LudemannEngineering/Formula-1000-Race-Car/Drawings/Jigs/ChassisJig.JPG

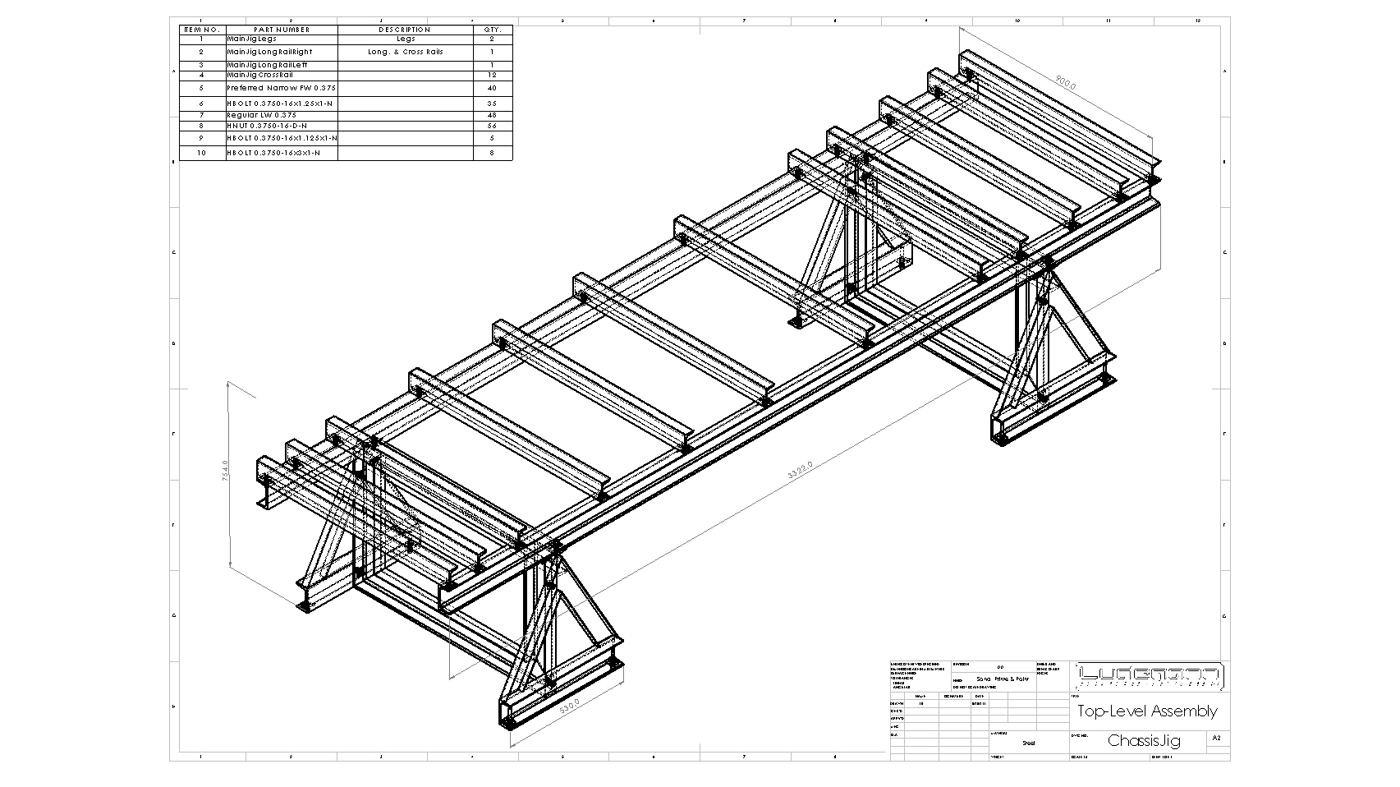
Drawings/Jigs/ChassisJig.JPG
