LudemannEngineering/Formula-1000-Race-Car/Drawings/Jigs/ChassisJigA.jpg

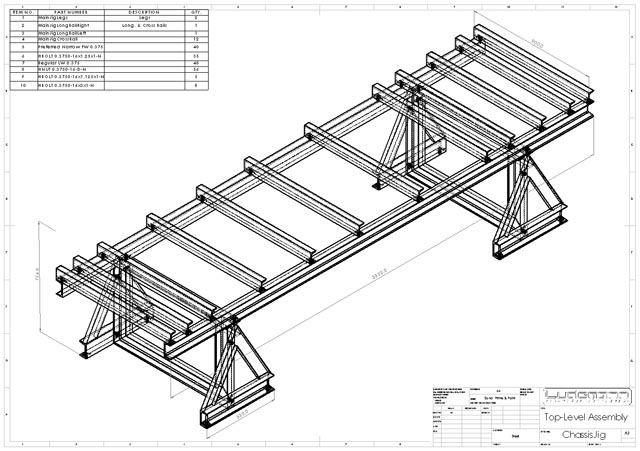
Drawings/Jigs/ChassisJigA.jpg
