LudemannEngineering/Formula-1000-Race-Car/Drawings/overall-dimensions-1.jpg

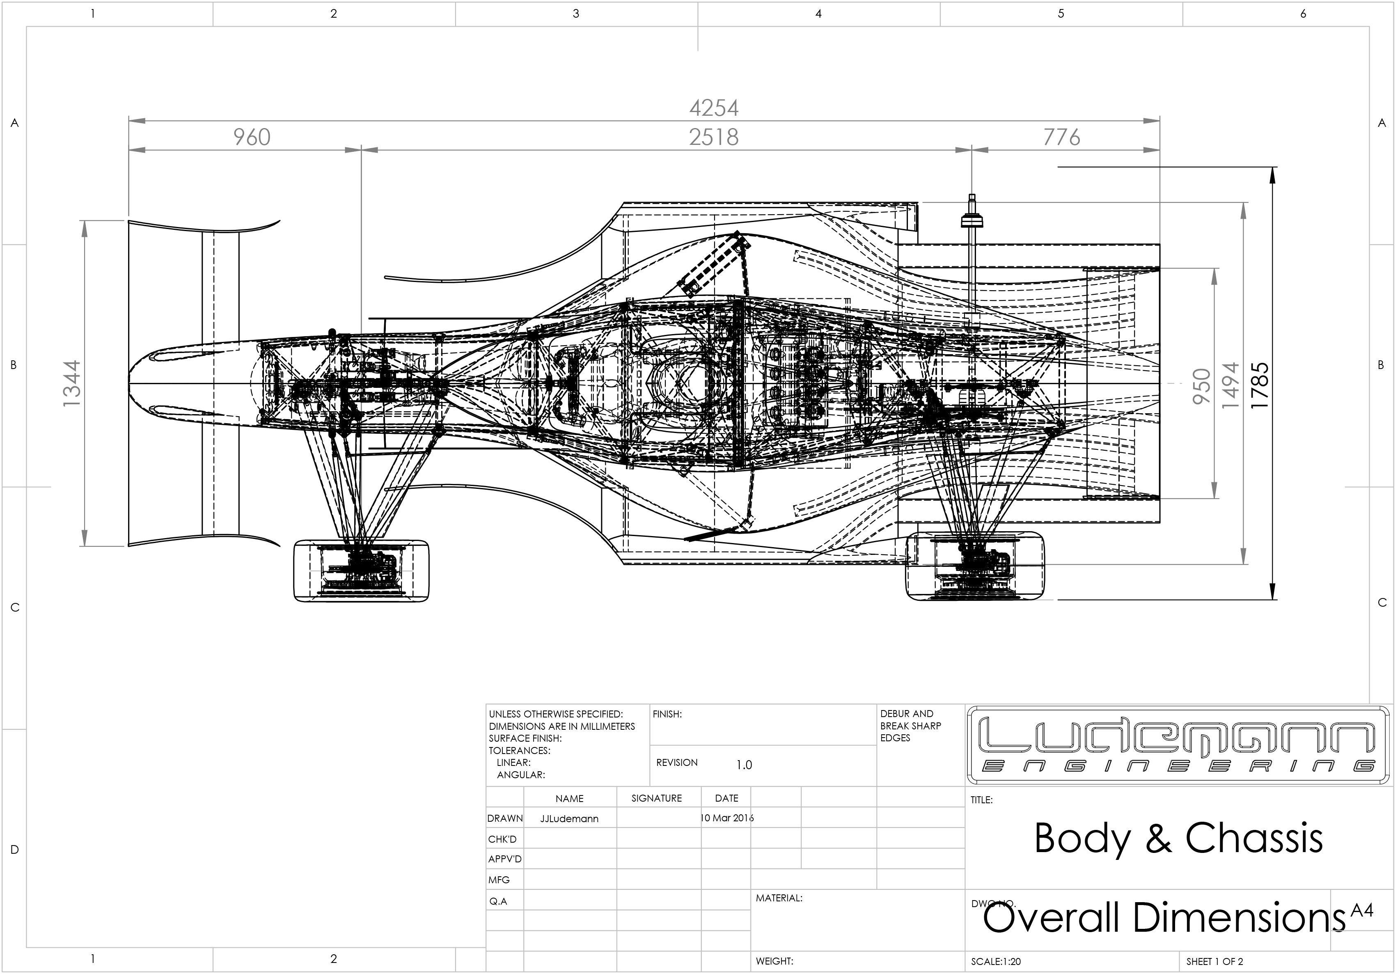
Drawings/overall-dimensions-1.jpg
