LudemannEngineering/Formula-1000-Race-Car/Drawings/Jigs/ChassisJig.xlsx

 |  | Qty | Length | Total
100 x 50 x 6
 | Legs
 |  | 4 | 0.53 | 2.12
 |  | 4 | 0.9 | 3.6
 |  | 4 | 0.56 | 2.24
 | Long Rails
 |  | 2 | 3.322 | 6.644
Total |  |  |  | 14.604
75 x 25 x 6
 | Legs
 |  | 8 | 0.53 | 4.24
 | Cross Rails
 |  | 12 | 0.9 | 10.8
 |  |  |  | 15.04
