LudemannEngineering/Formula-1000-Race-Car/Solidworks/Trailer/TubesRequired.xlsx

 |  | Qty. | Length | Subtotal |  | Units
50 x 100 x 3
Main Longitudinal |  | 4 | 454 | 1816
Main Cross |  | 4 | 195 | 780
Yoke |  | 2 | 211 | 422
Axle Supports |  | 4 | 18 | 72
Misc |  | 1 | 36 | 36
TOTAL |  |  |  |  | 3126 | 6
36 x 36 x 1.6
Front Storage | Vert | 4 | 130 | 520
 | Horiz Z | 4 | 194 | 776
 | Horiz X | 4 | 57 | 228
Under Storage | Vert | 12 | 18 | 216
 | Horiz Z | 2 | 115 | 230
 | Horiz X | 4 | 450 | 1800
Tread Support |  | 8 | 30 | 240
TOTAL |  |  |  |  | 4010 | 7
50 x 2.5 Round |  | 1 | 120 |  | 120 | 1
75 x 50 x 3
Ramps | X | 4 | 430 | 1720
 | Z | 4 | 18 | 72
 |  |  |  |  | 1792 | 4
Diamondplate | Qty. | Length | Width | Area, cm2 | Area, 4x8
Trailer Treads | 2 | 454 | 40 | 36320 | 1.221703832
Ramp Treads | 2 | 430 | 28 | 24080 | 0.8099842589
 |  |  |  |  |  | 2.031688091
19 x 1.2 Round |  |  |  |  |  | 2
