LudemannEngineering/Formula-1000-Race-Car/Solidworks/Driver/right_hand.SLDASM

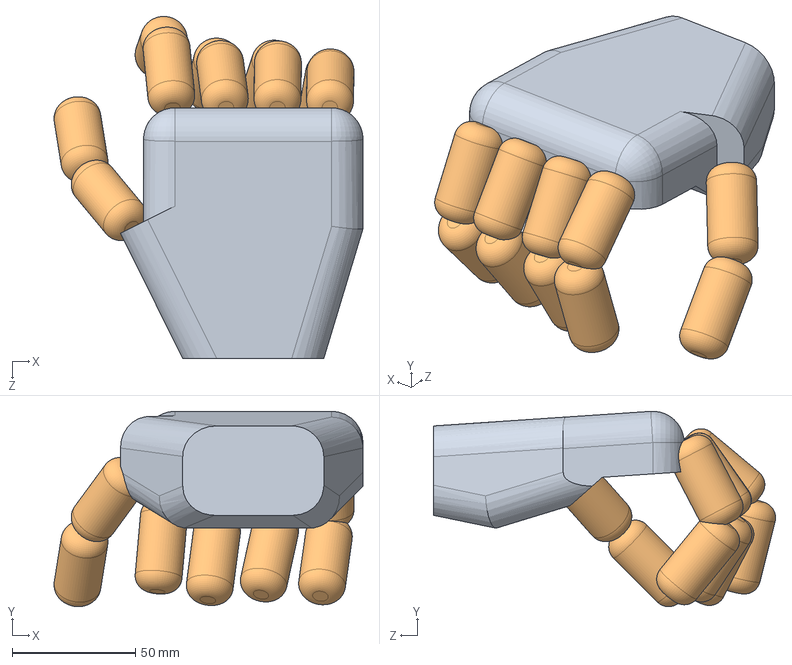
[picture p4: CAD file, 2019-01-26]
Solidworks/Driver/right_hand.SLDASM
125.2 x 79.1 x 138.6 mm
right_palm
finger x 10
