LudemannEngineering/Formula-1000-Race-Car/Solidworks/Jigs/MainFrameJig/MainJigLongRailRight.SLDPRT

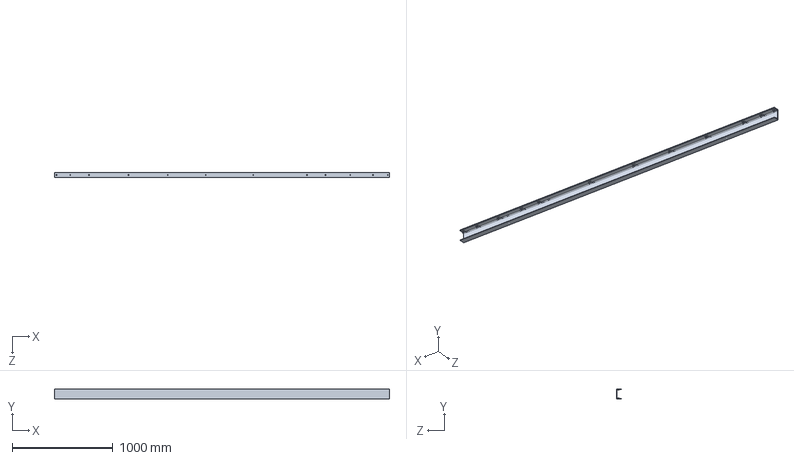
[picture p5: CAD file, 2019-01-21]
Solidworks/Jigs/MainFrameJig/MainJigLongRailRight.SLDPRT
3322.0 x 100.0 x 50.0 mm
