LudemannEngineering/Formula-1000-Race-Car/STEP/Chassis/Radiator/Radiator1SplitAssembly.STEP

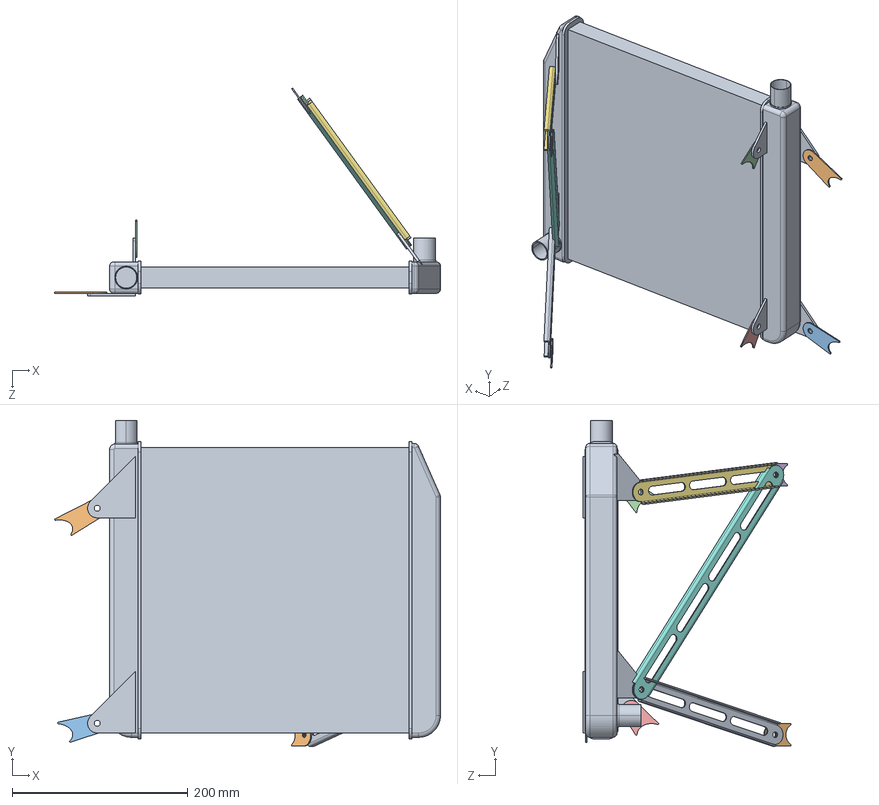
[picture p6: CAD file, 2019-01-26]
STEP/Chassis/Radiator/Radiator1SplitAssembly.STEP
439.7 x 371.5 x 236.9 mm
01-520-0001.A
