LudemannEngineering/Formula-1000-Race-Car/Solidworks/Chassis/SkinMainRollBulkhead.SLDPRT

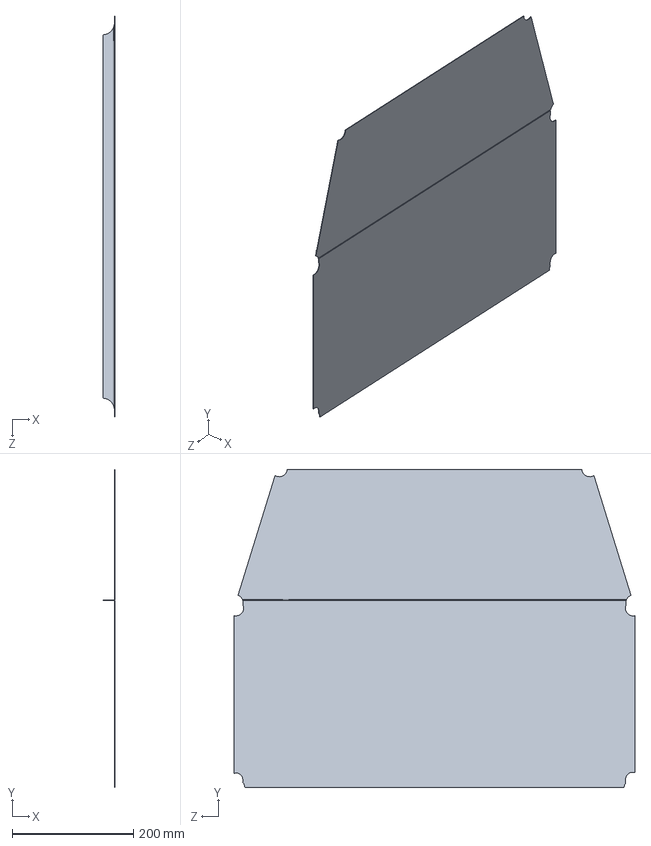
[picture p7: CAD file, 2019-01-26]
Solidworks/Chassis/SkinMainRollBulkhead.SLDPRT
19.5 x 525.0 x 661.7 mm
