LudemannEngineering/Formula-1000-Race-Car/Solidworks/Cockpit/BracketSeatBeltASM.SLDPRT

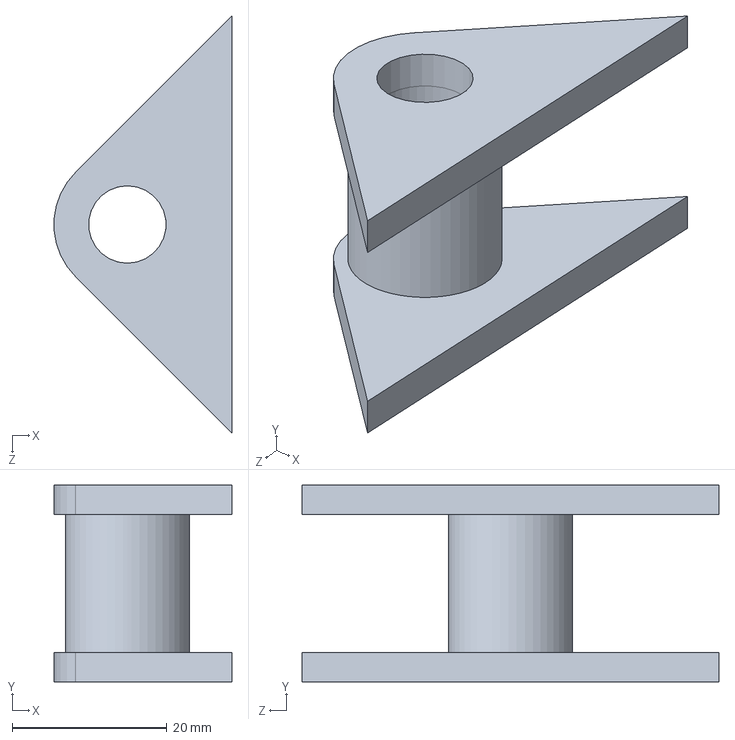
[picture p8: CAD file, 2019-01-26]
Solidworks/Cockpit/BracketSeatBeltASM.SLDPRT
23.0 x 25.4 x 53.9 mm
