LudemannEngineering/Formula-1000-Race-Car/STEP/Steering/SteeringRackAssy.STEP

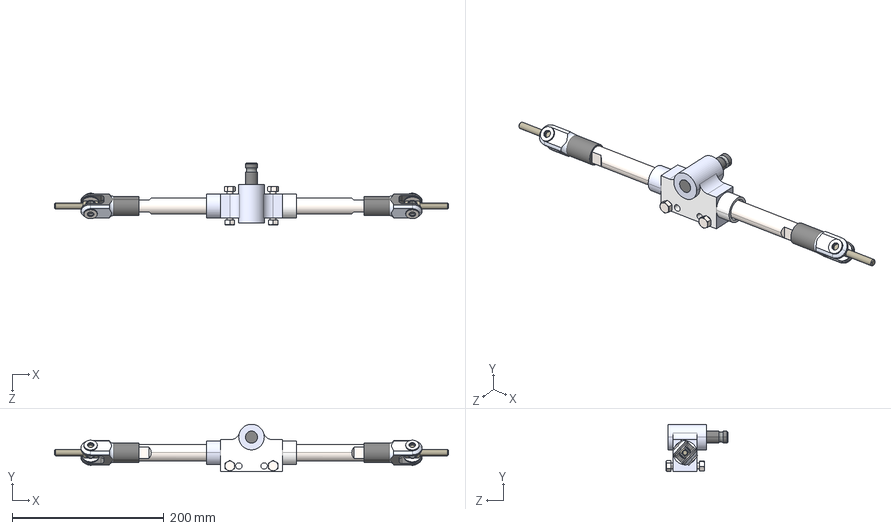
[picture p9: CAD file, 2019-01-26]
STEP/Steering/SteeringRackAssy.STEP
519.3 x 62.5 x 81.1 mm
SteeringRackCasting
SteeringRackGear
SteeringPinionGear
SteeringRackExt x 2
RodEndBall312 x 2
RodEndRace312Male x 2
Hex Bolt_AI_HBOLT 0.3125-24x1.75x0.875-N x 2
Socket Head Cap Screw_AI_HX-SHCS 0.375-24x1x1-N x 2
Flat Washer Type B Regular_AI_Regular FW 0.3125 x 4
Hex Nut_AI_HNUT 0.3125-24-D-N x 2
Flat Washer Type A Narrow_AI_Preferred Narrow FW 0.3125 x 4
