LudemannEngineering/Formula-1000-Race-Car/STEP/Suspension/RearSuspension/SuspClevUpperRearAssy.STEP

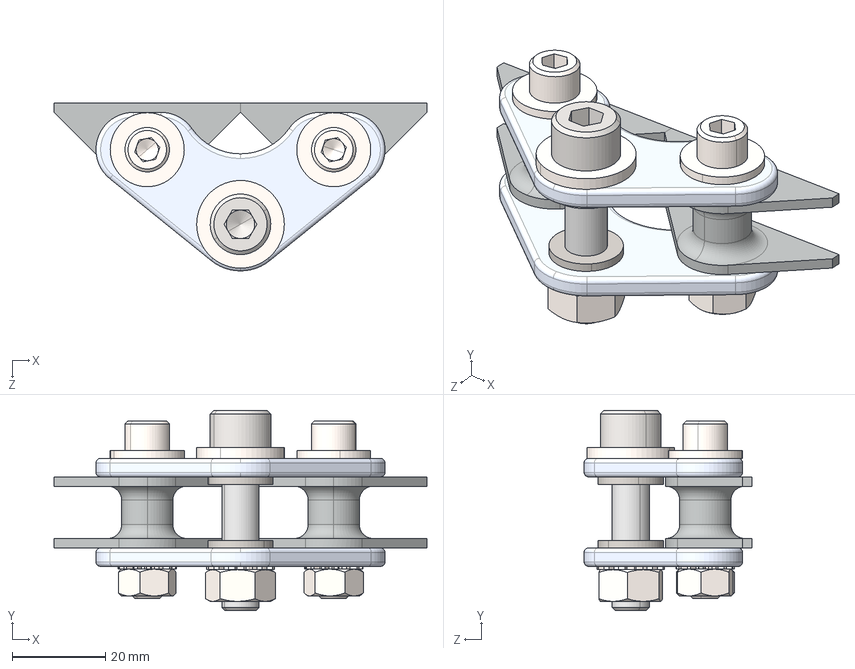
[picture p10: CAD file, 2019-01-26]
STEP/Suspension/RearSuspension/SuspClevUpperRearAssy.STEP
80.0 x 43.0 x 36.0 mm
BracketSuspClevRU x 2
SuspClevUpper x 2
Washer8mmx2mm x 2
Socket Head Cap Screw_AM_B18.3.1M - 8 x 1.25 x 35 Hex SHCS -- 35CHX
flat washer narrow_am_B18.22M - Plain washer, 8 mm, narrow
external tooth lock washer_am_B18.21.2M-External Tooth Lock Washers_AM8
hex nut style 1_am_B18.2.4.1M - Hex nut, Style 1, M8 x 1.25 --D-N
Flat Washer Type A Narrow_AI_Preferred Narrow FW 0.25 x 2
Socket Head Cap Screw_AI_HX-SHCS 0.25-28x1.25x1.25-N x 2
External Tooth Lock Washer_AI_ASME B18.21.1 - 0.256 x 2
Hex Nut_AI_HNUT 0.2500-28-D-N x 2
