LudemannEngineering/Formula-1000-Race-Car/Solidworks/Jigs/MainFrameJig/MainJigCrossRailH.SLDPRT

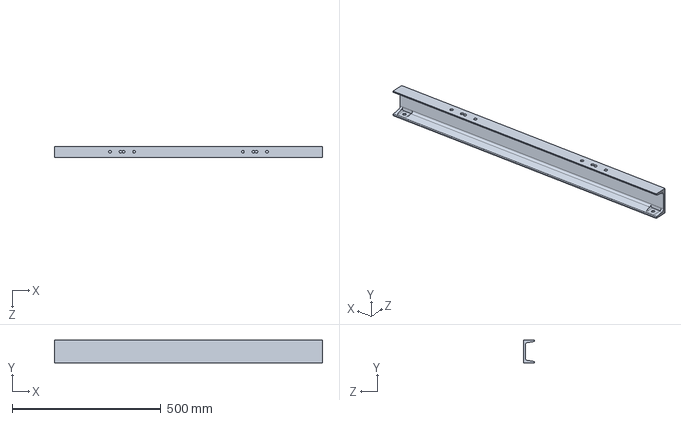
[picture p11: CAD file, 2019-01-21]
Solidworks/Jigs/MainFrameJig/MainJigCrossRailH.SLDPRT
900.0 x 76.2 x 38.0 mm
