LudemannEngineering/Formula-1000-Race-Car/Solidworks/Suspension/FrontSuspension/SuspRockerFront2.SLDASM

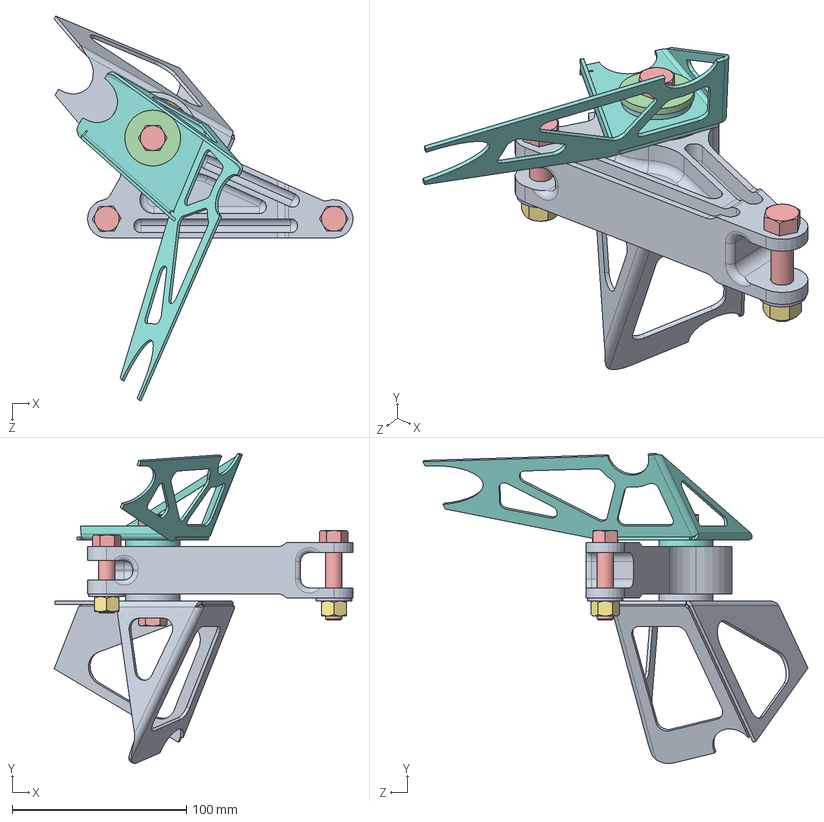
[picture p12: CAD file, 2019-01-21]
Solidworks/Suspension/FrontSuspension/SuspRockerFront2.SLDASM
171.5 x 178.0 x 220.9 mm
SuspensionRockerFront
BearingBall6005 x 2
RockerArmShaft
RockerArmShaftWasher x 2
Hex Bolt_AI x 4
Flat Washer Type A Narrow_AI x 2
Hex Nut_AI x 2
SuspensionRockerMountLeftFrontUpper
SuspensionRockerMountLeftFrontLower
