LudemannEngineering/Formula-1000-Race-Car/Solidworks/Tools/Sawhorse.SLDASM

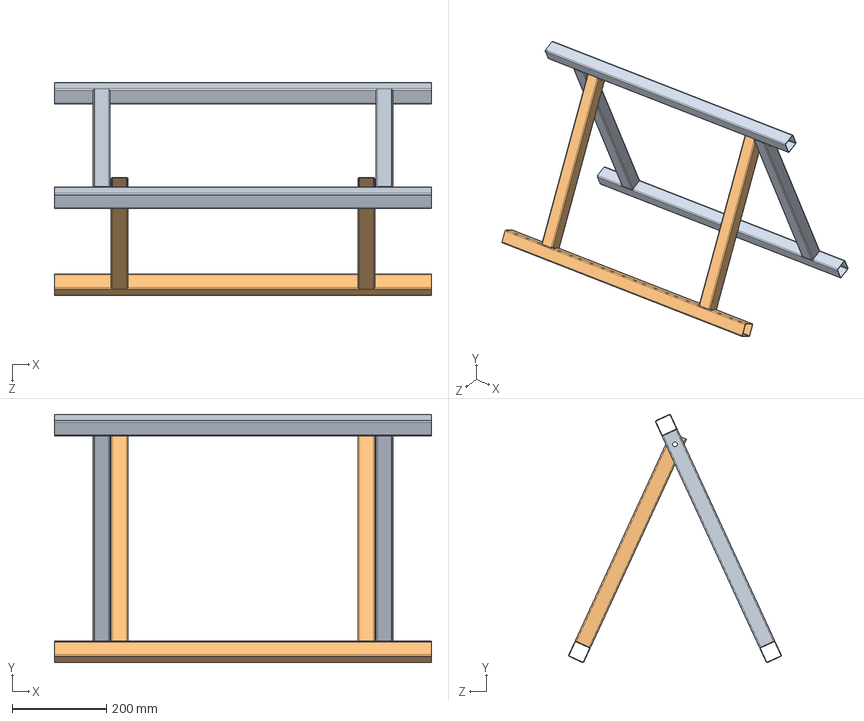
[picture p13: CAD file, 2019-01-21]
Solidworks/Tools/Sawhorse.SLDASM
800.0 x 526.6 x 451.3 mm
SawhorseOuter
SawhorseInner
