LudemannEngineering/Formula-1000-Race-Car/Solidworks/Trailer/Trailer.SLDASM

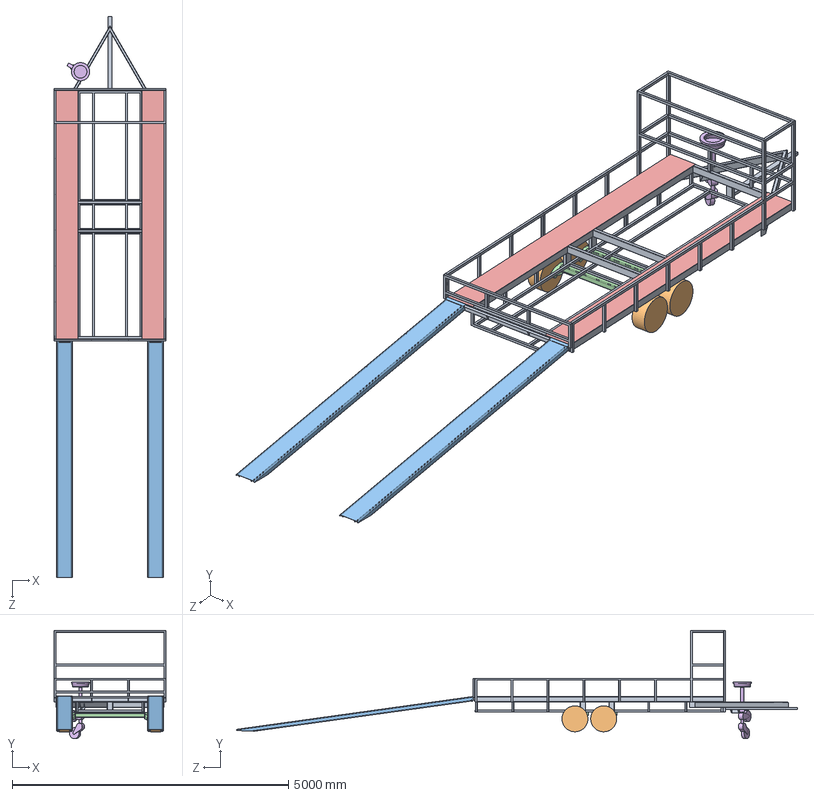
[picture p14: CAD file, 2019-01-21]
Solidworks/Trailer/Trailer.SLDASM
2023.8 x 1962.1 x 10158.2 mm
Frame
Tire x 4
Ramp x 2
Axle x 2
Treadplate x 2
FrontWheel
