LudemannEngineering/Formula-1000-Race-Car/STEP/Suspension/SuspClevUpperAssy.STEP

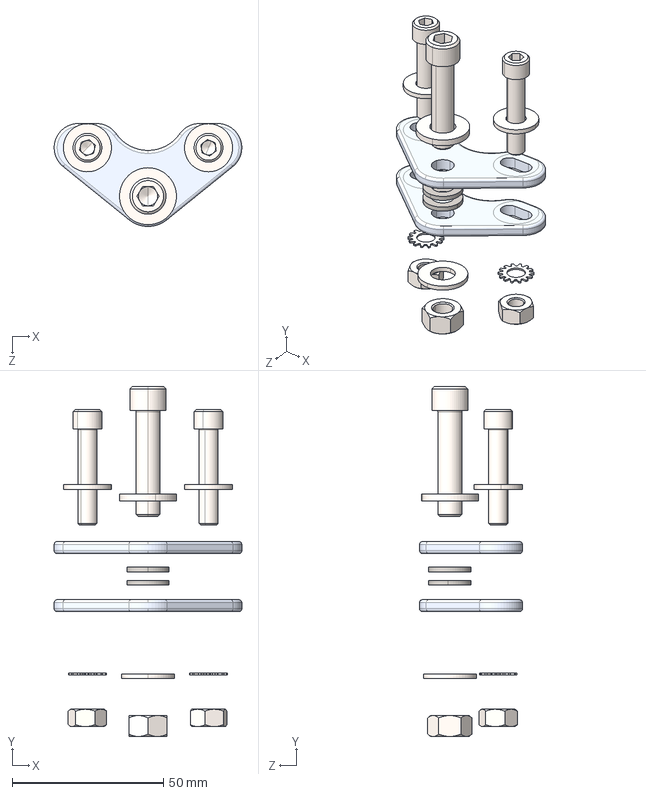
[picture p15: CAD file, 2019-01-26]
STEP/Suspension/SuspClevUpperAssy.STEP
62.0 x 115.6 x 34.0 mm
SuspClevUpper x 2
Washer8mmx2mm x 2
flat washer narrow_am_B18.22M - Plain washer, 8 mm, narrow
Socket Head Cap Screw_AI_HX-SHCS 0.25-28x1.25x1.25-N x 2
Flat Washer Type A Narrow_AI_Preferred Narrow FW 0.25 x 2
Hex Nut_AI_HNUT 0.2500-28-D-N x 2
External Tooth Lock Washer_AI_ASME B18.21.1 - 0.256 x 2
Socket Head Cap Screw_AI_HX-SHCS 0.3125-24x1.375x1.375-N
Flat Washer Type A Narrow_AI_Preferred Narrow FW 0.3125
Hex Nut_AI_HNUT 0.3125-24-D-N
