LudemannEngineering/Formula-1000-Race-Car/STEP/Suspension/SuspClevLowerAssy.STEP

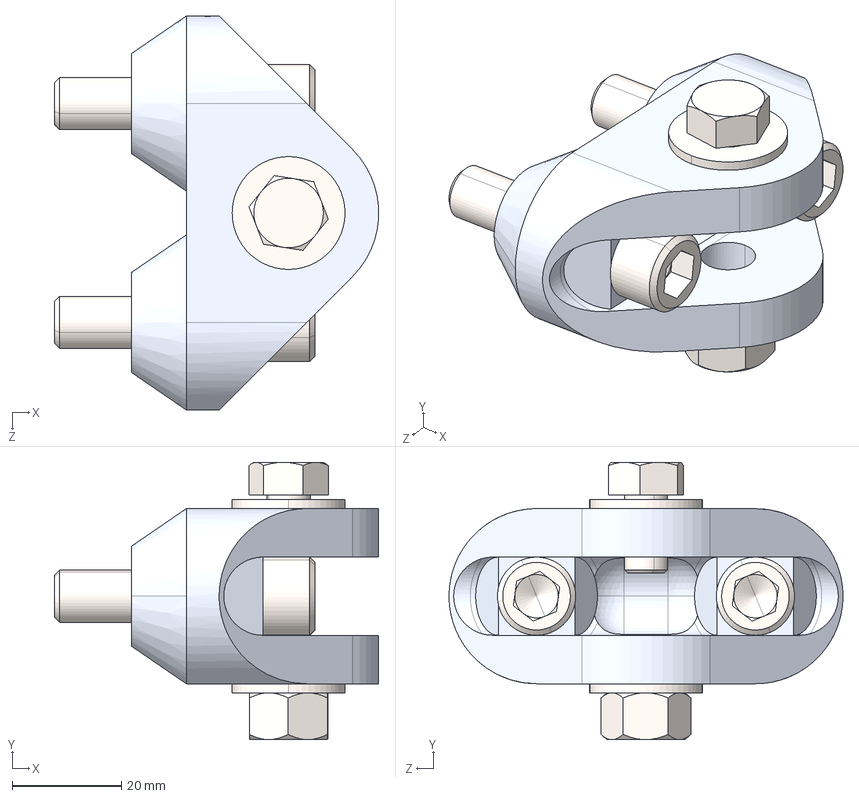
[picture p16: CAD file, 2019-01-26]
STEP/Suspension/SuspClevLowerAssy.STEP
59.2 x 50.7 x 72.0 mm
SuspClevLower
SuspClevLowerWasher x 2
SuspClevLowerSpacer x 2
hex bolt_ai_PreviewCfg
Hex Nut_AI_HNUT 0.3750-16-D-N
socket head cap screw_ai_HX-SHCS 0.375-16x1.5x1.5-N x 2
flat washer type a narrow_ai_Preferred Narrow FW 0.375 x 2
