LudemannEngineering/Formula-1000-Race-Car/Solidworks/Steering/U-JointDoubleMid.SLDASM

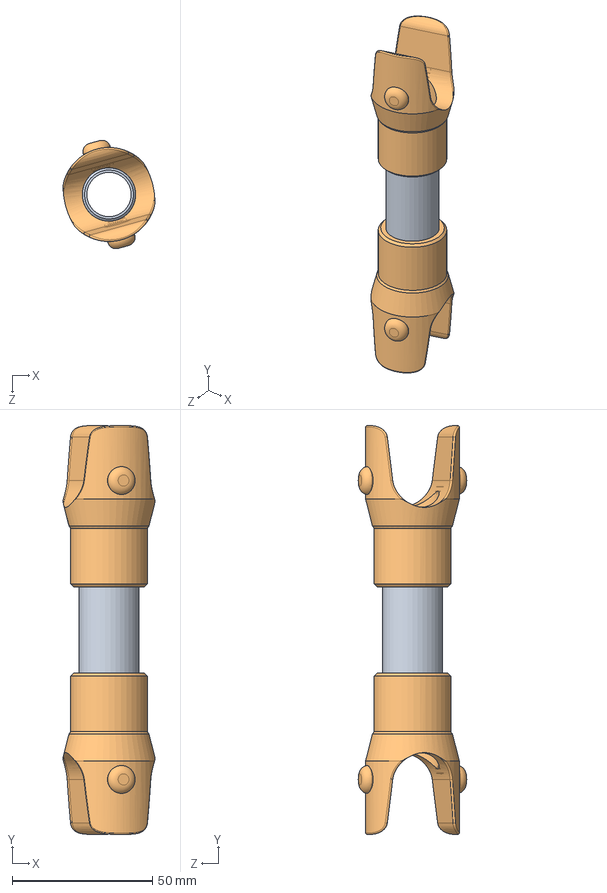
[picture p17: CAD file, 2019-01-26]
Solidworks/Steering/U-JointDoubleMid.SLDASM
32.7 x 146.0 x 38.7 mm
TubeSteering.75
U-JointWoodward x 2
