LudemannEngineering/Formula-1000-Race-Car/Solidworks/Cockpit/Shifter/ShifterAssembly.SLDASM

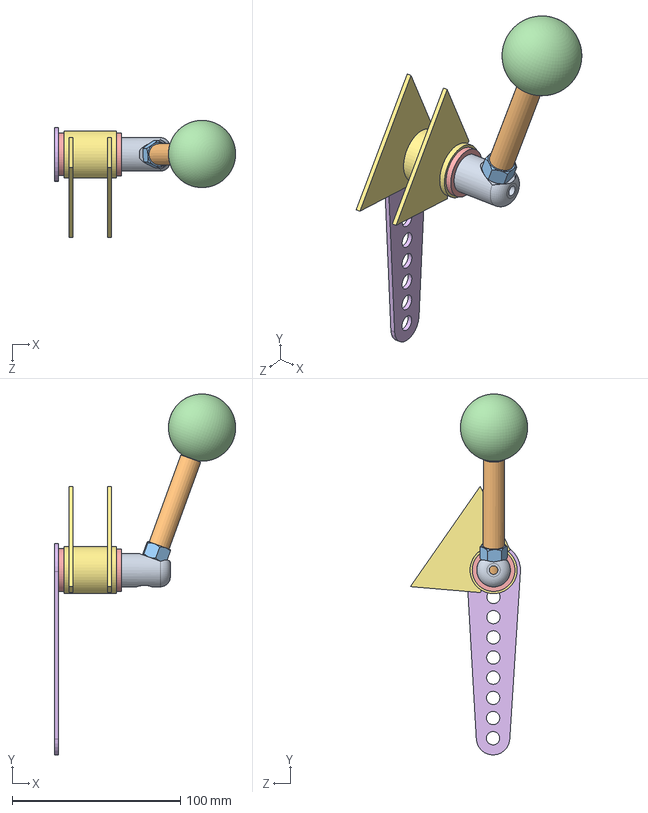
[picture p18: CAD file, 2019-01-21]
Solidworks/Cockpit/Shifter/ShifterAssembly.SLDASM
107.8 x 214.7 x 69.8 mm
ShifterShaft
ShifterLever
Hex Nut_AI
ShifterBall
ShifterBush x 2
ShifterOuterLever
ShifterBracket
