LudemannEngineering/Formula-1000-Race-Car/Solidworks/Jigs/MainFrameJig/MainJigLegs.SLDPRT

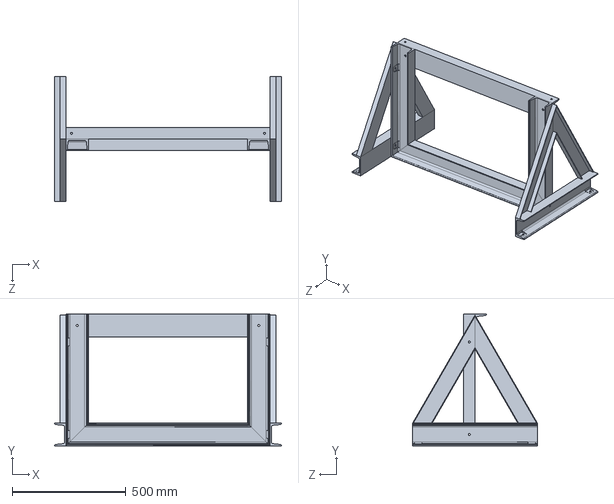
[picture p19: CAD file, 2019-01-21]
Solidworks/Jigs/MainFrameJig/MainJigLegs.SLDPRT
1000.0 x 580.0 x 550.0 mm
