LudemannEngineering/Formula-1000-Race-Car/Solidworks/Drivetrain/AxleRear.SLDASM

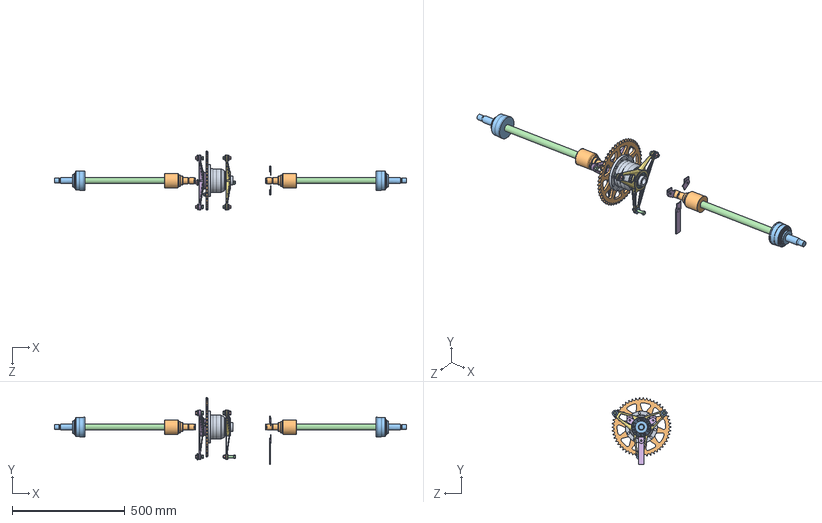
[picture p20: CAD file, 2019-01-26]
Solidworks/Drivetrain/AxleRear.SLDASM
1562.3 x 297.5 x 263.7 mm
DifferentialHonda
CVjointCivicInner x 2
CVjointCivicOuter x 2
AxleLeftRear x 2
Basic Internal Retaining Ring_am x 2
DifferentialSupportLeft5
DifferentialSupportRight3
Radial Ball Bearing_68_SKF x 2
Hex Flange Machine Screw_AM
Sprocket50Real
Flat Washer Type B Regular_AI x 24
Hex Bolt_AI x 6
Hex Nut_AI x 6
AxleExtensionMountR
