LudemannEngineering/Formula-1000-Race-Car/Solidworks/Jigs/MainFrameJig/MainJigCrossRailC.SLDPRT

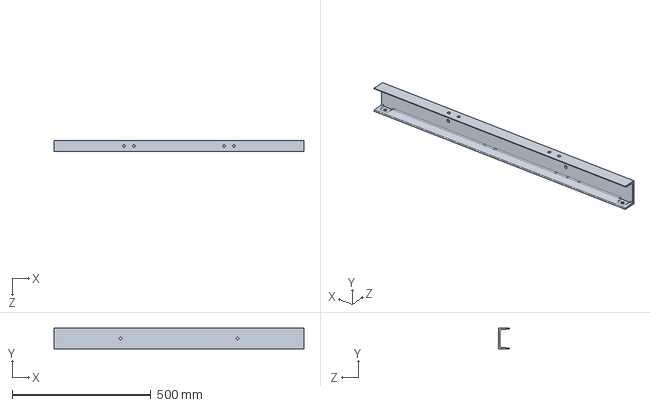
[picture p21: CAD file, 2019-01-21]
Solidworks/Jigs/MainFrameJig/MainJigCrossRailC.SLDPRT
900.0 x 75.0 x 40.0 mm
