LudemannEngineering/Formula-1000-Race-Car/Solidworks/Jigs/MainFrameJig/MainJig.SLDASM

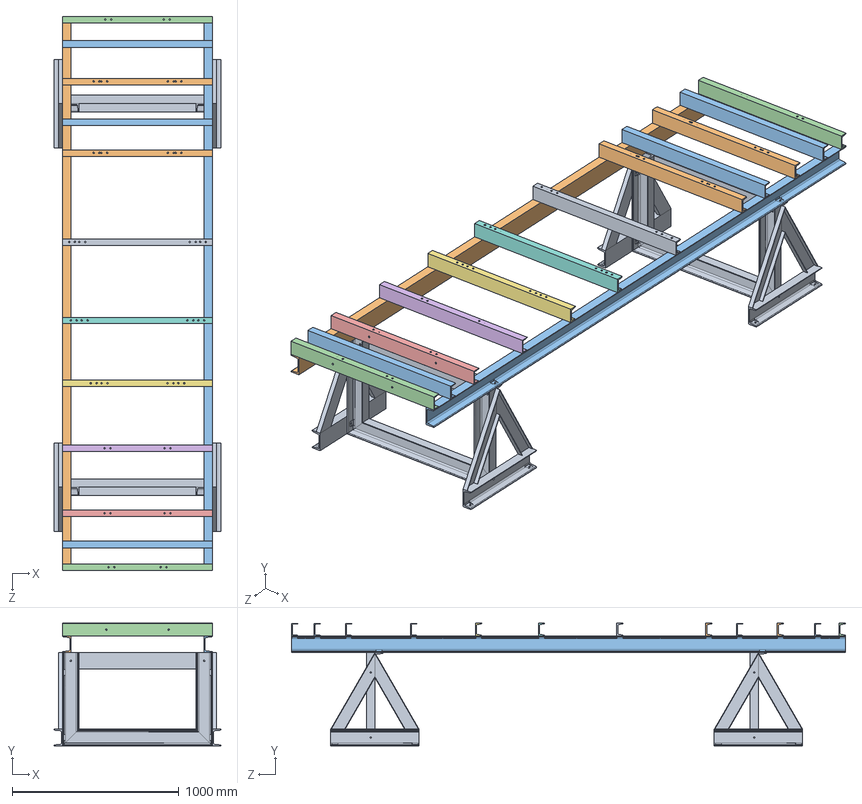
[picture p22: CAD file, 2019-01-21]
Solidworks/Jigs/MainFrameJig/MainJig.SLDASM
1000.0 x 736.2 x 3322.0 mm
MainJigLegs x 2
MainJigLongRailRight
MainJigLongRailLeft
MainJigCrossRailA
MainJigCrossRailC
MainJigCrossRailD
MainJigCrossRailE
MainJigCrossRailF
MainJigCrossRailG
MainJigCrossRailH x 2
MainJigCrossRail x 3
MainJigCrossRailL
