LudemannEngineering/Formula-1000-Race-Car/Solidworks/Cockpit/PedalCluster/BrakeBalanceBar.SLDASM

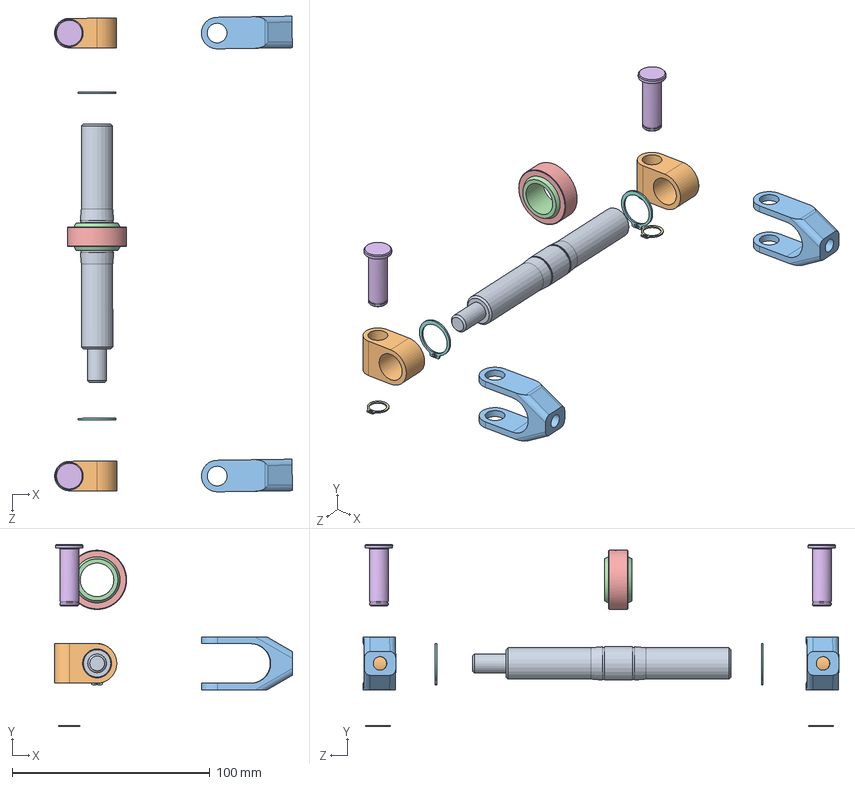
[picture p23: CAD file, 2019-01-26]
Solidworks/Cockpit/PedalCluster/BrakeBalanceBar.SLDASM
120.5 x 92.4 x 240.9 mm
BiasAdjusterShaft
BiasAdjusterClevisBlock x 2
BiasAdjusterClevis x 2
SphericalBearingBallGE17C
SphericalBeaingRaceGE17C
BiasAdjusterPin x 2
Basic External Retaining Ring_AI x 2
Basic External Retaining Ring_am x 2
