LudemannEngineering/Formula-1000-Race-Car/Solidworks/Driver/left_hand.SLDASM

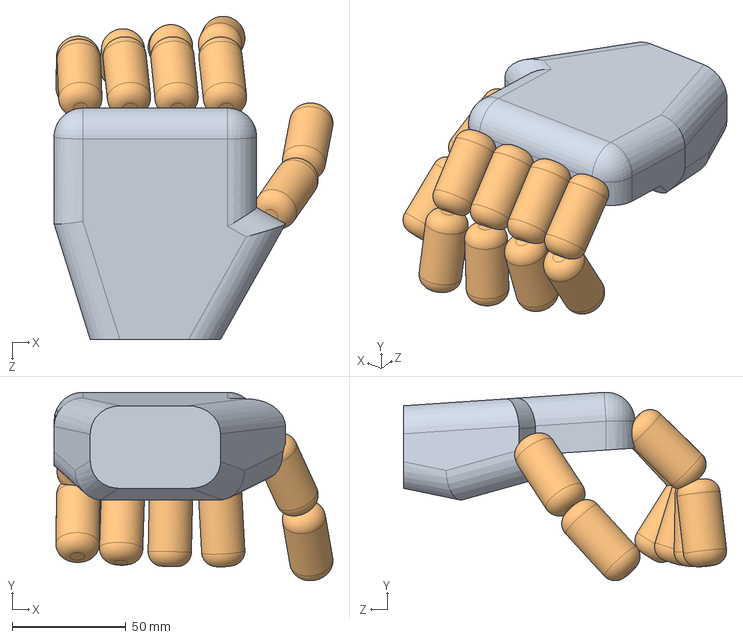
[picture p24: CAD file, 2019-01-26]
Solidworks/Driver/left_hand.SLDASM
122.4 x 82.7 x 141.8 mm
left_palm
finger x 10
