LudemannEngineering/Formula-1000-Race-Car/Solidworks/Cockpit/PedalCluster/SphericalBearingGE17C.SLDASM

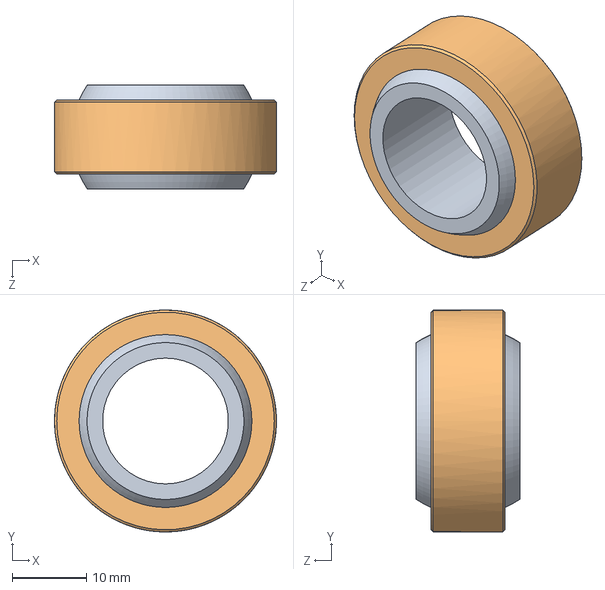
[picture p25: CAD file, 2019-01-26]
Solidworks/Cockpit/PedalCluster/SphericalBearingGE17C.SLDASM
30.0 x 30.0 x 14.0 mm
SphericalBearingBallGE17C
SphericalBeaingRaceGE17C
