LudemannEngineering/Formula-1000-Race-Car/Solidworks/Drivetrain/HalfshaftCivicLeft.sldasm

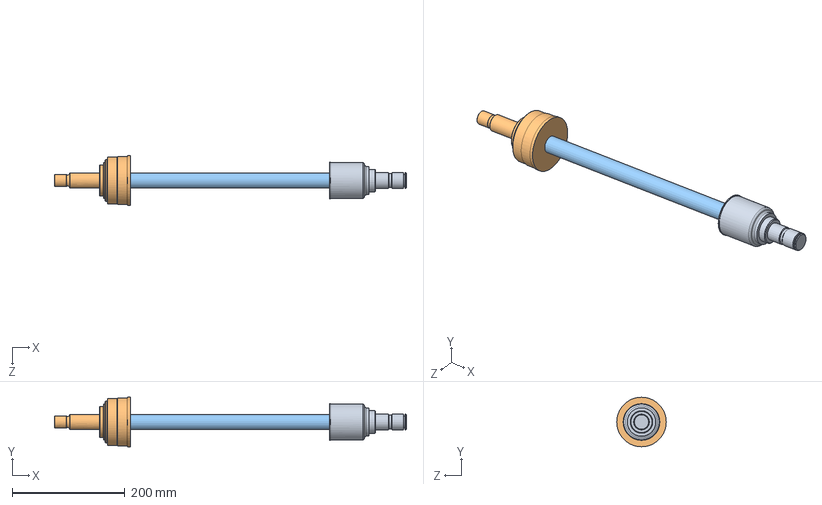
[picture p26: CAD file, 2019-01-26]
Solidworks/Drivetrain/HalfshaftCivicLeft.sldasm
624.8 x 88.0 x 88.0 mm
CVjointCivicInner
CVjointCivicOuter
AxleLeftRear
