LudemannEngineering/Formula-1000-Race-Car/Solidworks/Steering/WheelHubDisconnect.SLDASM

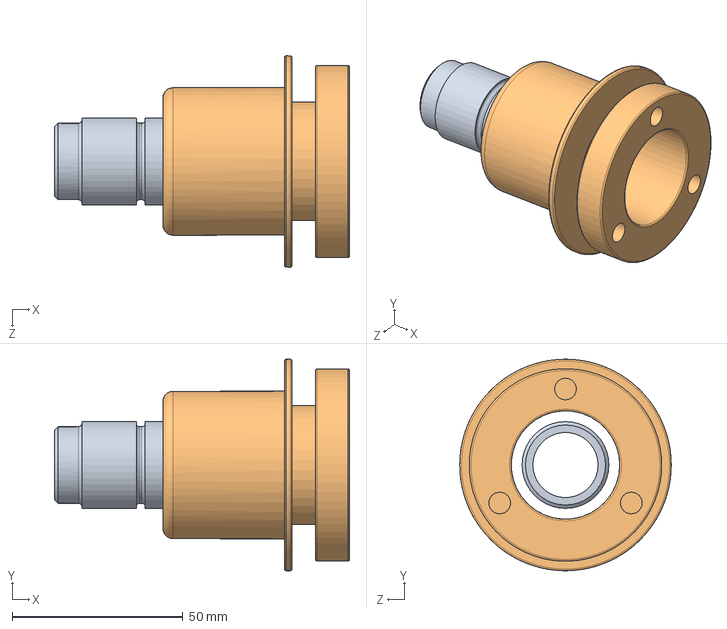
[picture p27: CAD file, 2019-01-26]
Solidworks/Steering/WheelHubDisconnect.SLDASM
86.3 x 61.9 x 61.9 mm
SteeringWheelDisconnectSpline
SteeringWheelDisconnect
