LudemannEngineering/Formula-1000-Race-Car/Solidworks/Chassis/SkinFloorMain.SLDPRT

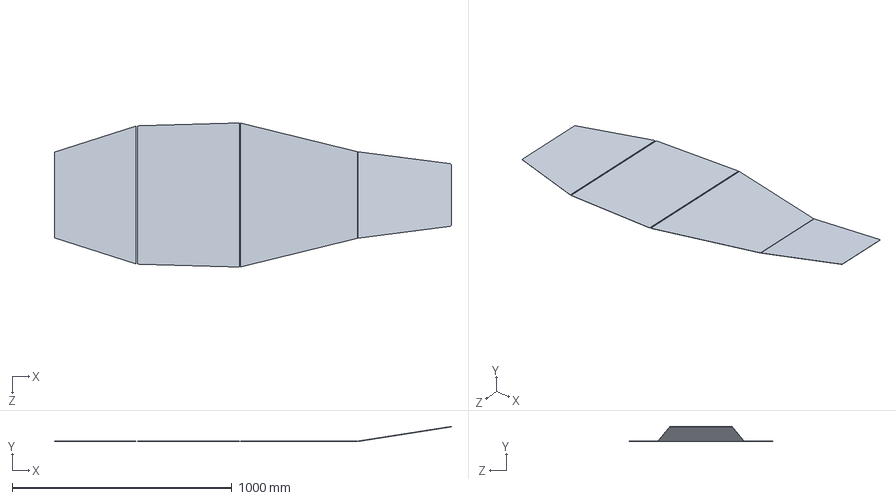
[picture p28: CAD file, 2019-01-26]
Solidworks/Chassis/SkinFloorMain.SLDPRT
1805.7 x 67.9 x 655.5 mm
