LudemannEngineering/Formula-1000-Race-Car/Solidworks/Steering/SteeringRack.SLDASM

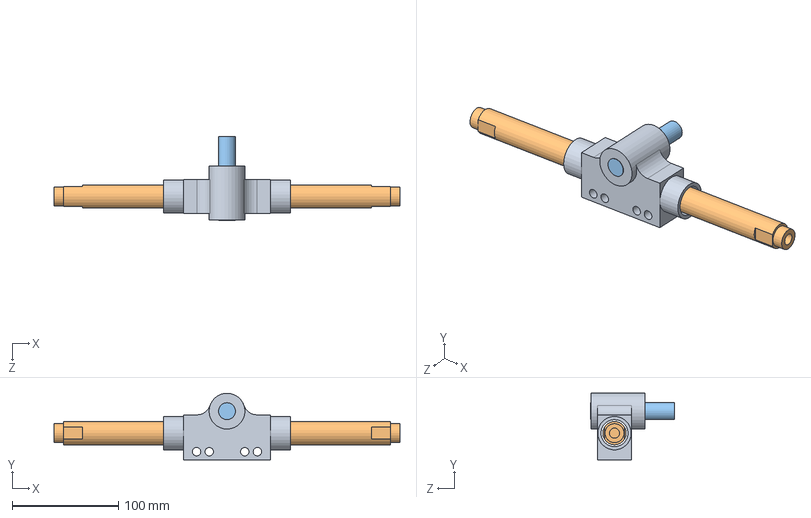
[picture p29: CAD file, 2019-01-26]
Solidworks/Steering/SteeringRack.SLDASM
325.0 x 62.5 x 78.8 mm
SteeringRackCasting
SteeringRackGear
SteeringPinionGear
