LudemannEngineering/Formula-1000-Race-Car/Solidworks/Suspension/RodEnd312Male.SLDASM

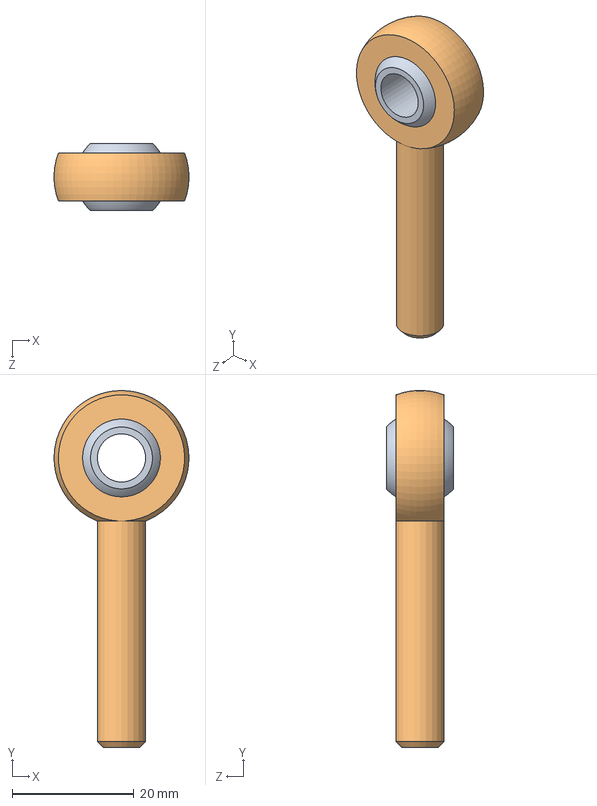
[picture p30: CAD file, 2019-01-26]
Solidworks/Suspension/RodEnd312Male.SLDASM
22.2 x 58.7 x 11.1 mm
RodEndBall312
RodEndRace312Male
