LudemannEngineering/Formula-1000-Race-Car/Solidworks/Suspension/SphericalBearing437in.SLDASM

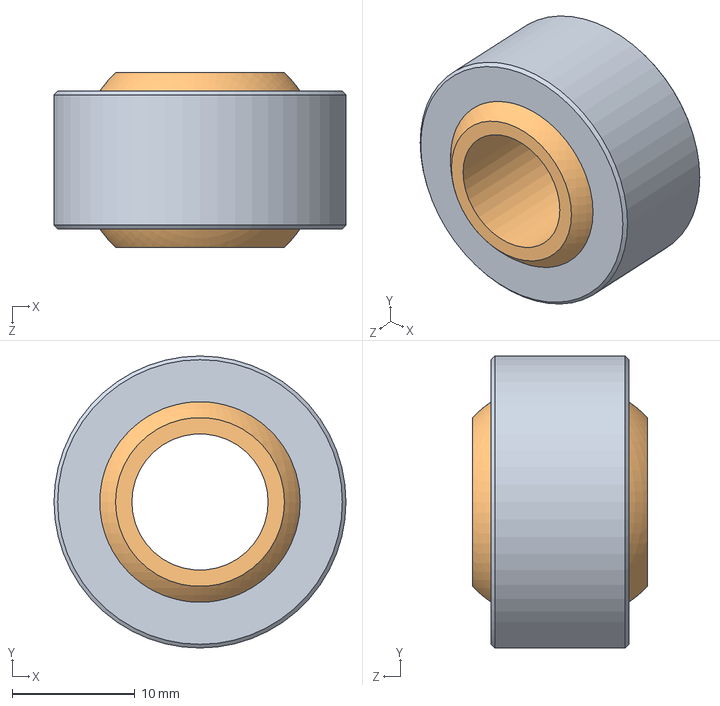
[picture p31: CAD file, 2019-01-26]
Solidworks/Suspension/SphericalBearing437in.SLDASM
23.8 x 23.8 x 14.3 mm
SphericalBearing437Race
SphericalBearing437Ball
