LudemannEngineering/Formula-1000-Race-Car/Solidworks/Chassis/SkinMountMainRollBulkhead.SLDPRT

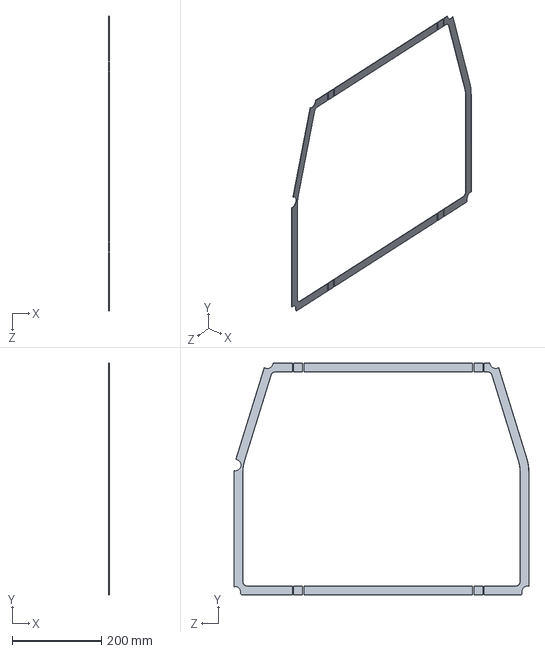
[picture p32: CAD file, 2019-01-21]
Solidworks/Chassis/SkinMountMainRollBulkhead.SLDPRT
1.00 x 520.2 x 661.7 mm
