LudemannEngineering/Formula-1000-Race-Car/Solidworks/Suspension/SphericalBearing625.SLDASM

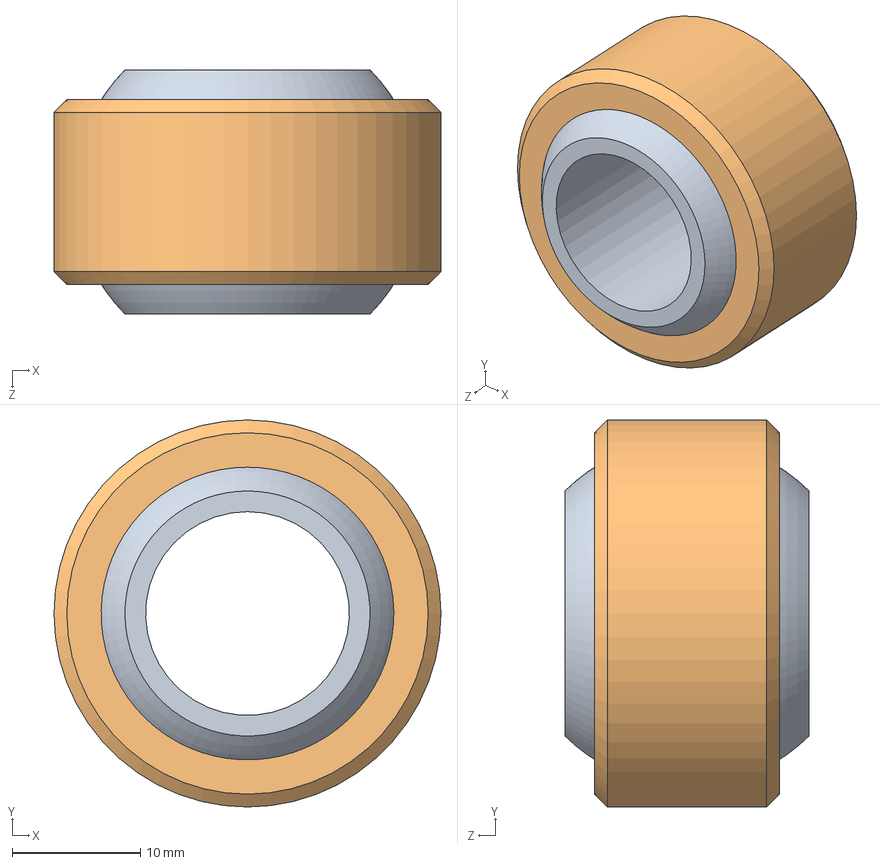
[picture p33: CAD file, 2019-01-26]
Solidworks/Suspension/SphericalBearing625.SLDASM
30.2 x 30.2 x 19.1 mm
SphericalBearingBall625
SphericalBeaingRace625
