LudemannEngineering/Formula-1000-Race-Car/Solidworks/Suspension/RodEnd8mmFem.SLDASM

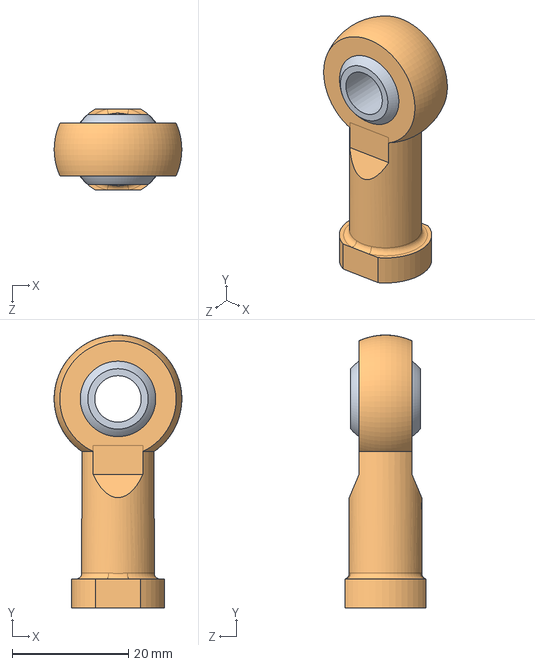
[picture p34: CAD file, 2019-01-26]
Solidworks/Suspension/RodEnd8mmFem.SLDASM
22.0 x 47.0 x 14.0 mm
RodEndBall8mm
RodEndRace8mmFem
