LudemannEngineering/Formula-1000-Race-Car/Solidworks/Suspension/RodEnd375-24L.SLDASM

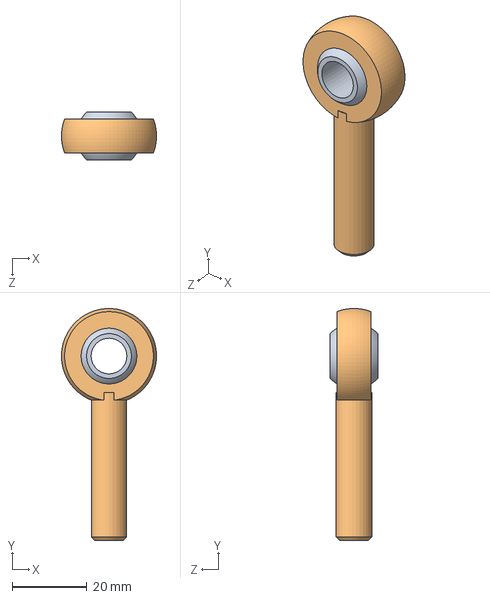
[picture p35: CAD file, 2019-01-26]
Solidworks/Suspension/RodEnd375-24L.SLDASM
25.4 x 61.9 x 12.7 mm
RodEndBall375
RodEndRace375
