LudemannEngineering/Formula-1000-Race-Car/Solidworks/Suspension/RodEnd312Fem.SLDASM

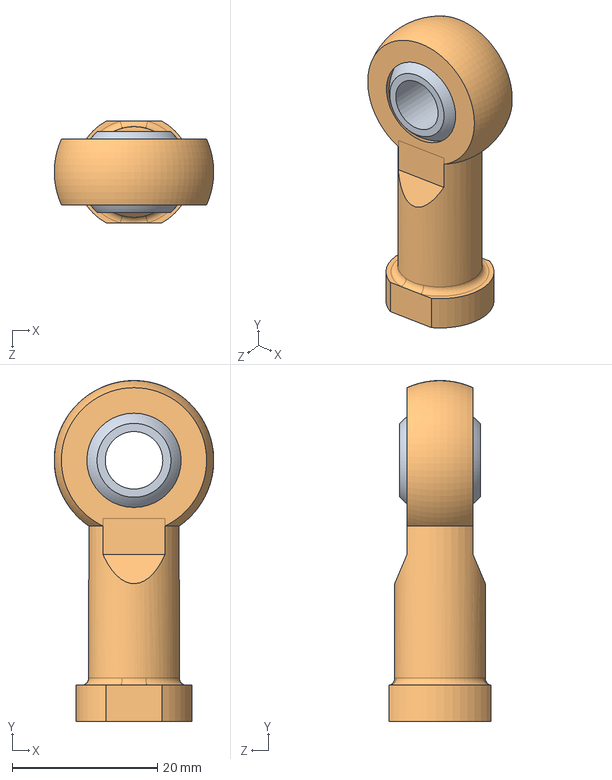
[picture p36: CAD file, 2019-01-26]
Solidworks/Suspension/RodEnd312Fem.SLDASM
22.0 x 47.0 x 14.0 mm
RodEndBall312
RodEndRace312Fem
