LudemannEngineering/Formula-1000-Race-Car/Drawings/Tubes/H-ILeftDiagUpper.SLDPRT

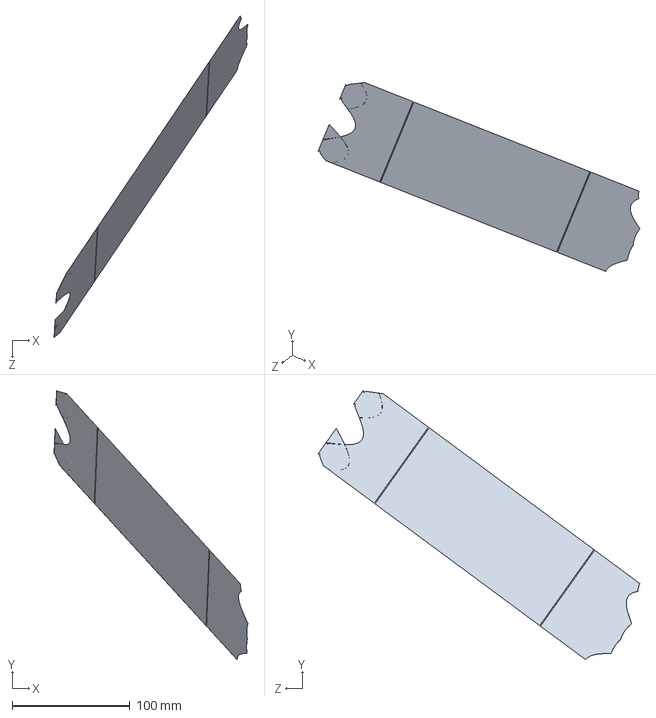
[picture p37: CAD file, 2019-01-21]
Drawings/Tubes/H-ILeftDiagUpper.SLDPRT
164.8 x 229.0 x 273.6 mm
