LudemannEngineering/Formula-1000-Race-Car/Solidworks/Brakes/CaliperWilwood120-6818.SLDPRT

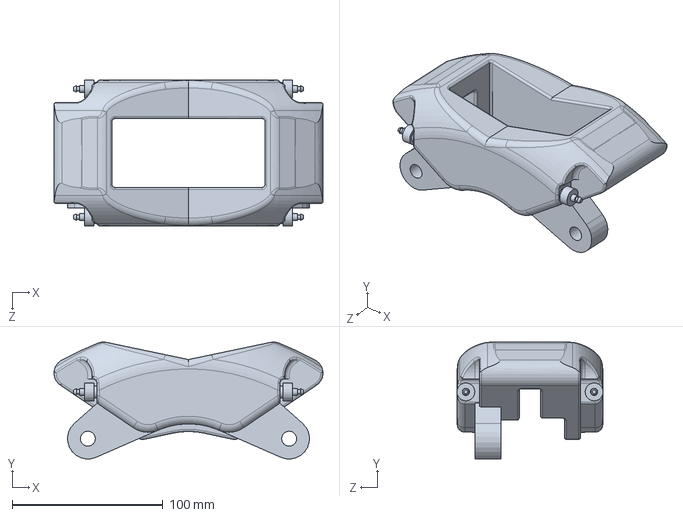
[picture p38: CAD file, 2019-01-26]
Solidworks/Brakes/CaliperWilwood120-6818.SLDPRT
178.3 x 77.4 x 96.9 mm
