LudemannEngineering/Formula-1000-Race-Car/Solidworks/Chassis/RadiatorSetrab/BracketOilCoolerLF.SLDPRT

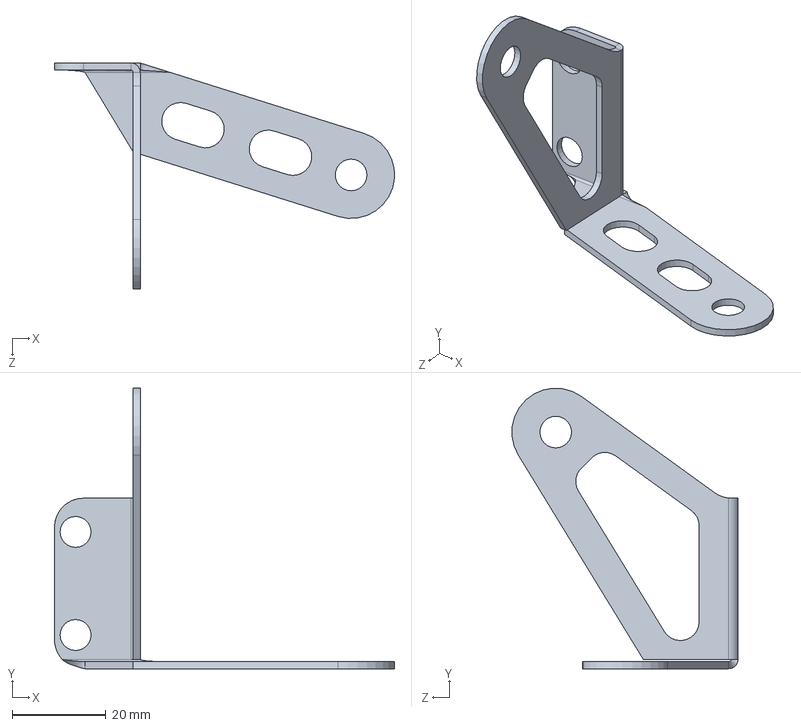
[picture p39: CAD file, 2019-01-26]
Solidworks/Chassis/RadiatorSetrab/BracketOilCoolerLF.SLDPRT
72.6 x 59.9 x 48.2 mm
