LudemannEngineering/Formula-1000-Race-Car/Solidworks/Chassis/SkinUnderNose.SLDPRT

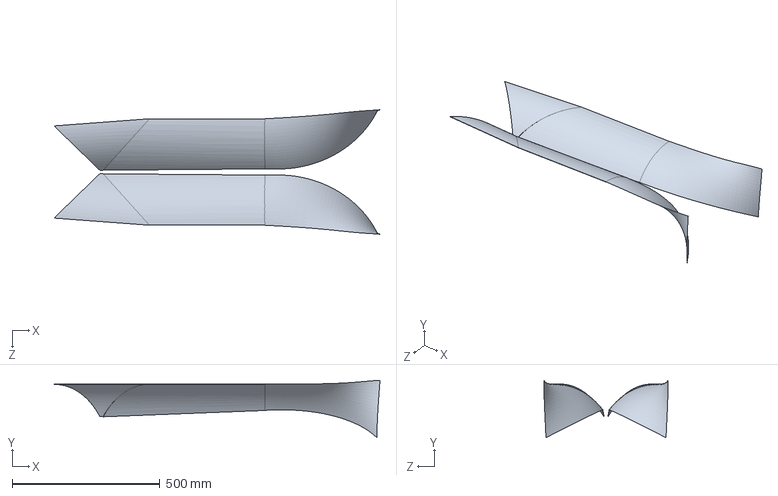
[picture p40: CAD file, 2019-01-26]
Solidworks/Chassis/SkinUnderNose.SLDPRT
1102.4 x 194.4 x 419.9 mm
