LudemannEngineering/Formula-1000-Race-Car/Solidworks/Cockpit/BracketSeatBeltShoulder2.SLDPRT

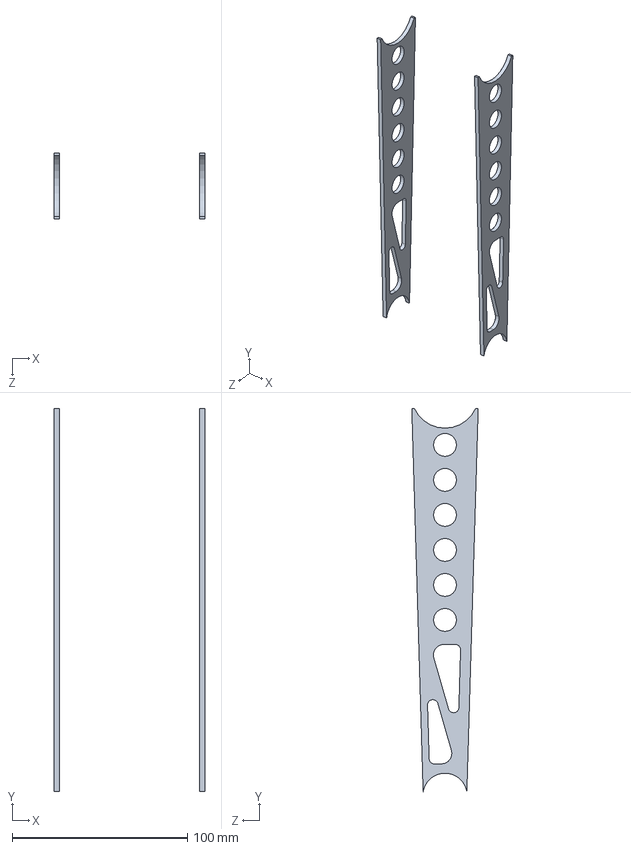
[picture p41: CAD file, 2019-01-26]
Solidworks/Cockpit/BracketSeatBeltShoulder2.SLDPRT
86.0 x 218.8 x 37.9 mm
