LudemannEngineering/Formula-1000-Race-Car/Solidworks/Cockpit/PedalCluster/BiasAdjusterPin.SLDPRT

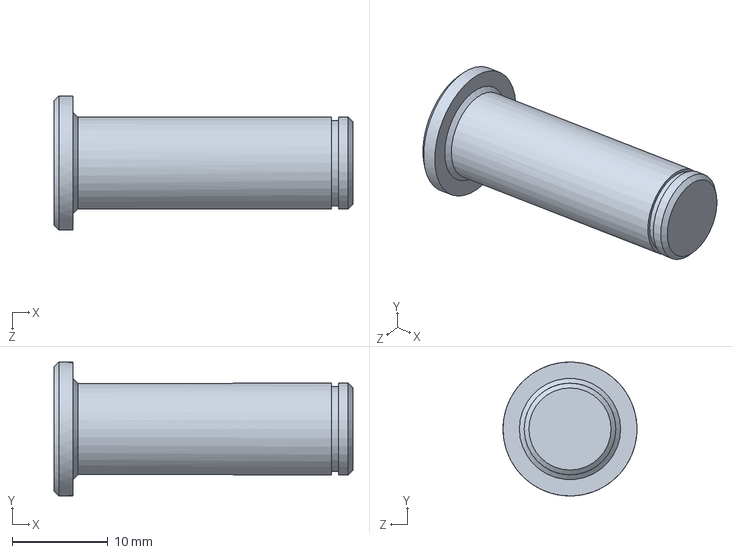
[picture p42: CAD file, 2019-01-26]
Solidworks/Cockpit/PedalCluster/BiasAdjusterPin.SLDPRT
31.2 x 14.0 x 14.0 mm
