LudemannEngineering/Formula-1000-Race-Car/Solidworks/Cockpit/Shifter/ShifterBracket.SLDPRT

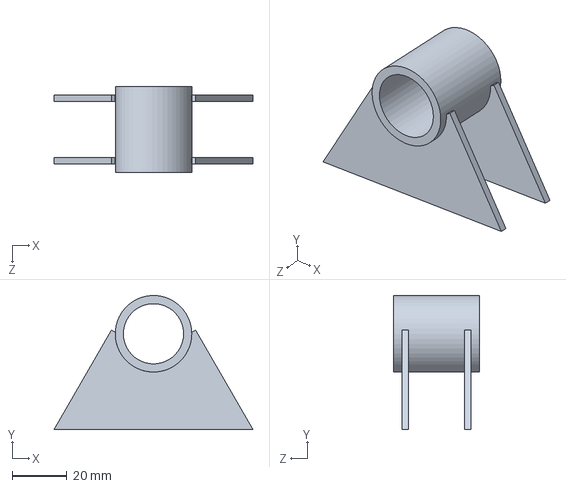
[picture p43: CAD file, 2019-01-21]
Solidworks/Cockpit/Shifter/ShifterBracket.SLDPRT
72.7 x 49.0 x 31.4 mm
