LudemannEngineering/Formula-1000-Race-Car/Solidworks/Drivetrain/AxleExtensionMountR.SLDPRT

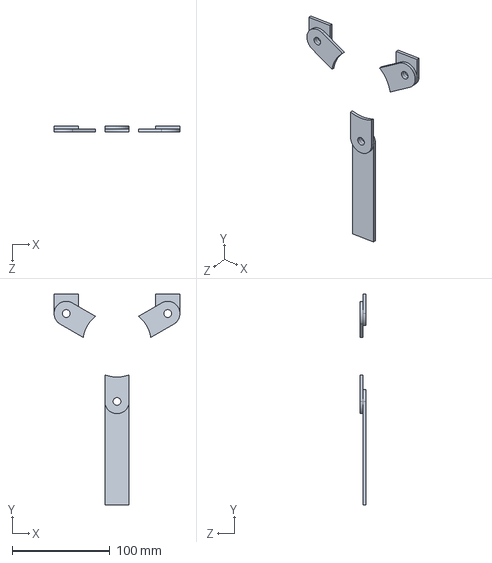
[picture p44: CAD file, 2019-01-26]
Solidworks/Drivetrain/AxleExtensionMountR.SLDPRT
128.9 x 216.0 x 6.00 mm
