LudemannEngineering/Formula-1000-Race-Car/Solidworks/Engine/3.SLDPRT

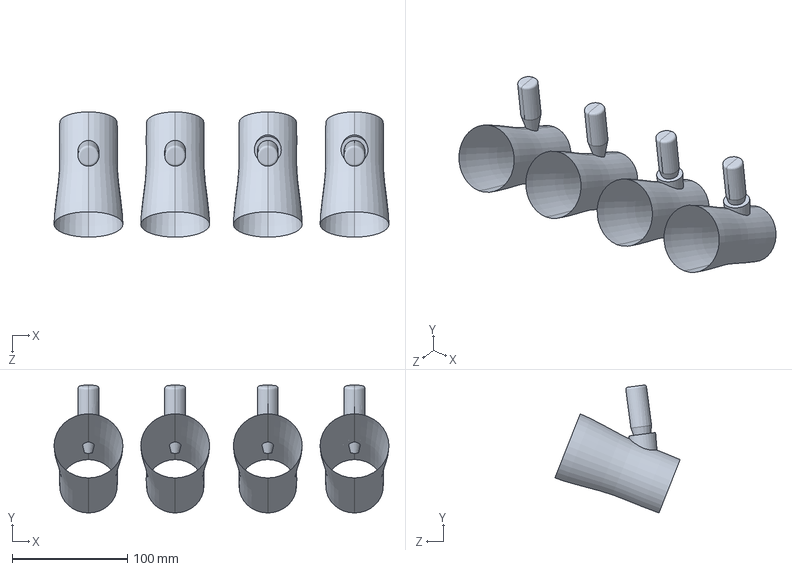
[picture p45: CAD file, 2019-01-26]
Solidworks/Engine/3.SLDPRT
290.4 x 110.9 x 108.6 mm
