LudemannEngineering/Formula-1000-Race-Car/Solidworks/Jigs/JigHeaders.SLDPRT

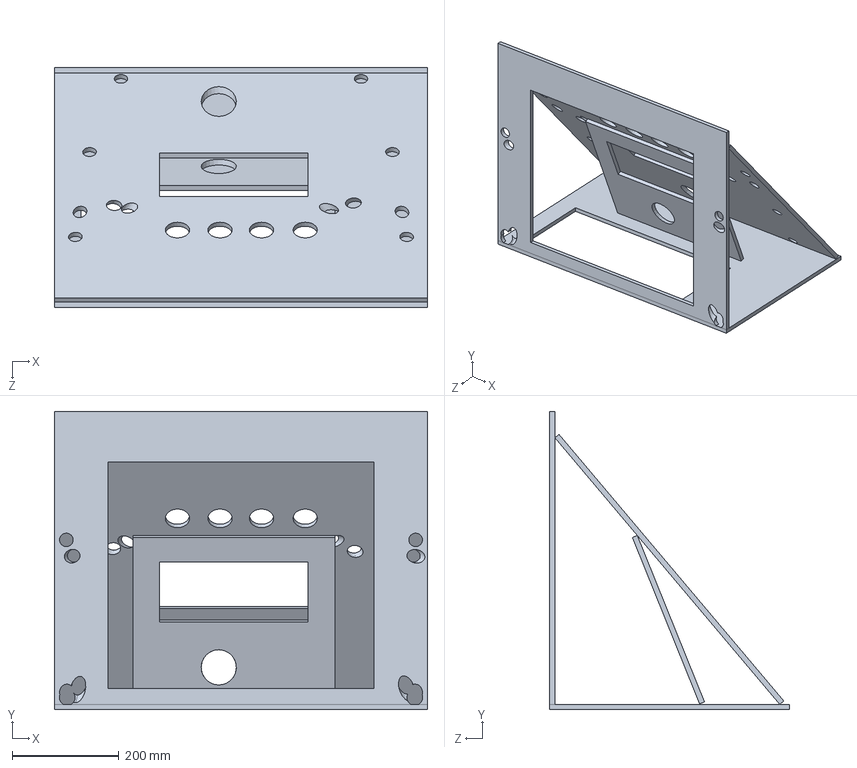
[picture p46: CAD file, 2019-01-21]
Solidworks/Jigs/JigHeaders.SLDPRT
700.0 x 560.0 x 450.0 mm
