LudemannEngineering/Formula-1000-Race-Car/Solidworks/Jigs/MainFrameJig/FrameTopRailJigs/JigTopRailG2Right.SLDPRT

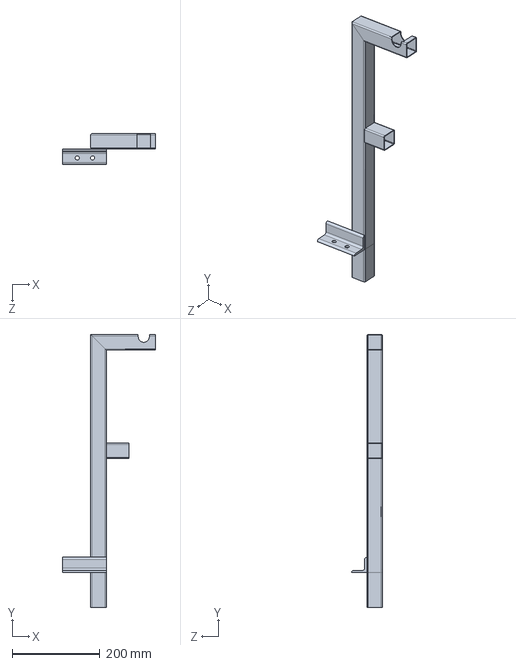
[picture p47: CAD file, 2019-01-21]
Solidworks/Jigs/MainFrameJig/FrameTopRailJigs/JigTopRailG2Right.SLDPRT
212.1 x 623.9 x 70.8 mm
