LudemannEngineering/Formula-1000-Race-Car/Solidworks/Jigs/Suspension/AarmMountInner.SLDPRT

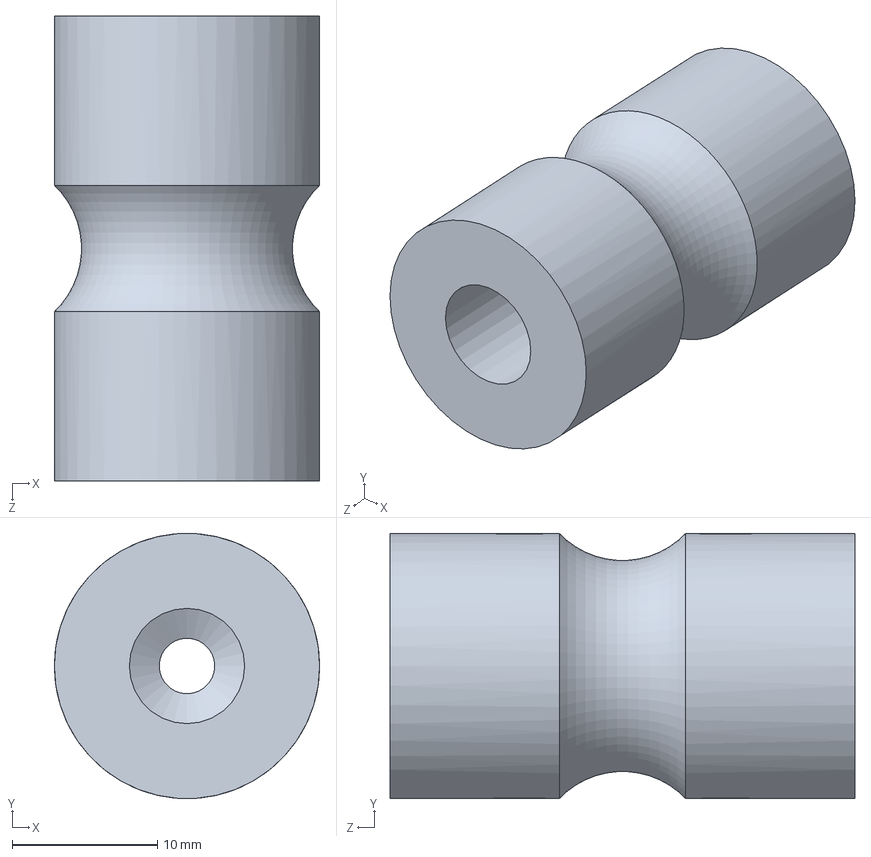
[picture p48: CAD file, 2019-01-21]
Solidworks/Jigs/Suspension/AarmMountInner.SLDPRT
18.3 x 18.3 x 32.0 mm
