LudemannEngineering/Formula-1000-Race-Car/Solidworks/Steering/SteeringColumnBush.SLDPRT

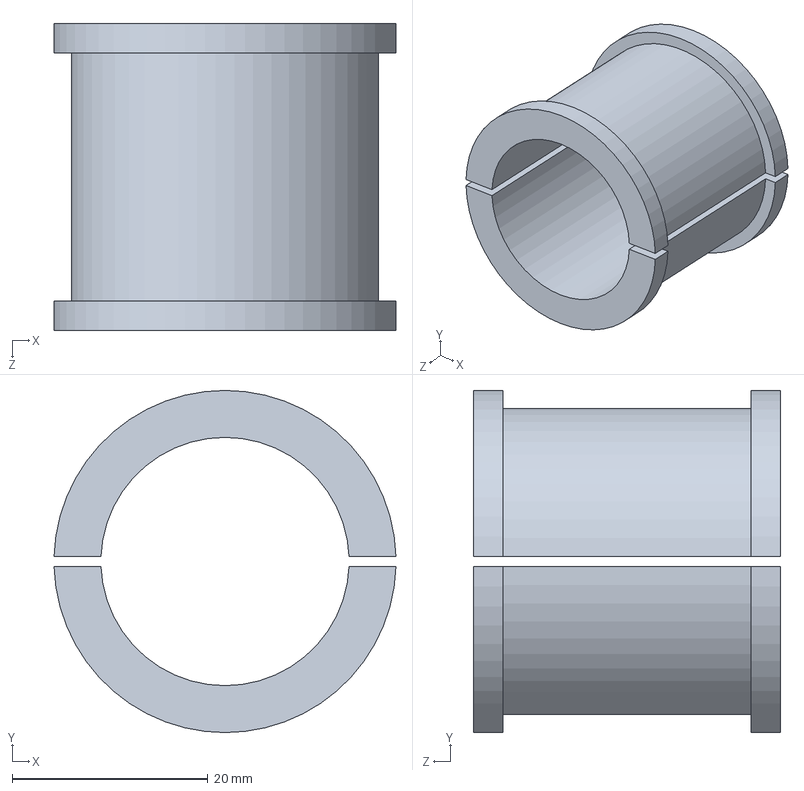
[picture p49: CAD file, 2019-01-26]
Solidworks/Steering/SteeringColumnBush.SLDPRT
35.0 x 35.0 x 31.4 mm
