LudemannEngineering/Formula-1000-Race-Car/Solidworks/Suspension/AntiRollBarFront/ARB_FrontChassisTabsRight.SLDPRT

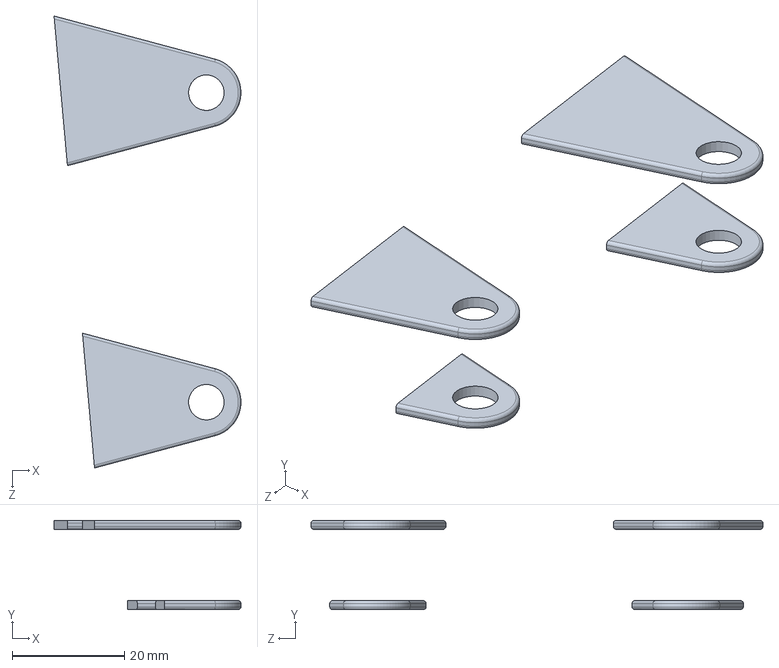
[picture p50: CAD file, 2019-01-21]
Solidworks/Suspension/AntiRollBarFront/ARB_FrontChassisTabsRight.SLDPRT
33.3 x 15.9 x 80.6 mm
