LudemannEngineering/Formula-1000-Race-Car/Solidworks/Suspension/FrontSuspension/chassis/SuspensionRockerMountLeftFrontLower.sldprt

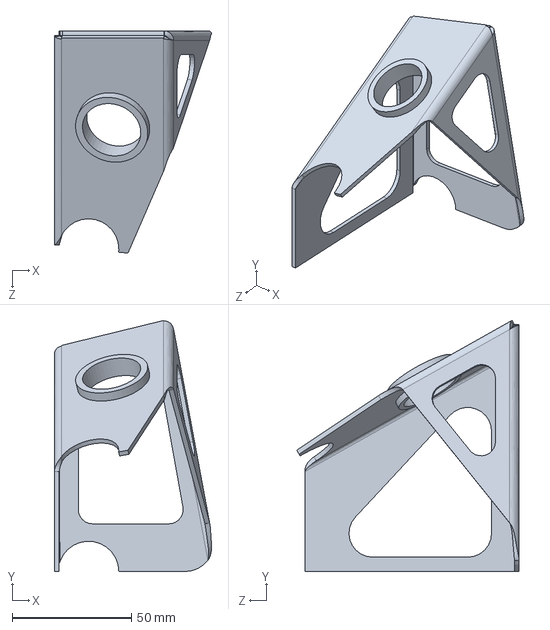
[picture p51: CAD file, 2019-01-21]
Solidworks/Suspension/FrontSuspension/chassis/SuspensionRockerMountLeftFrontLower.sldprt
65.9 x 105.3 x 93.3 mm
