LudemannEngineering/Formula-1000-Race-Car/Solidworks/Suspension/FrontSuspension/PushRodTubeF.sldprt

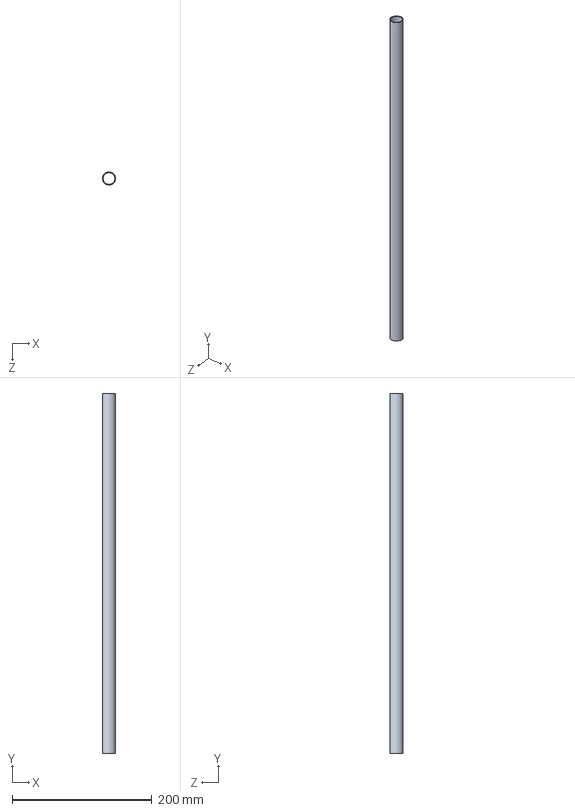
[picture p52: CAD file, 2019-01-26]
Solidworks/Suspension/FrontSuspension/PushRodTubeF.sldprt
19.1 x 516.0 x 19.1 mm
