LudemannEngineering/Formula-1000-Race-Car/Solidworks/Suspension/FrontSuspension/Suspension/BearingBall6005.SLDPRT

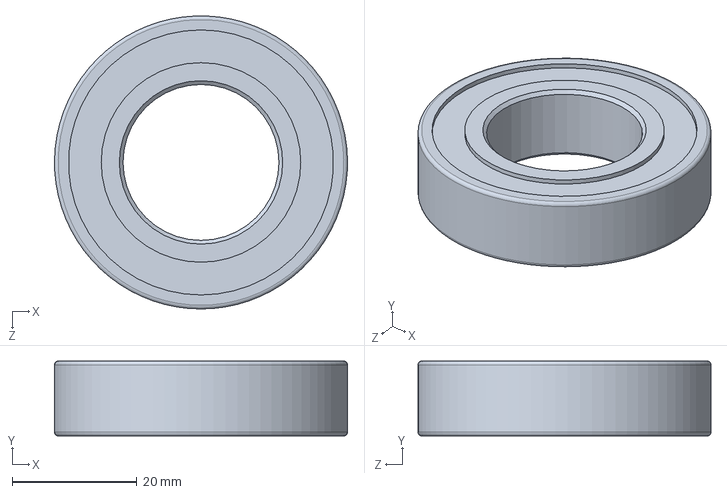
[picture p53: CAD file, 2019-01-21]
Solidworks/Suspension/FrontSuspension/Suspension/BearingBall6005.SLDPRT
47.0 x 12.0 x 47.0 mm
