LudemannEngineering/Formula-1000-Race-Car/Solidworks/Suspension/RearSuspension/PushRodTubeRear.sldprt

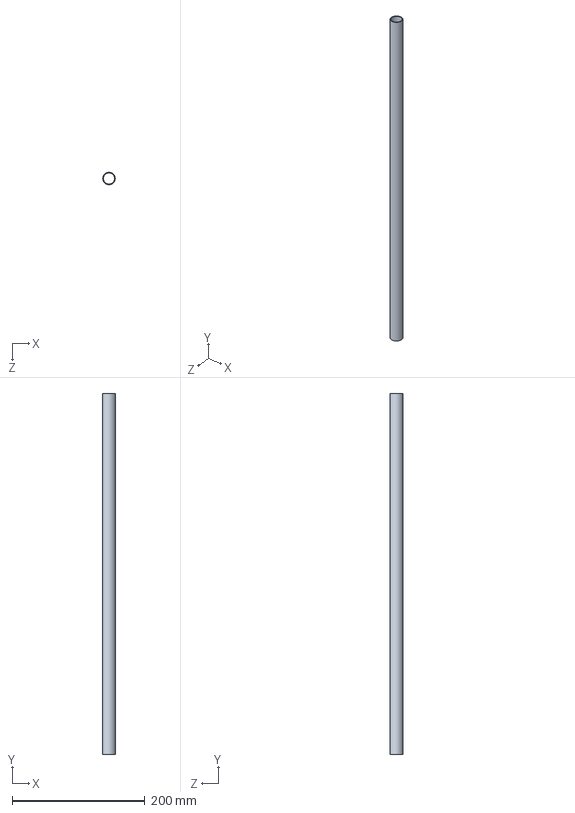
[picture p54: CAD file, 2019-01-26]
Solidworks/Suspension/RearSuspension/PushRodTubeRear.sldprt
19.1 x 543.0 x 19.1 mm
