LudemannEngineering/Formula-1000-Race-Car/Solidworks/Suspension/SuspClevLower.SLDPRT

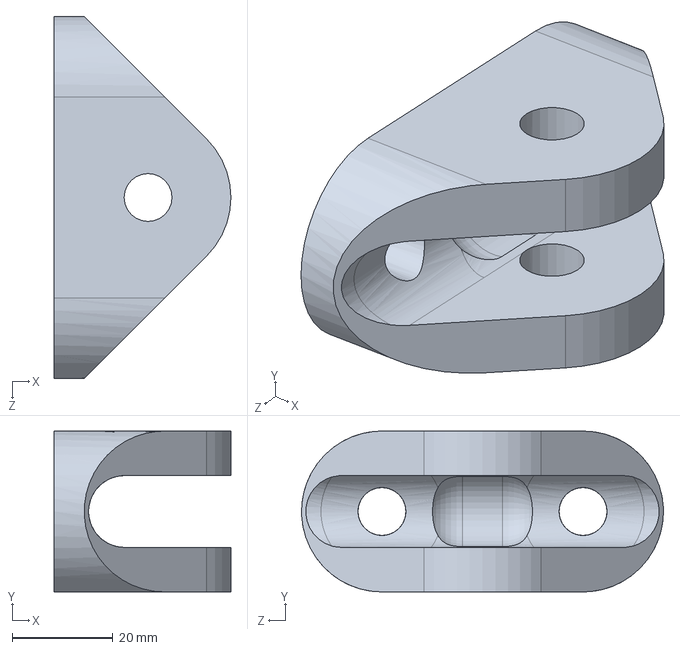
[picture p55: CAD file, 2019-01-26]
Solidworks/Suspension/SuspClevLower.SLDPRT
35.2 x 32.0 x 72.0 mm
