LudemannEngineering/Formula-1000-Race-Car/Solidworks/Tools/SawhorseOuter.SLDPRT

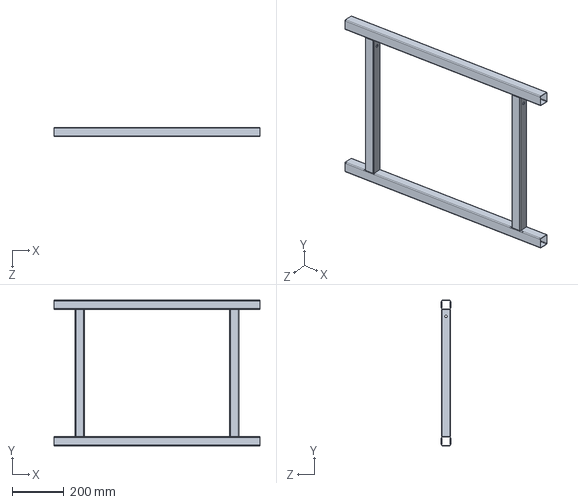
[picture p56: CAD file, 2019-01-21]
Solidworks/Tools/SawhorseOuter.SLDPRT
800.0 x 565.6 x 35.6 mm
