LudemannEngineering/Formula-1000-Race-Car/Solidworks/Trailer/SimpleTest.SLDPRT

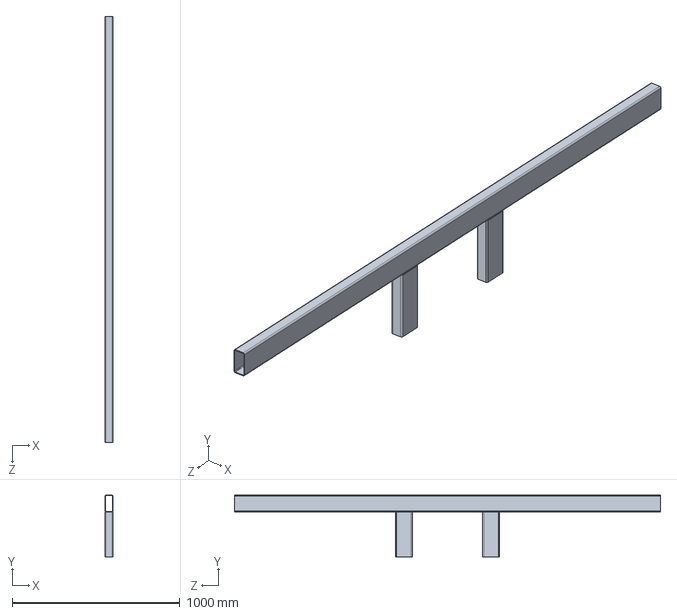
[picture p57: CAD file, 2019-01-21]
Solidworks/Trailer/SimpleTest.SLDPRT
50.0 x 367.8 x 2540.0 mm
