LudemannEngineering/Formula-1000-Race-Car/STEP/Body/WingRearX.STEP

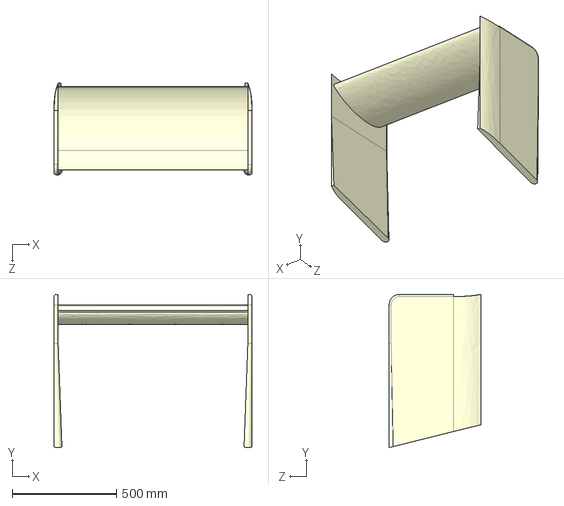
[picture p58: CAD file, 2019-01-26]
STEP/Body/WingRearX.STEP
950.0 x 735.0 x 440.0 mm
