LudemannEngineering/Formula-1000-Race-Car/STEP/Chassis/FuelTank5.STEP

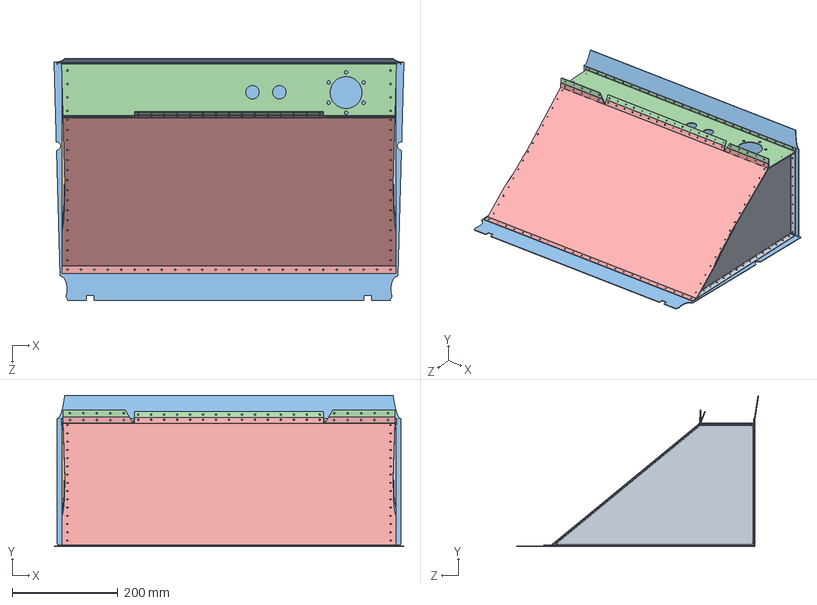
[picture p59: CAD file, 2019-01-26]
STEP/Chassis/FuelTank5.STEP
660.7 x 285.4 x 457.4 mm
