LudemannEngineering/Formula-1000-Race-Car/STEP/Chassis/RadiatorSetrab/OilCoolerSetrab.STEP

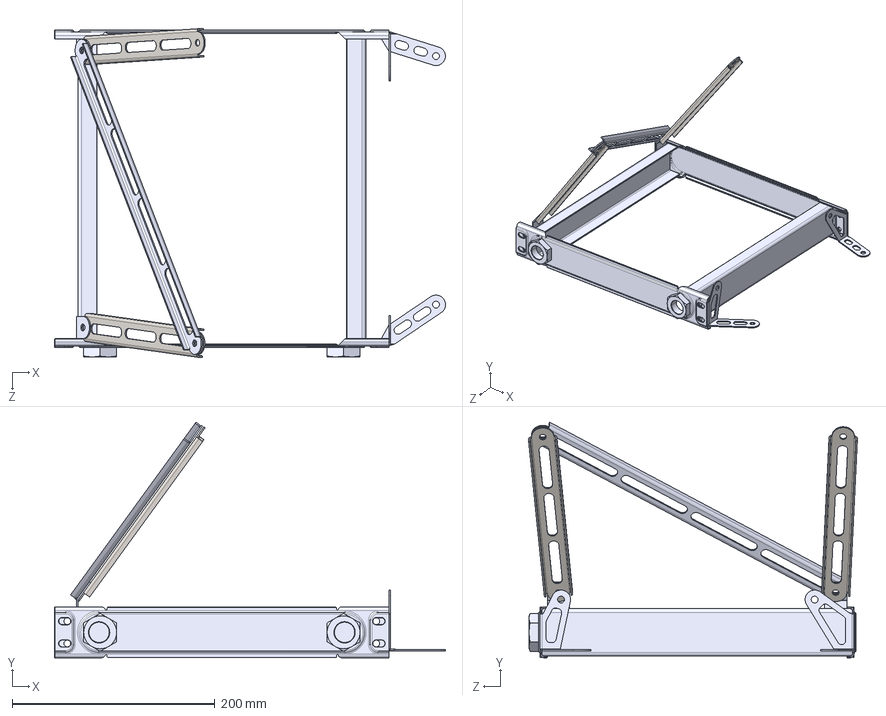
[picture p60: CAD file, 2019-01-26]
STEP/Chassis/RadiatorSetrab/OilCoolerSetrab.STEP
385.5 x 232.3 x 324.2 mm
RadiatorSides2
flasque radiateur
Symmetry of flasque radiateur
BracketOilCoolerUF_Sheet Metal Part
BracketOilCoolerLF_Sheet Metal Part
BracketOilCoolerRear
BracketOilCoolerRear_MirrorDefault
01-520-0001.7_MirrorDefault x 2
01-520-0001.B
