LudemannEngineering/Formula-1000-Race-Car/STEP/Cockpit/PedalCluster/PedalClutch.STEP

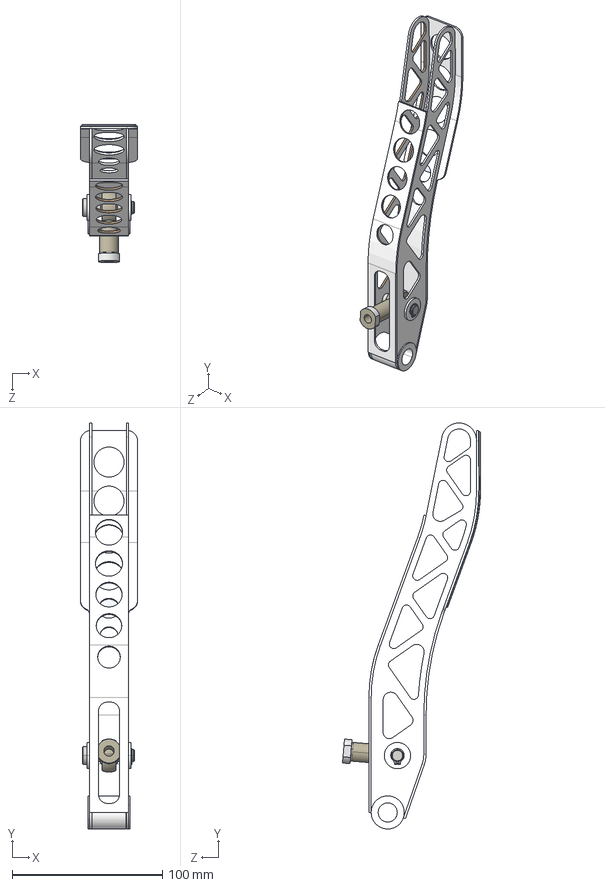
[picture p61: CAD file, 2019-01-26]
STEP/Cockpit/PedalCluster/PedalClutch.STEP
38.0 x 269.8 x 91.7 mm
PedalClutch_Finished Design
PedalBushing x 2
PedalPadBrake
RodEndBall312
RodEndRace312Fem
PedalClutchPin
Basic External Retaining Ring_AI_B27.1 - NA1-31
