LudemannEngineering/Formula-1000-Race-Car/STEP/Cockpit/SeatBack2.STEP

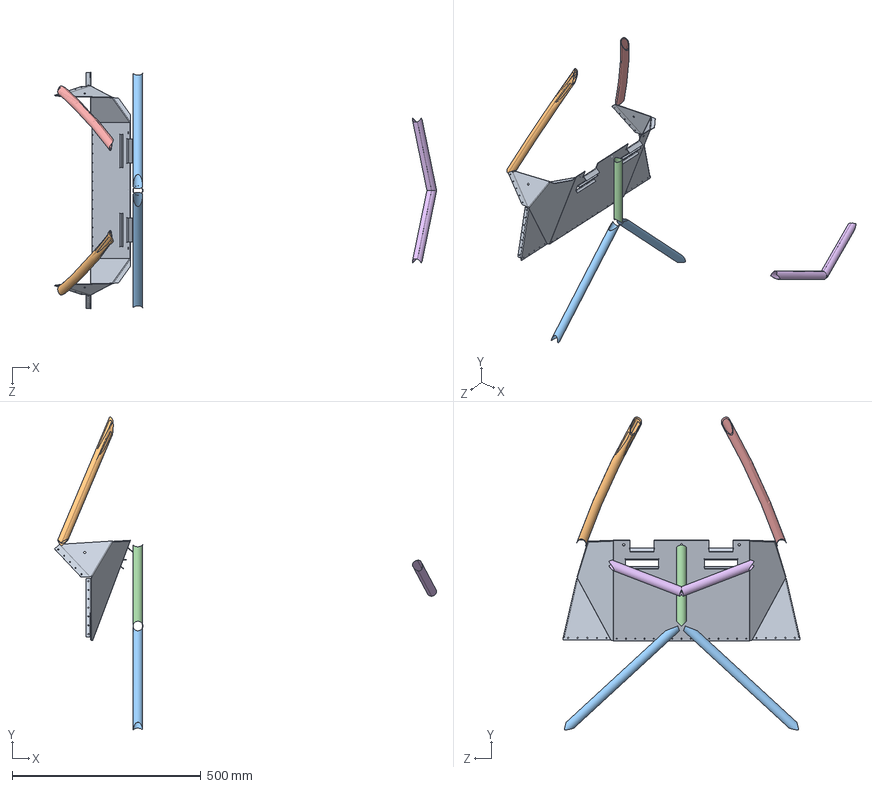
[picture p62: CAD file, 2019-01-26]
STEP/Cockpit/SeatBack2.STEP
1011.6 x 828.6 x 626.3 mm
