LudemannEngineering/Formula-1000-Race-Car/STEP/Driver/Driver.STEP

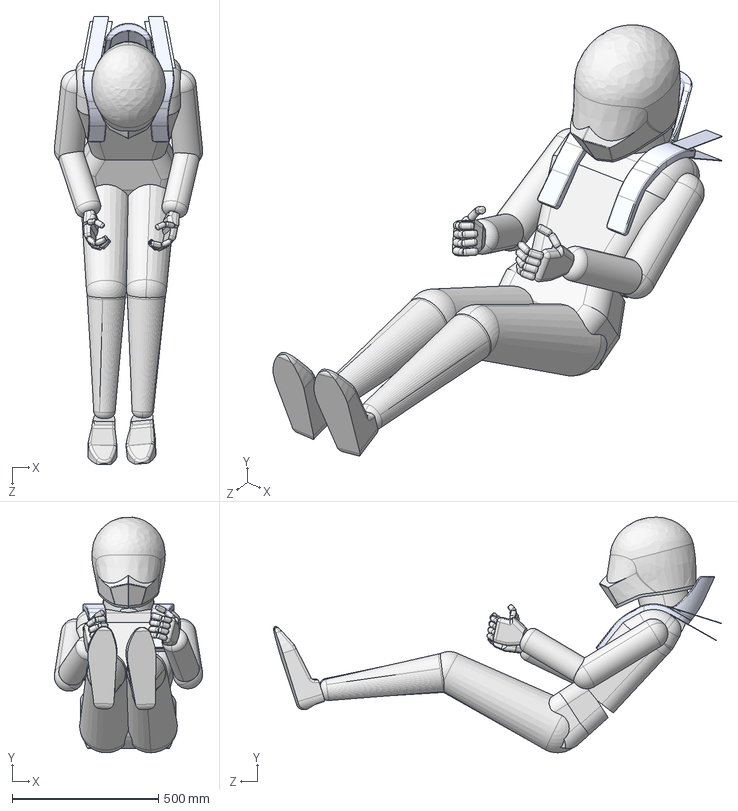
[picture p63: CAD file, 2019-01-26]
STEP/Driver/Driver.STEP
507.8 x 806.2 x 1533.0 mm
Torso
Upper Leg x 2
Lower Leg x 2
Foot x 2
Upper Arm x 2
Lower Arm x 2
ass 2
neck
head_helmet
right_palm
finger x 20
left_palm
HANS_Device
SeatBelts
