LudemannEngineering/Formula-1000-Race-Car/STEP/Drivetrain/FuelPumpSum-G3136-1.STEP

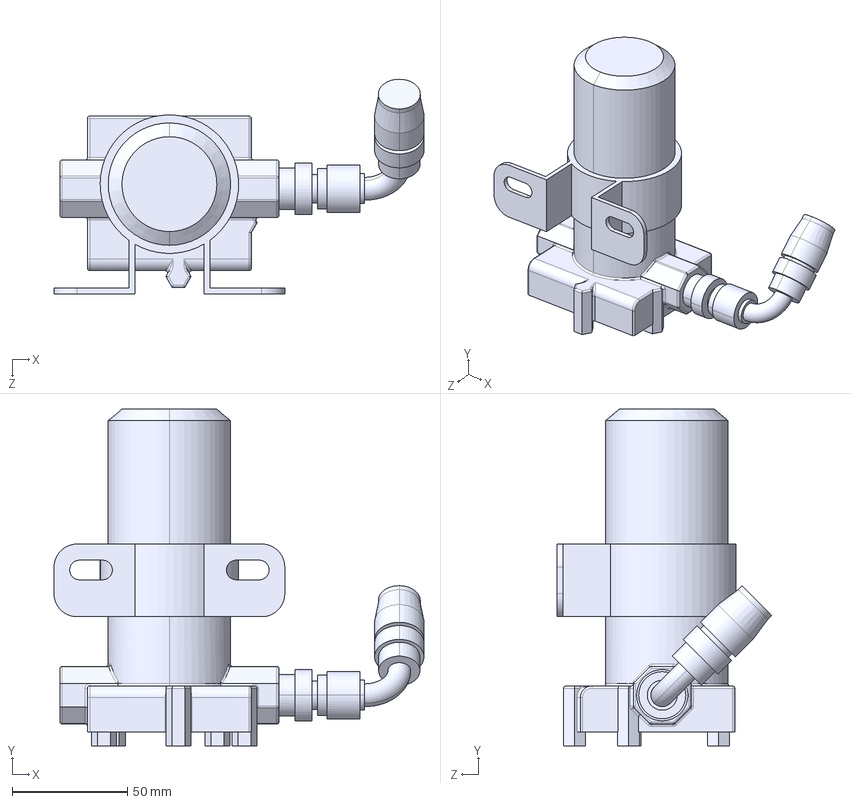
[picture p64: CAD file, 2019-01-26]
STEP/Drivetrain/FuelPumpSum-G3136-1.STEP
160.3 x 146.0 x 92.9 mm
