LudemannEngineering/Formula-1000-Race-Car/STEP/Fuel/FuelSurgeTank.STEP

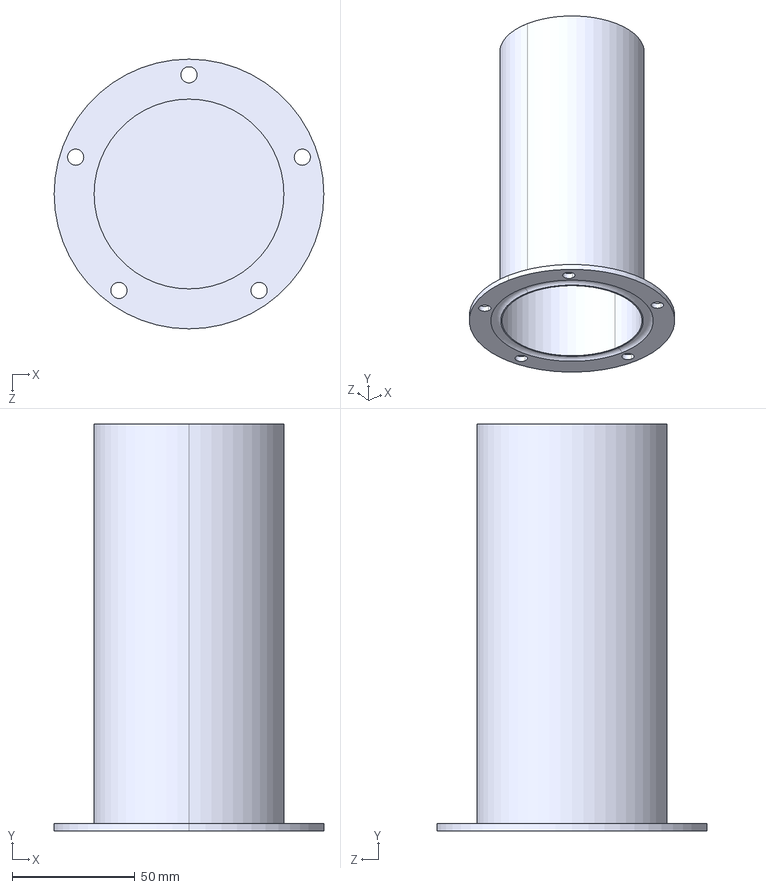
[picture p65: CAD file, 2019-01-26]
STEP/Fuel/FuelSurgeTank.STEP
110.0 x 166.0 x 110.0 mm
