LudemannEngineering/Formula-1000-Race-Car/STEP/Steering/SteeringColumn2SplineShaftFront.STEP

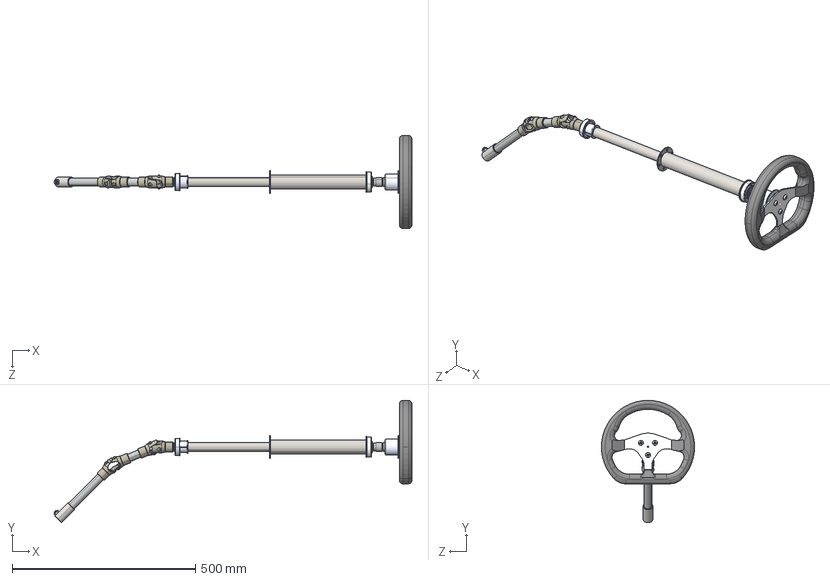
[picture p66: CAD file, 2019-01-26]
STEP/Steering/SteeringColumn2SplineShaftFront.STEP
975.9 x 333.4 x 254.0 mm
BearingBall6005
SteeringWheelDisconnectSpline
SteeringWheelDisconnect
U-JointWoodward x 4
SteeringWheel
Basic Internal Retaining Ring_am_B27.7M - 3BM1-47
Basic Internal Retaining Ring_am_B27.7M - 3BM1-55
TubeSteering.75_DoubleUJoint
Coupler.75SmoothTo.625-36Spline
TubeSteering.75_RackToUJoint
SteeringColumn
AdapterUJointToColumn
AdapterHubToColumn
Radial Ball Bearing_68_SKF_SKF - 6006 - 14,SI,NC,14_68
Basic External Retaining Ring_wti_Truarc 5100-112 - S1.125
Socket Button Head Cap Screw_AI_SBHCSCREW 0.3125-18x0.5-HX-N x 3
SteeringColumnBush
