LudemannEngineering/Formula-1000-Race-Car/STEP/Suspension/ControlArmLFLower.STEP

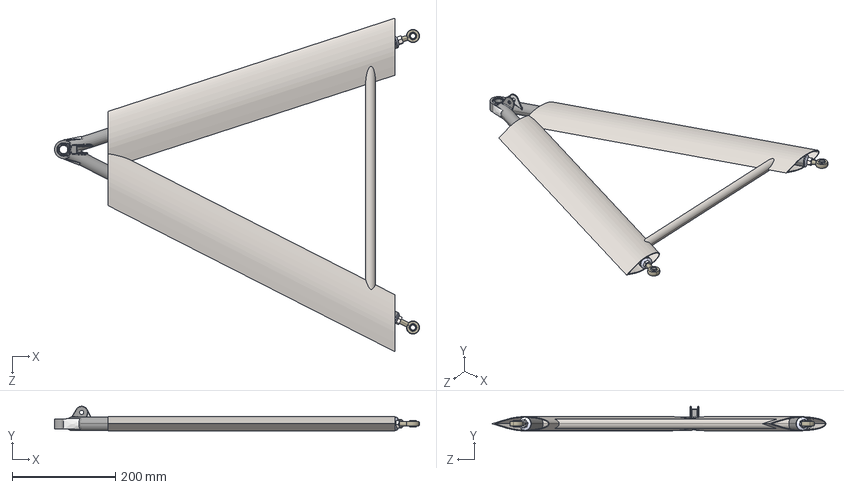
[picture p67: CAD file, 2019-01-26]
STEP/Suspension/ControlArmLFLower.STEP
705.7 x 47.5 x 645.2 mm
ControlArmLFL_Default<As Machined>
ControlArmEnd375-24L x 2
Hex Nut_AI_HNUT 0.3750-24-D-N x 2
SphericalBearingBall625
SphericalBeaingRace625
RodEndBall375 x 2
RodEndRace375 x 2
Basic Internal Retaining Ring_am_B27.7M - 3BM1-30
