LudemannEngineering/Formula-1000-Race-Car/STEP/Suspension/FrontSuspension/SuspensionRockerFront.STEP

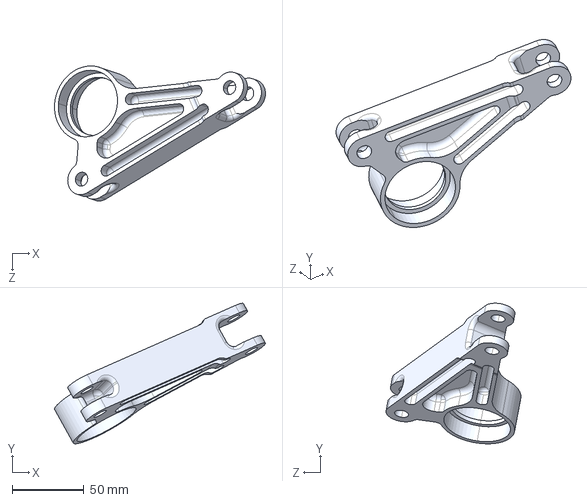
[picture p68: CAD file, 2019-01-26]
STEP/Suspension/FrontSuspension/SuspensionRockerFront.STEP
146.9 x 97.9 x 94.0 mm
