LudemannEngineering/Formula-1000-Race-Car/STEP/Suspension/RearSuspension/ControlArmRLower.STEP

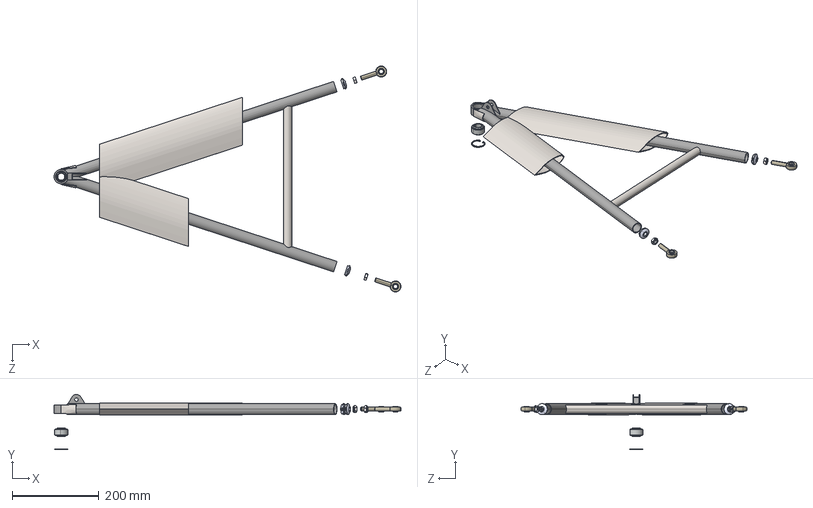
[picture p69: CAD file, 2019-01-26]
STEP/Suspension/RearSuspension/ControlArmRLower.STEP
800.0 x 127.0 x 520.9 mm
ControlArmRL_Default<As Machined>
ControlArmEnd375-24L x 2
SphericalBearingBall625
SphericalBeaingRace625
Hex Jam Nut_AI_HJNUT 0.3750-24-D-N x 2
RodEndBall375 x 2
RodEndRace375 x 2
Basic Internal Retaining Ring_am_B27.7M - 3BM1-30
