LudemannEngineering/Formula-1000-Race-Car/Drawings/Tubes/J-LLeftDiagBottom.SLDPRT

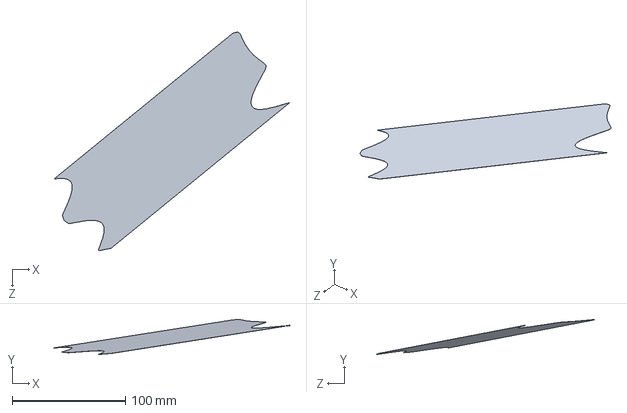
[picture p70: CAD file, 2019-01-21]
Drawings/Tubes/J-LLeftDiagBottom.SLDPRT
208.3 x 30.9 x 192.9 mm
