LudemannEngineering/Formula-1000-Race-Car/Solidworks/Brakes/BrakePedalShaft.SLDPRT

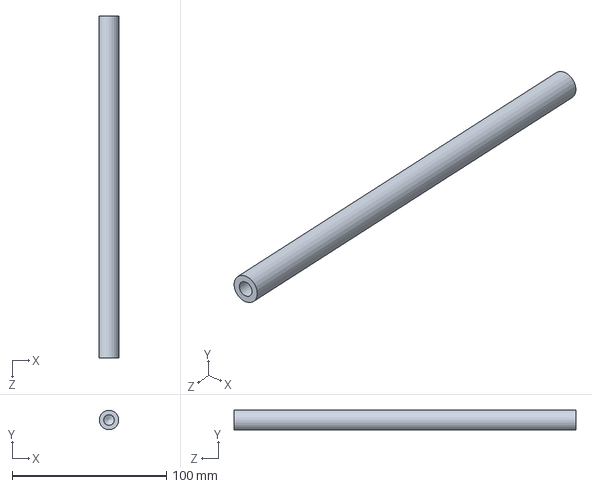
[picture p71: CAD file, 2019-01-26]
Solidworks/Brakes/BrakePedalShaft.SLDPRT
12.7 x 12.7 x 222.0 mm
