LudemannEngineering/Formula-1000-Race-Car/Solidworks/Chassis/RadiatorSetrab/BracketOilCoolerRear.SLDPRT

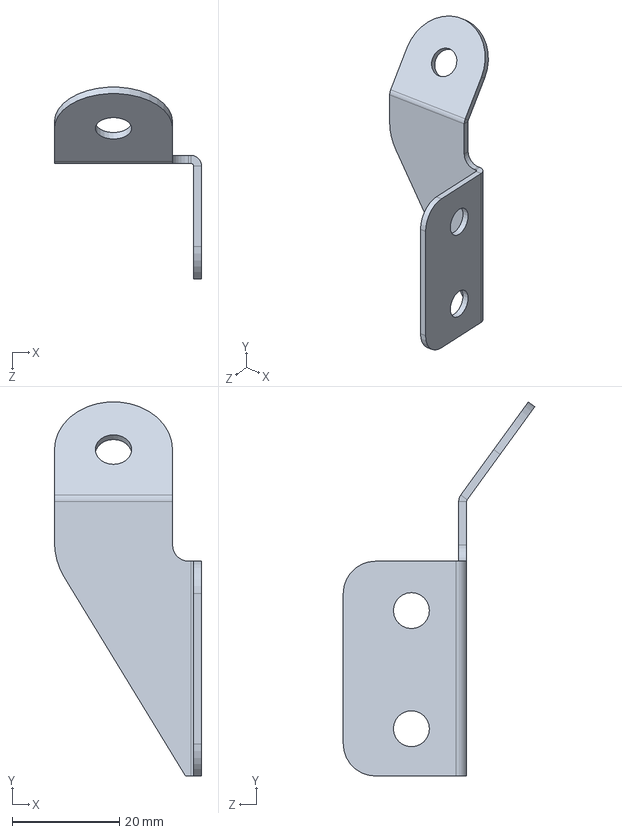
[picture p72: CAD file, 2019-01-26]
Solidworks/Chassis/RadiatorSetrab/BracketOilCoolerRear.SLDPRT
27.4 x 69.6 x 35.7 mm
