LudemannEngineering/Formula-1000-Race-Car/Solidworks/Cockpit/PedalCluster/SphericalBeaingRaceGE17C.SLDPRT

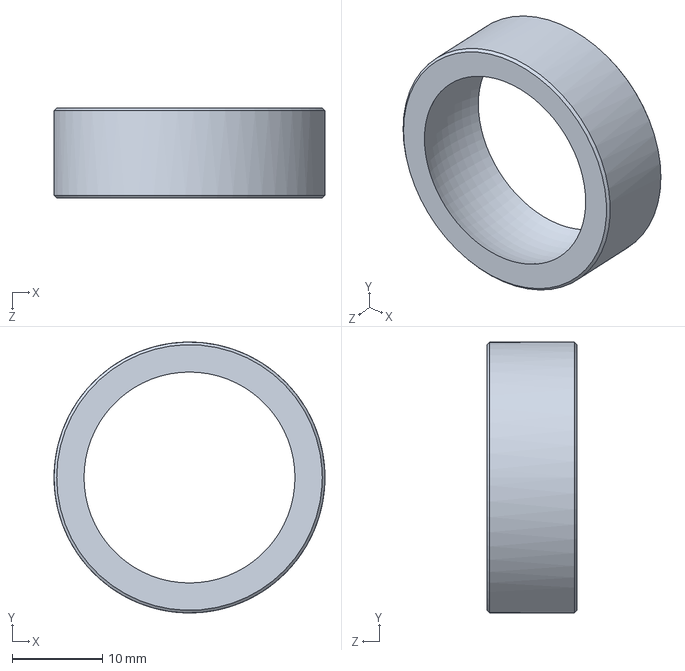
[picture p73: CAD file, 2019-01-26]
Solidworks/Cockpit/PedalCluster/SphericalBeaingRaceGE17C.SLDPRT
30.0 x 30.0 x 10.0 mm
