LudemannEngineering/Formula-1000-Race-Car/Solidworks/Cockpit/Shifter/ShifterBall.SLDPRT

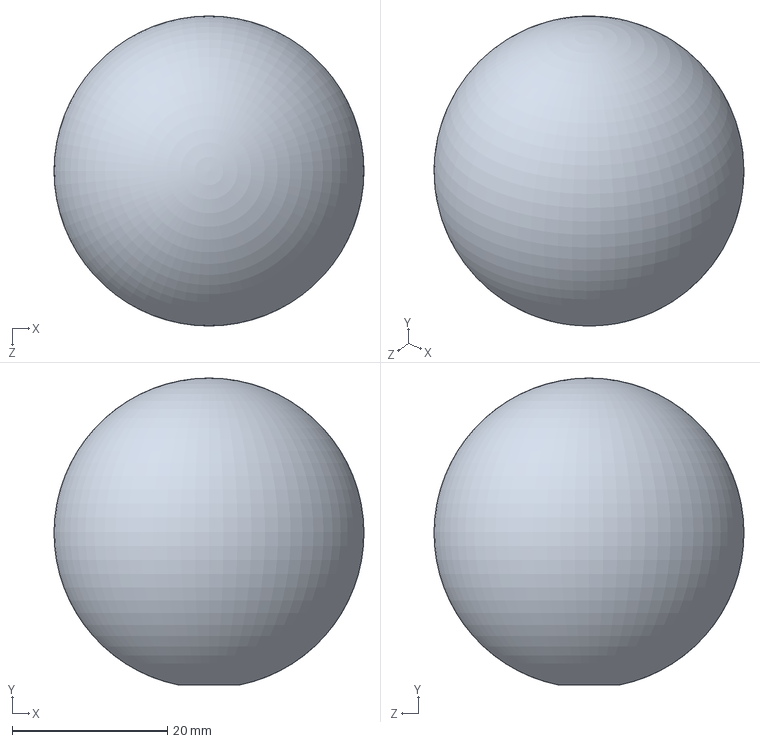
[picture p74: CAD file, 2019-01-21]
Solidworks/Cockpit/Shifter/ShifterBall.SLDPRT
40.0 x 39.6 x 40.0 mm
