LudemannEngineering/Formula-1000-Race-Car/Solidworks/Driver/left_palm.SLDPRT

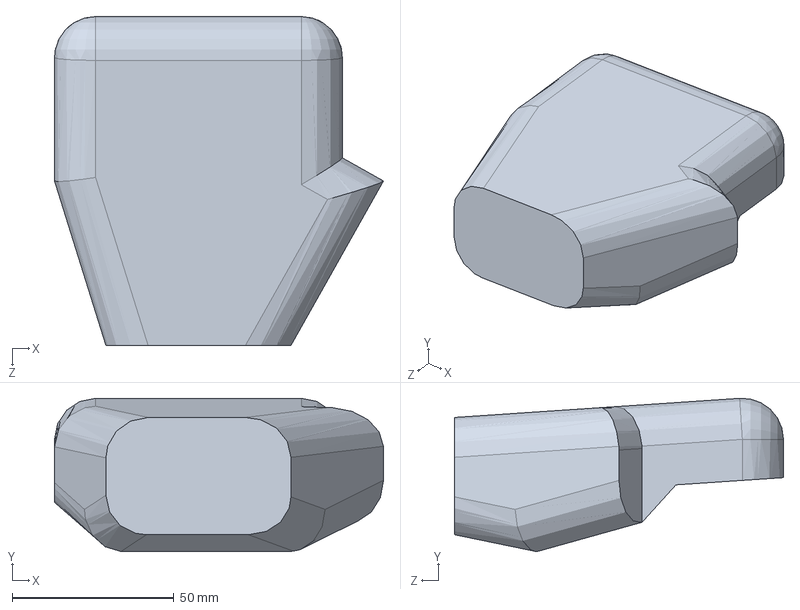
[picture p75: CAD file, 2019-01-26]
Solidworks/Driver/left_palm.SLDPRT
101.6 x 47.4 x 101.6 mm
