LudemannEngineering/Formula-1000-Race-Car/Solidworks/Drivetrain/Sprocket50Real.SLDPRT

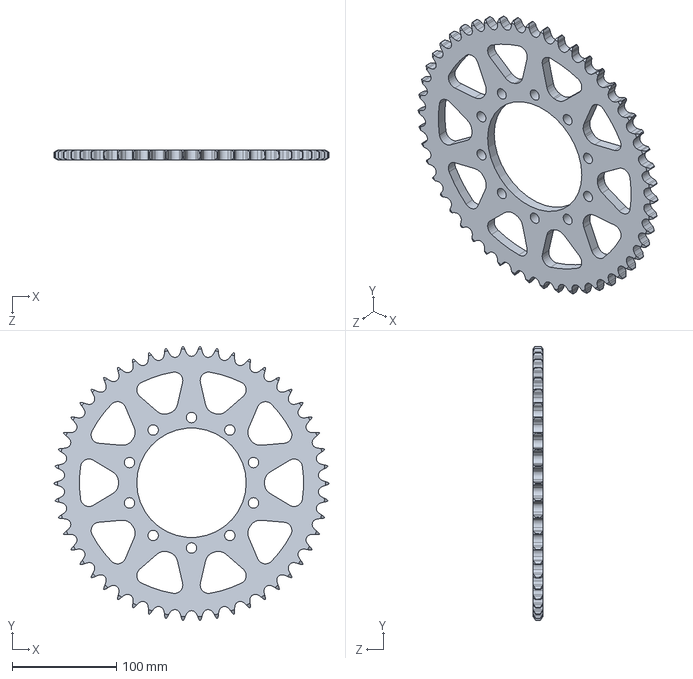
[picture p76: CAD file, 2019-01-26]
Solidworks/Drivetrain/Sprocket50Real.SLDPRT
263.7 x 263.2 x 9.37 mm
