LudemannEngineering/Formula-1000-Race-Car/Solidworks/Engine/1.SLDPRT

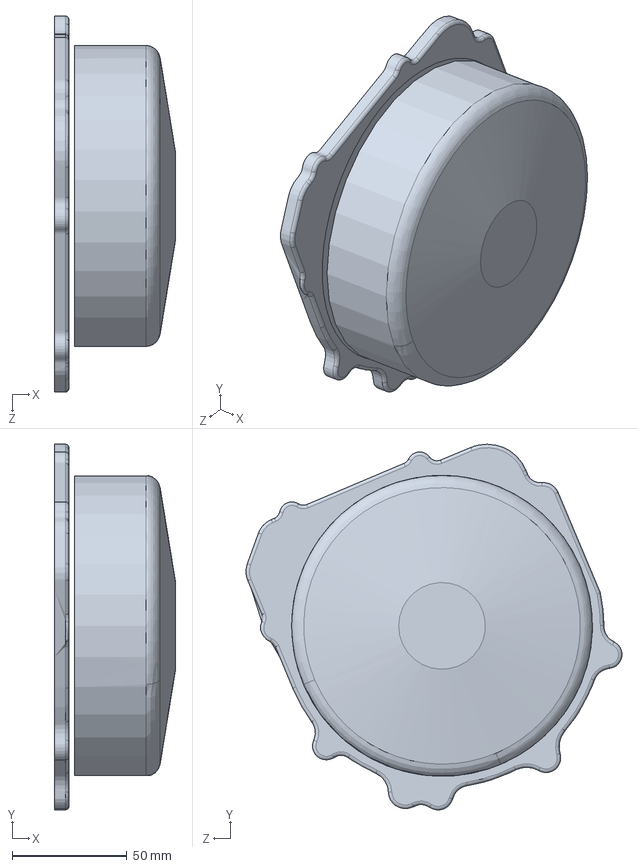
[picture p77: CAD file, 2019-01-26]
Solidworks/Engine/1.SLDPRT
52.9 x 159.6 x 164.1 mm
