LudemannEngineering/Formula-1000-Race-Car/Solidworks/Jigs/MainFrameJig/FrameTopRailJigs/JigTopRailALeft.SLDPRT

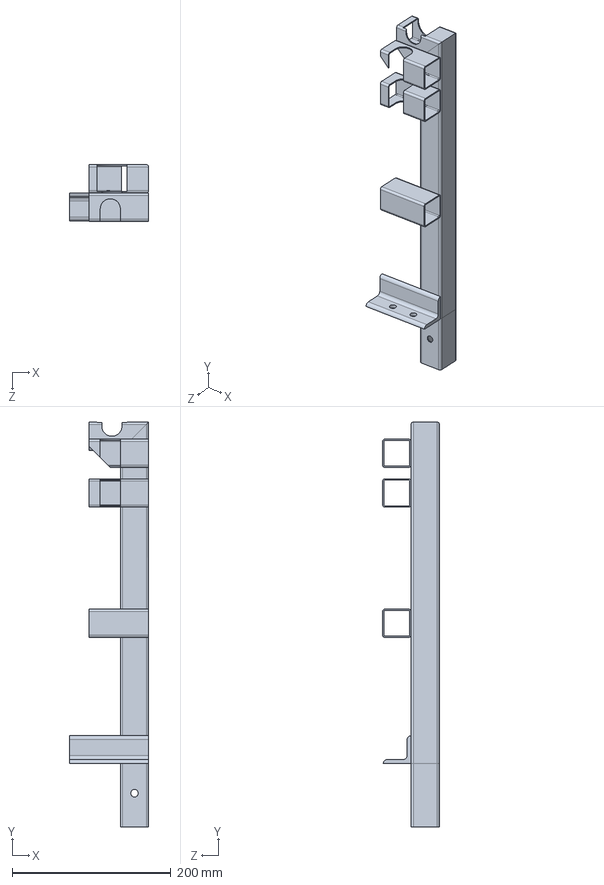
[picture p78: CAD file, 2019-01-21]
Solidworks/Jigs/MainFrameJig/FrameTopRailJigs/JigTopRailALeft.SLDPRT
100.0 x 509.9 x 71.6 mm
