LudemannEngineering/Formula-1000-Race-Car/Solidworks/Jigs/MainFrameJig/JigRearKeel.SLDPRT

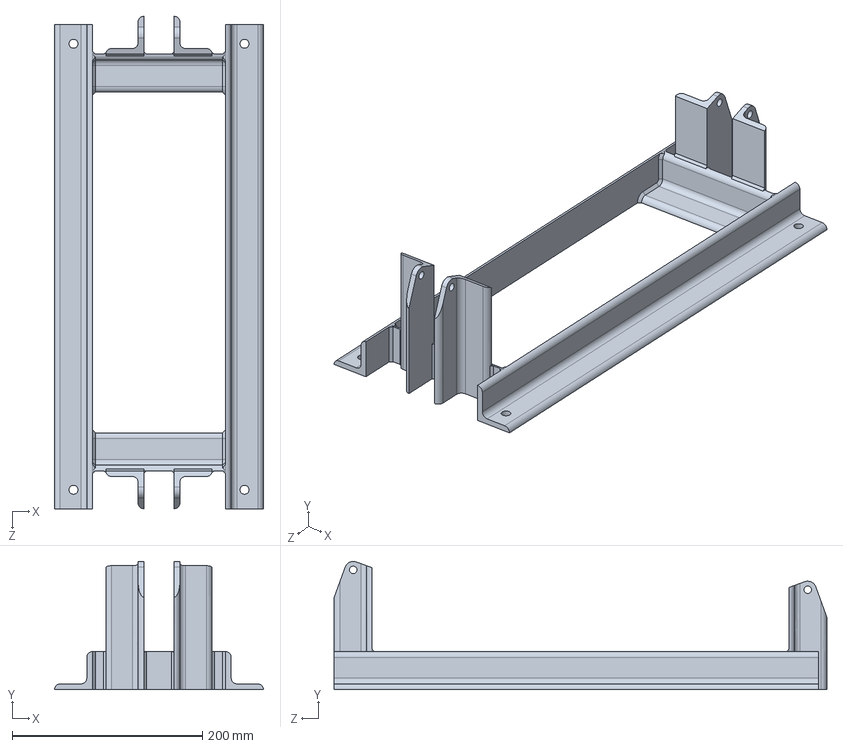
[picture p79: CAD file, 2019-01-21]
Solidworks/Jigs/MainFrameJig/JigRearKeel.SLDPRT
220.0 x 134.9 x 518.5 mm
