LudemannEngineering/Formula-1000-Race-Car/Solidworks/Steering/SteeringWheel.SLDPRT

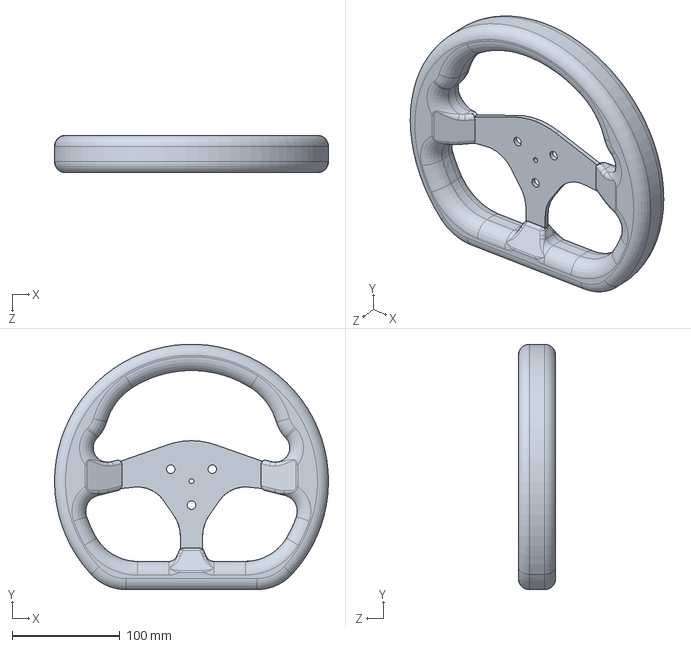
[picture p80: CAD file, 2019-01-26]
Solidworks/Steering/SteeringWheel.SLDPRT
254.0 x 227.5 x 34.6 mm
