LudemannEngineering/Formula-1000-Race-Car/Solidworks/Suspension/ControlArmLU.SLDPRT

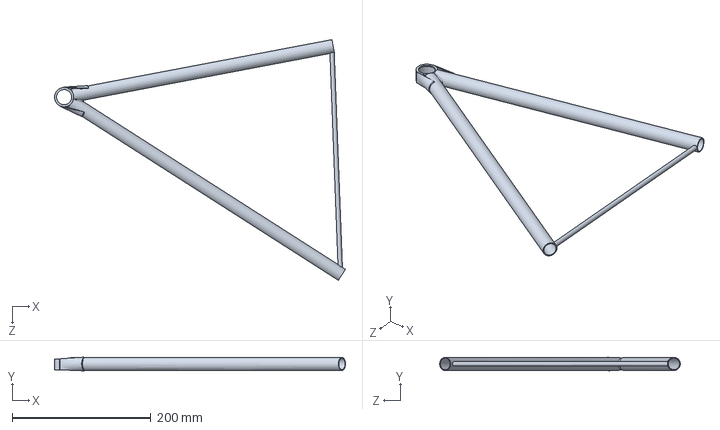
[picture p81: CAD file, 2019-01-26]
Solidworks/Suspension/ControlArmLU.SLDPRT
419.5 x 19.9 x 347.0 mm
