LudemannEngineering/Formula-1000-Race-Car/Solidworks/Suspension/FrontSuspension/chassis/SuspensionRockerMountLeftFrontUpper.sldprt

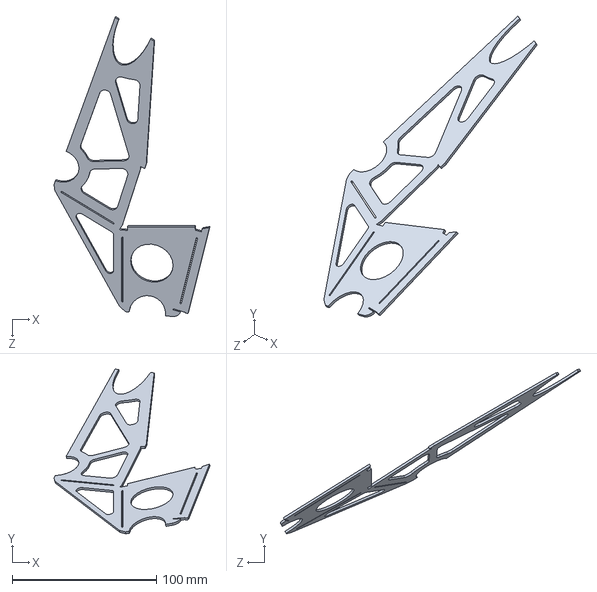
[picture p82: CAD file, 2019-01-21]
Solidworks/Suspension/FrontSuspension/chassis/SuspensionRockerMountLeftFrontUpper.sldprt
108.1 x 114.1 x 207.9 mm
