LudemannEngineering/Formula-1000-Race-Car/Solidworks/Suspension/FrontSuspension/CVjointCivicOuterMod.SLDPRT

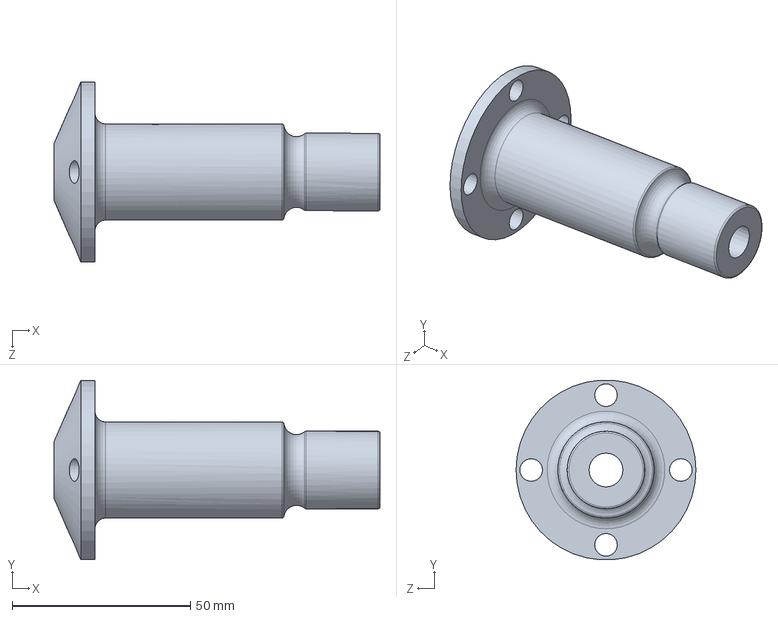
[picture p83: CAD file, 2019-01-26]
Solidworks/Suspension/FrontSuspension/CVjointCivicOuterMod.SLDPRT
91.5 x 50.4 x 50.5 mm
