LudemannEngineering/Formula-1000-Race-Car/Solidworks/Suspension/RearSuspension/01-210-0007.SLDPRT

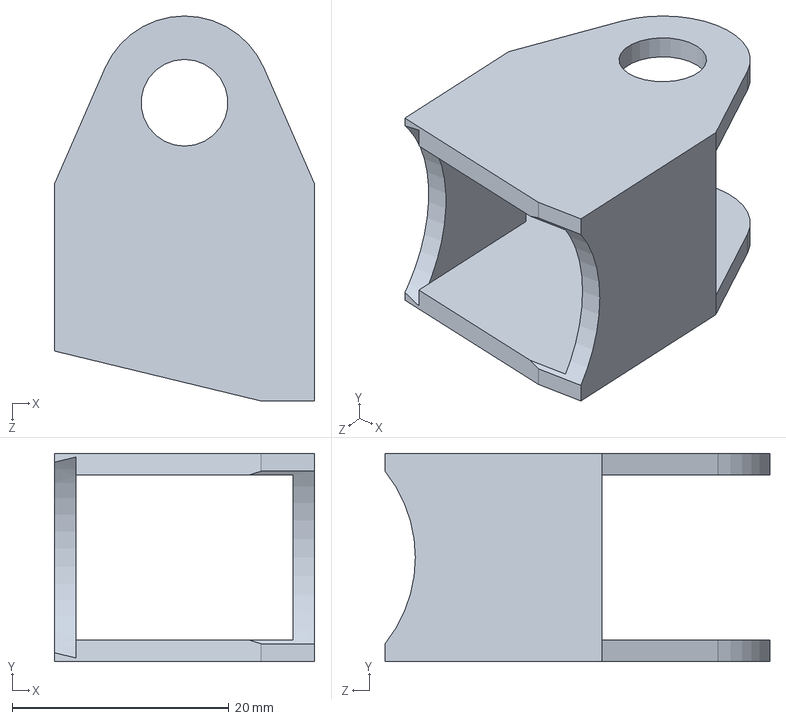
[picture p84: CAD file, 2019-01-21]
Solidworks/Suspension/RearSuspension/01-210-0007.SLDPRT
24.0 x 19.2 x 35.5 mm
