LudemannEngineering/Formula-1000-Race-Car/Solidworks/Tools/CarDolly.SLDPRT

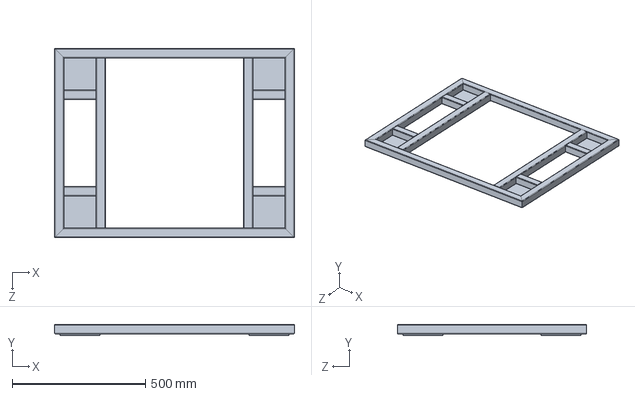
[picture p85: CAD file, 2019-01-21]
Solidworks/Tools/CarDolly.SLDPRT
900.0 x 41.8 x 710.0 mm
