LudemannEngineering/Formula-1000-Race-Car/Solidworks/Trailer/Treadplate.SLDPRT

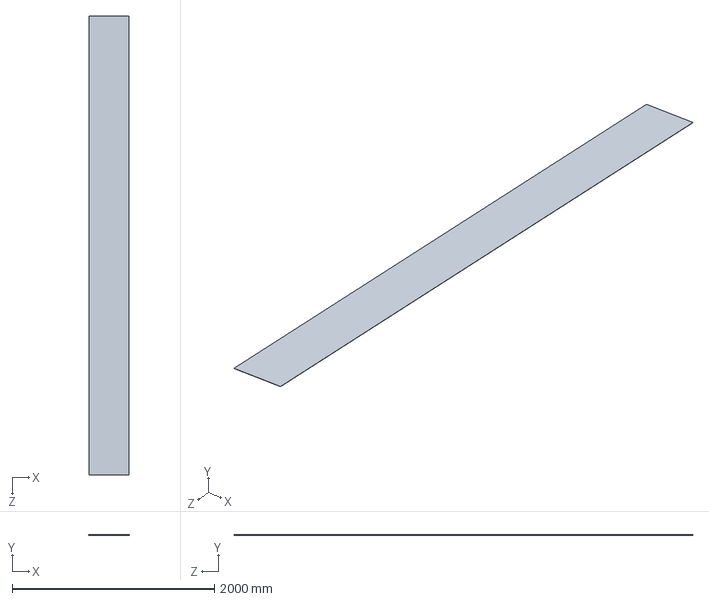
[picture p86: CAD file, 2019-01-21]
Solidworks/Trailer/Treadplate.SLDPRT
400.0 x 2.00 x 4540.0 mm
