LudemannEngineering/Formula-1000-Race-Car/STEP/Body/WingFrontZ.STEP

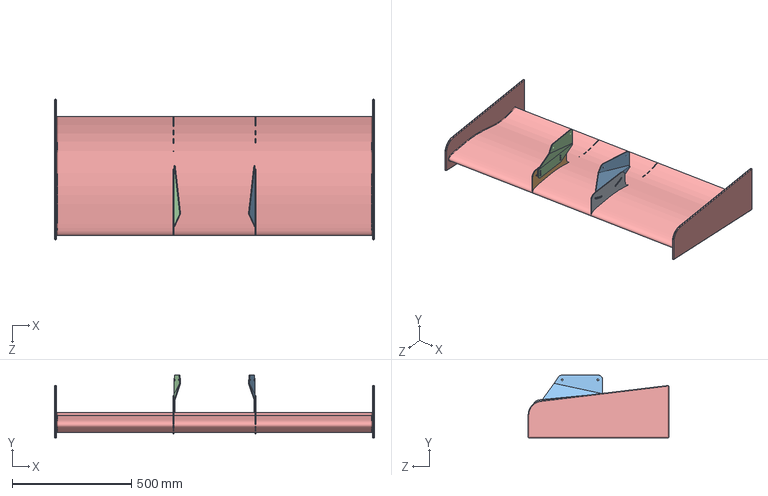
[picture p87: CAD file, 2019-01-26]
STEP/Body/WingFrontZ.STEP
1340.0 x 263.3 x 589.0 mm
