LudemannEngineering/Formula-1000-Race-Car/STEP/Cockpit/ExternalSides.STEP

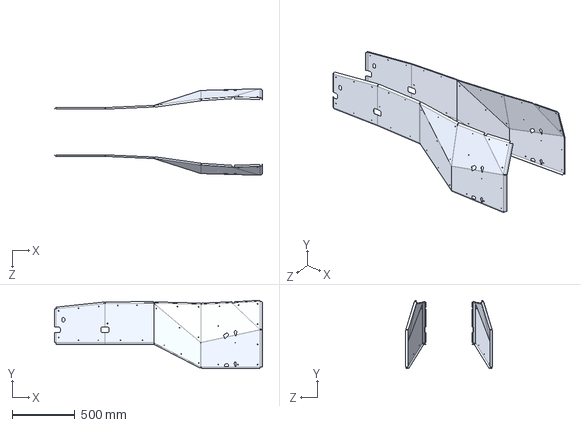
[picture p88: CAD file, 2019-01-26]
STEP/Cockpit/ExternalSides.STEP
1659.4 x 545.6 x 690.2 mm
