LudemannEngineering/Formula-1000-Race-Car/STEP/Cockpit/PedalCluster/PedalBrake.STEP

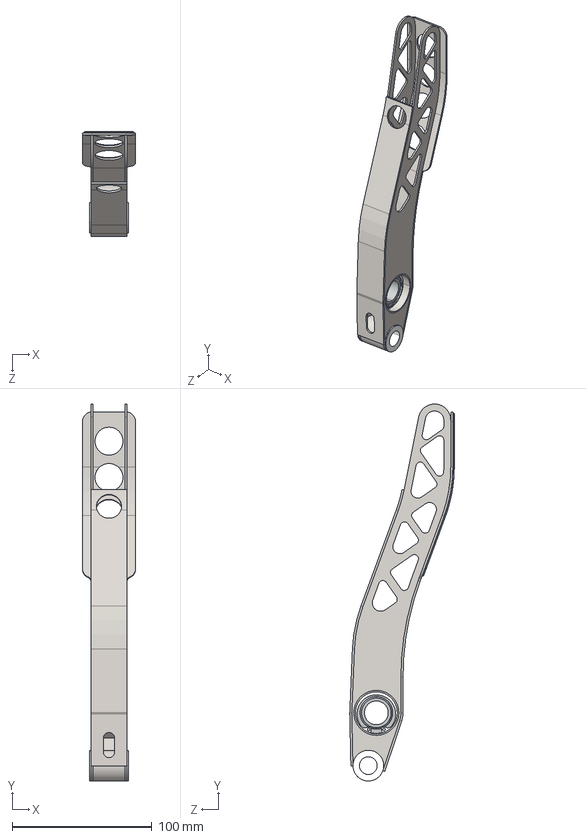
[picture p89: CAD file, 2019-01-26]
STEP/Cockpit/PedalCluster/PedalBrake.STEP
38.0 x 269.8 x 74.8 mm
PedalBrake2_Finished Design
PedalBushing x 2
PedalPadBrake
SphericalBearingBallGE17C
SphericalBeaingRaceGE17C
basic internal retaining ring_AI_B27.1 - NA2-118 x 2
