LudemannEngineering/Formula-1000-Race-Car/STEP/Drivetrain/IdlerSprocket.STEP

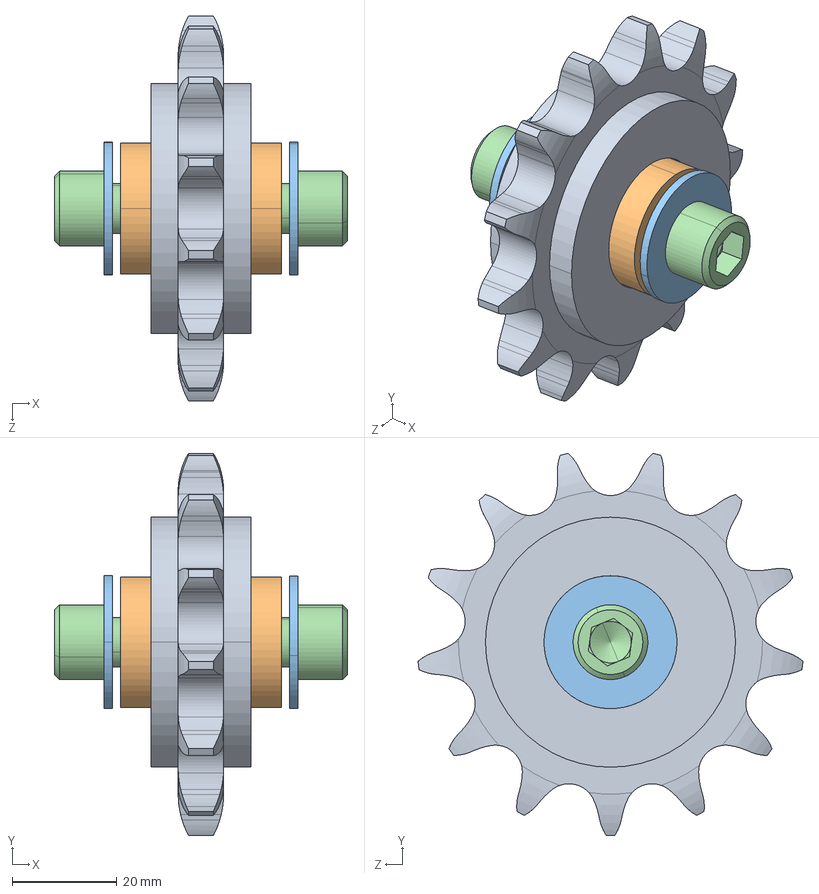
[picture p90: CAD file, 2019-01-26]
STEP/Drivetrain/IdlerSprocket.STEP
56.1 x 73.0 x 73.6 mm
Precision Roller Chain Sprocket_AI_50-0.625P1ST13T13SB3.0H.75L1.0000N
ChainTensionerShaft
Flat Washer Type B Regular_AI_Regular FW 0.375 x 2
Socket Head Cap Screw_AI_HX-SHCS 0.375-24x0.5x0.5-N x 2
Radial Ball Bearing_68_SKF_SKF - 61805 - 22,SI,NC,22_68
Basic Internal Retaining Ring_wti_Truarc N5000-145 - S1.456
