LudemannEngineering/Formula-1000-Race-Car/STEP/Suspension/FrontSuspension/PushRodF.STEP

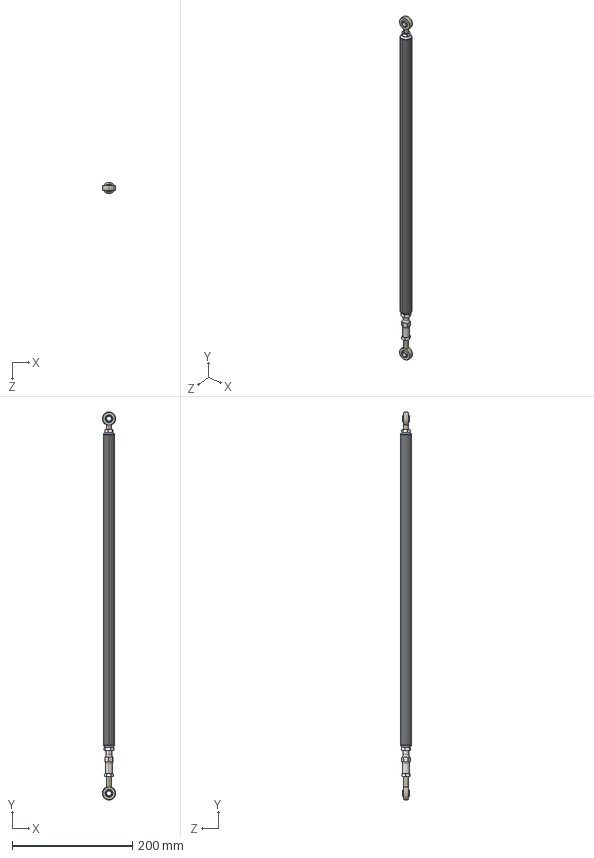
[picture p91: CAD file, 2019-01-26]
STEP/Suspension/FrontSuspension/PushRodF.STEP
22.2 x 645.9 x 19.1 mm
RodEndBall312 x 2
RodEndRace312Male x 2
RodEndAdjuster312
ControlArmEnd75-375
ControlArmEnd75-312
PushRodTubeF_No Fairing
Hex Jam Nut_AI_HJNUT 0.3125-24-D-N x 2
Hex Jam Nut_AI_HJNUT 0.375-24-D-N
