LudemannEngineering/Formula-1000-Race-Car/STEP/Suspension/SpringDamper.STEP

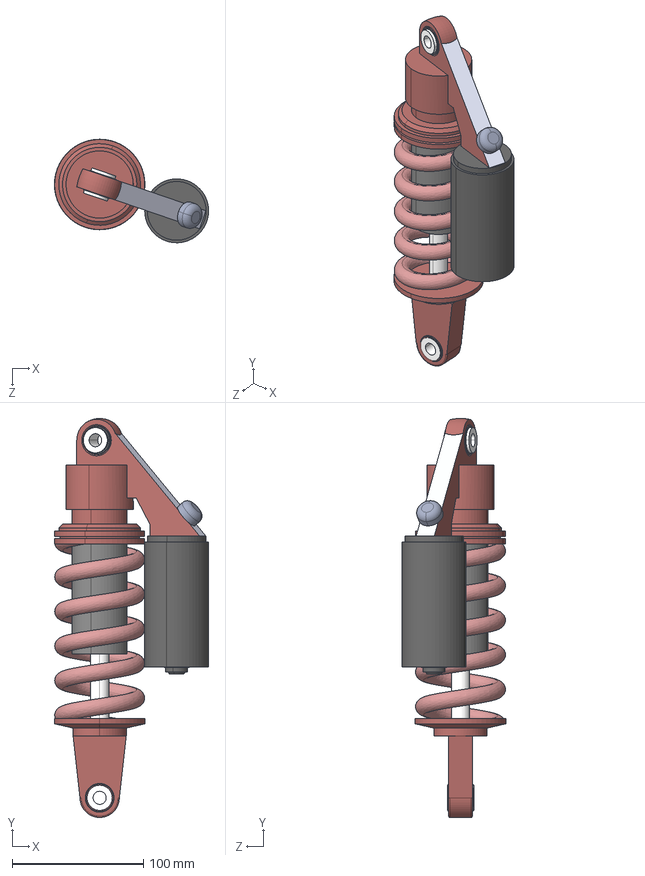
[picture p92: CAD file, 2019-01-26]
STEP/Suspension/SpringDamper.STEP
117.5 x 303.9 x 78.9 mm
ShockInner
Spring68x12_CompressedRear300lbs1000ppi
ShockOuter
