LudemannEngineering/Formula-1000-Race-Car/Drawings/Tubes/I-LLeftHorizMid.SLDPRT

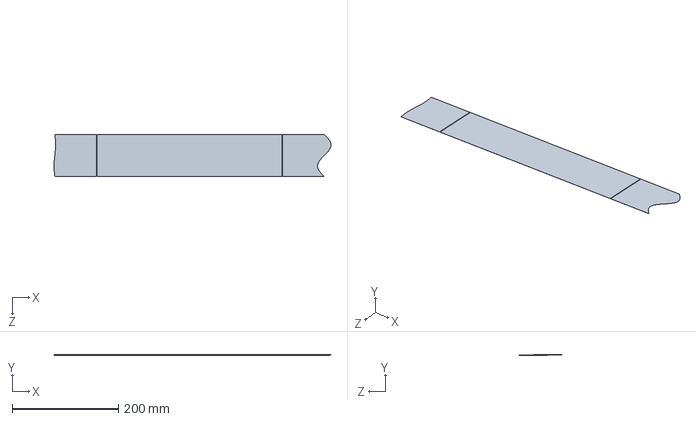
[picture p93: CAD file, 2019-01-21]
Drawings/Tubes/I-LLeftHorizMid.SLDPRT
521.5 x 0.415 x 79.4 mm
