LudemannEngineering/Formula-1000-Race-Car/Solidworks/Brakes/BrakeDiscWilwood160-3450.SLDPRT

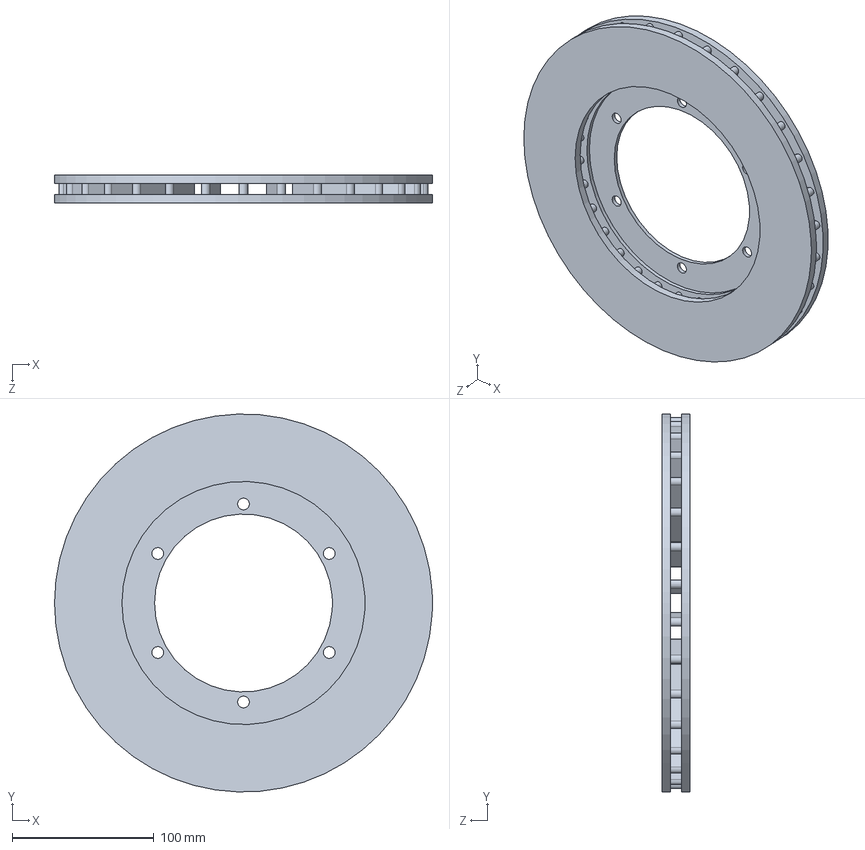
[picture p94: CAD file, 2019-01-26]
Solidworks/Brakes/BrakeDiscWilwood160-3450.SLDPRT
266.7 x 266.6 x 20.0 mm
