LudemannEngineering/Formula-1000-Race-Car/Solidworks/Chassis/BracketTieRodRear.SLDPRT

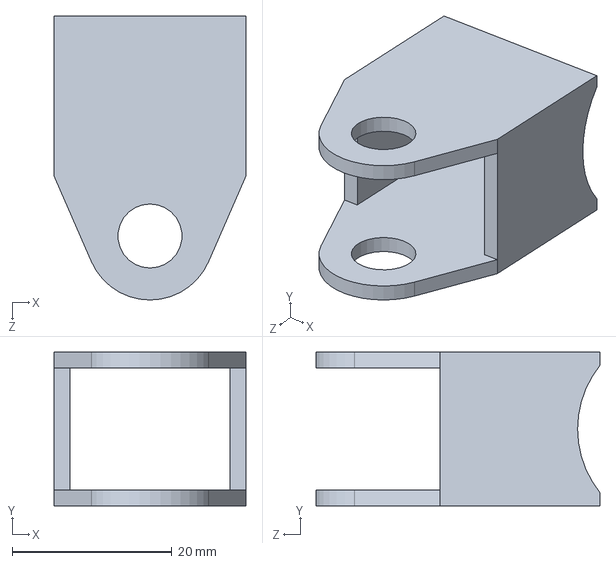
[picture p95: CAD file, 2019-01-26]
Solidworks/Chassis/BracketTieRodRear.SLDPRT
24.0 x 19.2 x 35.5 mm
