LudemannEngineering/Formula-1000-Race-Car/Solidworks/Chassis/RadiatorSetrab/BracketOilCoolerUF.SLDPRT

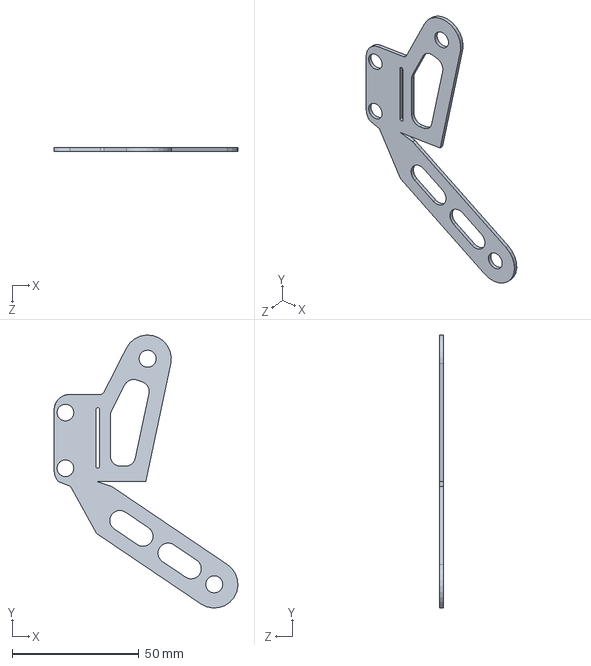
[picture p96: CAD file, 2019-01-26]
Solidworks/Chassis/RadiatorSetrab/BracketOilCoolerUF.SLDPRT
72.7 x 107.9 x 1.50 mm
