LudemannEngineering/Formula-1000-Race-Car/Solidworks/Cockpit/MountPedalMasterCyl.SLDPRT

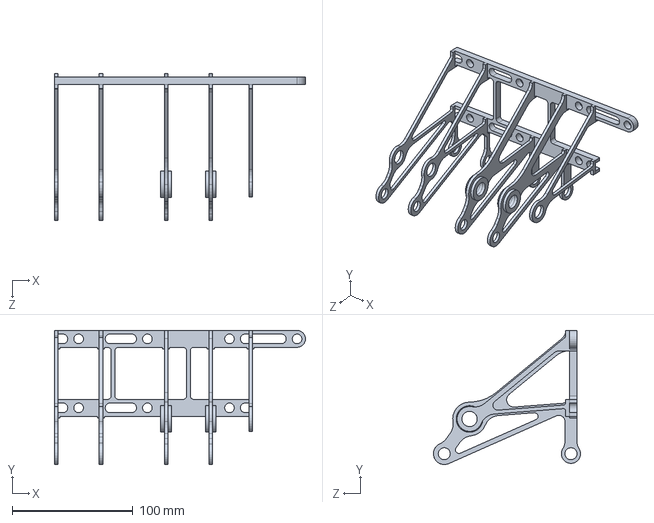
[picture p97: CAD file, 2019-01-26]
Solidworks/Cockpit/MountPedalMasterCyl.SLDPRT
208.0 x 111.1 x 122.0 mm
