LudemannEngineering/Formula-1000-Race-Car/Solidworks/Cockpit/PedalCluster/PedalClutchPin.SLDPRT

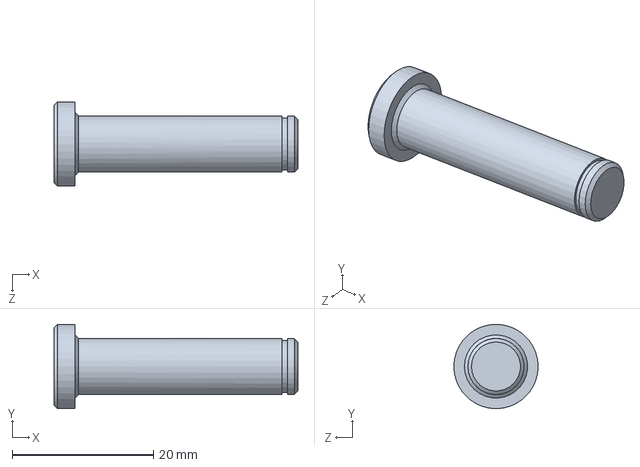
[picture p98: CAD file, 2019-01-26]
Solidworks/Cockpit/PedalCluster/PedalClutchPin.SLDPRT
34.5 x 11.9 x 11.9 mm
