LudemannEngineering/Formula-1000-Race-Car/Solidworks/Cockpit/Shifter/ShifterBush.SLDPRT

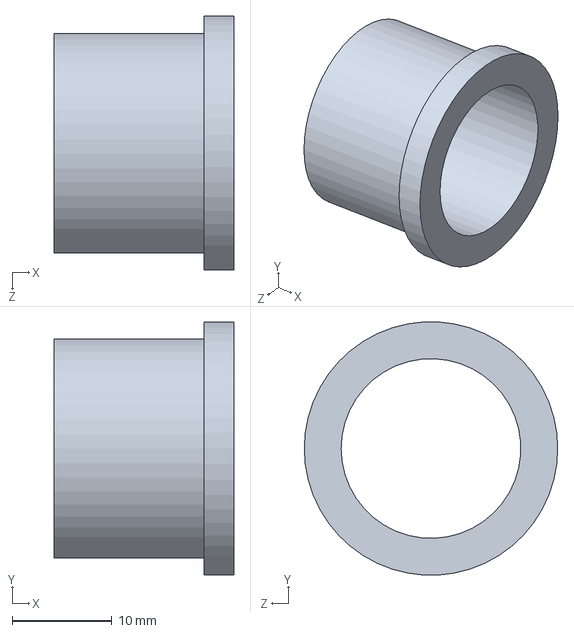
[picture p99: CAD file, 2019-01-21]
Solidworks/Cockpit/Shifter/ShifterBush.SLDPRT
18.0 x 25.3 x 25.4 mm
