LudemannEngineering/Formula-1000-Race-Car/Solidworks/Driver/ass 2.SLDPRT

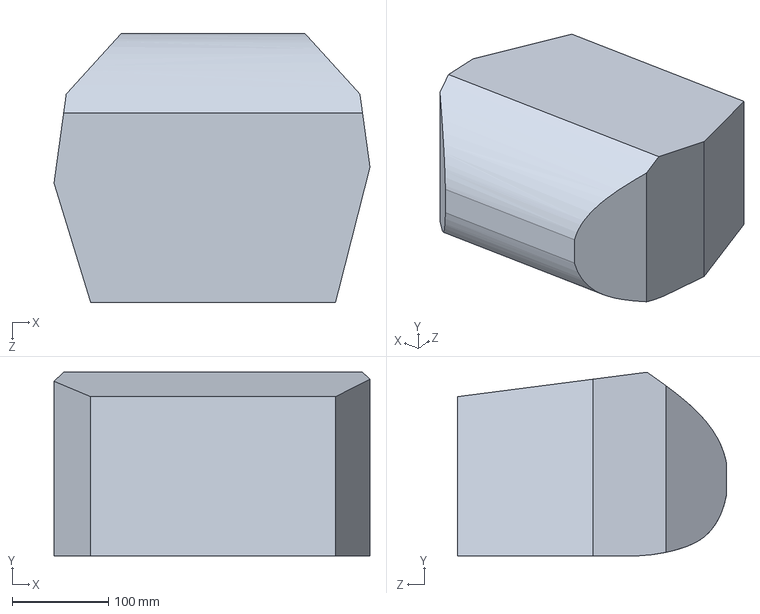
[picture p100: CAD file, 2019-01-26]
Solidworks/Driver/ass 2.SLDPRT
327.9 x 190.5 x 279.4 mm
