LudemannEngineering/Formula-1000-Race-Car/Solidworks/Drivetrain/DifferentialHonda.SLDPRT

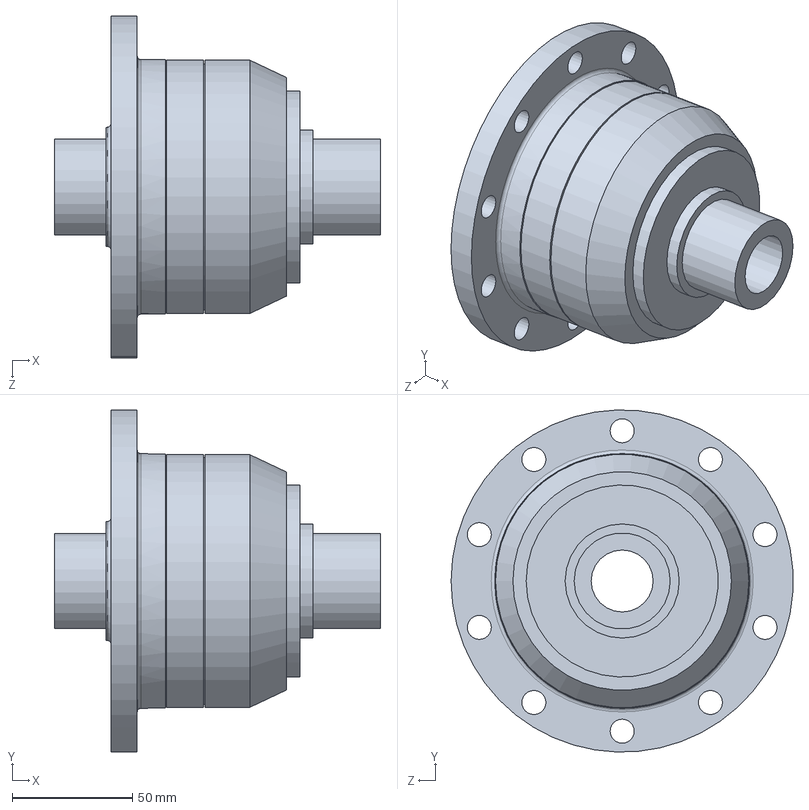
[picture p101: CAD file, 2019-01-26]
Solidworks/Drivetrain/DifferentialHonda.SLDPRT
135.8 x 142.3 x 142.3 mm
