LudemannEngineering/Formula-1000-Race-Car/Solidworks/Engine/2.SLDPRT

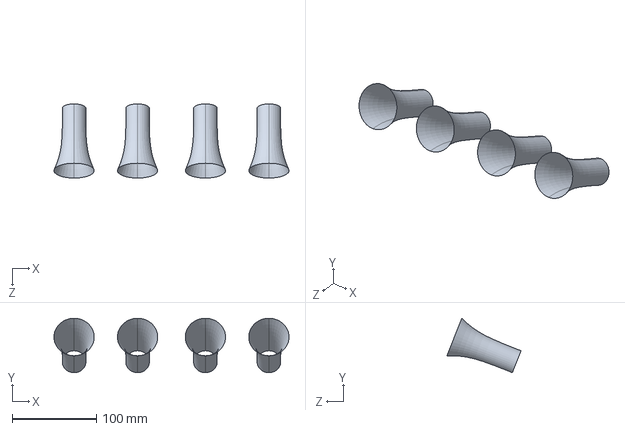
[picture p102: CAD file, 2019-01-26]
Solidworks/Engine/2.SLDPRT
278.2 x 64.5 x 87.8 mm
