LudemannEngineering/Formula-1000-Race-Car/Solidworks/Jigs/MainFrameJig/FrameTopRailJigs/JigTopRailFRight.SLDPRT

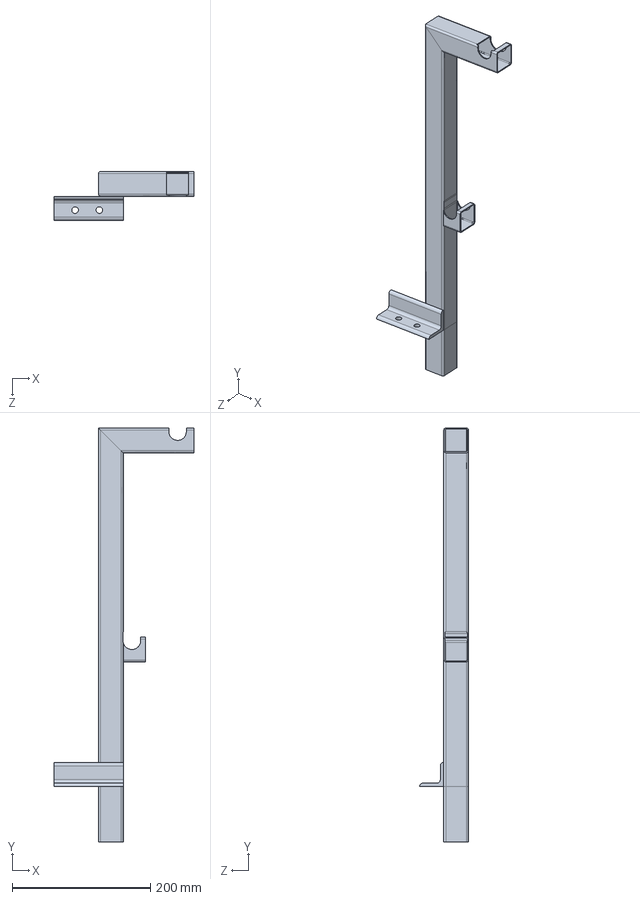
[picture p103: CAD file, 2019-01-21]
Solidworks/Jigs/MainFrameJig/FrameTopRailJigs/JigTopRailFRight.SLDPRT
202.1 x 597.9 x 70.8 mm
