LudemannEngineering/Formula-1000-Race-Car/Solidworks/Steering/U-JointWoodward.SLDPRT

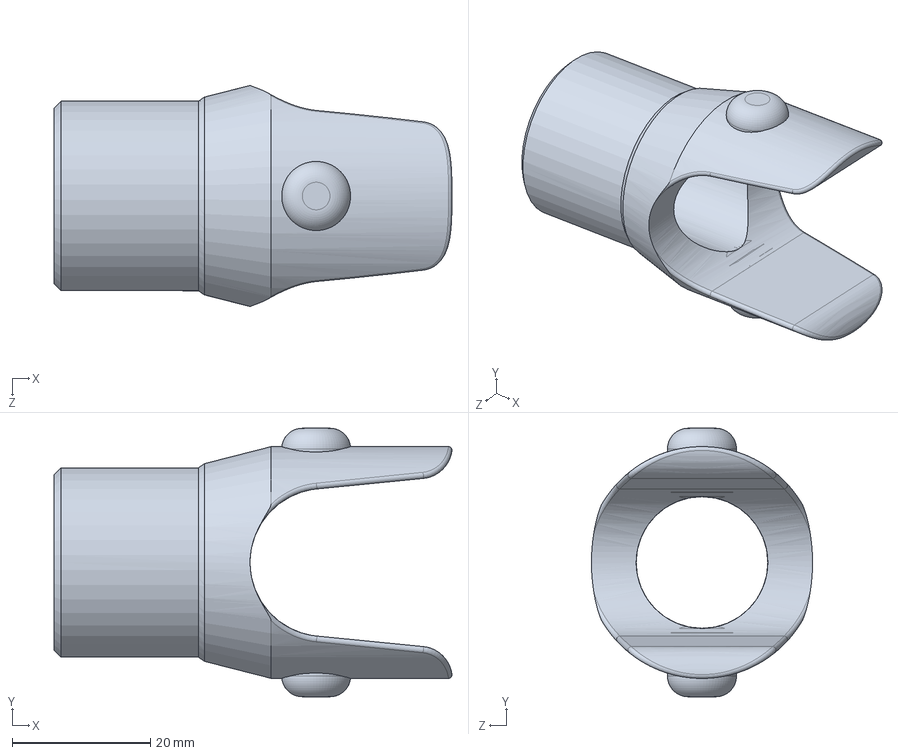
[picture p104: CAD file, 2019-01-26]
Solidworks/Steering/U-JointWoodward.SLDPRT
57.6 x 38.9 x 32.0 mm
