LudemannEngineering/Formula-1000-Race-Car/Solidworks/Suspension/FrontSuspension/Suspension/RockerArmShaft.SLDPRT

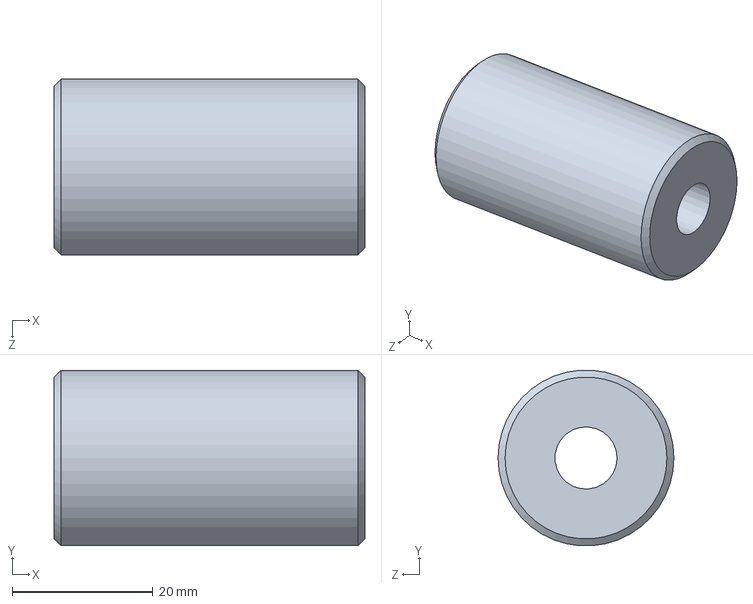
[picture p105: CAD file, 2019-01-21]
Solidworks/Suspension/FrontSuspension/Suspension/RockerArmShaft.SLDPRT
44.2 x 24.9 x 25.0 mm
