LudemannEngineering/Formula-1000-Race-Car/Solidworks/Suspension/RearSuspension/ControlArmLRLweldment.SLDPRT

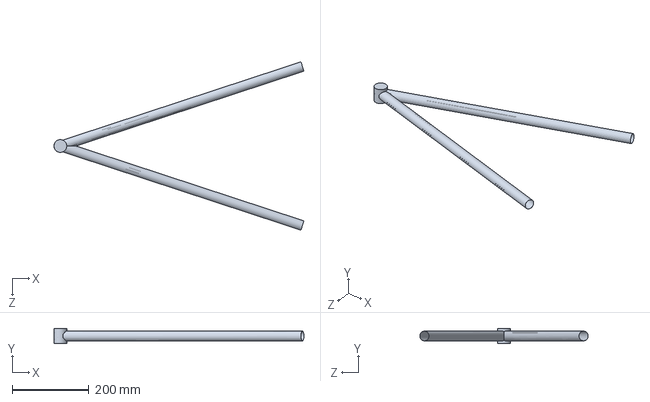
[picture p106: CAD file, 2019-01-21]
Solidworks/Suspension/RearSuspension/ControlArmLRLweldment.SLDPRT
652.6 x 40.0 x 439.3 mm
