LudemannEngineering/Formula-1000-Race-Car/Solidworks/Suspension/RodEndRace312Fem.SLDPRT

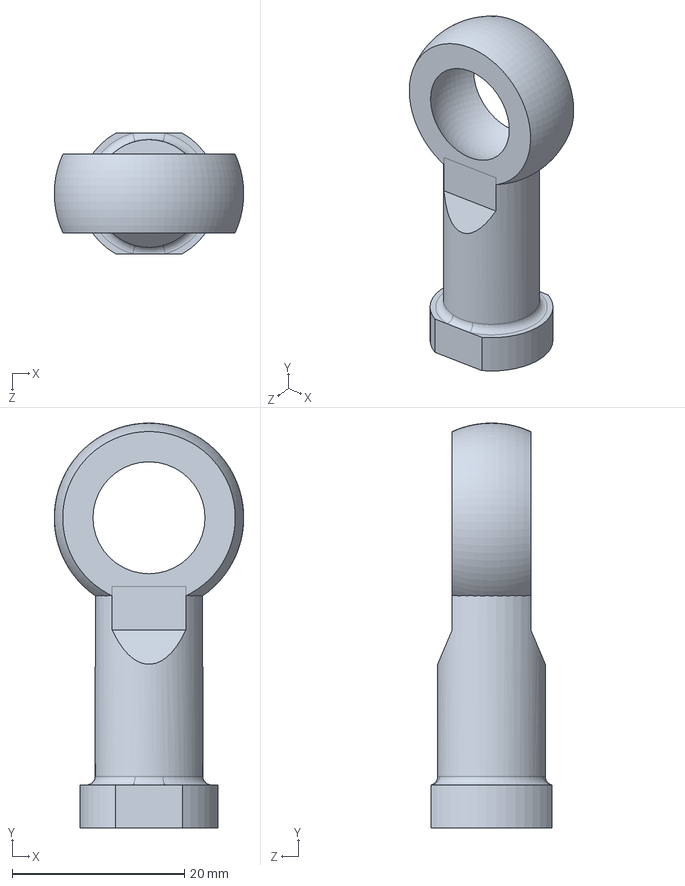
[picture p107: CAD file, 2019-01-26]
Solidworks/Suspension/RodEndRace312Fem.SLDPRT
22.0 x 47.0 x 14.0 mm
