LudemannEngineering/Formula-1000-Race-Car/Solidworks/Trailer/Tire.SLDPRT

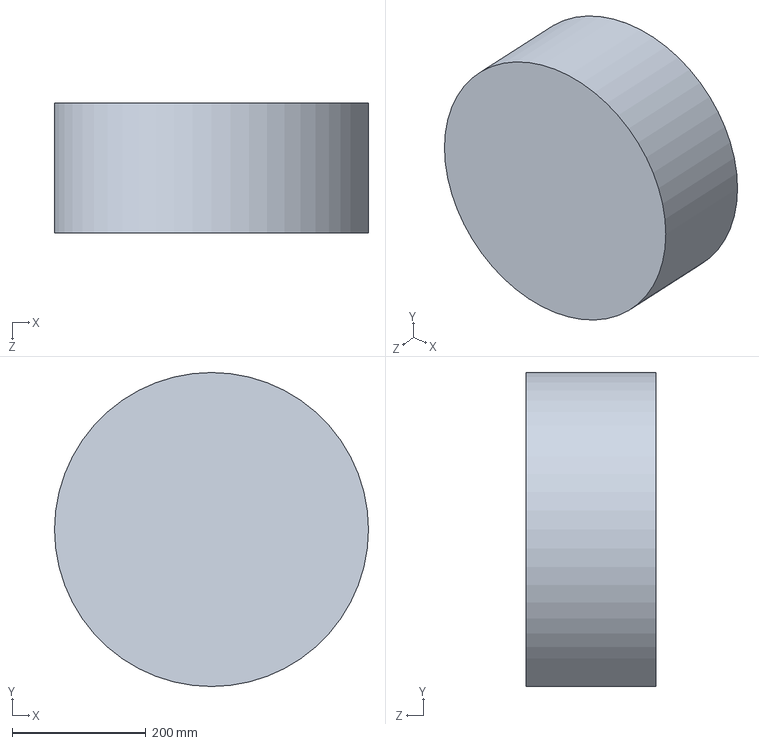
[picture p108: CAD file, 2019-01-21]
Solidworks/Trailer/Tire.SLDPRT
469.9 x 469.9 x 195.0 mm
