LudemannEngineering/Formula-1000-Race-Car/STEP/Cockpit/PedalCluster/PedalGas.STEP

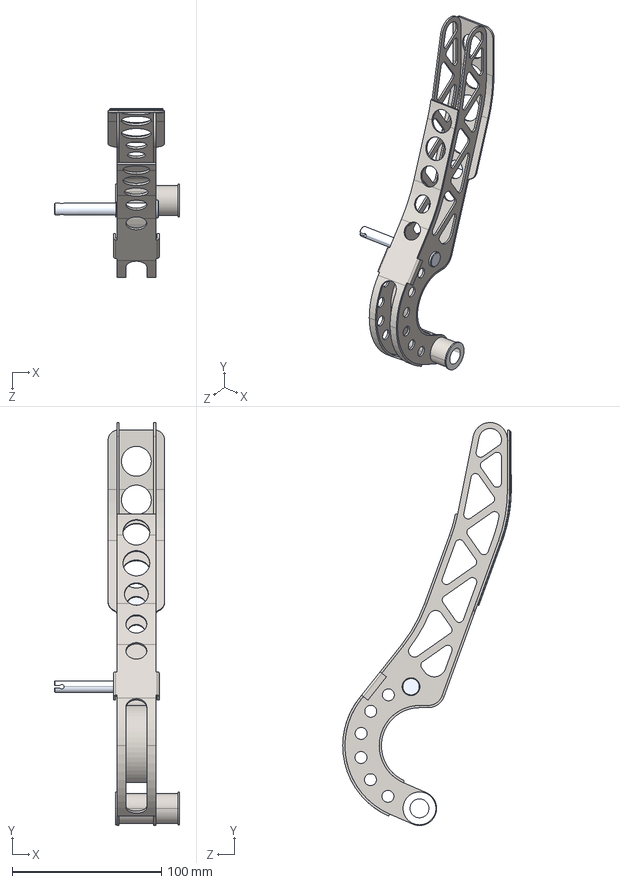
[picture p109: CAD file, 2019-01-26]
STEP/Cockpit/PedalCluster/PedalGas.STEP
84.0 x 270.3 x 113.1 mm
PedalBushing x 2
PedalGas4
PedalGasThrottlePull
PedalPadBrake
Basic External Retaining Ring_AI_B27.1 - NA1-31
