LudemannEngineering/Formula-1000-Race-Car/STEP/Drivetrain/ChainGuard1.STEP

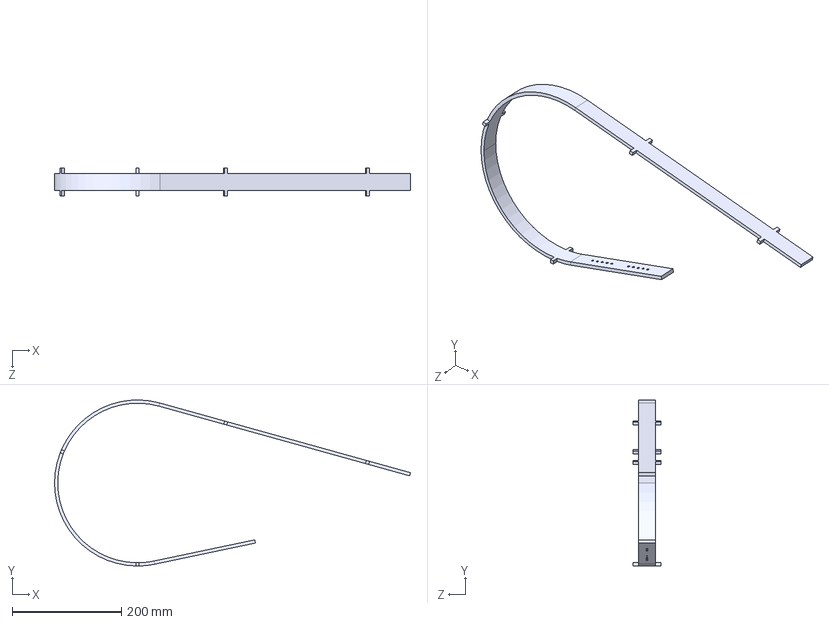
[picture p110: CAD file, 2019-01-26]
STEP/Drivetrain/ChainGuard1.STEP
653.1 x 304.5 x 50.8 mm
