LudemannEngineering/Formula-1000-Race-Car/STEP/Suspension/ControlArmLUpper.STEP

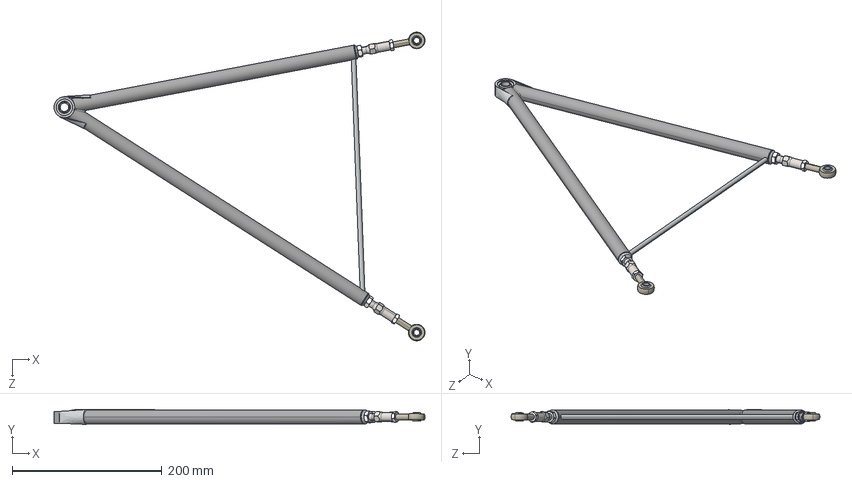
[picture p111: CAD file, 2019-01-26]
STEP/Suspension/ControlArmLUpper.STEP
495.4 x 19.9 x 412.2 mm
ControlArmLU_Finished Part, Left<As Machined>
ControlArmEnd75-375 x 2
RodEndAdjuster312 x 2
SphericalBearing437Race
SphericalBearing437Ball
RodEndBall312 x 2
RodEndRace312Male x 2
Hex Jam Nut_AI_HJNUT 0.375-24-D-N x 2
Hex Jam Nut_AI_HJNUT 0.3125-24-D-N x 2
Basic Internal Retaining Ring_am_B27.7M - 3BM1-24
