LudemannEngineering/Formula-1000-Race-Car/STEP/Suspension/RearSuspension/SuspensionRockerRear.STEP

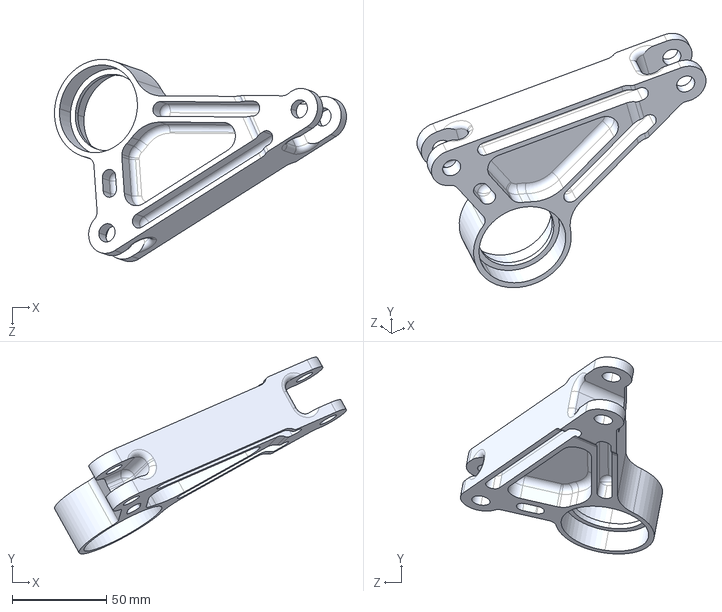
[picture p112: CAD file, 2019-01-26]
STEP/Suspension/RearSuspension/SuspensionRockerRear.STEP
154.5 x 104.2 x 107.0 mm
