LudemannEngineering/Formula-1000-Race-Car/Drawings/Tubes/H-ILeftDiagLower.SLDPRT

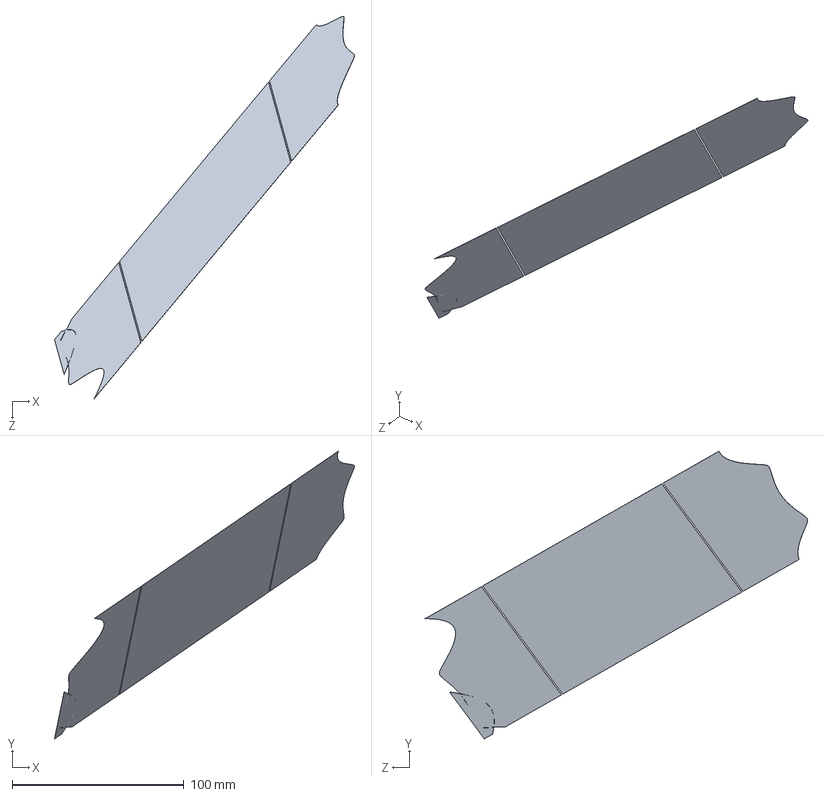
[picture p113: CAD file, 2019-01-21]
Drawings/Tubes/H-ILeftDiagLower.SLDPRT
174.6 x 167.4 x 222.5 mm
