LudemannEngineering/Formula-1000-Race-Car/Solidworks/Brakes/BrakeDiscWilwood160-10021.SLDPRT

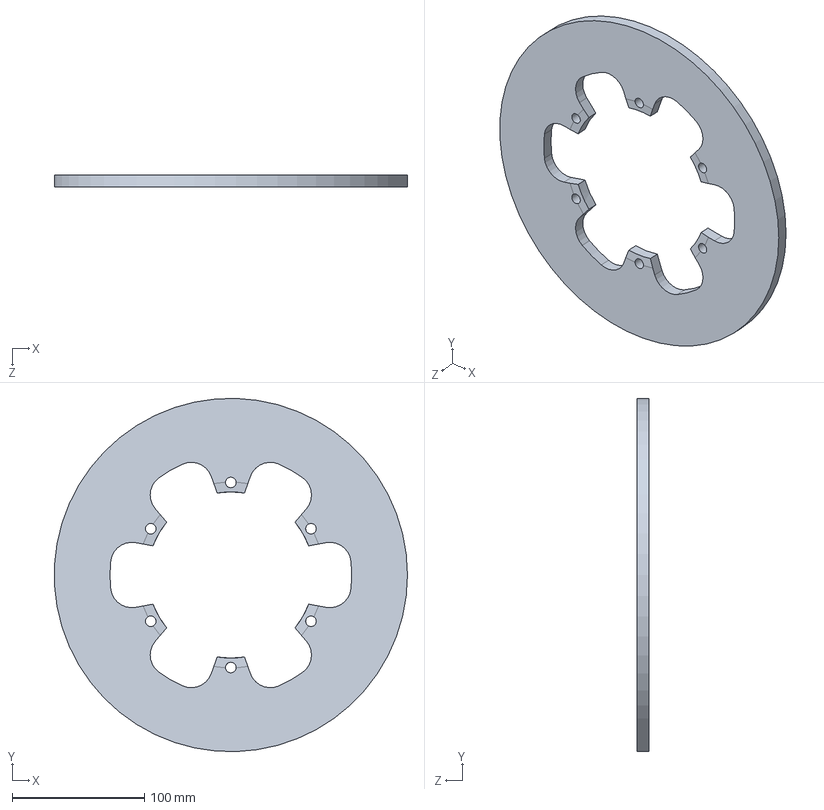
[picture p114: CAD file, 2019-01-26]
Solidworks/Brakes/BrakeDiscWilwood160-10021.SLDPRT
266.5 x 266.6 x 8.89 mm
