LudemannEngineering/Formula-1000-Race-Car/Solidworks/Chassis/RadiatorSetrab/RadiatorSides2.SLDPRT

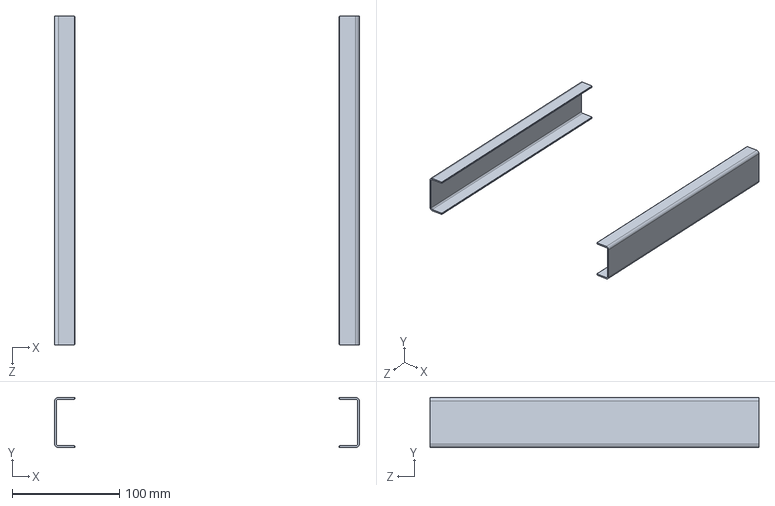
[picture p115: CAD file, 2019-01-26]
Solidworks/Chassis/RadiatorSetrab/RadiatorSides2.SLDPRT
284.0 x 46.8 x 306.0 mm
