LudemannEngineering/Formula-1000-Race-Car/Solidworks/Chassis/SuspensionRockerMountRightFrontLower.sldprt

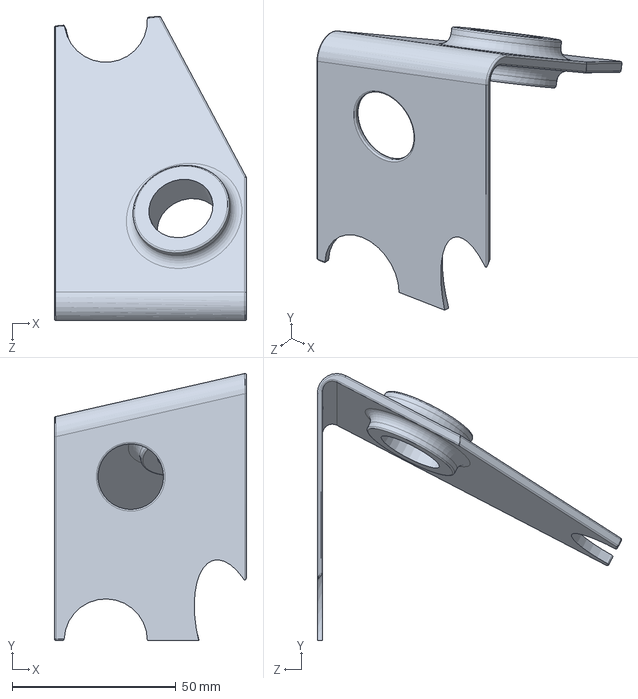
[picture p116: CAD file, 2019-01-26]
Solidworks/Chassis/SuspensionRockerMountRightFrontLower.sldprt
58.7 x 81.5 x 92.9 mm
