LudemannEngineering/Formula-1000-Race-Car/Solidworks/Cockpit/BracketSeatBeltLap.SLDPRT

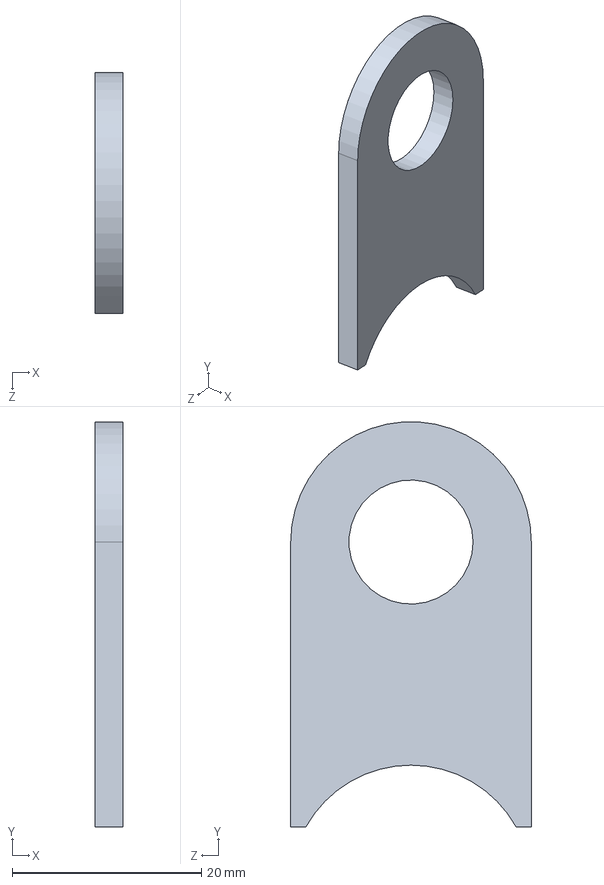
[picture p117: CAD file, 2019-01-26]
Solidworks/Cockpit/BracketSeatBeltLap.SLDPRT
3.00 x 42.7 x 25.4 mm
