LudemannEngineering/Formula-1000-Race-Car/Solidworks/Cockpit/PedalCluster/PedalPadBrake.sldprt

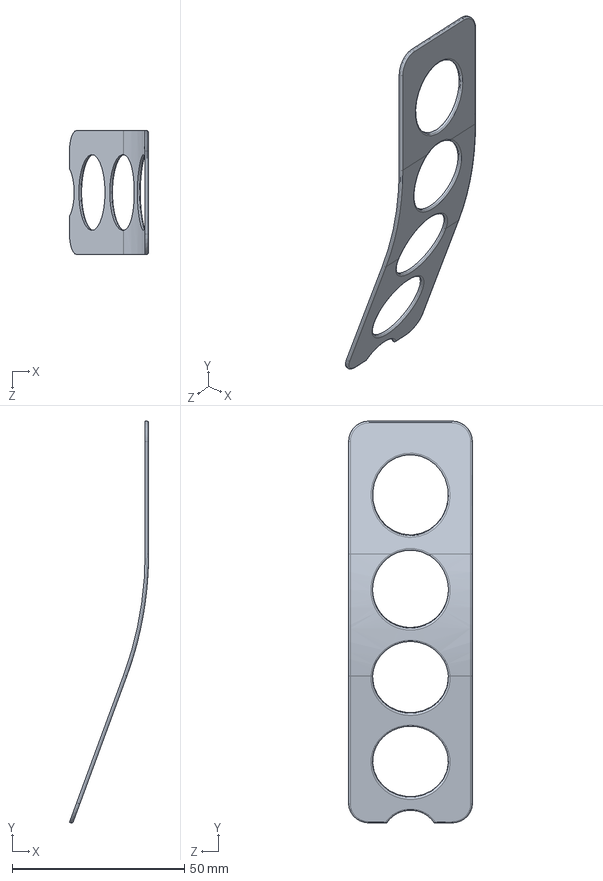
[picture p118: CAD file, 2019-01-26]
Solidworks/Cockpit/PedalCluster/PedalPadBrake.sldprt
23.0 x 116.8 x 36.0 mm
