LudemannEngineering/Formula-1000-Race-Car/Solidworks/Cockpit/Shifter/ShifterOuterLever.SLDPRT

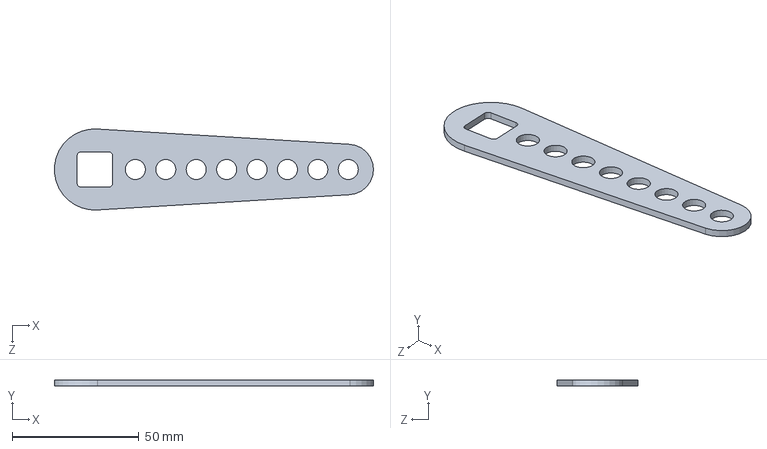
[picture p119: CAD file, 2019-01-21]
Solidworks/Cockpit/Shifter/ShifterOuterLever.SLDPRT
125.9 x 2.40 x 31.9 mm
