LudemannEngineering/Formula-1000-Race-Car/Solidworks/Driver/right_palm.SLDPRT

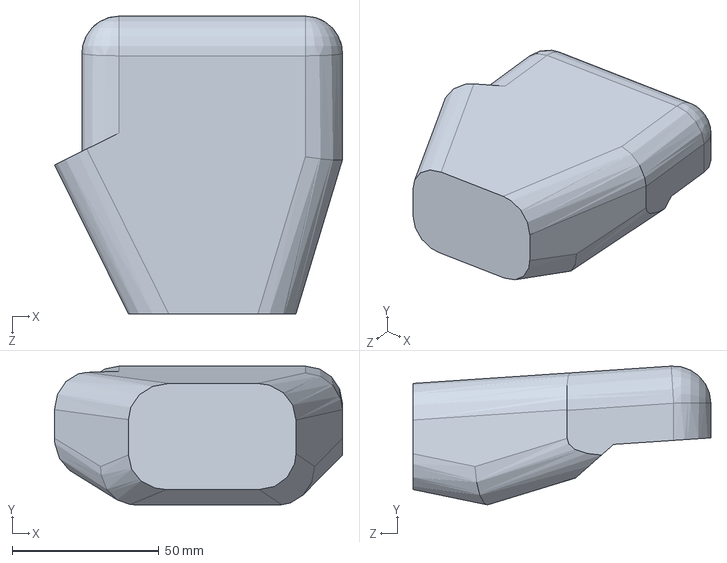
[picture p120: CAD file, 2019-01-26]
Solidworks/Driver/right_palm.SLDPRT
98.2 x 47.4 x 101.6 mm
