LudemannEngineering/Formula-1000-Race-Car/Solidworks/Drivetrain/BracketEngineMountRearLower.SLDPRT

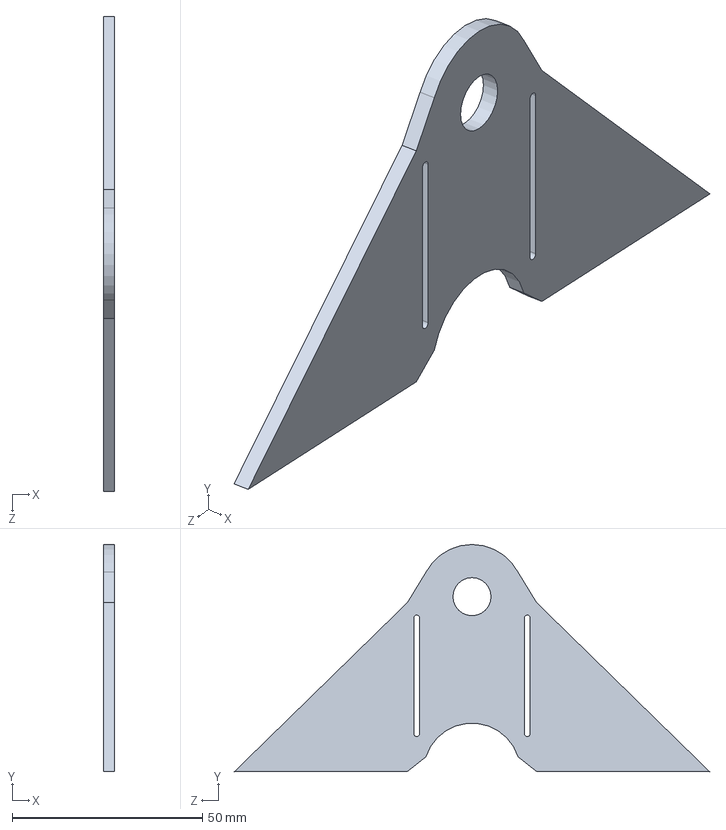
[picture p121: CAD file, 2019-01-26]
Solidworks/Drivetrain/BracketEngineMountRearLower.SLDPRT
3.00 x 59.6 x 124.7 mm
