LudemannEngineering/Formula-1000-Race-Car/Solidworks/Engine/Imported1.sldprt

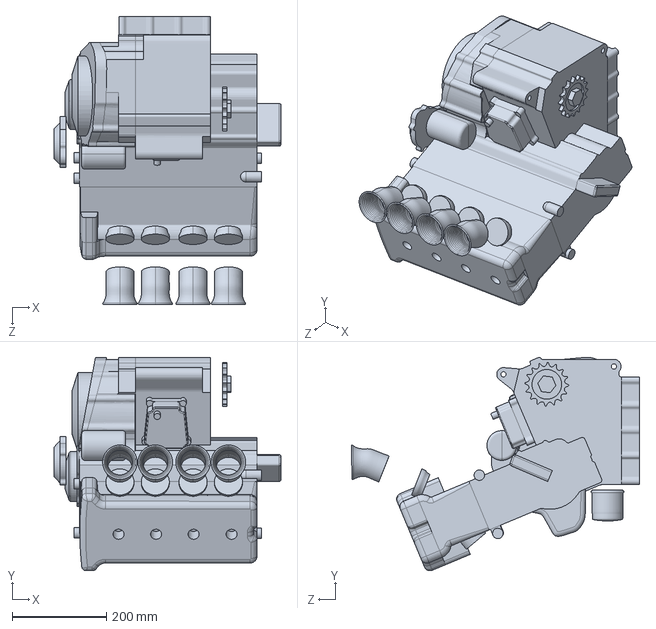
[picture p122: CAD file, 2019-01-26]
Solidworks/Engine/Imported1.sldprt
482.6 x 453.8 x 612.9 mm
