LudemannEngineering/Formula-1000-Race-Car/Solidworks/Steering/TubeSteering.75.SLDPRT

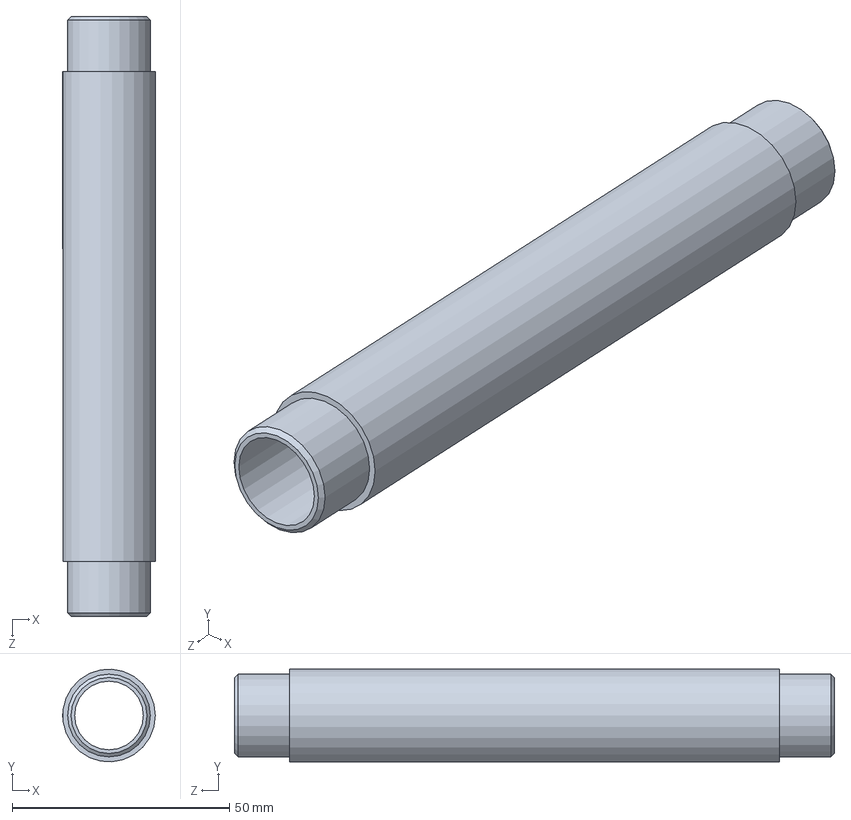
[picture p123: CAD file, 2019-01-26]
Solidworks/Steering/TubeSteering.75.SLDPRT
21.3 x 21.3 x 138.0 mm
