LudemannEngineering/Formula-1000-Race-Car/Solidworks/Suspension/RearSuspension/ShockXMember4.SLDPRT

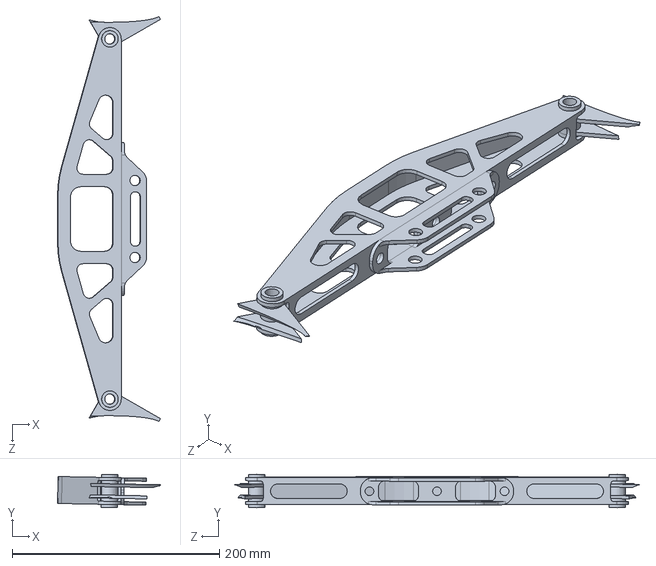
[picture p124: CAD file, 2019-01-21]
Solidworks/Suspension/RearSuspension/ShockXMember4.SLDPRT
99.3 x 32.3 x 390.5 mm
