LudemannEngineering/Formula-1000-Race-Car/Solidworks/Suspension/RodEndRace312Male.SLDPRT

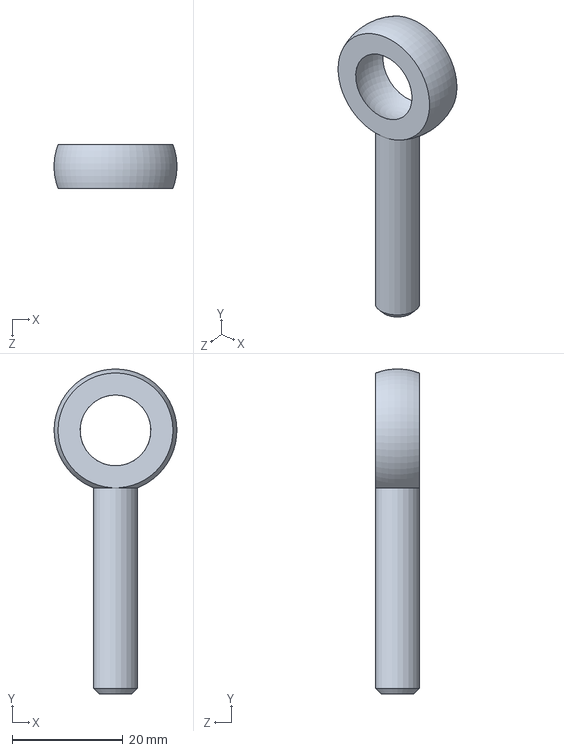
[picture p125: CAD file, 2019-01-26]
Solidworks/Suspension/RodEndRace312Male.SLDPRT
22.2 x 58.7 x 7.94 mm
