LudemannEngineering/Formula-1000-Race-Car/Solidworks/Tools/GantryMachineShop.SLDPRT

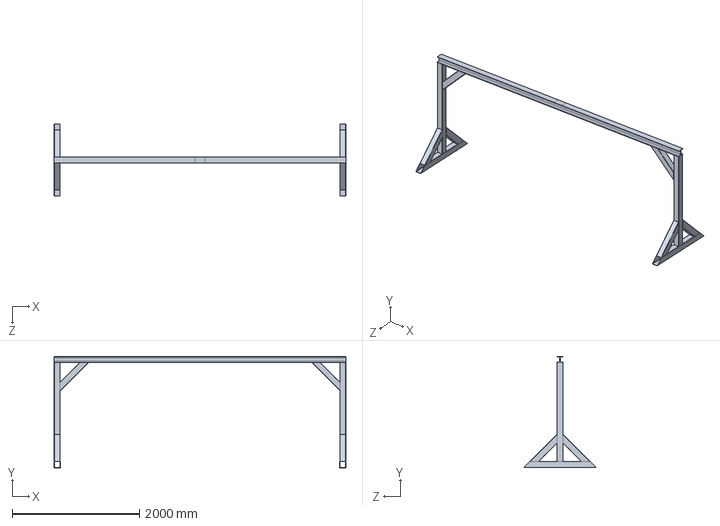
[picture p126: CAD file, 2019-01-21]
Solidworks/Tools/GantryMachineShop.SLDPRT
4597.4 x 1752.6 x 1141.4 mm
