LudemannEngineering/Formula-1000-Race-Car/STEP/Suspension/RearSuspension/PushRodRear.STEP

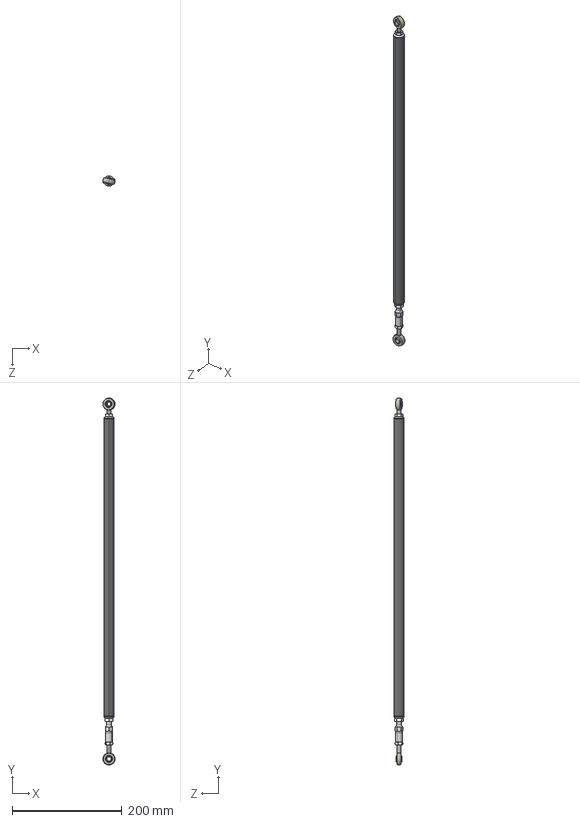
[picture p127: CAD file, 2019-01-26]
STEP/Suspension/RearSuspension/PushRodRear.STEP
22.2 x 670.2 x 19.1 mm
ControlArmEnd75-375
PushRodTubeRear_No Fairing
ControlArmEnd75-312
RodEndAdjuster312
RodEndBall312 x 2
RodEndRace312Male x 2
Hex Jam Nut_AI_HJNUT 0.3125-24-D-N x 2
Hex Jam Nut_AI_HJNUT 0.3750-24-D-N
