LudemannEngineering/Formula-1000-Race-Car/Solidworks/Brakes/CaliperWilwood120-6816.SLDPRT

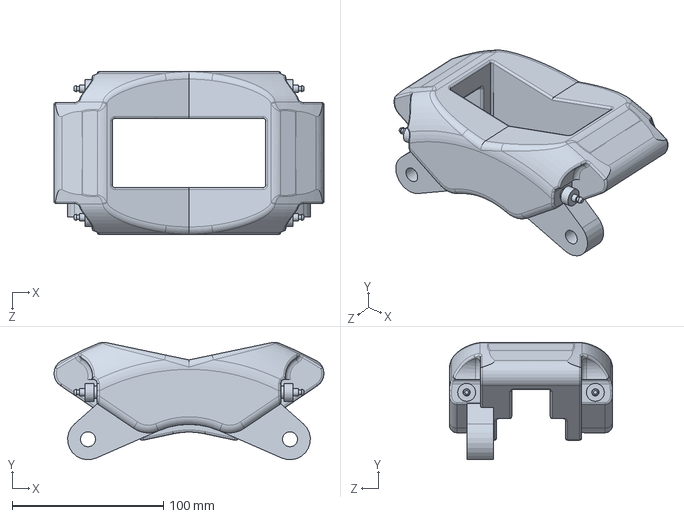
[picture p128: CAD file, 2019-01-26]
Solidworks/Brakes/CaliperWilwood120-6816.SLDPRT
178.3 x 77.5 x 107.8 mm
