LudemannEngineering/Formula-1000-Race-Car/Solidworks/Chassis/BracketIdlerSprocket2.SLDPRT

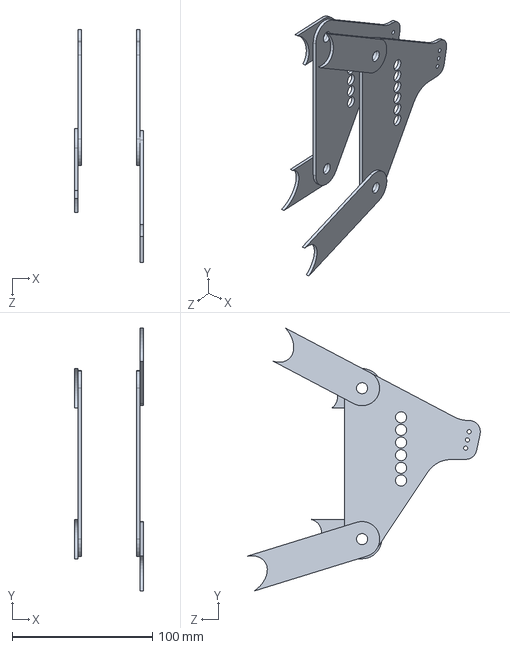
[picture p129: CAD file, 2019-01-26]
Solidworks/Chassis/BracketIdlerSprocket2.SLDPRT
48.8 x 187.3 x 165.8 mm
