LudemannEngineering/Formula-1000-Race-Car/Solidworks/Chassis/Radiator/01-520-0001.7.sldprt

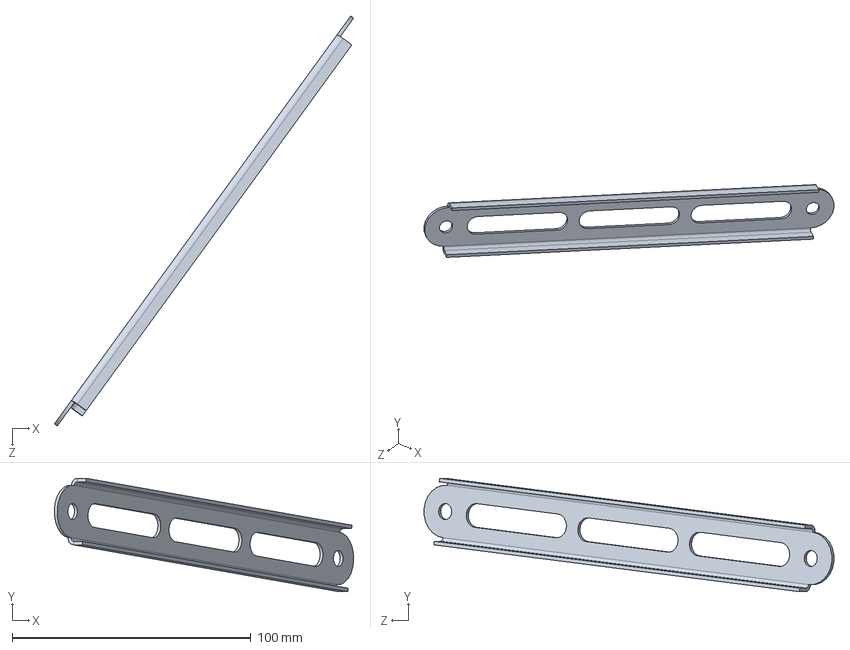
[picture p130: CAD file, 2019-01-26]
Solidworks/Chassis/Radiator/01-520-0001.7.sldprt
125.3 x 47.5 x 171.6 mm
