LudemannEngineering/Formula-1000-Race-Car/(list of files, cad)

Other CAD files:
Solidworks/Jigs/MainFrameJig/MainJigCrossRailE.SLDPRT
Solidworks/Jigs/MainFrameJig/MainJigCrossRailG.SLDPRT
Solidworks/Jigs/MainFrameJig/MainJigCrossRailF.SLDPRT
Solidworks/Jigs/MainFrameJig/MainJigCrossRailA.SLDPRT
Solidworks/Jigs/MainFrameJig/MainJigCrossRailD.SLDPRT
Solidworks/Jigs/MainFrameJig/MainJigLongRailLeft.SLDPRT
Solidworks/Drivetrain/MainJigCrossRailG.SLDPRT
Solidworks/Jigs/MainFrameJig/MainJigCrossRail.SLDPRT
Solidworks/Drivetrain/MainJigCrossRailC.SLDPRT
Solidworks/Jigs/MainFrameJig/MainJigCrossRailL.SLDPRT
Solidworks/Drivetrain/MainJigCrossRailE.SLDPRT
Solidworks/Drivetrain/MainJigCrossRailF.SLDPRT
Solidworks/Drivetrain/MainJigCrossRailL.SLDPRT
Solidworks/Drivetrain/MainJigCrossRailD.SLDPRT
Solidworks/Drivetrain/MainJigCrossRailH.SLDPRT
Solidworks/Suspension/BearingSpherical625.SLDASM
Drawings/Tools/Rulers.SLDPRT
Solidworks/Chassis/Radiator/01-520-0001.6.sldprt
Solidworks/Chassis/Radiator/01-520-0001.1.sldprt
Solidworks/Chassis/Radiator/01-520-0001.9.sldprt
Solidworks/Chassis/Radiator/01-520-0001.2.sldprt
Solidworks/Jigs/MainFrameJig/FrameTopRailJigs/JigTopRailFLeft.SLDPRT
Drawings/Tubes/H-IRightDiagUpper.SLDPRT
Drawings/Jigs/ChassisJig.SLDDRW
Drawings/Jigs/JigsTopRail.SLDDRW
Drawings/Jigs/MainJig.SLDDRW
Drawings/Tubes/A-CLDiag.SLDPRT
Drawings/Tubes/A-CRDiag.SLDPRT
Drawings/Tubes/ACH1.SLDPRT
Drawings/Tubes/ACH2.SLDPRT
Drawings/Tubes/ALV.SLDPRT
Drawings/Tubes/ARV.SLDPRT
Drawings/Tubes/C-DCtrLeftDiag.SLDPRT
Drawings/Tubes/C-DCtrRightDiag.SLDPRT
Drawings/Tubes/C-DLDiag.SLDPRT
Drawings/Tubes/C-DRDiag.SLDPRT
Drawings/Tubes/CCH1.SLDPRT
Drawings/Tubes/CCH2.SLDPRT
Drawings/Tubes/CLV.SLDPRT
Drawings/Tubes/CRV.SLDPRT
Drawings/Tubes/D-ECtrLeftDiag.SLDPRT
Drawings/Tubes/D-ECtrRightDiag.SLDPRT
Drawings/Tubes/D-ELeftDiag.SLDPRT
Drawings/Tubes/DCtrVert.SLDPRT
Drawings/Tubes/DLV.SLDPRT
Drawings/Tubes/E-FLeftDiagLower.SLDPRT
Drawings/Tubes/E-FLeftDiagUpper.SLDPRT
Drawings/Tubes/E-FLeftHorizBottom.SLDPRT
Drawings/Tubes/E-FLeftHorizMid.SLDPRT
Drawings/Tubes/E-FRightDiagLower.SLDPRT
Drawings/Tubes/E-FRightDiagUpper.SLDPRT
Drawings/Tubes/E-FRightHorizBottom.SLDPRT
Drawings/Tubes/E-FRightHorizMid.SLDPRT
Drawings/Tubes/ECtrHoriz.SLDPRT
Drawings/Tubes/ELeftVert.SLDPRT
Drawings/Tubes/F-GCenterDiagBottomLF-RR.SLDPRT
Drawings/Tubes/F-GCenterDiagBottomRF-LR_Front.SLDPRT
Drawings/Tubes/F-GCenterDiagBottomRF-LR_Rear.SLDPRT
Drawings/Tubes/F-GLeftDiagLower.SLDPRT
Drawings/Tubes/F-GLeftDiagUpperFront.SLDPRT
Drawings/Tubes/F-GLeftDiagUpperRear.SLDPRT
Drawings/Tubes/F-GLeftHorizBottom.SLDPRT
Drawings/Tubes/F-GLeftHorizMid.SLDPRT
Drawings/Tubes/F-GLeftRollHoopBrace.SLDPRT
Drawings/Tubes/F-GLeftRollHoopBraceProfLwr.DXF
Drawings/Tubes/F-GLeftRollHoopBraceProfUp.DXF
Drawings/Tubes/F-GRightDiagLower.SLDPRT
Drawings/Tubes/F-GRightDiagUpperFront.SLDPRT
Drawings/Tubes/F-GRightDiagUpperRear.SLDPRT
Drawings/Tubes/F-GRightHorizBottom.SLDPRT
Drawings/Tubes/F-GRightHorizMid.SLDPRT
Drawings/Tubes/FCenterHorizBottom.SLDPRT
Drawings/Tubes/FLeftVerticalLower.SLDPRT
Drawings/Tubes/FLeftVerticalUpper.SLDPRT
Drawings/Tubes/FRightVerticalLower.SLDPRT
Drawings/Tubes/FRightVerticalUpper.SLDPRT
Drawings/Tubes/G-HLeftDiagLower.SLDPRT
Drawings/Tubes/G-HLeftDiagUpper.SLDPRT
Drawings/Tubes/G-HLeftDiagUpperF.SLDPRT
Drawings/Tubes/G-HLeftDiagUpperR.SLDPRT
Drawings/Tubes/G-HLeftHorizBottom.SLDPRT
Drawings/Tubes/G-HLeftHorizMid.SLDPRT
Drawings/Tubes/G-HRightDiagLower.SLDPRT
Drawings/Tubes/G-HRightHorizBottom.SLDPRT
Drawings/Tubes/G-HRightHorizMid.SLDPRT
Drawings/Tubes/G-LLeftTopRailFront.SLDPRT
Drawings/Tubes/G-LLeftTopRailRear.SLDPRT
Drawings/Tubes/GCenterHorizBottom.SLDPRT
Drawings/Tubes/GCenterHorizMid.SLDPRT
Drawings/Tubes/GCenterHorizTop.SLDPRT
Drawings/Tubes/GCenterVert.SLDPRT
Drawings/Tubes/GDiagLower.SLDPRT
Drawings/Tubes/H-ILeftHorizMid.SLDPRT
Drawings/Tubes/H-IRightDiagLower.SLDPRT
Drawings/Tubes/H-IRightHorizMid.SLDPRT
Drawings/Tubes/H-JLeftBottom.SLDPRT
Drawings/Tubes/H-JLeftDiagInner.SLDPRT
Drawings/Tubes/H-JLeftDiagLower.SLDPRT
Drawings/Tubes/H-JLeftDiagUpper.SLDPRT
Drawings/Tubes/H-JRightBottom.SLDPRT
Drawings/Tubes/H-JRightDiagLower.SLDPRT
Drawings/Tubes/H-JRightDiagUpper.SLDPRT
Drawings/Tubes/HCenterHorizBottom.SLDPRT
Drawings/Tubes/HLeftVertLower.SLDPRT
Drawings/Tubes/HLeftVertUpper.SLDPRT
Drawings/Tubes/HRightVertLower.SLDPRT
Drawings/Tubes/I-KCenterHorizBottom.SLDPRT
Drawings/Tubes/I-LRightHorizMid.SLDPRT
Drawings/Tubes/J-LLeftDiag.SLDPRT
Drawings/Tubes/J-LLeftHorizDiagMid.SLDPRT
Drawings/Tubes/J-LRightDiag.SLDPRT
Drawings/Tubes/J-LRightDiagBottom.SLDPRT
Drawings/Tubes/J-LRightHorizDiagMid.SLDPRT
Drawings/Tubes/JCenterDiagLowerLeft.SLDPRT
Drawings/Tubes/JCenterDiagUL-LR.SLDPRT
Drawings/Tubes/JCenterDiagUpperRight.SLDPRT
Drawings/Tubes/JCenterHorizBottom.SLDPRT
Drawings/Tubes/JCenterHorizCurved.SLDPRT
Drawings/Tubes/JCenterHorizCurvedEndLeft.SLDPRT
Drawings/Tubes/JCenterHorizMid.SLDPRT
Drawings/Tubes/JLeftVertLower.SLDPRT
Drawings/Tubes/JLeftVertUpper.SLDPRT
Drawings/Tubes/JRightVertLower.SLDPRT
Drawings/Tubes/L1H.SLDPRT
Drawings/Tubes/LCenterHorizMid.SLDPRT
Drawings/Tubes/LLeftDiag.SLDPRT
Drawings/Tubes/LRightDiag.SLDPRT
Drawings/Tubes/SeatBottomDiagLF.SLDPRT
Drawings/Tubes/SeatBottomDiagRR.SLDPRT
STEP/Suspension/Tierod.STEP
Solidworks/Body/WingFrontZ.SLDPRT
Solidworks/Body/WingRearX.SLDPRT
Solidworks/Brakes/01-301-0001.SLDDRW
Solidworks/Brakes/01-301-0002.SLDDRW
Solidworks/Brakes/01-302-0001.SLDDRW
Solidworks/Brakes/01-302-0002.SLDDRW
Solidworks/Brakes/01-311-0001.SLDDRW
Solidworks/Brakes/01-312-0001.SLDDRW
Solidworks/Brakes/01-320-0001.SLDDRW
Solidworks/Brakes/MasterCylinderTilton75Remote.SLDPRT
Solidworks/Brakes/StudDiscMntRear.SLDPRT
Solidworks/Chassis/01-100-0001.SLDDRW
Solidworks/Chassis/01-100-0006.SLDDRW
Solidworks/Chassis/01-101-0002.SLDDRW
Solidworks/Chassis/01-101-0003.SLDDRW
Solidworks/Chassis/01-101-0004.SLDDRW
Solidworks/Chassis/01-101-0005.SLDDRW
Solidworks/Chassis/01-101-0006.SLDDRW
Solidworks/Chassis/01-101-0007.SLDDRW
Solidworks/Chassis/01-101-0008.SLDDRW
Solidworks/Chassis/01-101-0009.SLDDRW
Solidworks/Chassis/01-102-0003.SLDDRW
Solidworks/Chassis/01-102-0005.SLDDRW
Solidworks/Chassis/01-102-0006.SLDDRW
Solidworks/Chassis/01-102-0007.SLDDRW
Solidworks/Chassis/01-102-0009.SLDDRW
Solidworks/Chassis/01-102-0010.SLDDRW
Solidworks/Chassis/01-102-0011.SLDDRW
Solidworks/Chassis/01-102-0012.SLDDRW
Solidworks/Chassis/01-102-0013.SLDDRW
Solidworks/Chassis/01-102-0014.SLDDRW
Solidworks/Chassis/01-110-0001.SLDDRW
Solidworks/Chassis/01-110-0002.SLDDRW
Solidworks/Chassis/01-110-0003.SLDDRW
Solidworks/Chassis/01-120-0001.SLDDRW
Solidworks/Chassis/01-120-0002.SLDDRW
Solidworks/Chassis/01-120-0003.SLDDRW
Solidworks/Chassis/01-120-0005.SLDDRW
Solidworks/Chassis/01-130-0000.SLDDRW
Solidworks/Chassis/01-130-0008.SLDDRW
Solidworks/Chassis/01-130-0009.SLDDRW
Solidworks/Chassis/01-130-0010.SLDDRW
Solidworks/Chassis/01-140-0000.SLDDRW
Solidworks/Chassis/01-140-0001.SLDDRW
Solidworks/Chassis/01-140-0002.SLDDRW
Solidworks/Chassis/01-140-0003.SLDDRW
Solidworks/Chassis/01-140-0004.SLDDRW
Solidworks/Chassis/01-200-0007.SLDDRW
Solidworks/Chassis/01-501-0003.SLDDRW
Solidworks/Chassis/ARB_HandleMountLeft.SLDPRT
Solidworks/Chassis/ARB_HandleMountRight.SLDPRT
Solidworks/Chassis/ARB_LinkageMountFront.SLDPRT
Solidworks/Chassis/AarmMountInner.SLDDRW
Solidworks/Chassis/BracketAArmFU.SLDPRT
Solidworks/Chassis/BracketARB_RearLeft.SLDPRT
Solidworks/Chassis/BracketARB_RearRight.SLDPRT
Solidworks/Chassis/BracketChainGuard2.SLDPRT
Solidworks/Chassis/BracketDifferential36mm.SLDPRT
Solidworks/Chassis/BracketFloor.SLDPRT
Solidworks/Chassis/BracketFuelPump.SLDPRT
Solidworks/Chassis/BracketNoseMount.SLDPRT
Solidworks/Chassis/BracketPedalMountBushing.SLDPRT
Solidworks/Chassis/BracketRideHeight.SLDDRW
Solidworks/Chassis/BracketShockMntF.SLDDRW
Solidworks/Chassis/BracketShockMntF7.SLDPRT
Solidworks/Chassis/BracketSteeringColumnBearing2.SLDPRT
Solidworks/Chassis/BracketSteeringColumnBearing3.SLDPRT
Solidworks/Chassis/BracketSuspClevRU.SLDPRT
Solidworks/Chassis/FootOutline.SLDPRT
Solidworks/Chassis/FrameA0.SLDDRW
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
