LudemannEngineering/Formula-1000-Race-Car/Drawings/Jigs/ChassisJig1.PDF

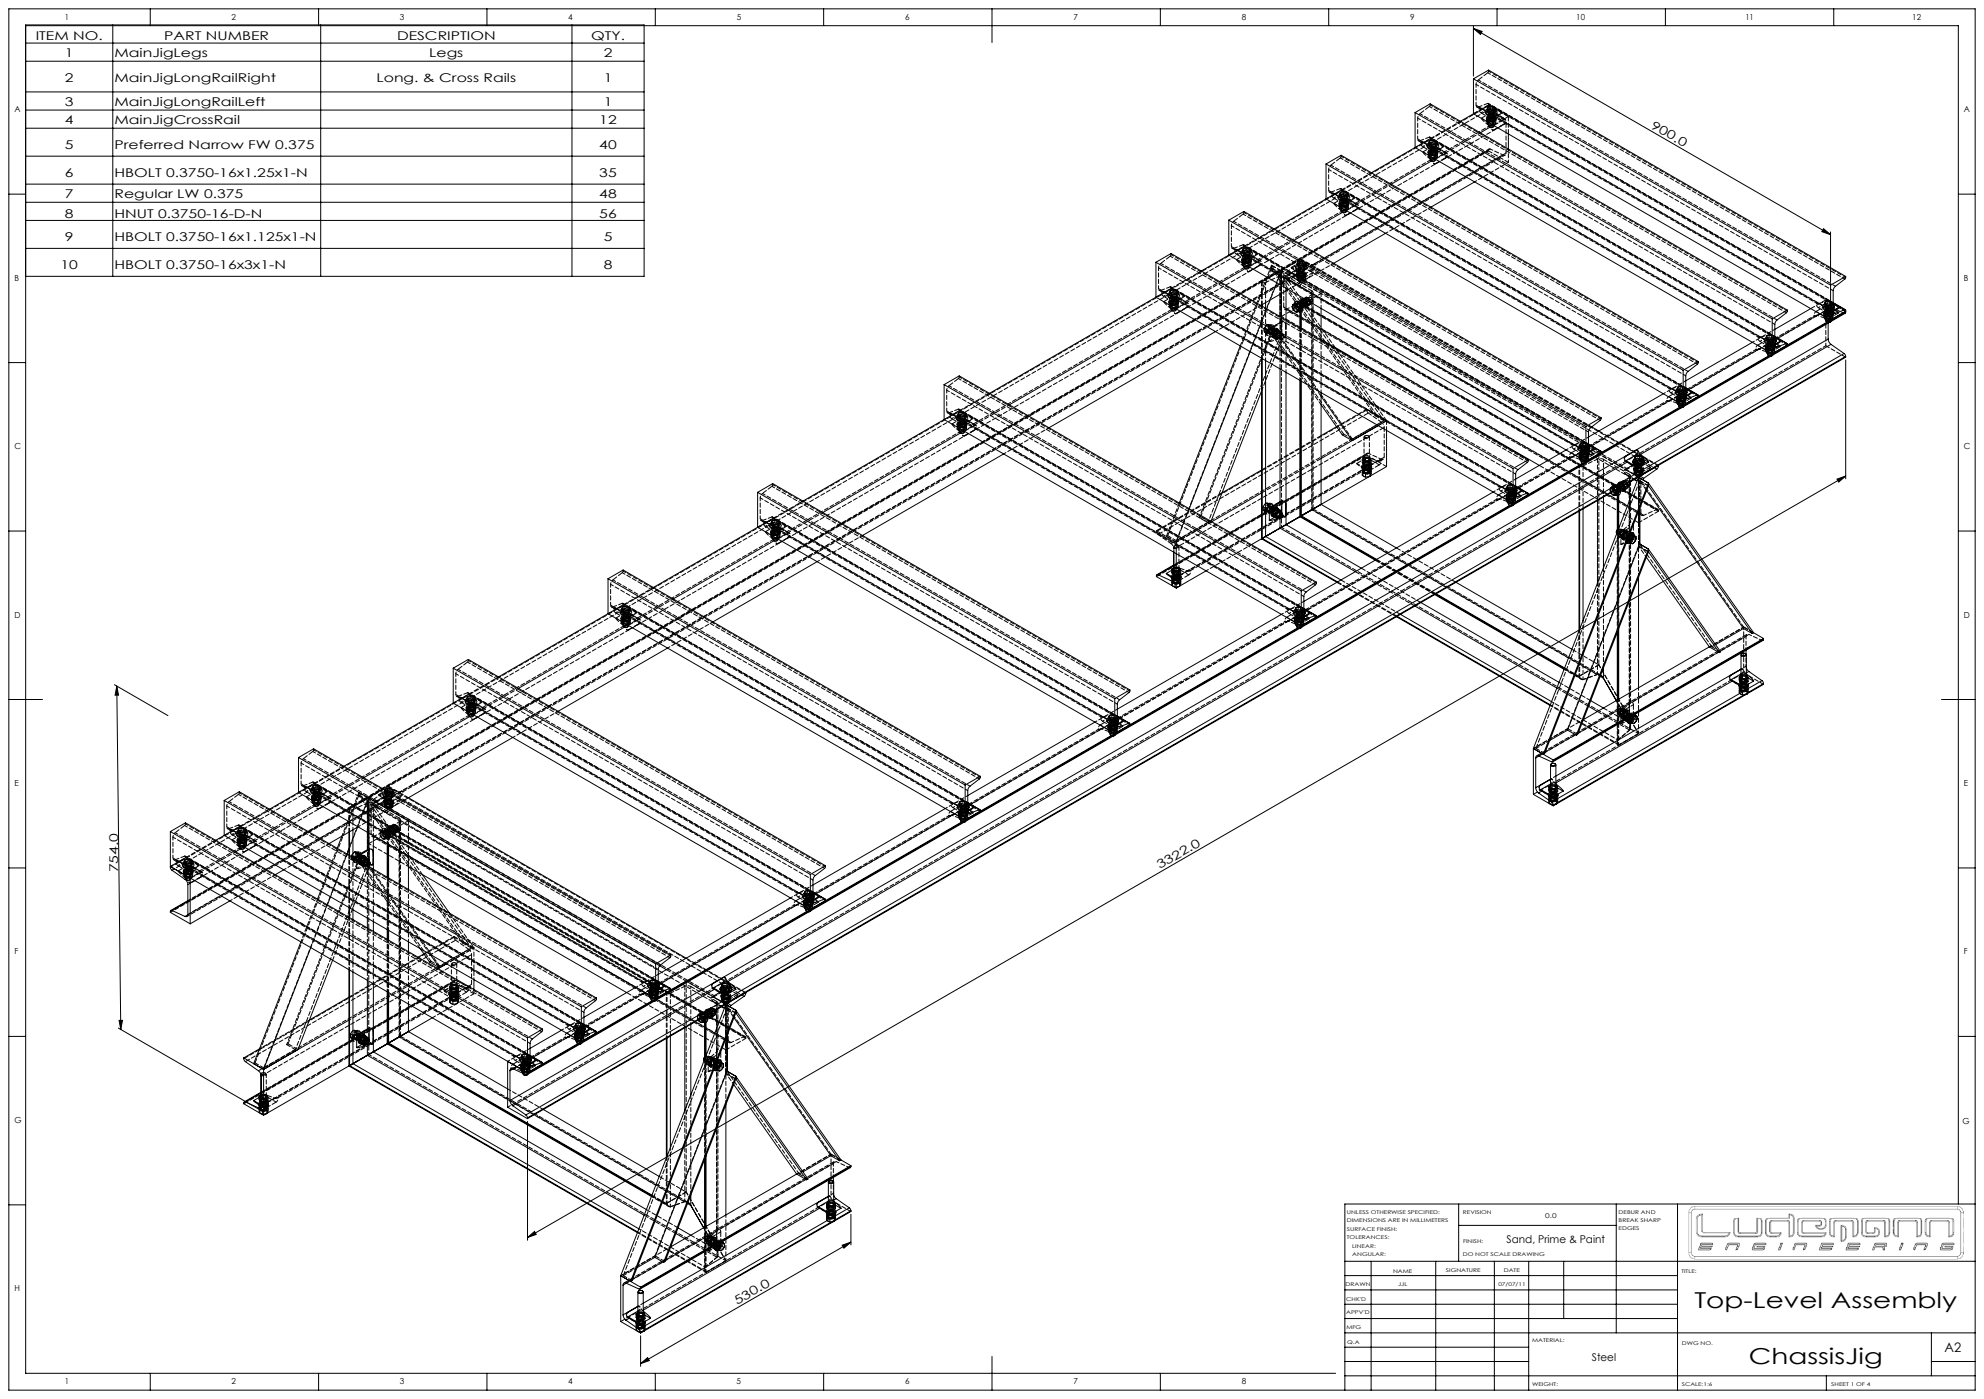
[picture p135: page 1]
SCALE:1:6; SHEET 1 OF 4

1 | 2 | 3 | 4 | 5 | 7 | 8 | 9 | 10 | 11 | 12
ITEM NO. | PART NUMBER | DESCRIPTION | QTY.
1 | MainJigLegs | Legs | 2
2 | MainJigLongRailRight | Long. & Cross Rails | 1
3 | MainJigLongRailLeft | | 1
4 | MainJigCrossRail | | 12
5 | Preferred Narrow FW 0.375 | | 40
6 | HBOLT 0.3750-16x1.25x1-N | | 35
7 | Regular LW 0.375 | | 48
8 | HNUT 0.3750-16-D-N | | 56
9 | HBOLT 0.3750-16x1.125x1-N | | 5
10 | HBOLT 0.3750-16x3x1-N | | 8

UNLESS OTHERWISE SPECIFIED: DIMENSIONS ARE IN MILLIMETERS SURFACE FINISH: TOLERANCES: LINEAR: ANGULAR: | REVISION 0.0 | DEBUR AND BREAK SHARP EDGES

Sand, Prime & Paint

FINISH:
DO NOT SCALE DRAWING

NAME | SIGNATURE | DATE | | | | TITLE: Top-Level Assembly

DRAWN | JJL | | 07/07/11
Q.A | | | | MATERIAL: Steel | DWG NO. ChassisJig | A2

CHK'D

APPV'D

MFG

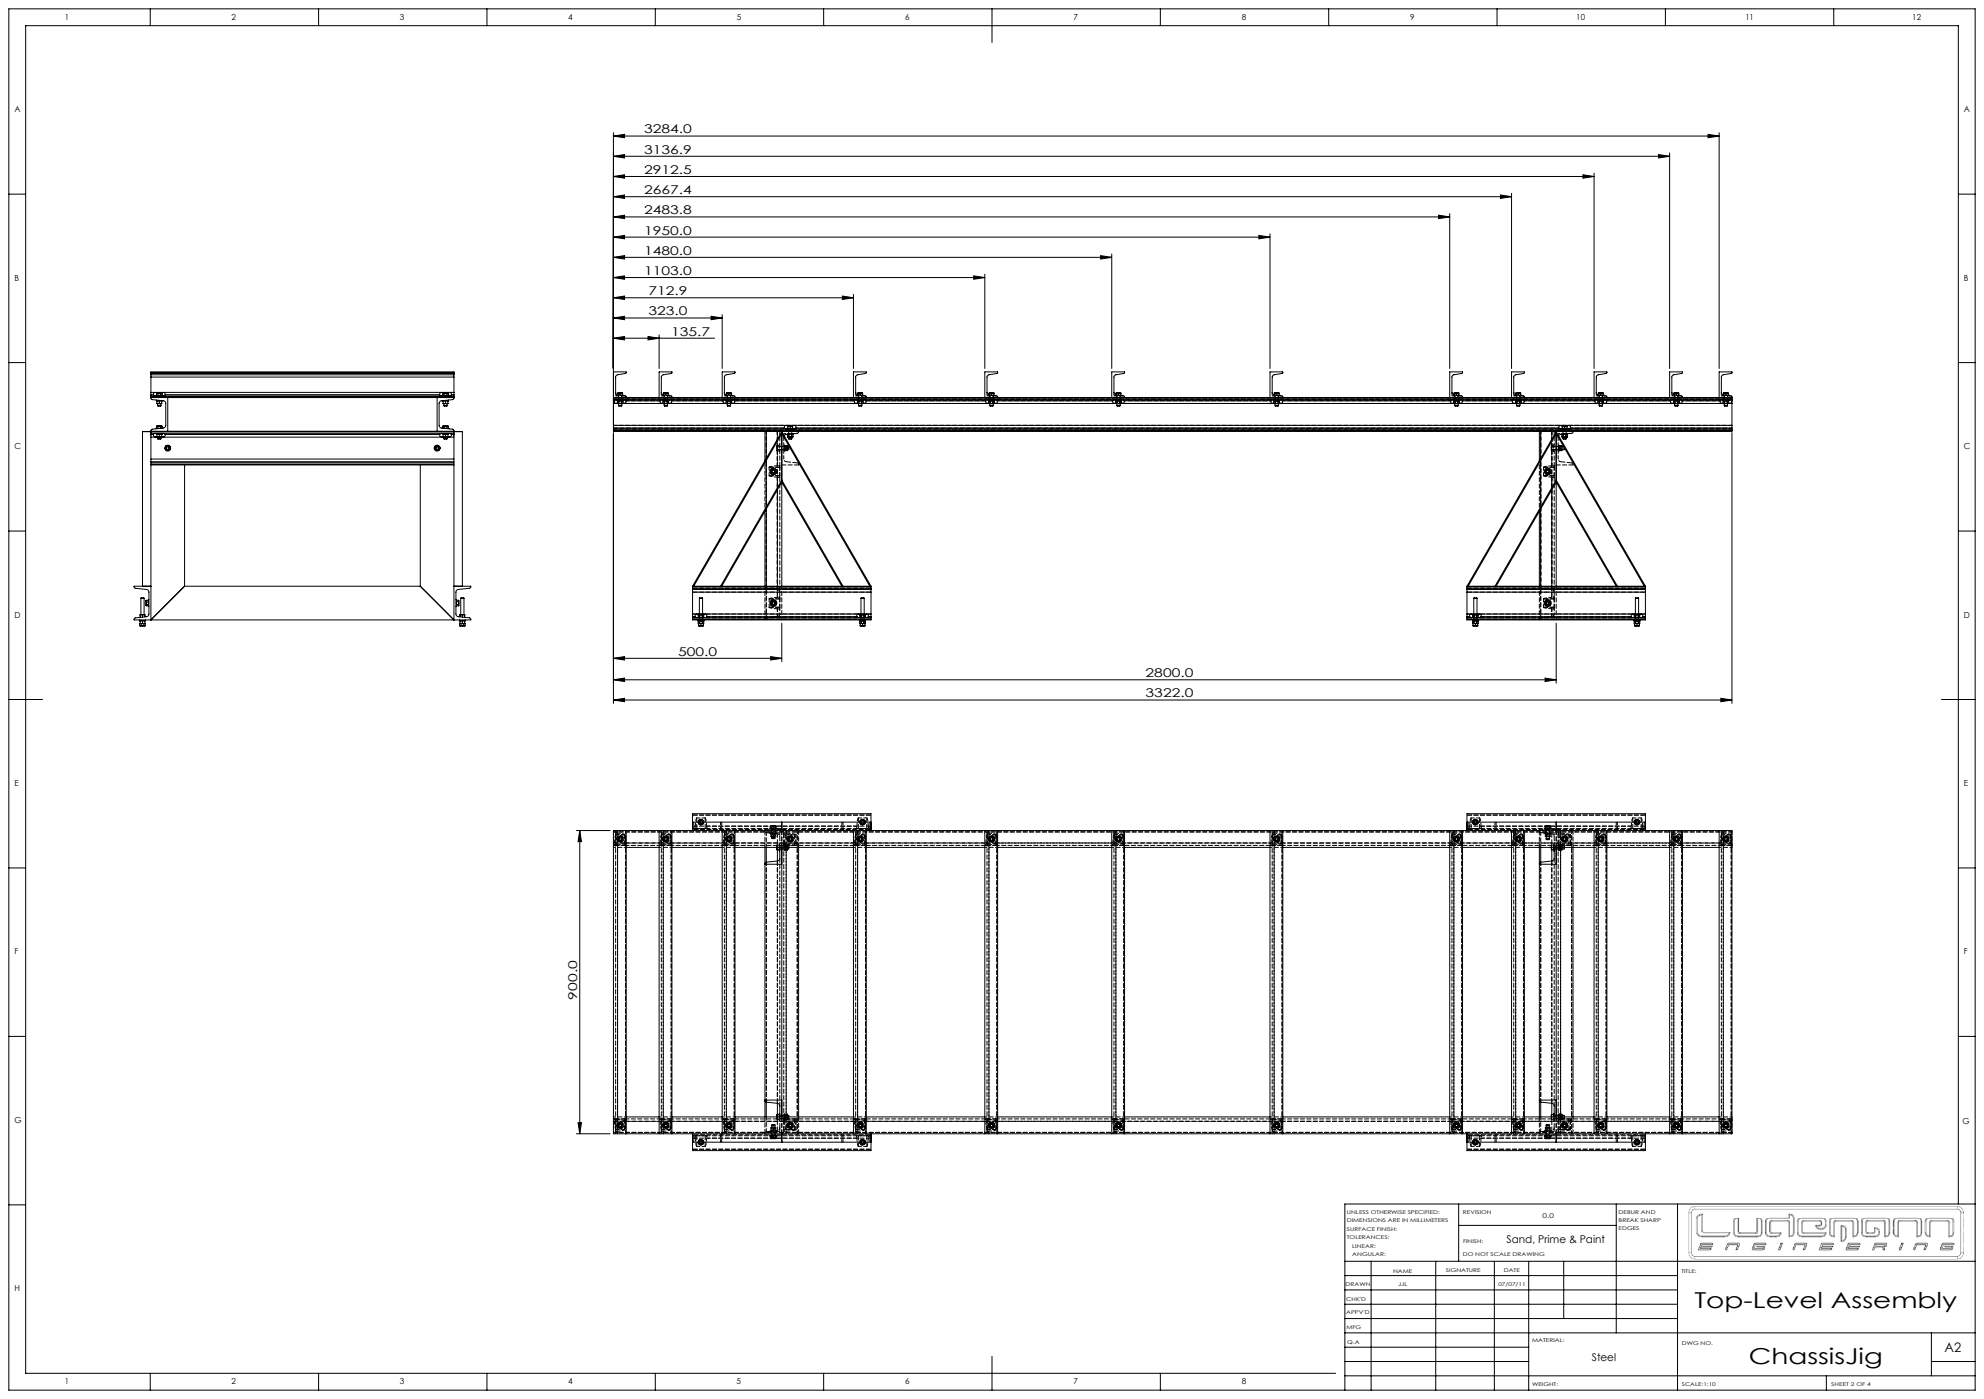
[picture p136: page 2]
SCALE:1:10; SHEET 2 OF 4; DEBUR AND BREAK SHARP

UNLESS OTHERWISE SPECIFIED:
DIMENSIONS ARE IN MILLIMETERS
SURFACE FINISH:
TOLERANCES:
LINEAR:
ANGULAR:

REVISION
Sand, Prime & Paint

FINISH:
DO NOT SCALE DRAWING

TITLE:
Top-Level Assembly

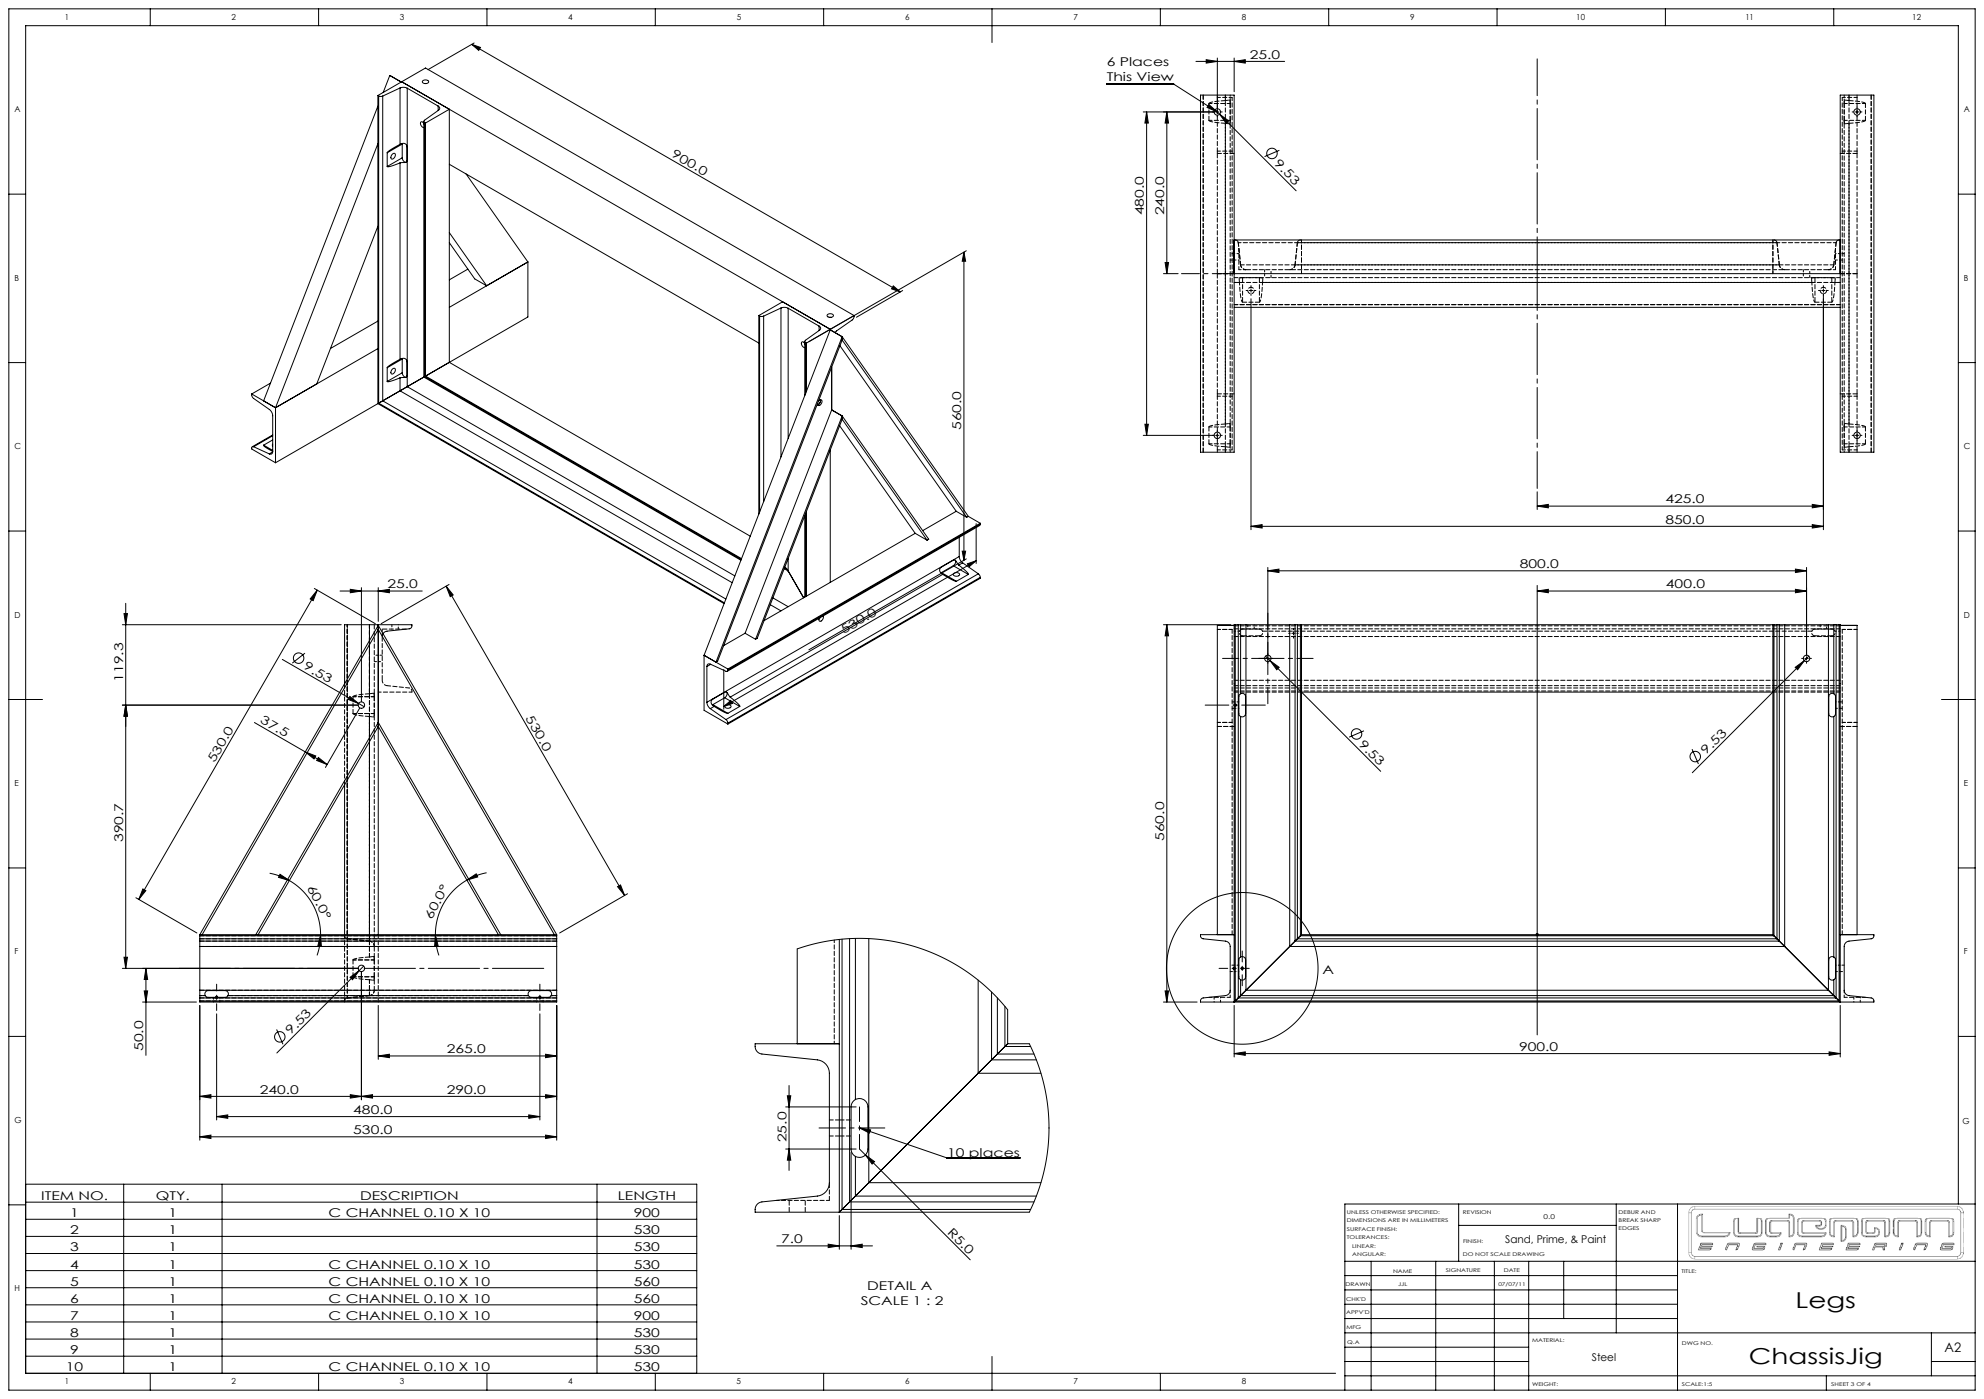
[picture p137: page 3]
6 Places This View; DETAIL A SCALE 1 : 2; 10 places; ITEM NO.; QTY.; DESCRIPTION; LENGTH; C CHANNEL 0.10 X 10; SCALE:1:5; SHEET 3 OF 4; DEBUR AND BREAK SHARP

UNLESS OTHERWISE SPECIFIED:
DIMENSIONS ARE IN MILLIMETERS
SURFACE FINISH:
TOLERANCES:
LINEAR:
ANGULAR:

REVISION
Sand, Prime, & Paint

2 | 1 | | 530
3 | 1 | | 530
4 | 1 | C CHANNEL 0.10 X 10 | 530
5 | 1 | C CHANNEL 0.10 X 10 | 560
6 | 1 | C CHANNEL 0.10 X 10 | 560
7 | 1 | C CHANNEL 0.10 X 10 | 900
8 | 1 | | 530
9 | 1 | | 530

FINISH:
DO NOT SCALE DRAWING

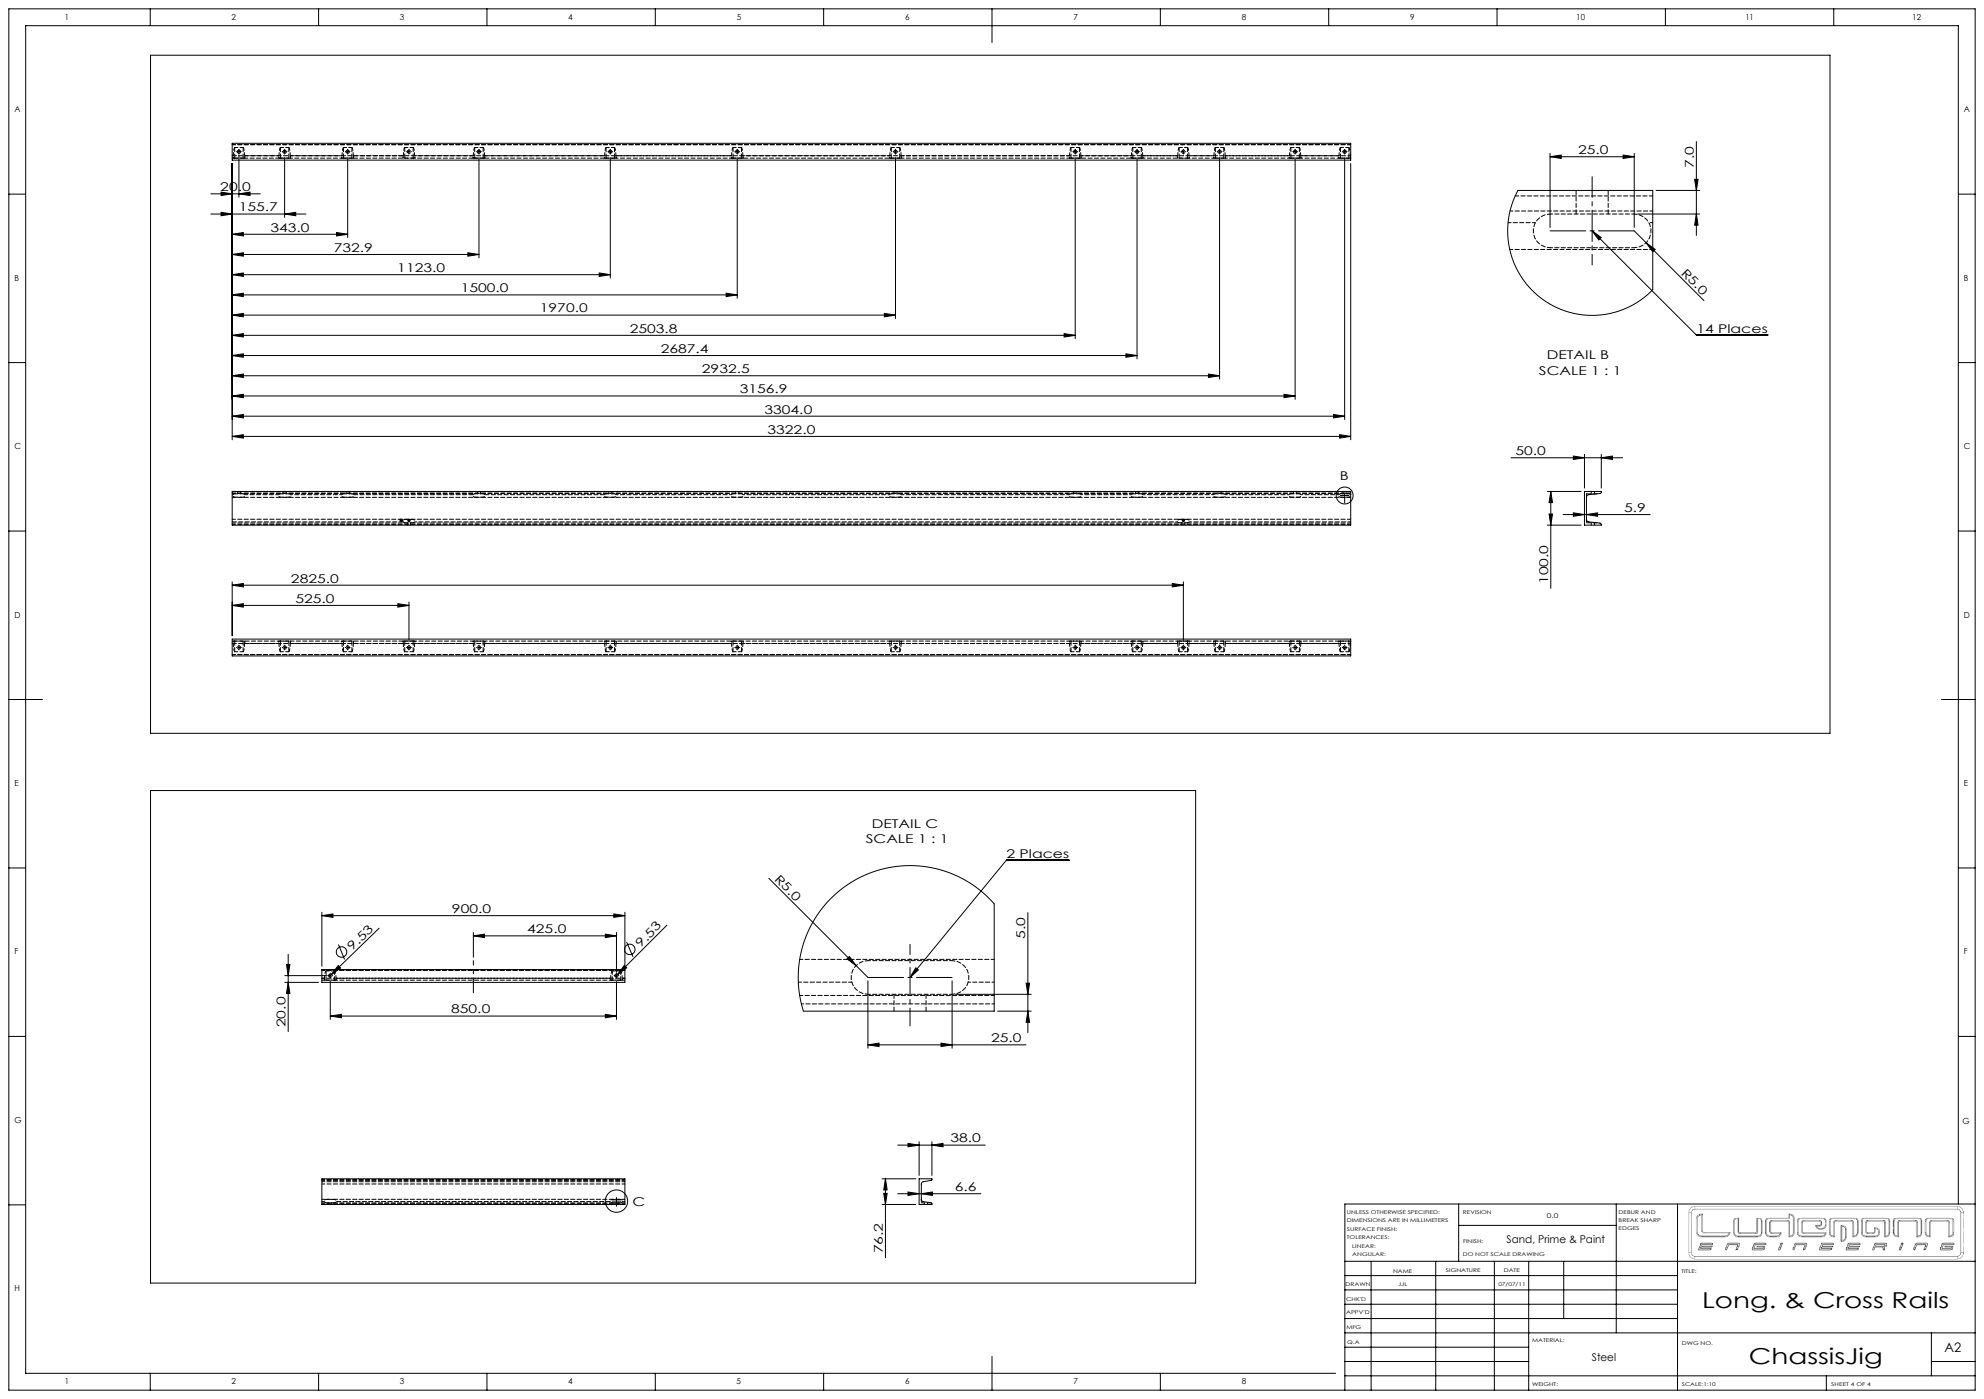
[picture p138: page 4]
DETAIL B SCALE 1 : 1; 14 Places; DETAIL C SCALE 1 : 1; 2 Places; SCALE:1:10; SHEET 4 OF 4; DEBUR AND BREAK SHARP

UNLESS OTHERWISE SPECIFIED:
DIMENSIONS ARE IN MILLIMETERS
SURFACE FINISH:
TOLERANCES:
LINEAR:
ANGULAR:

REVISION
Sand, Prime & Paint

FINISH:
DO NOT SCALE DRAWING

TITLE:
Long. & Cross Rails
