LudemannEngineering/Formula-1000-Race-Car/Solidworks/Chassis/Tubes/PDFs/A-CDiag.PDF

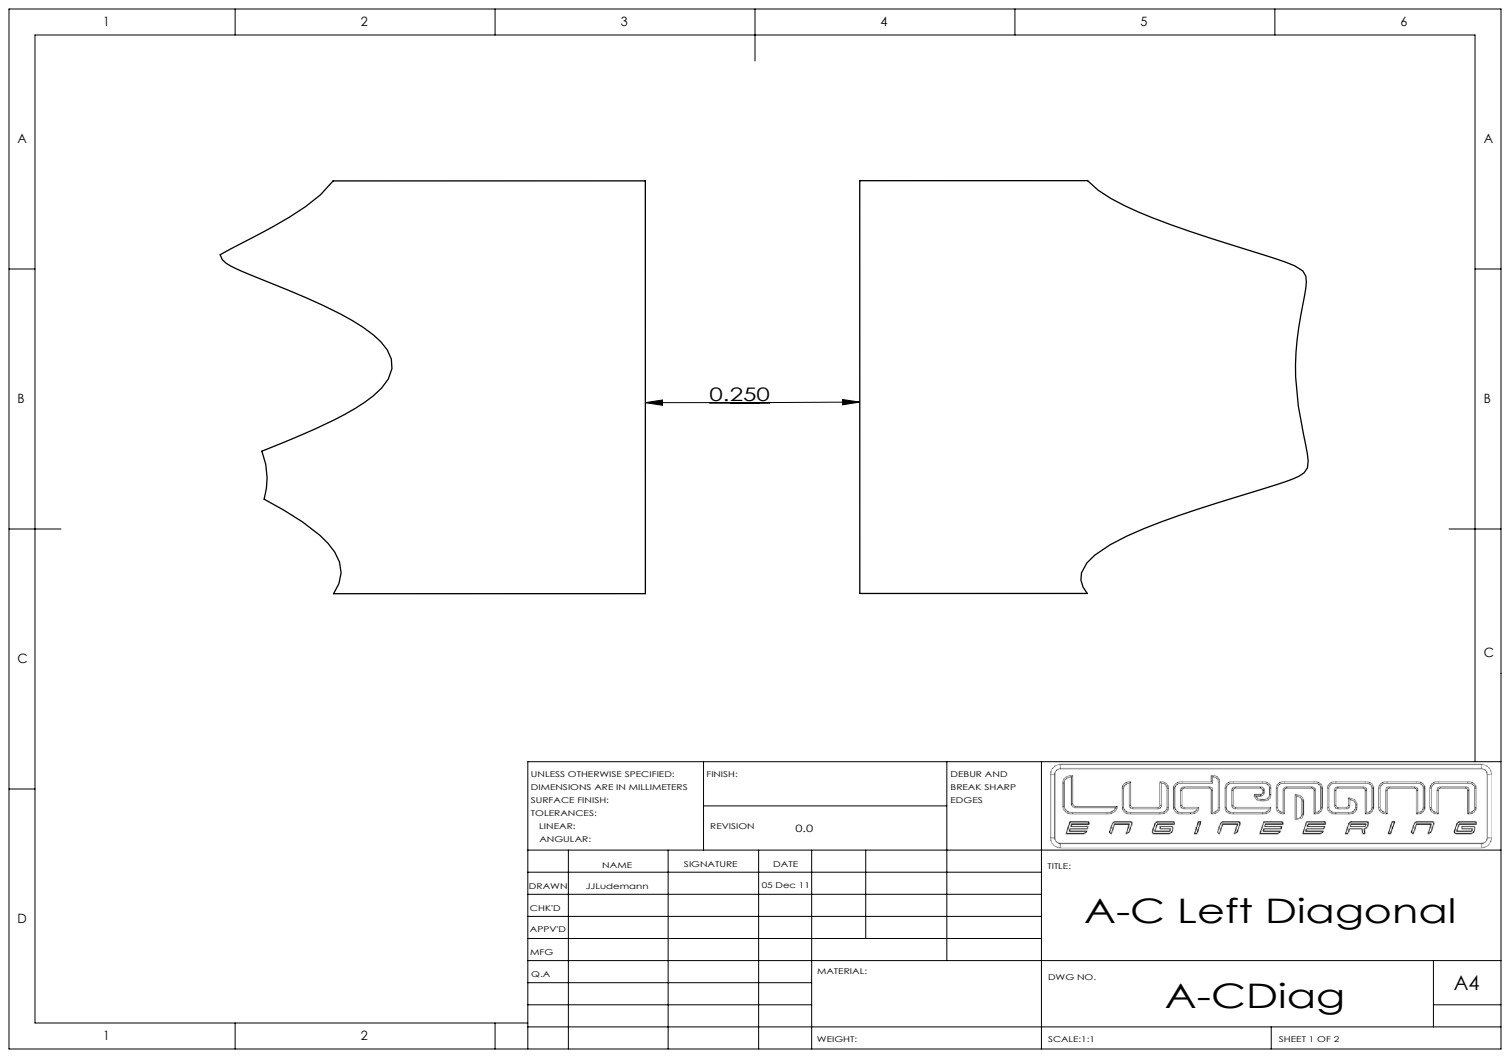
[picture p139: page 1]
FINISH:; DEBUR AND; BREAK SHARP; SCALE:1:1; SHEET 1 OF 2

UNLESS OTHERWISE SPECIFIED:
DIMENSIONS ARE IN MILLIMETERS
SURFACE FINISH:
TOLERANCES:
LINEAR:
ANGULAR:

NAME | SIGNATURE | DATE | | | | TITLE: A-C Left Diagonal

DRAWN | JJLudemann | | 05 Dec 11

CHK'D

APPV'D

MFG
Q.A | | | | MATERIAL: | DWG NO. A-CDiag | A4

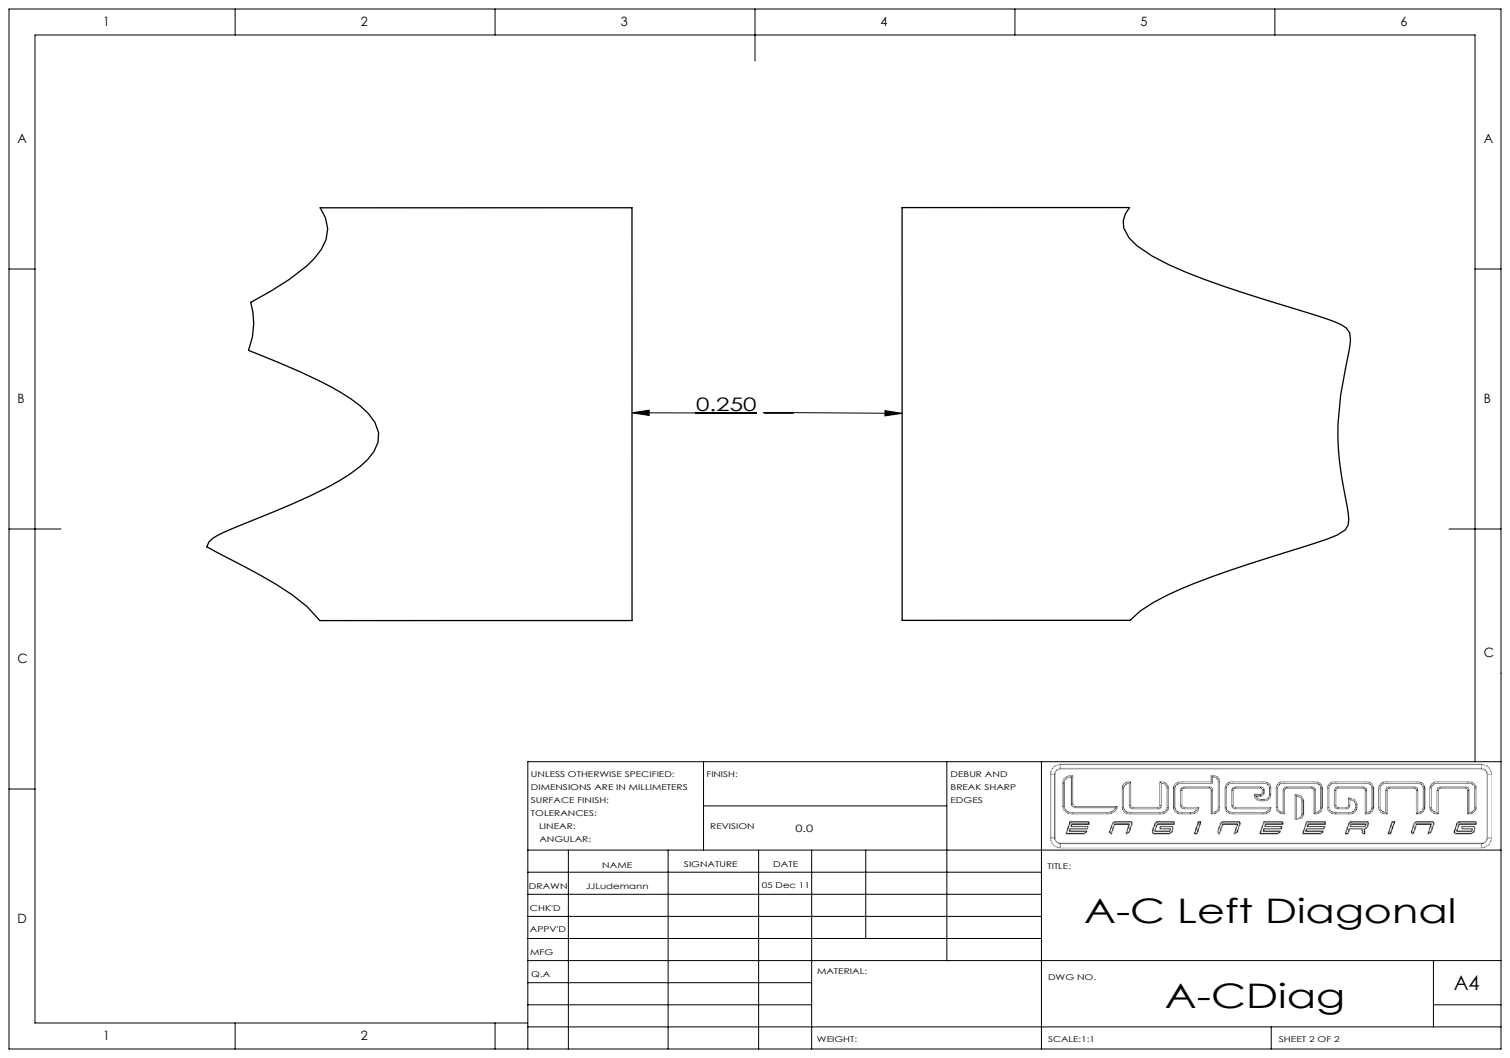
[picture p140: page 2]
FINISH:; DEBUR AND; BREAK SHARP; SCALE:1:1; SHEET 2 OF 2

UNLESS OTHERWISE SPECIFIED:
DIMENSIONS ARE IN MILLIMETERS
SURFACE FINISH:
TOLERANCES:
LINEAR:
ANGULAR:

NAME | SIGNATURE | DATE | | | | TITLE: A-C Left Diagonal

DRAWN | JJLudemann | | 05 Dec 11

CHK'D

APPV'D

MFG
Q.A | | | | MATERIAL: | DWG NO. A-CDiag | A4
