LudemannEngineering/Formula-1000-Race-Car/Solidworks/Chassis/Tubes/PDFs/ACH1.PDF

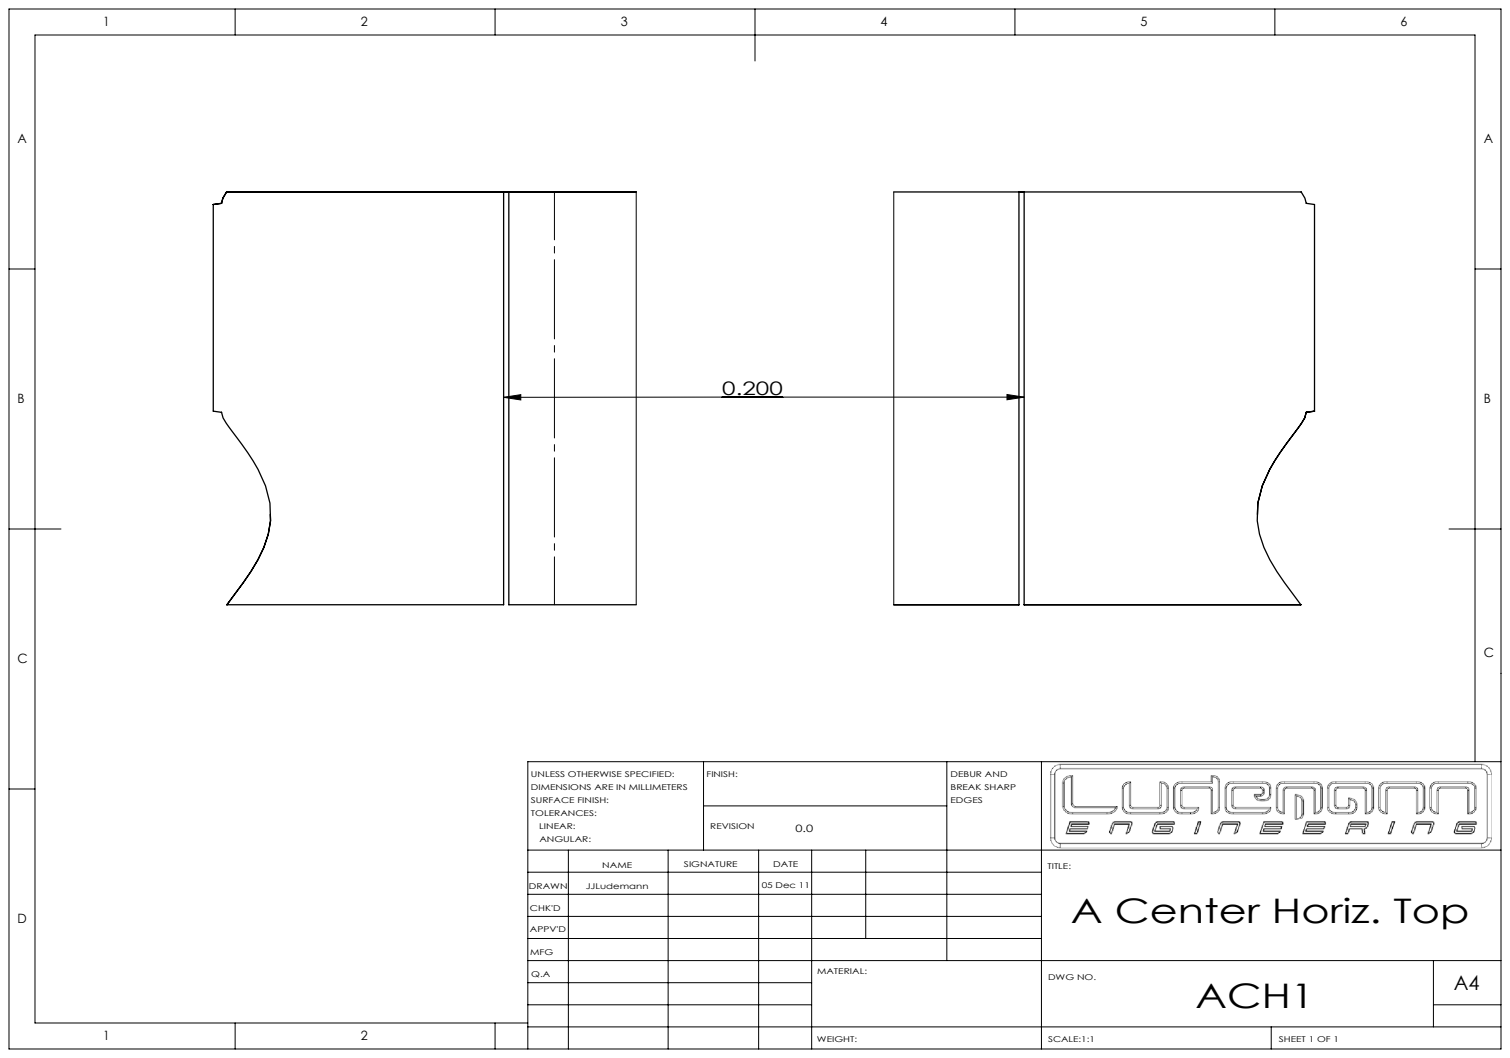
[picture p141: page 1]
FINISH:; DEBUR AND; BREAK SHARP; SCALE:1:1; SHEET 1 OF 1

UNLESS OTHERWISE SPECIFIED:
DIMENSIONS ARE IN MILLIMETERS
SURFACE FINISH:
TOLERANCES:
LINEAR:
ANGULAR:

NAME | SIGNATURE | DATE | | | | TITLE: A Center Horiz. Top

DRAWN | JJLudemann | | 05 Dec 11

CHK'D

APPV'D

MFG
Q.A | | | | MATERIAL: | DWG NO. ACH1 | A4
