LudemannEngineering/Formula-1000-Race-Car/Solidworks/Chassis/Tubes/PDFs/Bulkhead C to D Tubes.PDF

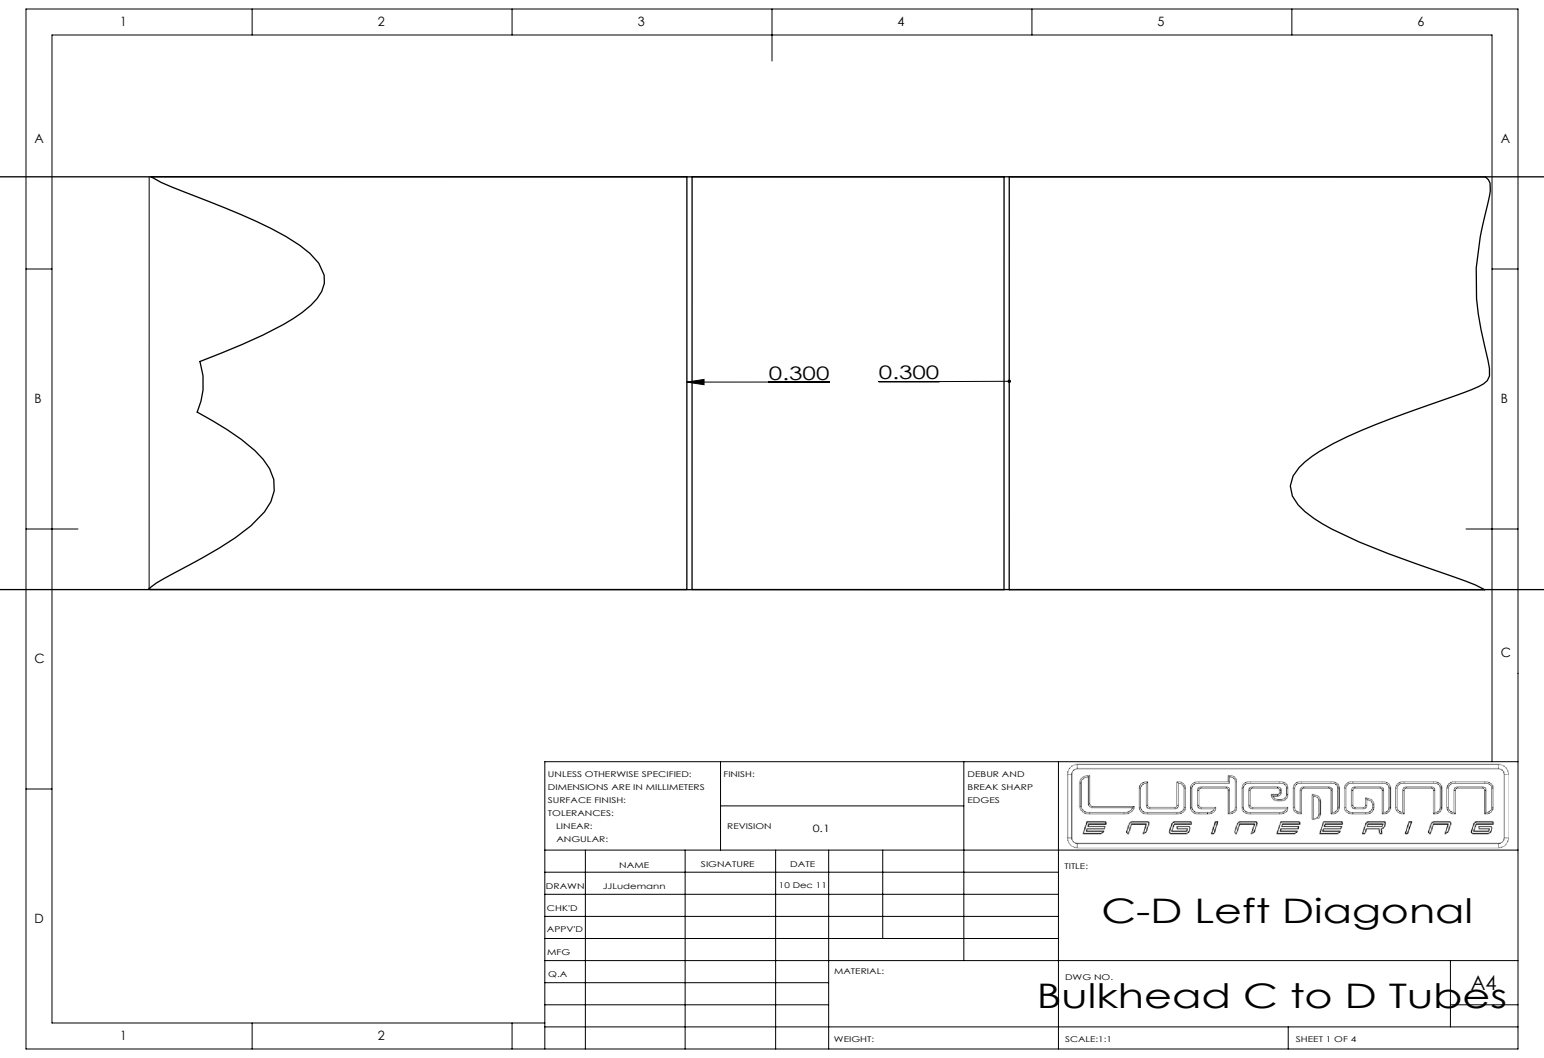
[picture p142: page 1]
FINISH:; DEBUR AND; BREAK SHARP; SCALE:1:1; SHEET 1 OF 4

UNLESS OTHERWISE SPECIFIED:
DIMENSIONS ARE IN MILLIMETERS
SURFACE FINISH:
TOLERANCES:
LINEAR:
ANGULAR:

NAME | SIGNATURE | DATE | | | | TITLE: C-D Left Diagonal

DRAWN | JJLudemann | | 10 Dec 11

CHK'D

APPV'D

MFG
Q.A | | | | MATERIAL: Bulkhead C to D Tubes | DWG NO. | A4

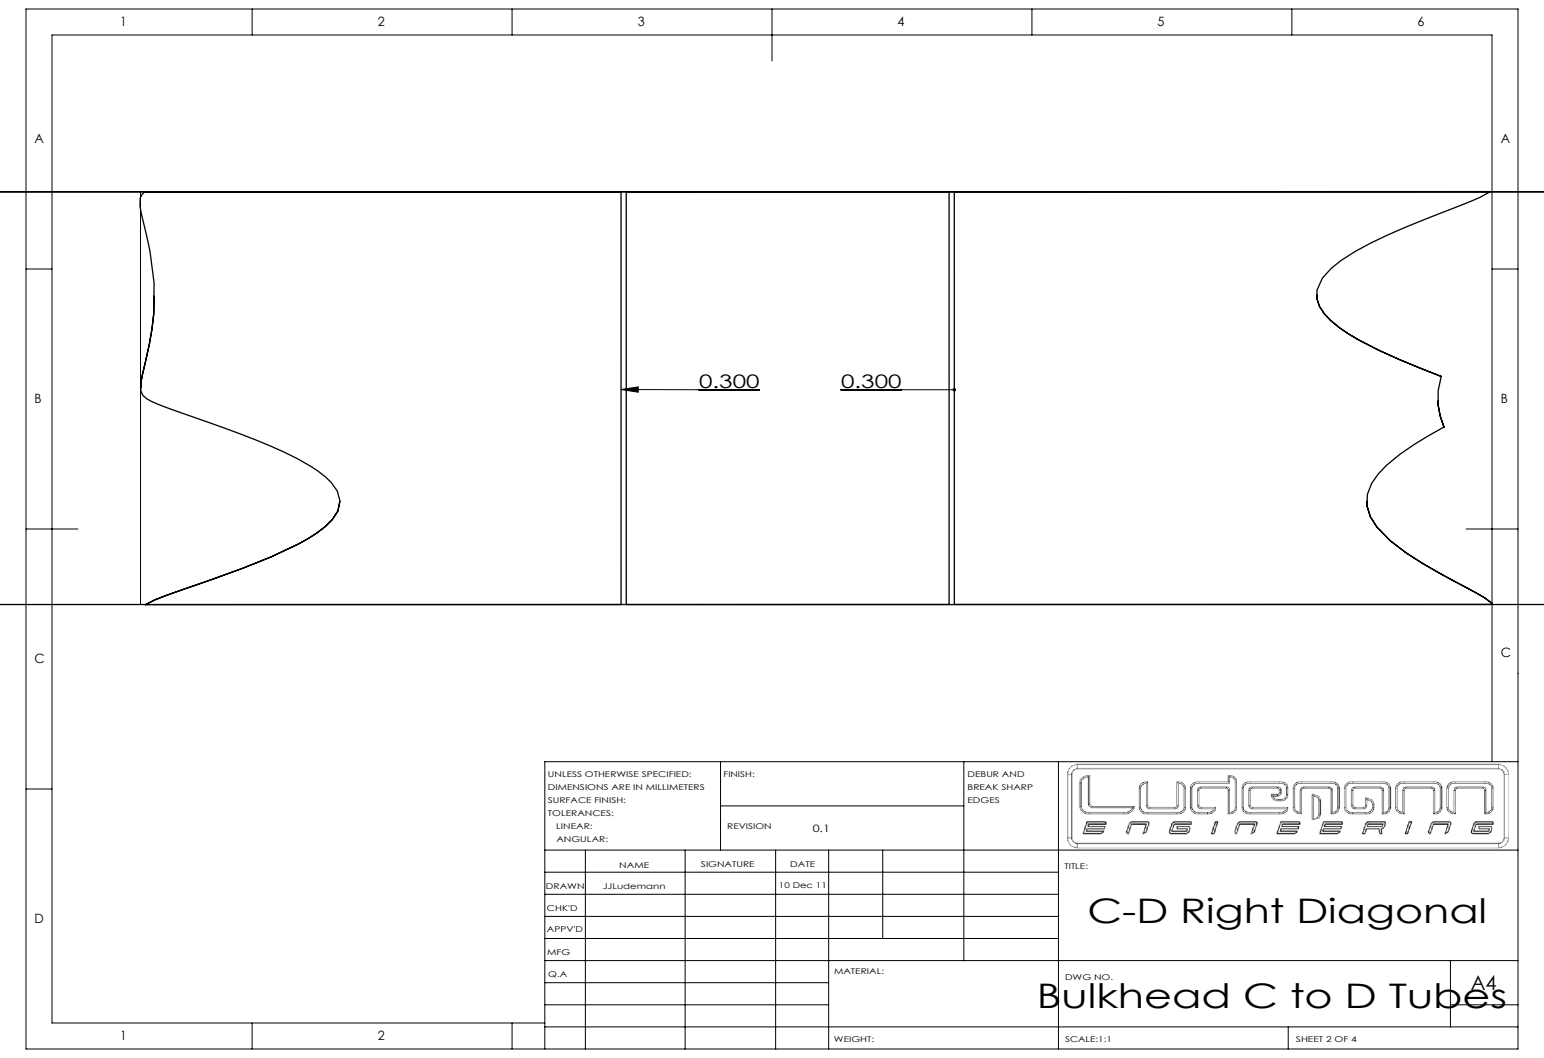
[picture p143: page 2]
FINISH:; DEBUR AND; BREAK SHARP

UNLESS OTHERWISE SPECIFIED:
DIMENSIONS ARE IN MILLIMETERS
SURFACE FINISH:
TOLERANCES:
LINEAR:
ANGULAR:

NAME | SIGNATURE | DATE | | | | TITLE: C-D Right Diagonal

DRAWN | JJLudemann | | 10 Dec 11

CHK'D

APPV'D

MFG
Q.A | | | | MATERIAL: Bulkhead C to D Tubes | DWG NO. | A4

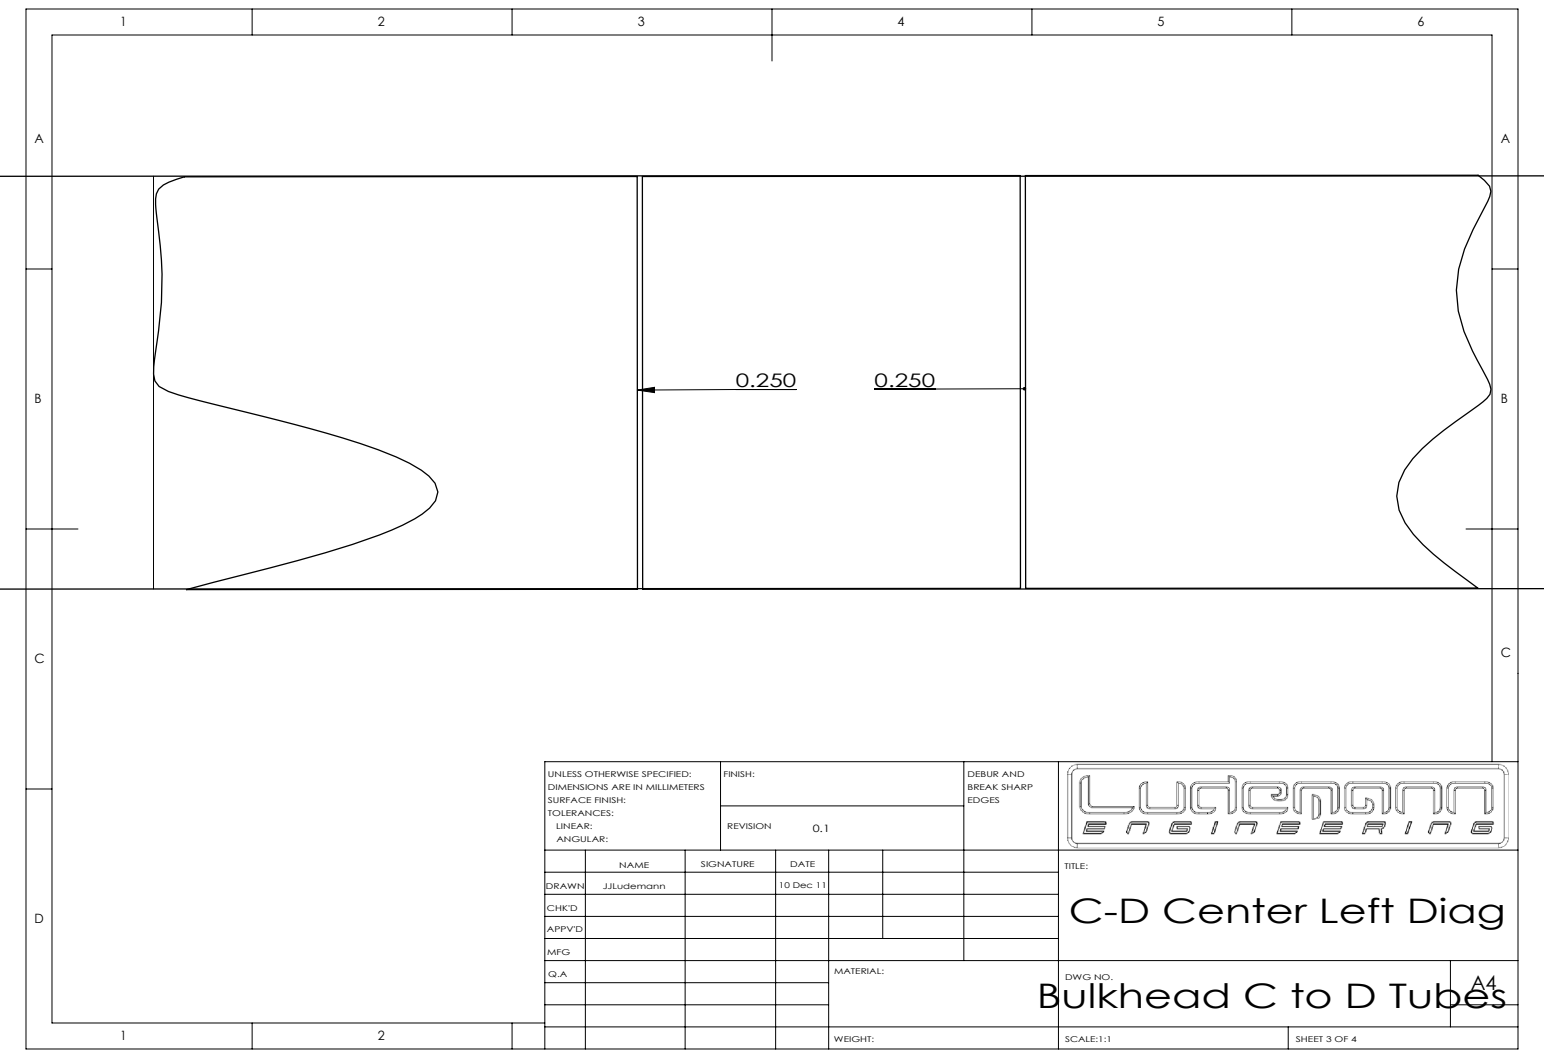
[picture p144: page 3]
FINISH:; DEBUR AND; BREAK SHARP

UNLESS OTHERWISE SPECIFIED:
DIMENSIONS ARE IN MILLIMETERS
SURFACE FINISH:
TOLERANCES:
LINEAR:
ANGULAR:

NAME | SIGNATURE | DATE | | | | TITLE: C-D Center Left Diag

DRAWN | JJLudemann | | 10 Dec 11

CHK'D

APPV'D

MFG
Q.A | | | | MATERIAL: Bulkhead C to D Tubes | DWG NO. | A4

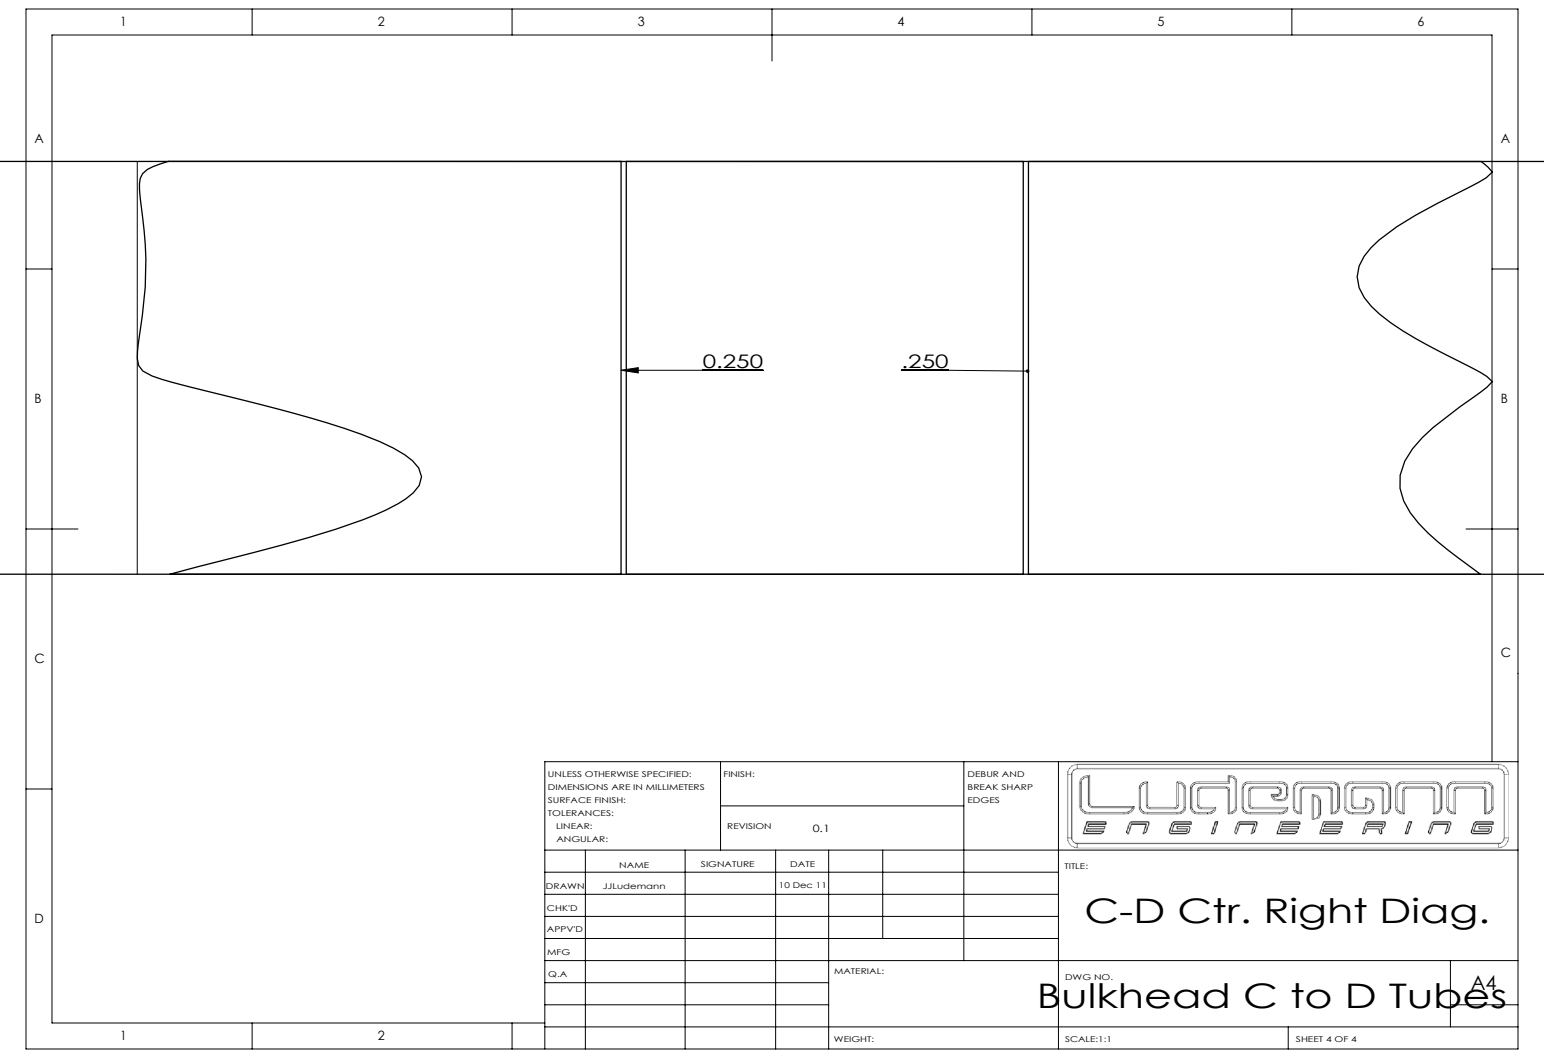
[picture p145: page 4]
FINISH:; DEBUR AND; BREAK SHARP

UNLESS OTHERWISE SPECIFIED:
DIMENSIONS ARE IN MILLIMETERS
SURFACE FINISH:
TOLERANCES:
LINEAR:
ANGULAR:

NAME | SIGNATURE | DATE | | | | TITLE: C-D Ctr. Right Diag.

DRAWN | JJLudemann | | 10 Dec 11

CHK'D

APPV'D

MFG
Q.A | | | | MATERIAL: Bulkhead C to D Tubes | DWG NO. | A4
