LudemannEngineering/Formula-1000-Race-Car/Solidworks/Chassis/Tubes/PDFs/Bulkhead D to E Tubes.PDF

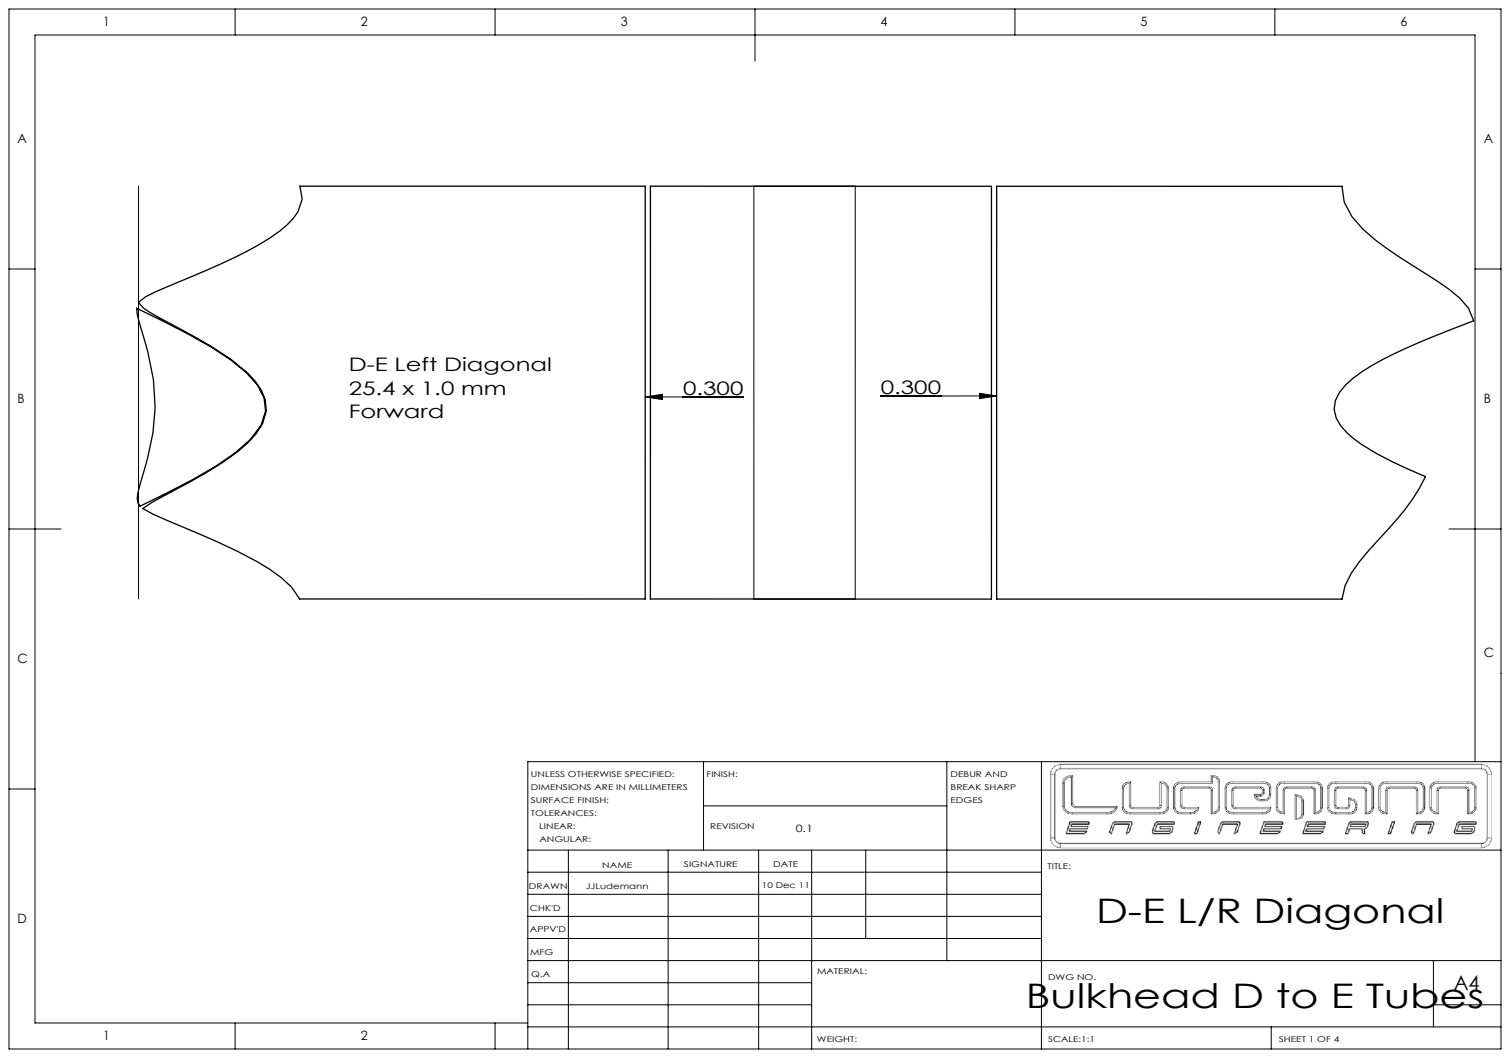
[picture p146: page 1]
D-E Left Diagonal 25.4 x 1.0 mm; FINISH:; DEBUR AND; BREAK SHARP; SCALE:1:1; SHEET 1 OF 4

UNLESS OTHERWISE SPECIFIED:
DIMENSIONS ARE IN MILLIMETERS
SURFACE FINISH:
TOLERANCES:
LINEAR:
ANGULAR:

NAME | SIGNATURE | DATE | | | | TITLE: D-E L/R Diagonal

DRAWN | JJLudemann | | 10 Dec 11

CHK'D

APPV'D

MFG
Q.A | | | | MATERIAL: Bulkhead D to E Tubes | DWG NO. | A4

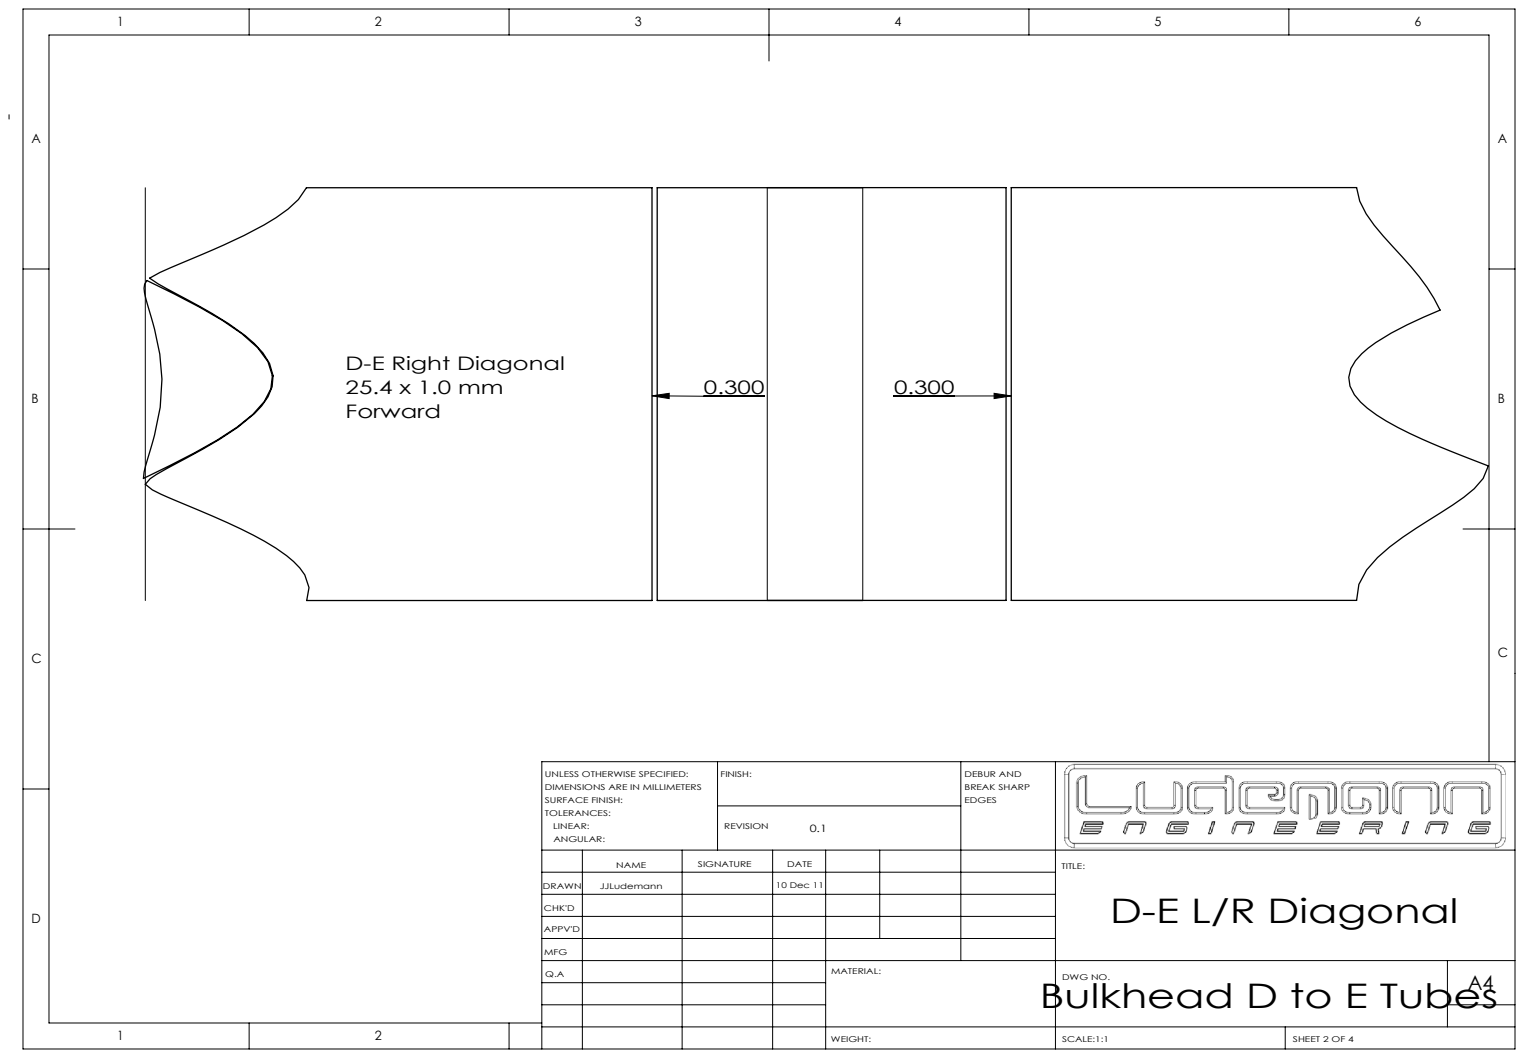
[picture p147: page 2]
D-E Right Diagonal 25.4 x 1.0 mm; FINISH:; DEBUR AND; BREAK SHARP

UNLESS OTHERWISE SPECIFIED:
DIMENSIONS ARE IN MILLIMETERS
SURFACE FINISH:
TOLERANCES:
LINEAR:
ANGULAR:

NAME | SIGNATURE | DATE | | | | TITLE: D-E L/R Diagonal

DRAWN | JJLudemann | | 10 Dec 11

CHK'D

APPV'D

MFG
Q.A | | | | MATERIAL: Bulkhead D to E Tubes | DWG NO. | A4

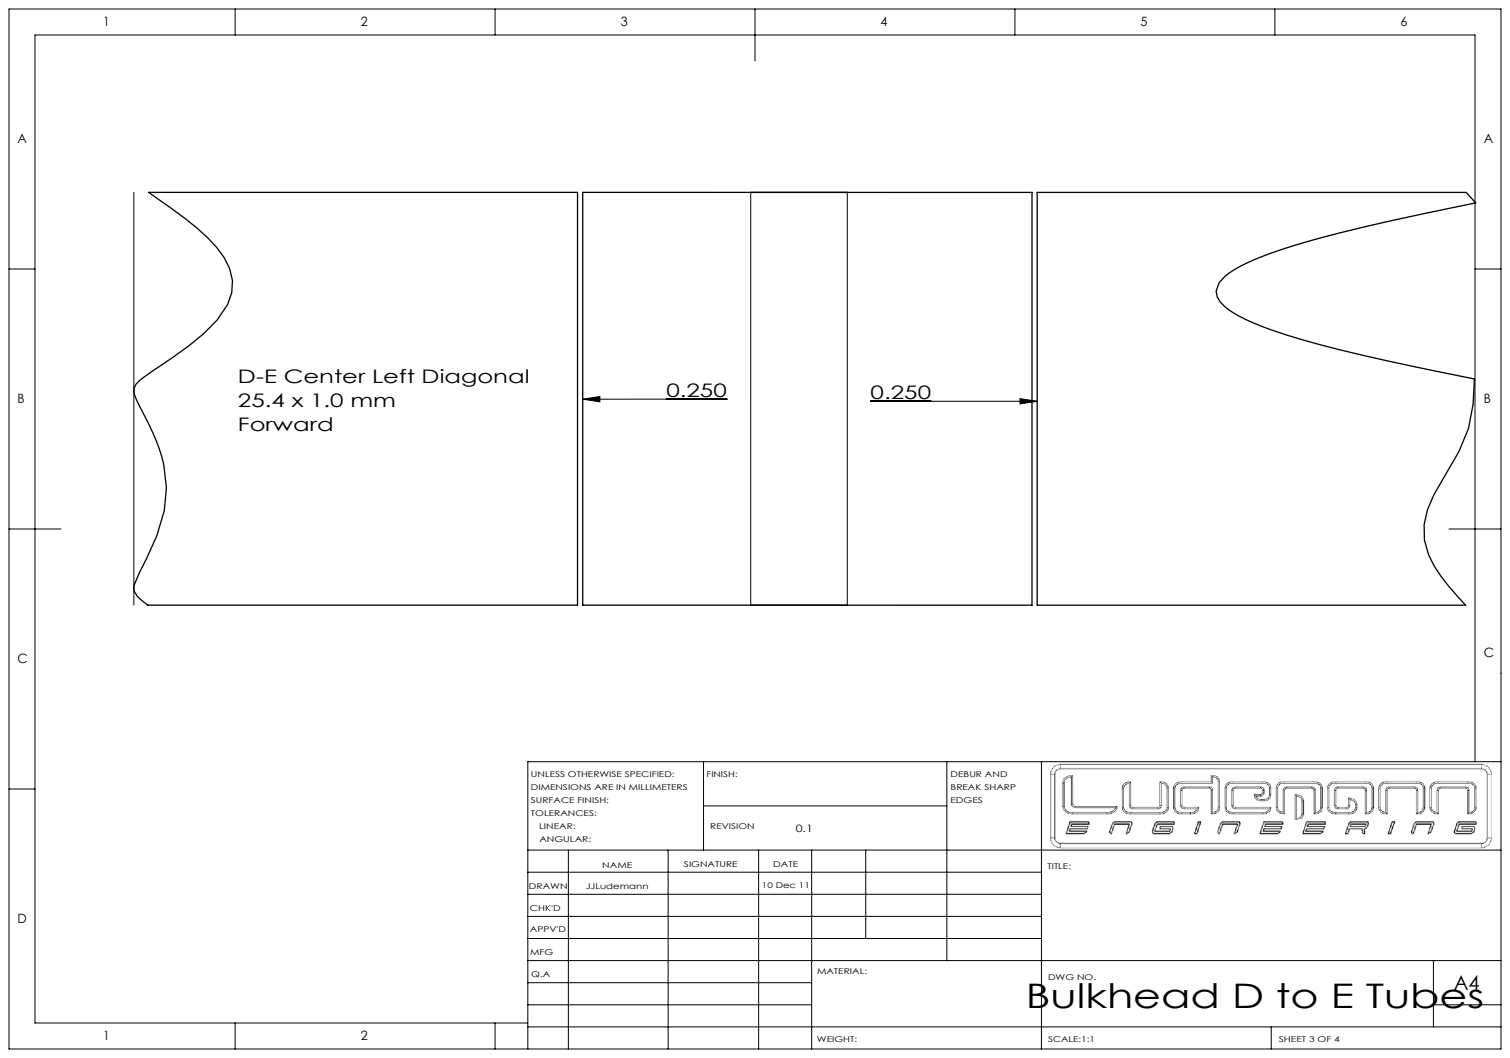
[picture p148: page 3]
FINISH:; DEBUR AND; BREAK SHARP

0.250 D-E Center Left Diagonal
Forward

UNLESS OTHERWISE SPECIFIED:
DIMENSIONS ARE IN MILLIMETERS
SURFACE FINISH:
TOLERANCES:
LINEAR:
ANGULAR:

NAME | SIGNATURE | DATE | | | | TITLE:

DRAWN | JJLudemann | | 10 Dec 11

CHK'D

APPV'D

MFG
Q.A | | | | MATERIAL: Bulkhead D to E Tubes | DWG NO. | A4

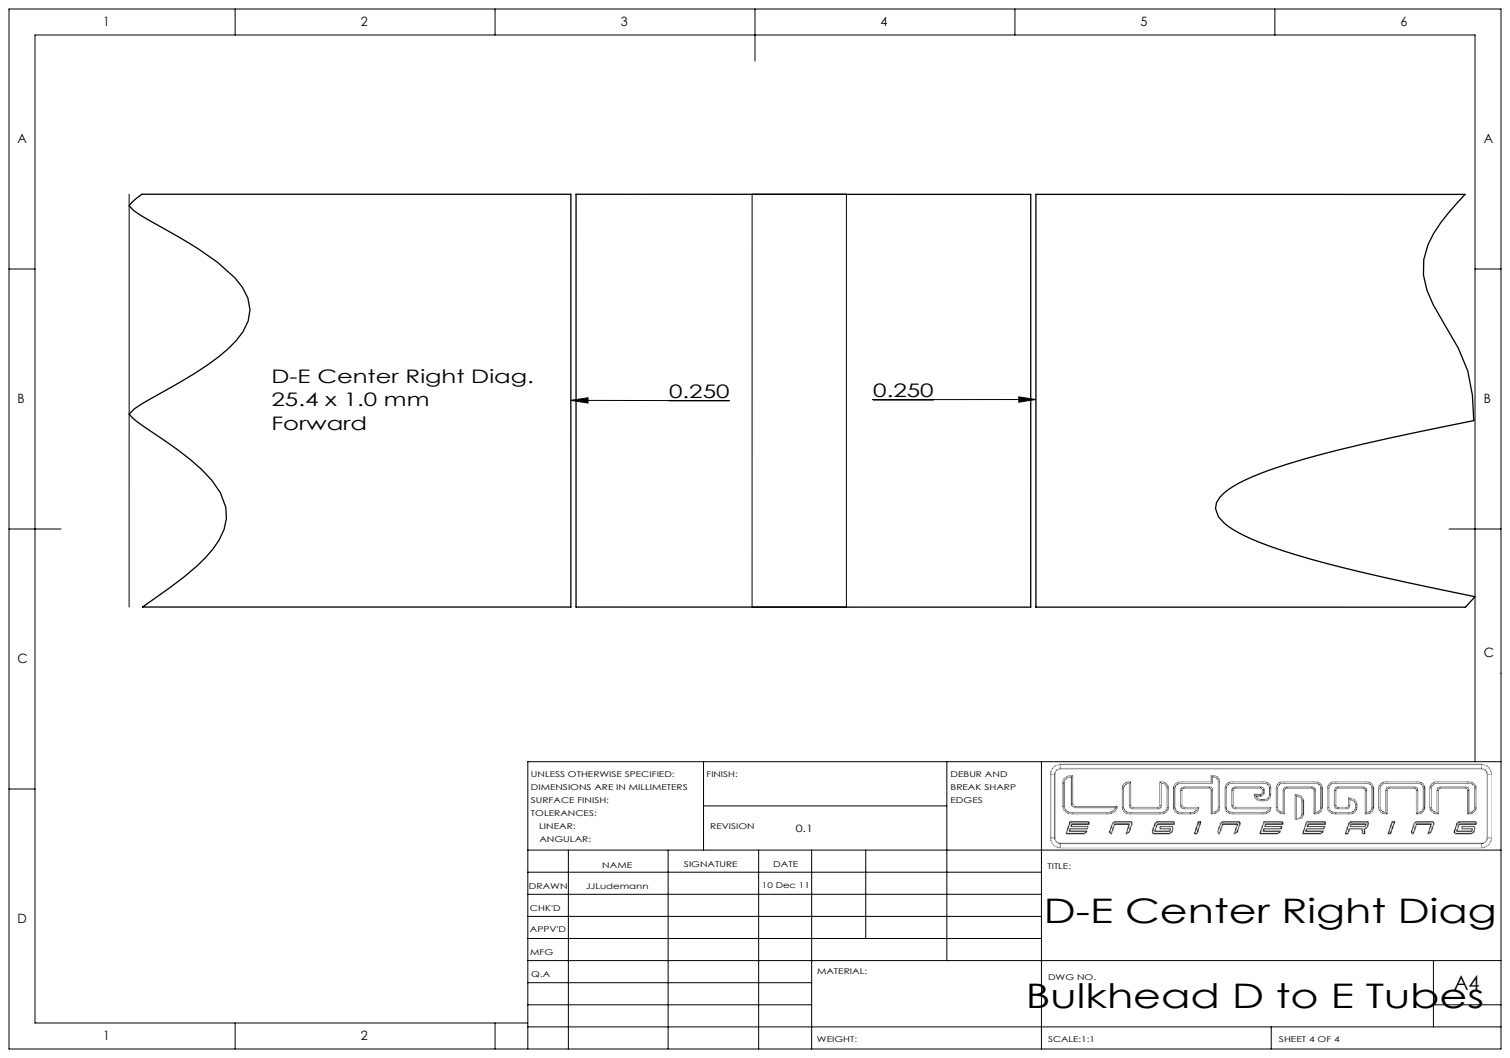
[picture p149: page 4]
FINISH:; DEBUR AND; BREAK SHARP

0.250 D-E Center Right Diag.
Forward

UNLESS OTHERWISE SPECIFIED:
DIMENSIONS ARE IN MILLIMETERS
SURFACE FINISH:
TOLERANCES:
LINEAR:
ANGULAR:

NAME | SIGNATURE | DATE | | | | TITLE: D-E Center Right Diag

DRAWN | JJLudemann | | 10 Dec 11

CHK'D

APPV'D

MFG
Q.A | | | | MATERIAL: Bulkhead D to E Tubes | DWG NO. | A4
