LudemannEngineering/Formula-1000-Race-Car/Solidworks/Chassis/Tubes/PDFs/Bulkhead D Tubes.PDF

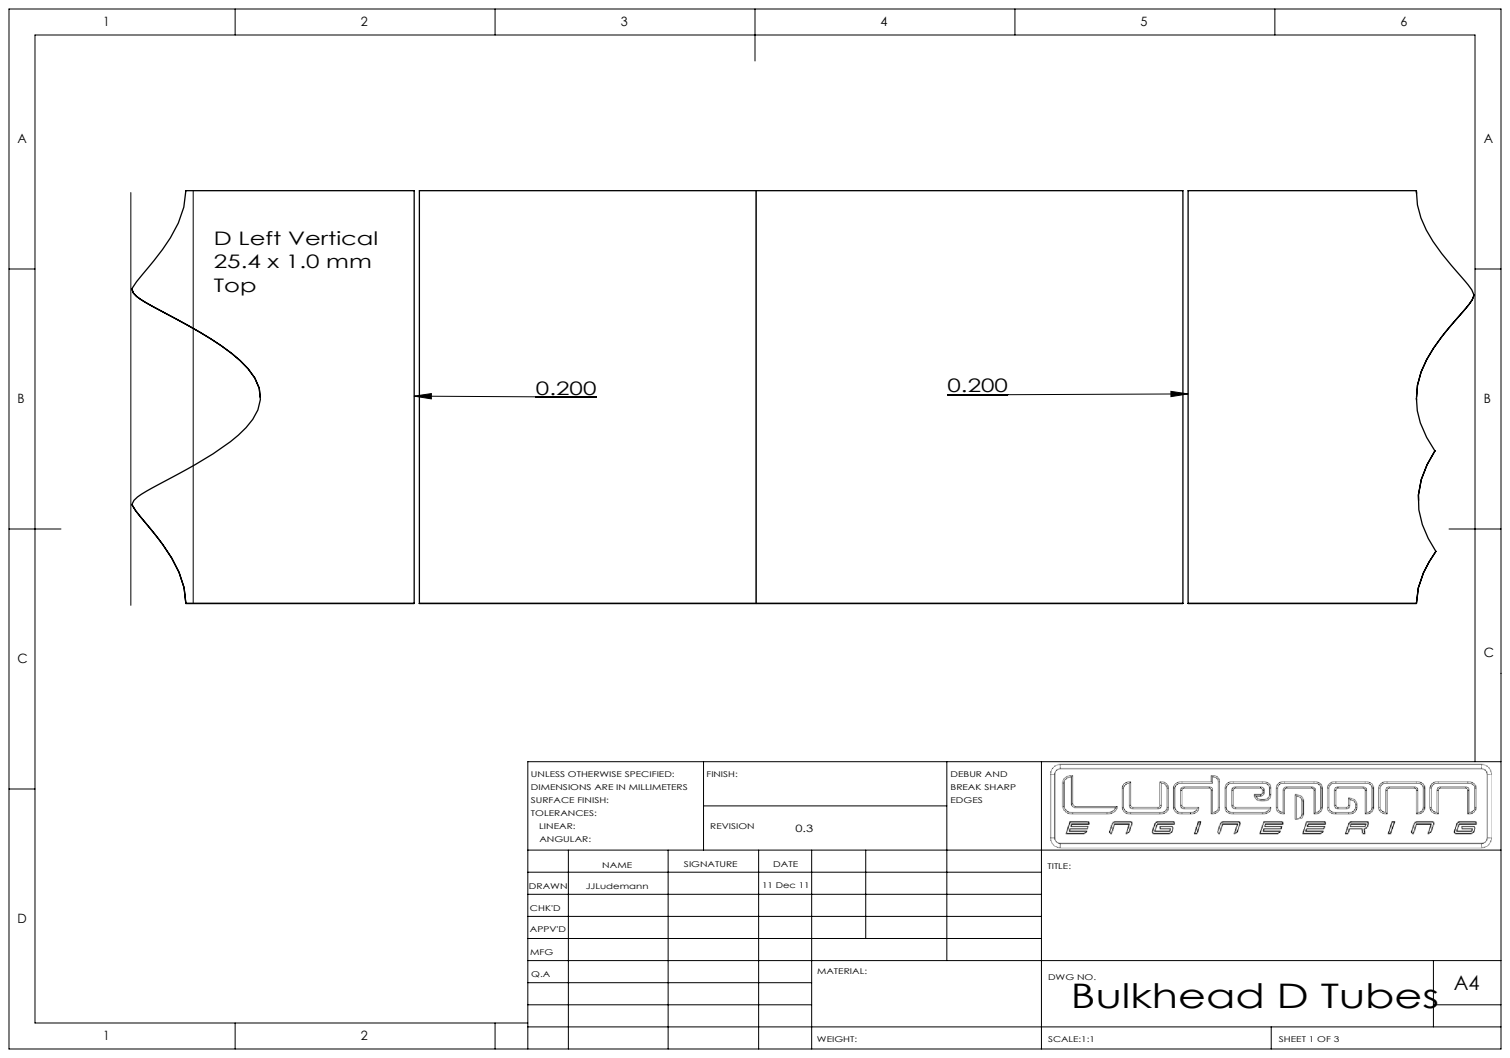
[picture p150: page 1]
D Left Vertical 25.4 x 1.0 mm; FINISH:; DEBUR AND; BREAK SHARP; SCALE:1:1; SHEET 1 OF 3

UNLESS OTHERWISE SPECIFIED:
DIMENSIONS ARE IN MILLIMETERS
SURFACE FINISH:
TOLERANCES:
LINEAR:
ANGULAR:

NAME | SIGNATURE | DATE | | | | TITLE:

DRAWN | JJLudemann | | 11 Dec 11

CHK'D

APPV'D

MFG
Q.A | | | | MATERIAL: | DWG NO. Bulkhead D Tubes | A4

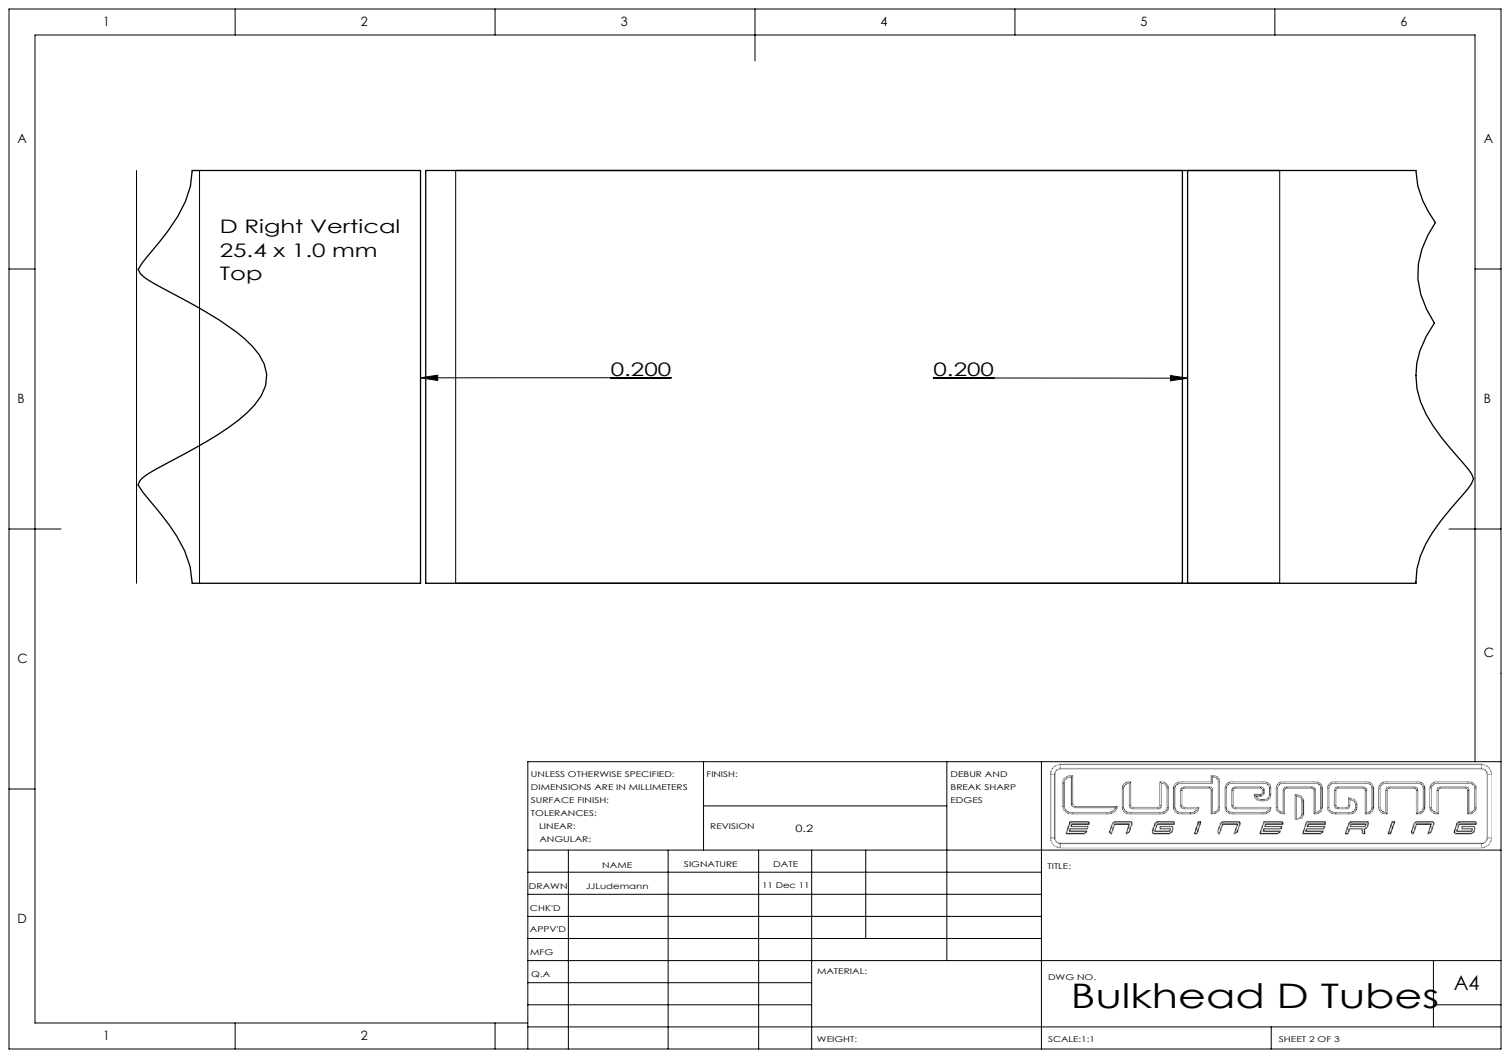
[picture p151: page 2]
D Right Vertical 25.4 x 1.0 mm; FINISH:; DEBUR AND; BREAK SHARP

UNLESS OTHERWISE SPECIFIED:
DIMENSIONS ARE IN MILLIMETERS
SURFACE FINISH:
TOLERANCES:
LINEAR:
ANGULAR:

NAME | SIGNATURE | DATE | | | | TITLE:

DRAWN | JJLudemann | | 11 Dec 11

CHK'D

APPV'D

MFG
Q.A | | | | MATERIAL: | DWG NO. Bulkhead D Tubes | A4

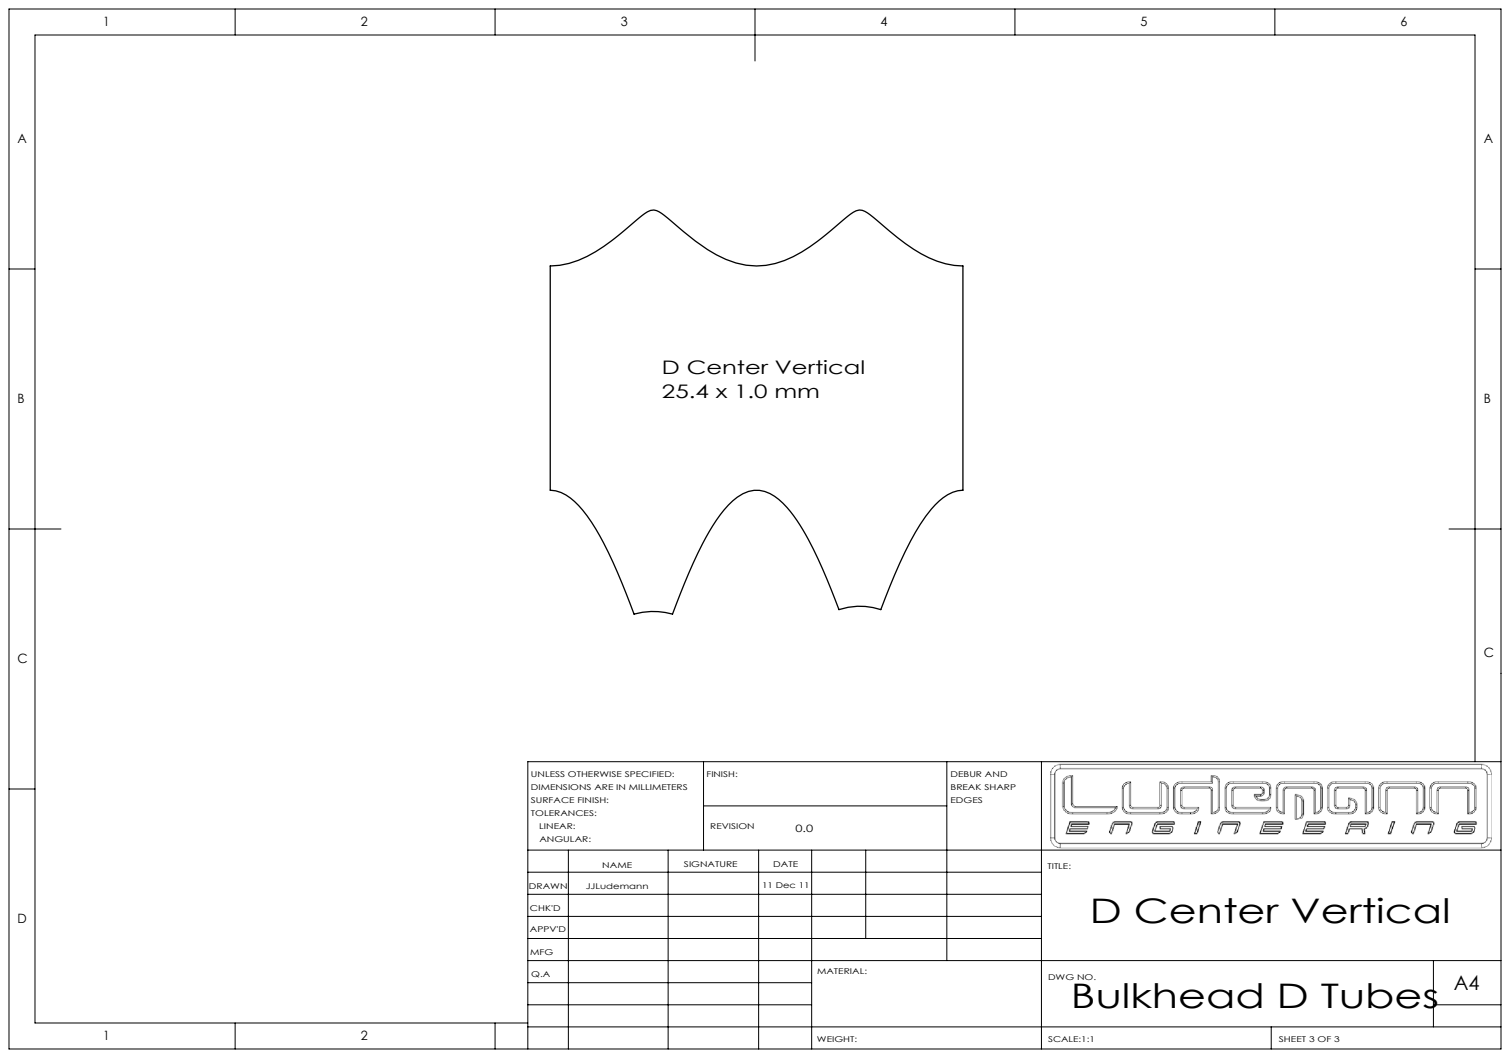
[picture p152: page 3]
D Center Vertical; FINISH:; DEBUR AND; BREAK SHARP

UNLESS OTHERWISE SPECIFIED:
DIMENSIONS ARE IN MILLIMETERS
SURFACE FINISH:
TOLERANCES:
LINEAR:
ANGULAR:

NAME | SIGNATURE | DATE | | | | TITLE: D Center Vertical

DRAWN | JJLudemann | | 11 Dec 11

CHK'D

APPV'D

MFG
Q.A | | | | MATERIAL: | DWG NO. Bulkhead D Tubes | A4
