LudemannEngineering/Formula-1000-Race-Car/Solidworks/Chassis/Tubes/PDFs/Bulkhead E Center Horiz Tubes.PDF

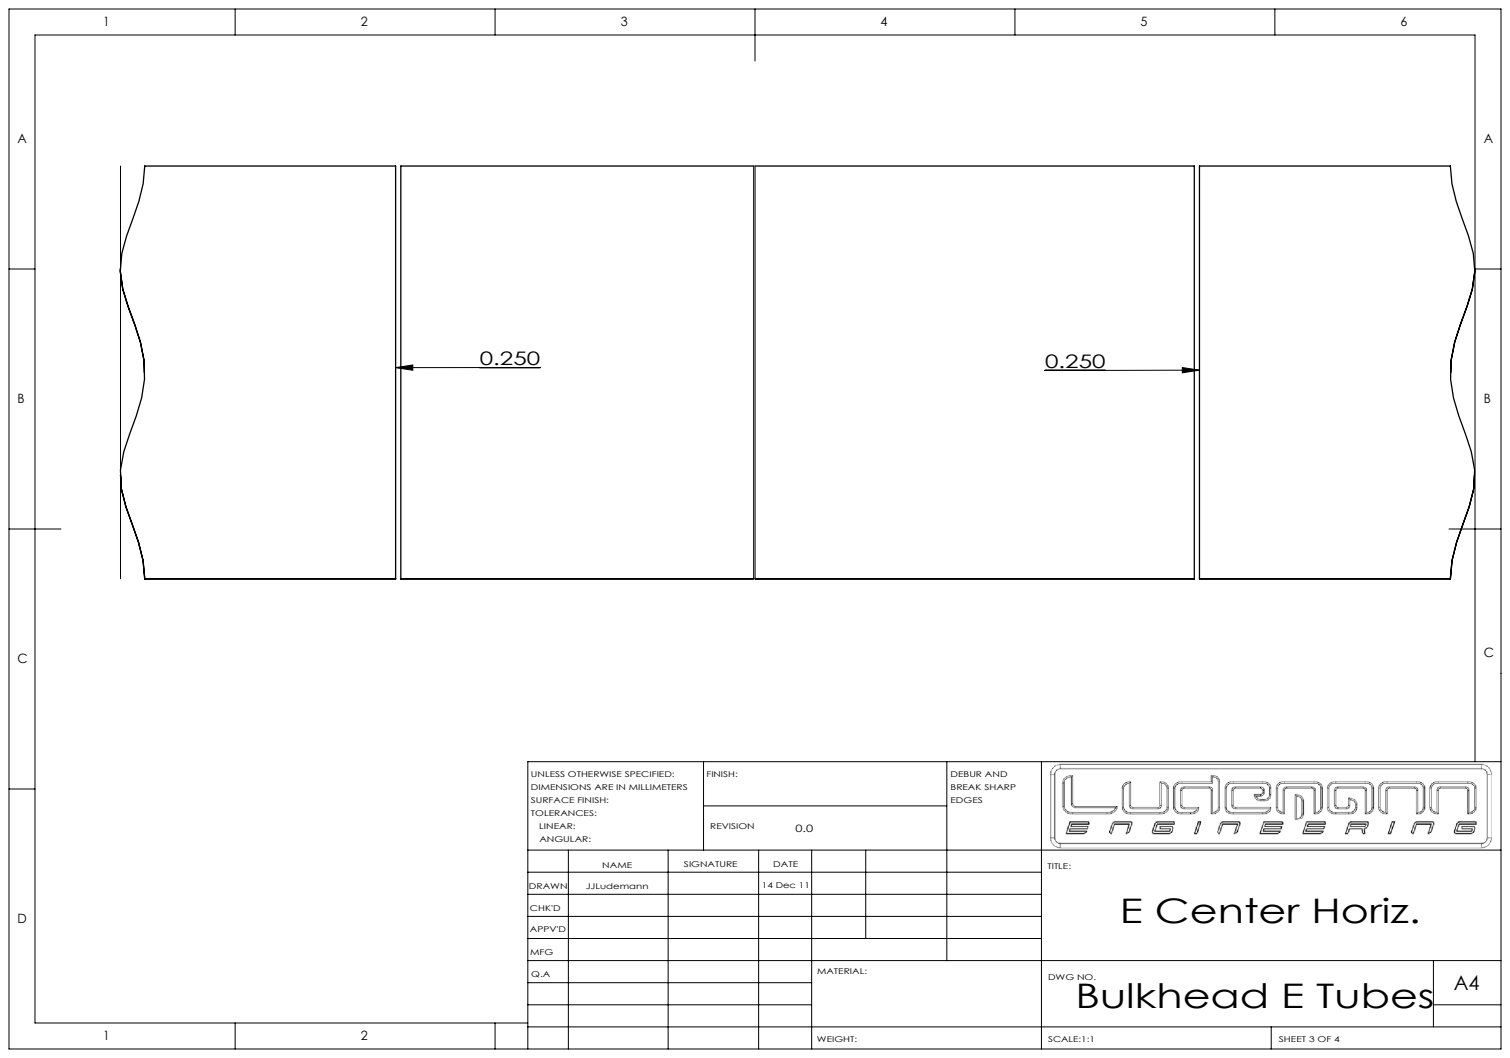
[picture p153: page 1]
FINISH:; DEBUR AND; BREAK SHARP; SCALE:1:1; SHEET 3 OF 4

UNLESS OTHERWISE SPECIFIED:
DIMENSIONS ARE IN MILLIMETERS
SURFACE FINISH:
TOLERANCES:
LINEAR:
ANGULAR:

NAME | SIGNATURE | DATE | | | | TITLE: E Center Horiz.

DRAWN | JJLudemann | | 14 Dec 11

CHK'D

APPV'D

MFG
Q.A | | | | MATERIAL: | DWG NO. Bulkhead E Tubes | A4

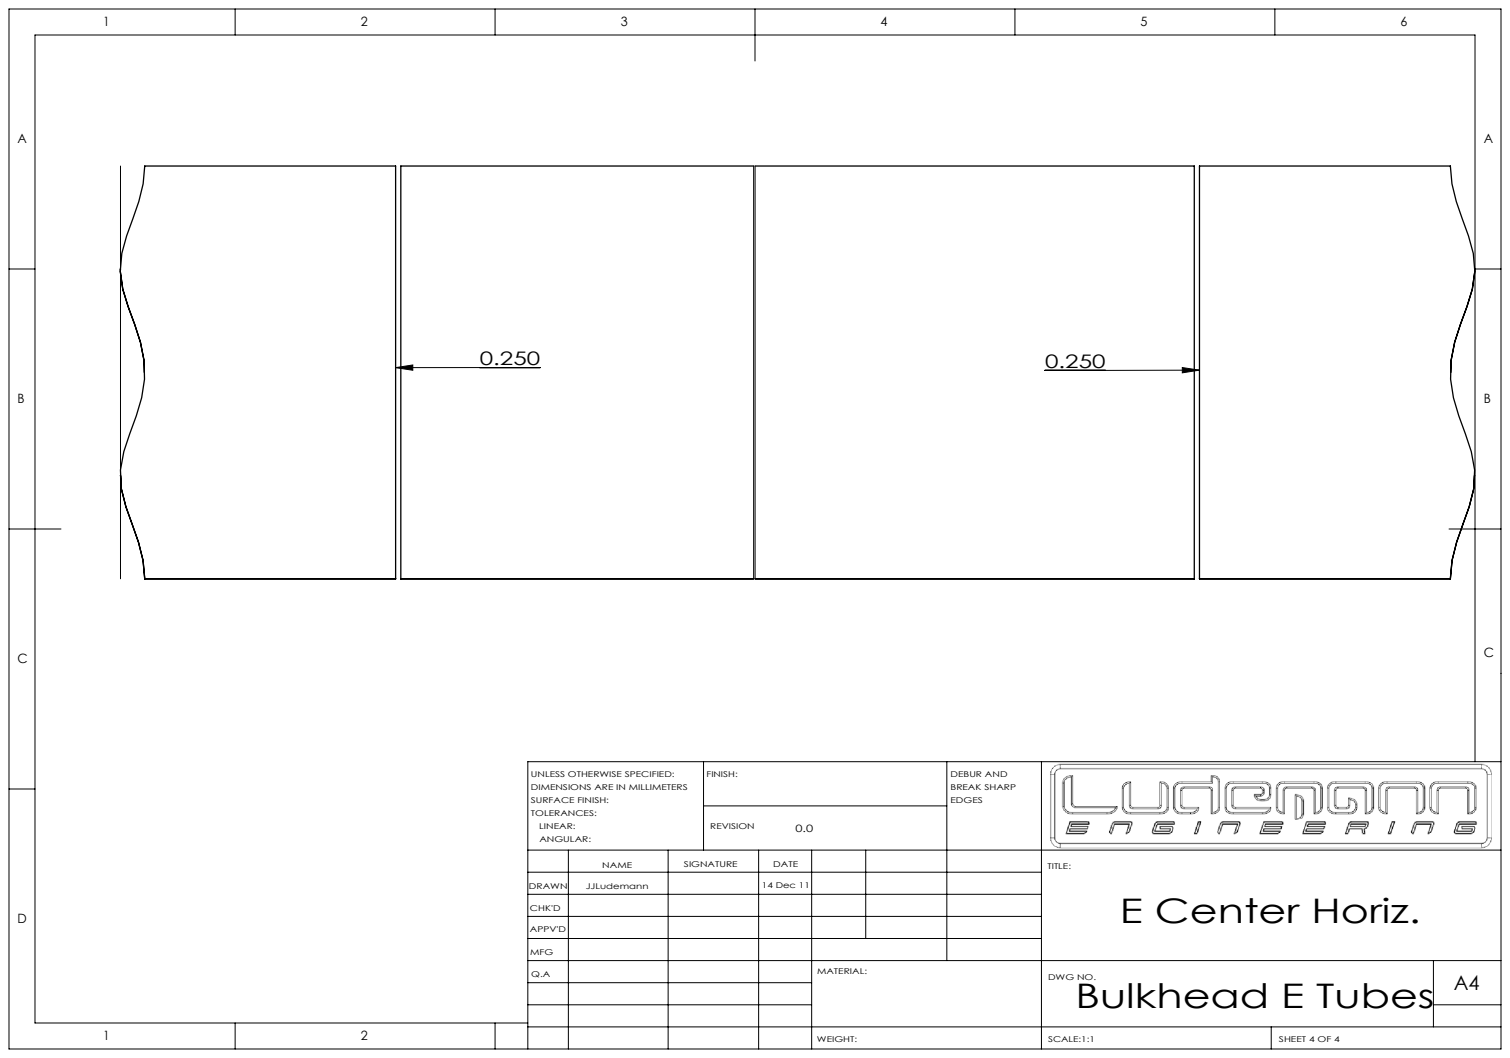
[picture p154: page 2]
FINISH:; DEBUR AND; BREAK SHARP; SCALE:1:1; SHEET 4 OF 4

UNLESS OTHERWISE SPECIFIED:
DIMENSIONS ARE IN MILLIMETERS
SURFACE FINISH:
TOLERANCES:
LINEAR:
ANGULAR:

NAME | SIGNATURE | DATE | | | | TITLE: E Center Horiz.

DRAWN | JJLudemann | | 14 Dec 11

CHK'D

APPV'D

MFG
Q.A | | | | MATERIAL: | DWG NO. Bulkhead E Tubes | A4
