LudemannEngineering/Formula-1000-Race-Car/Solidworks/Chassis/Tubes/PDFs/Bulkhead E to F Tubes.PDF

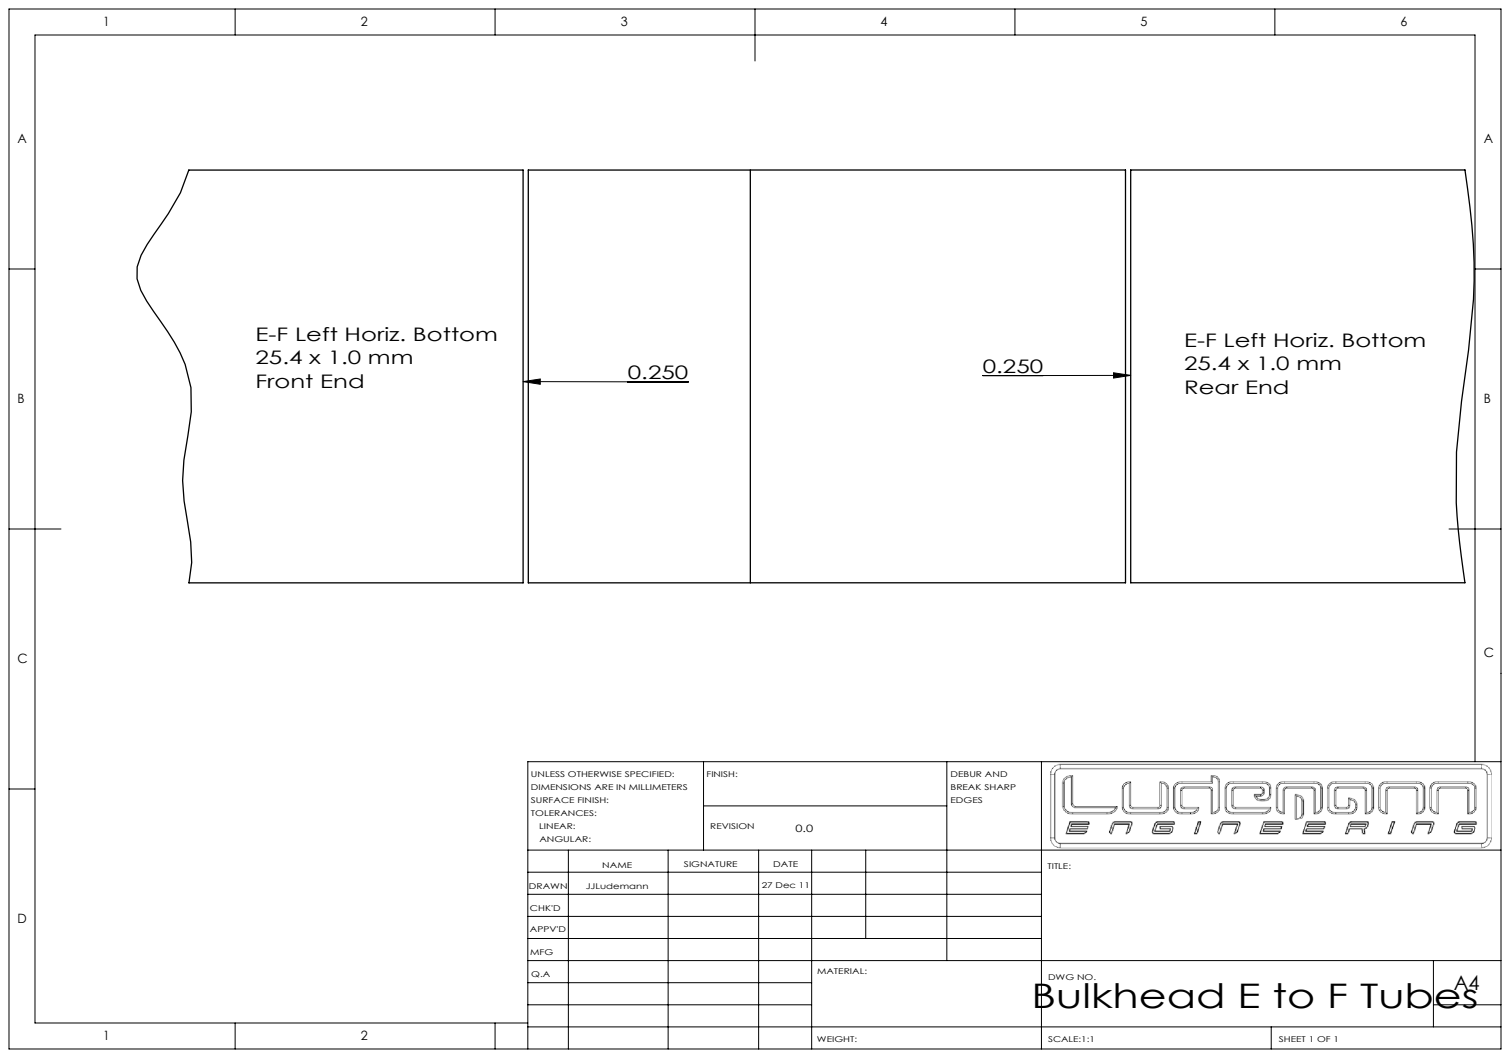
[picture p155: page 1]
Rear End B; FINISH:; DEBUR AND; BREAK SHARP; SCALE:1:1; SHEET 1 OF 1

E-F Left Horiz. Bottom
Front End

UNLESS OTHERWISE SPECIFIED:
DIMENSIONS ARE IN MILLIMETERS
SURFACE FINISH:
TOLERANCES:
LINEAR:
ANGULAR:

NAME | SIGNATURE | DATE | | | | TITLE:

DRAWN | JJLudemann | | 27 Dec 11

CHK'D

APPV'D

MFG
Q.A | | | | MATERIAL: Bulkhead E to F Tubes | DWG NO. | A4
