LudemannEngineering/Formula-1000-Race-Car/Solidworks/Chassis/Tubes/PDFs/Bulkhead E Tubes.PDF

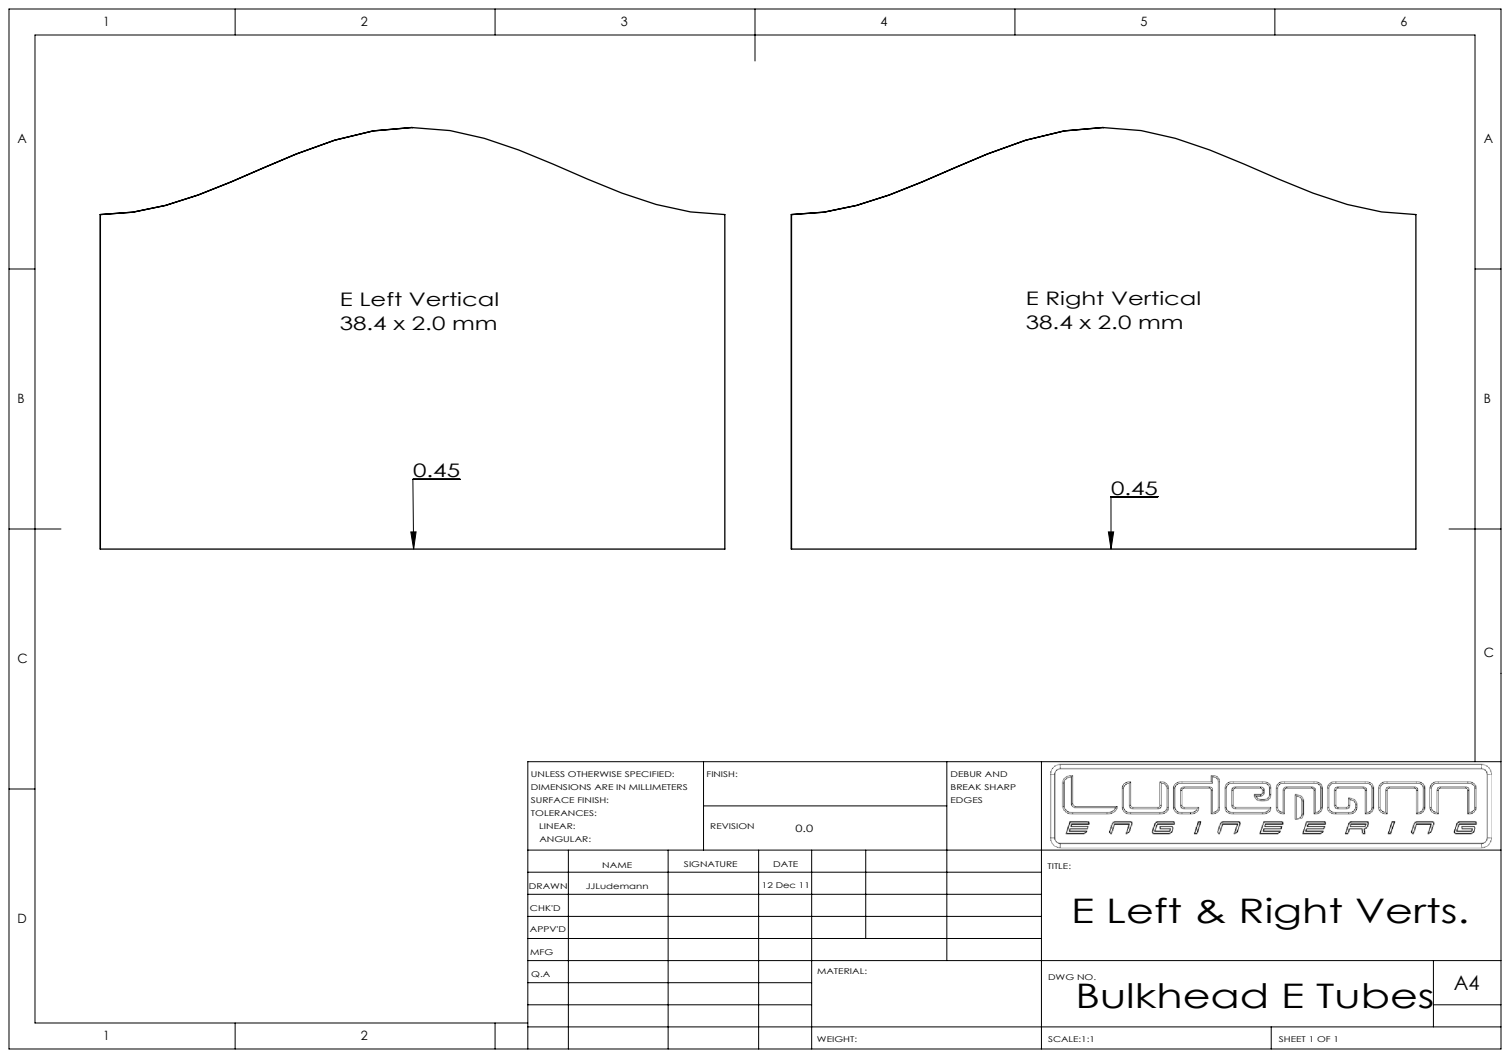
[picture p156: page 1]
E Left Vertical 38.4 x 2.0 mm; E Right Vertical 38.4 x 2.0 mm; FINISH:; DEBUR AND; BREAK SHARP; SCALE:1:1; SHEET 1 OF 1

UNLESS OTHERWISE SPECIFIED:
DIMENSIONS ARE IN MILLIMETERS
SURFACE FINISH:
TOLERANCES:
LINEAR:
ANGULAR:

NAME | SIGNATURE | DATE | | | | TITLE: E Left & Right Verts.

DRAWN | JJLudemann | | 12 Dec 11

CHK'D

APPV'D

MFG
Q.A | | | | MATERIAL: | DWG NO. Bulkhead E Tubes | A4
