LudemannEngineering/Formula-1000-Race-Car/Solidworks/Chassis/Tubes/PDFs/Bulkhead Sections.PDF

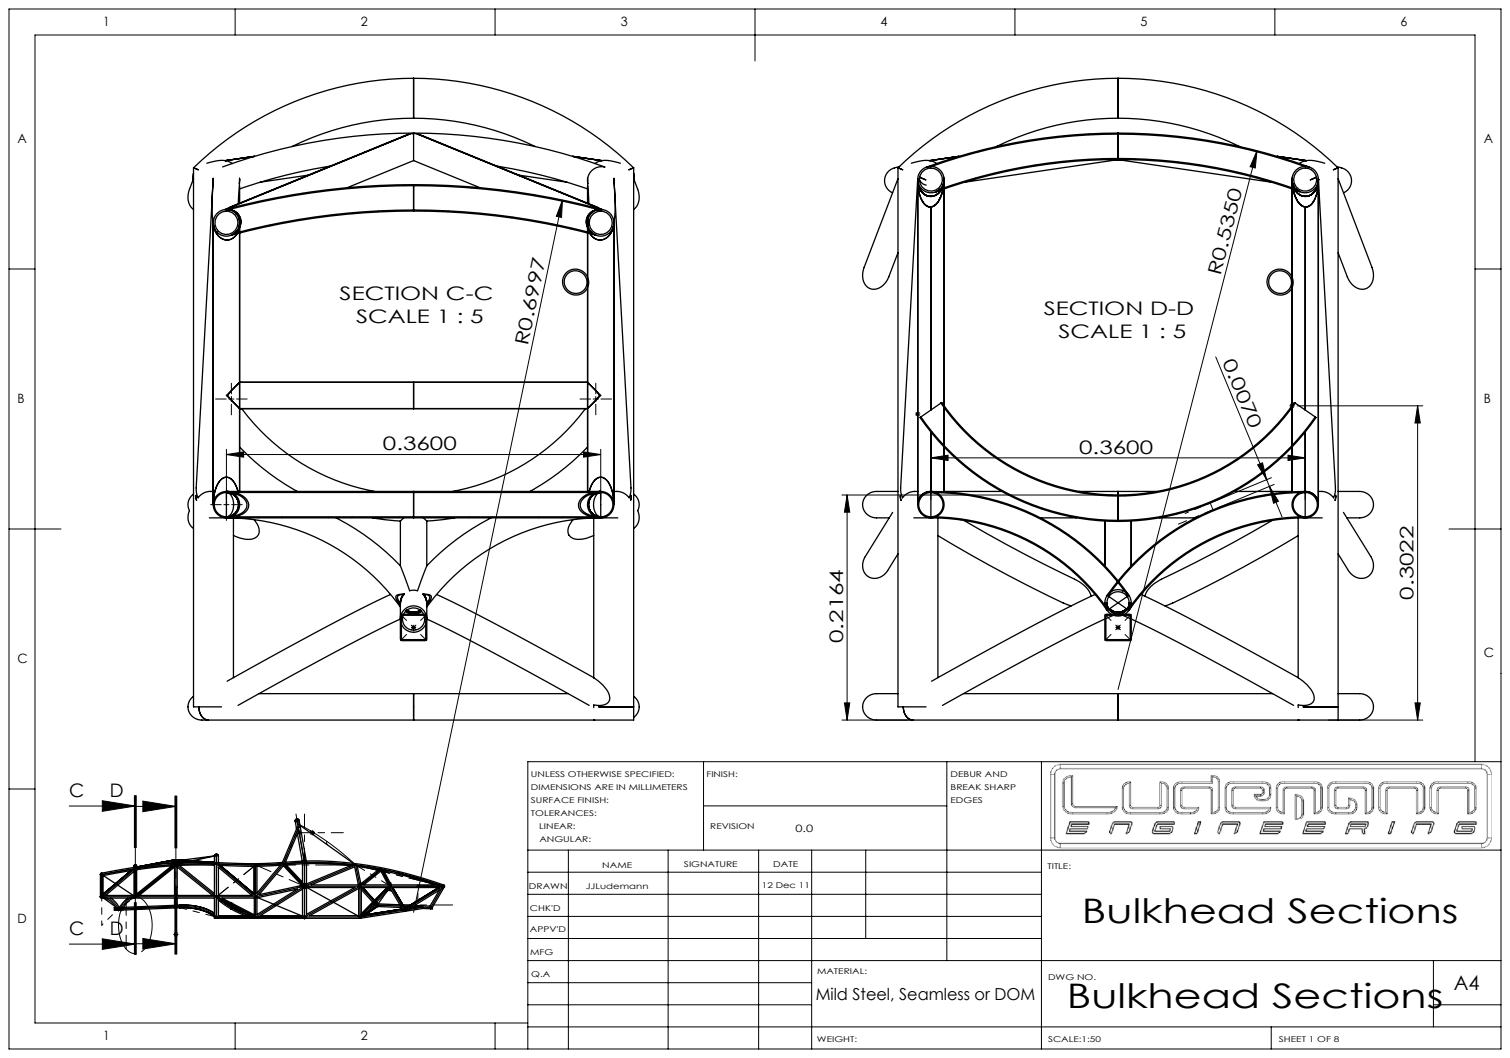
[picture p157: page 1]
SECTION C-C SCALE 1 : 5; SECTION D-D SCALE 1 : 5; FINISH:; DEBUR AND; BREAK SHARP; SCALE:1:50; SHEET 1 OF 8

UNLESS OTHERWISE SPECIFIED:
DIMENSIONS ARE IN MILLIMETERS
SURFACE FINISH:
TOLERANCES:
LINEAR:
ANGULAR:

NAME | SIGNATURE | DATE | | | | TITLE: Bulkhead Sections

DRAWN | JJLudemann | | 12 Dec 11

CHK'D

APPV'D

MFG
Q.A | | | | MATERIAL: Mild Steel, Seamless or DOM | DWG NO. Bulkhead Sections | A4

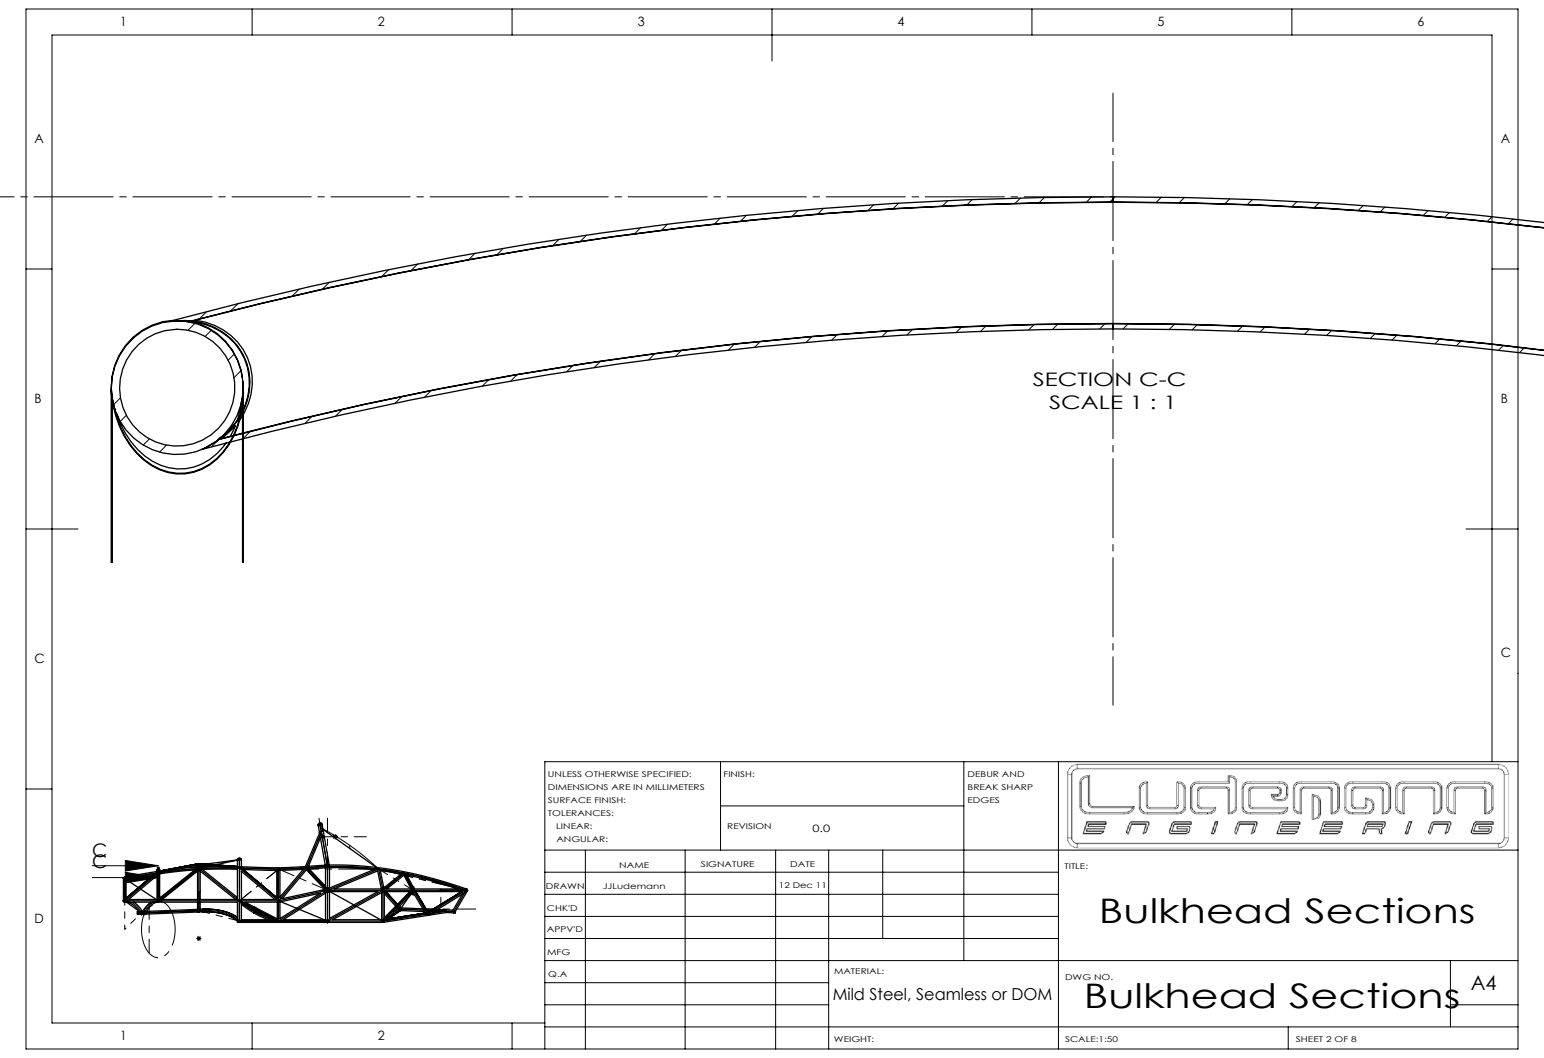
[picture p158: page 2]
SECTION C-C SCALE 1 : 1 B; FINISH:; DEBUR AND; BREAK SHARP

UNLESS OTHERWISE SPECIFIED:
DIMENSIONS ARE IN MILLIMETERS
SURFACE FINISH:
TOLERANCES:
LINEAR:
ANGULAR:

NAME | SIGNATURE | DATE | | | | TITLE: Bulkhead Sections

DRAWN | JJLudemann | | 12 Dec 11

CHK'D

APPV'D

MFG
Q.A | | | | MATERIAL: | DWG NO. Bulkhead Sections | A4

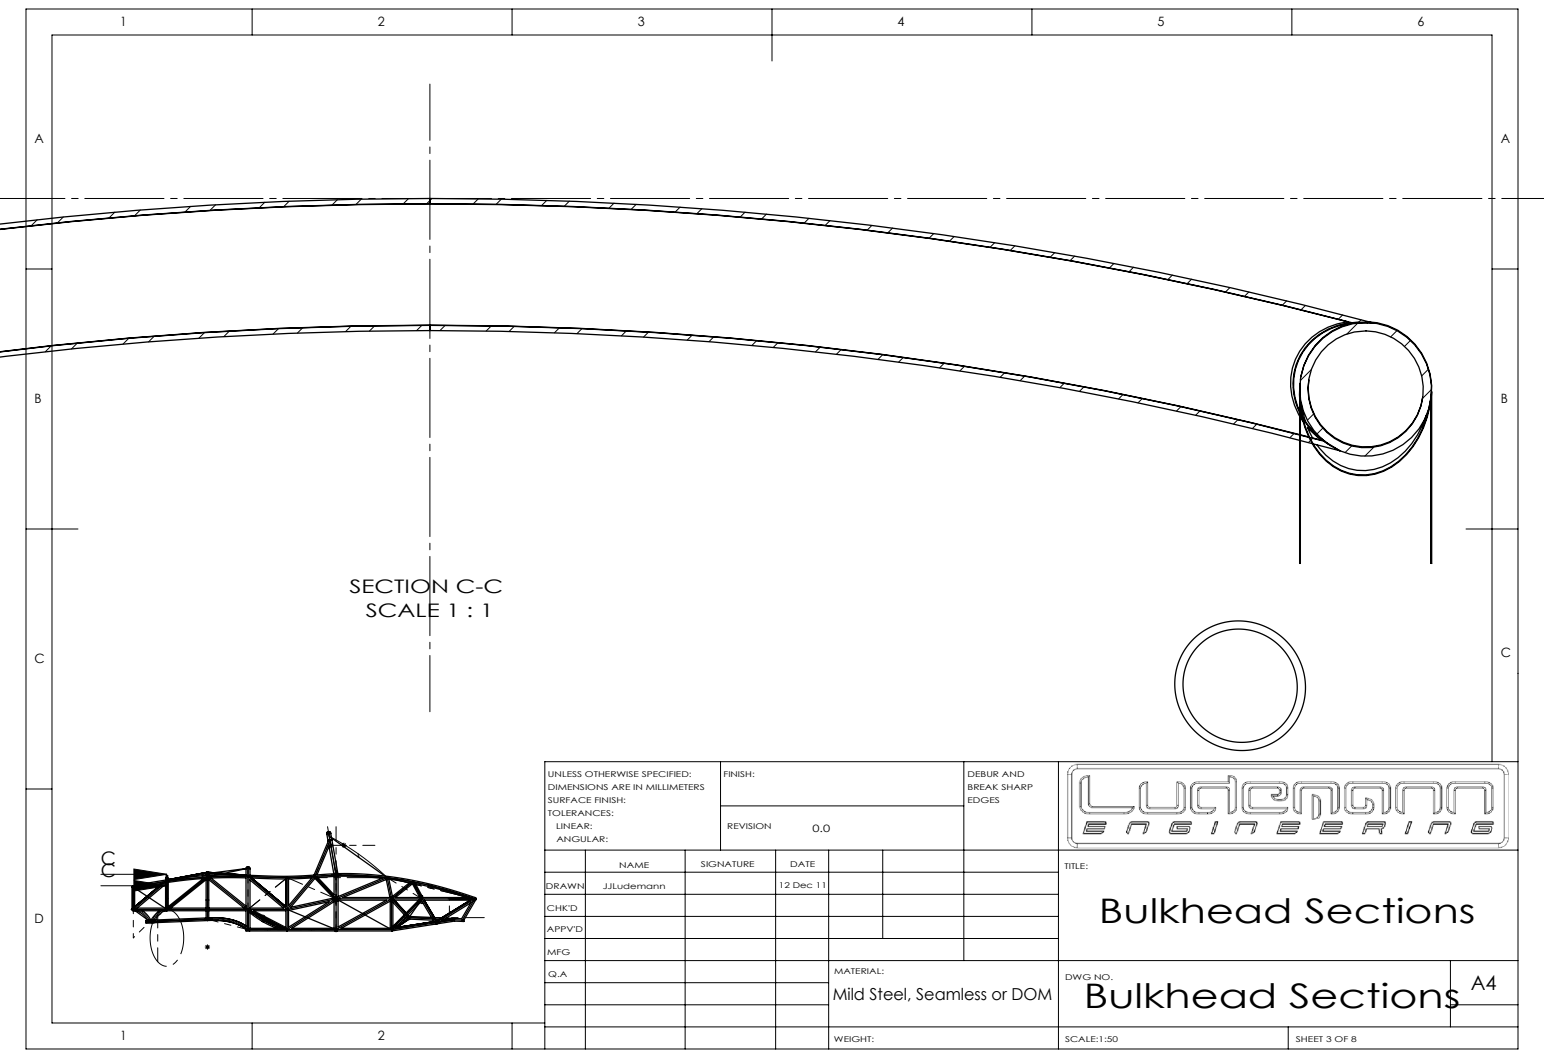
[picture p159: page 3]
SECTION C-C SCALE 1 : 1; FINISH:; DEBUR AND; BREAK SHARP

UNLESS OTHERWISE SPECIFIED:
DIMENSIONS ARE IN MILLIMETERS
SURFACE FINISH:
TOLERANCES:
LINEAR:
ANGULAR:

NAME | SIGNATURE | DATE | | | | TITLE: Bulkhead Sections

DRAWN | JJLudemann | | 12 Dec 11

CHK'D

APPV'D

MFG
Q.A | | | | MATERIAL: | DWG NO. Bulkhead Sections | A4

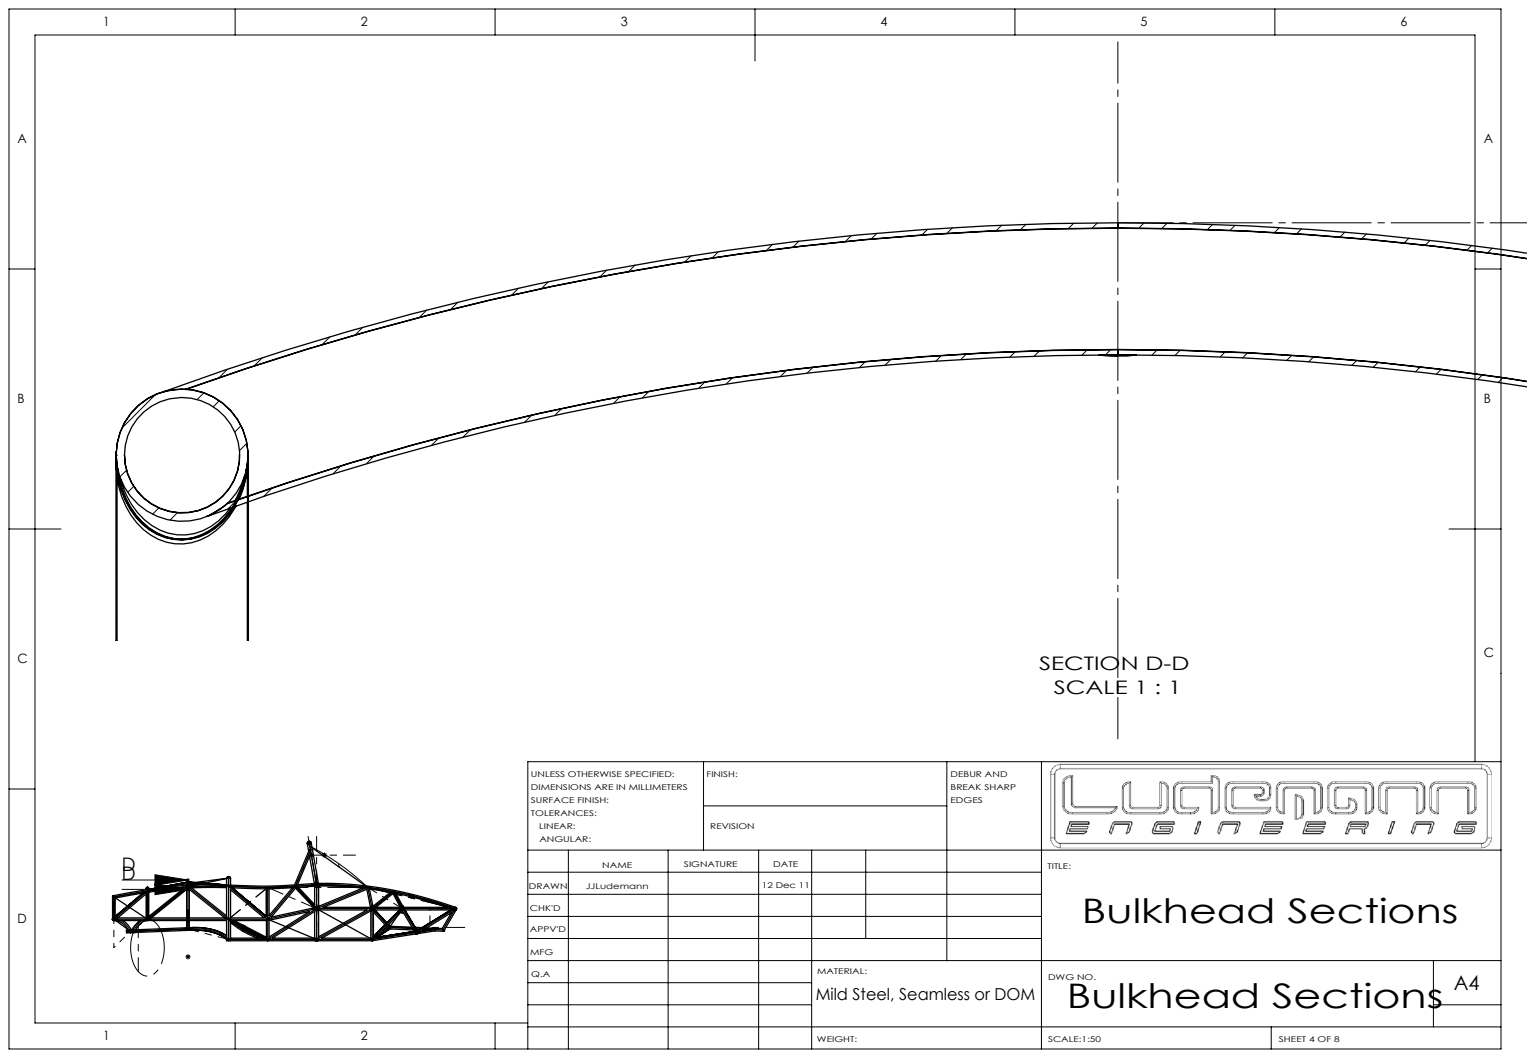
[picture p160: page 4]
SECTION D-D SCALE 1 : 1; FINISH:; DEBUR AND; BREAK SHARP

UNLESS OTHERWISE SPECIFIED:
DIMENSIONS ARE IN MILLIMETERS
SURFACE FINISH:
TOLERANCES:
LINEAR:
ANGULAR:

NAME | SIGNATURE | DATE | | | | TITLE: Bulkhead Sections

DRAWN | JJLudemann | | 12 Dec 11

CHK'D

APPV'D

MFG
Q.A | | | | MATERIAL: | DWG NO. Bulkhead Sections | A4

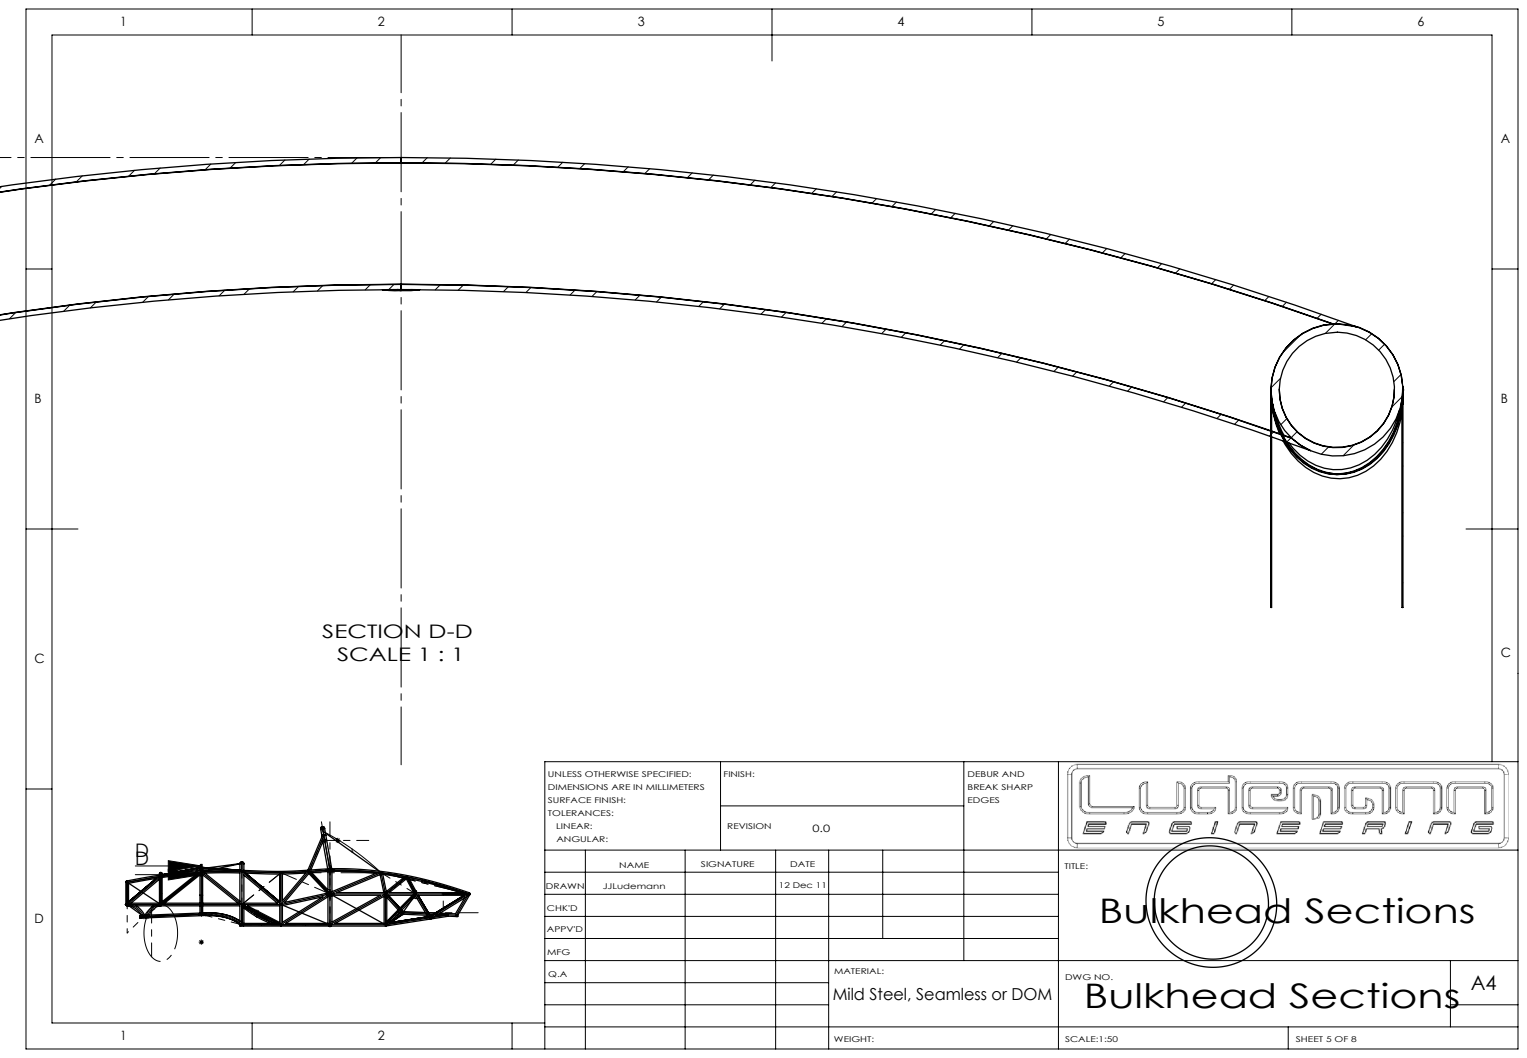
[picture p161: page 5]
SECTION D-D SCALE 1 : 1; FINISH:; DEBUR AND; BREAK SHARP

UNLESS OTHERWISE SPECIFIED:
DIMENSIONS ARE IN MILLIMETERS
SURFACE FINISH:
TOLERANCES:
LINEAR:
ANGULAR:

NAME | SIGNATURE | DATE | | | | TITLE: Bulkhead Sections

DRAWN | JJLudemann | | 12 Dec 11

CHK'D

APPV'D

MFG
Q.A | | | | MATERIAL: | DWG NO. Bulkhead Sections | A4

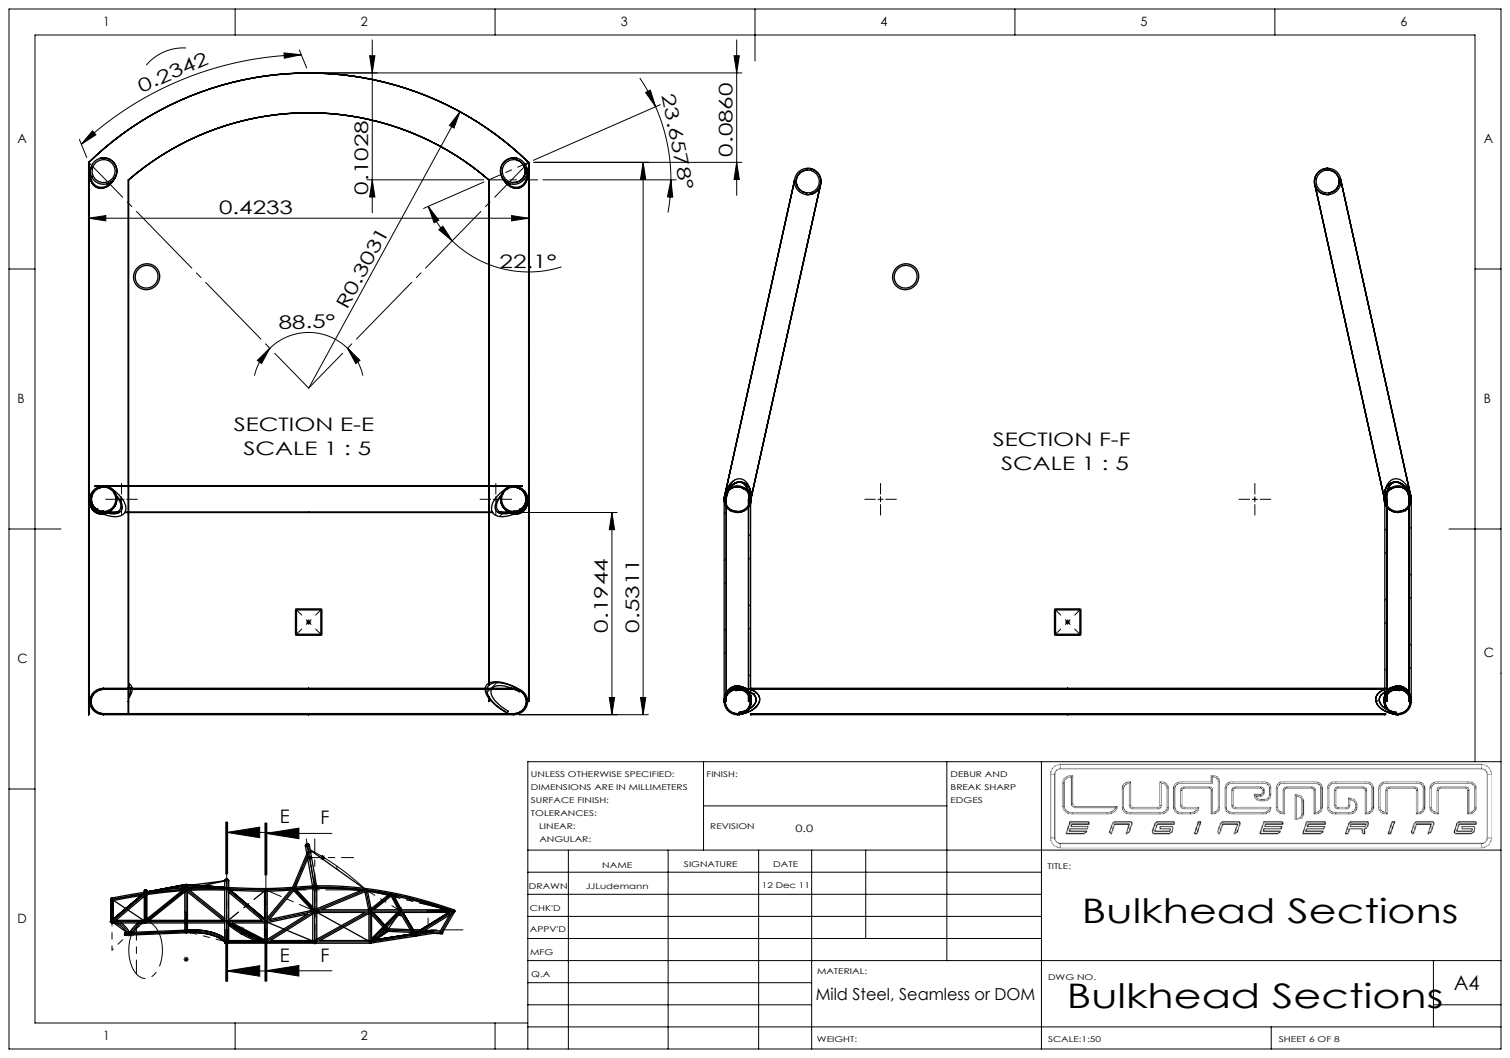
[picture p162: page 6]
SECTION E-E; SCALE 1 : 5; SECTION F-F; FINISH:; DEBUR AND; BREAK SHARP; DWG NO. Bulkhead Sections

UNLESS OTHERWISE SPECIFIED:
DIMENSIONS ARE IN MILLIMETERS
SURFACE FINISH:
TOLERANCES:
LINEAR:
ANGULAR:

NAME | SIGNATURE | DATE | TITLE: Bulkhead Sections

DRAWN | JJLudemann | | 12 Dec 11

CHK'D

APPV'D

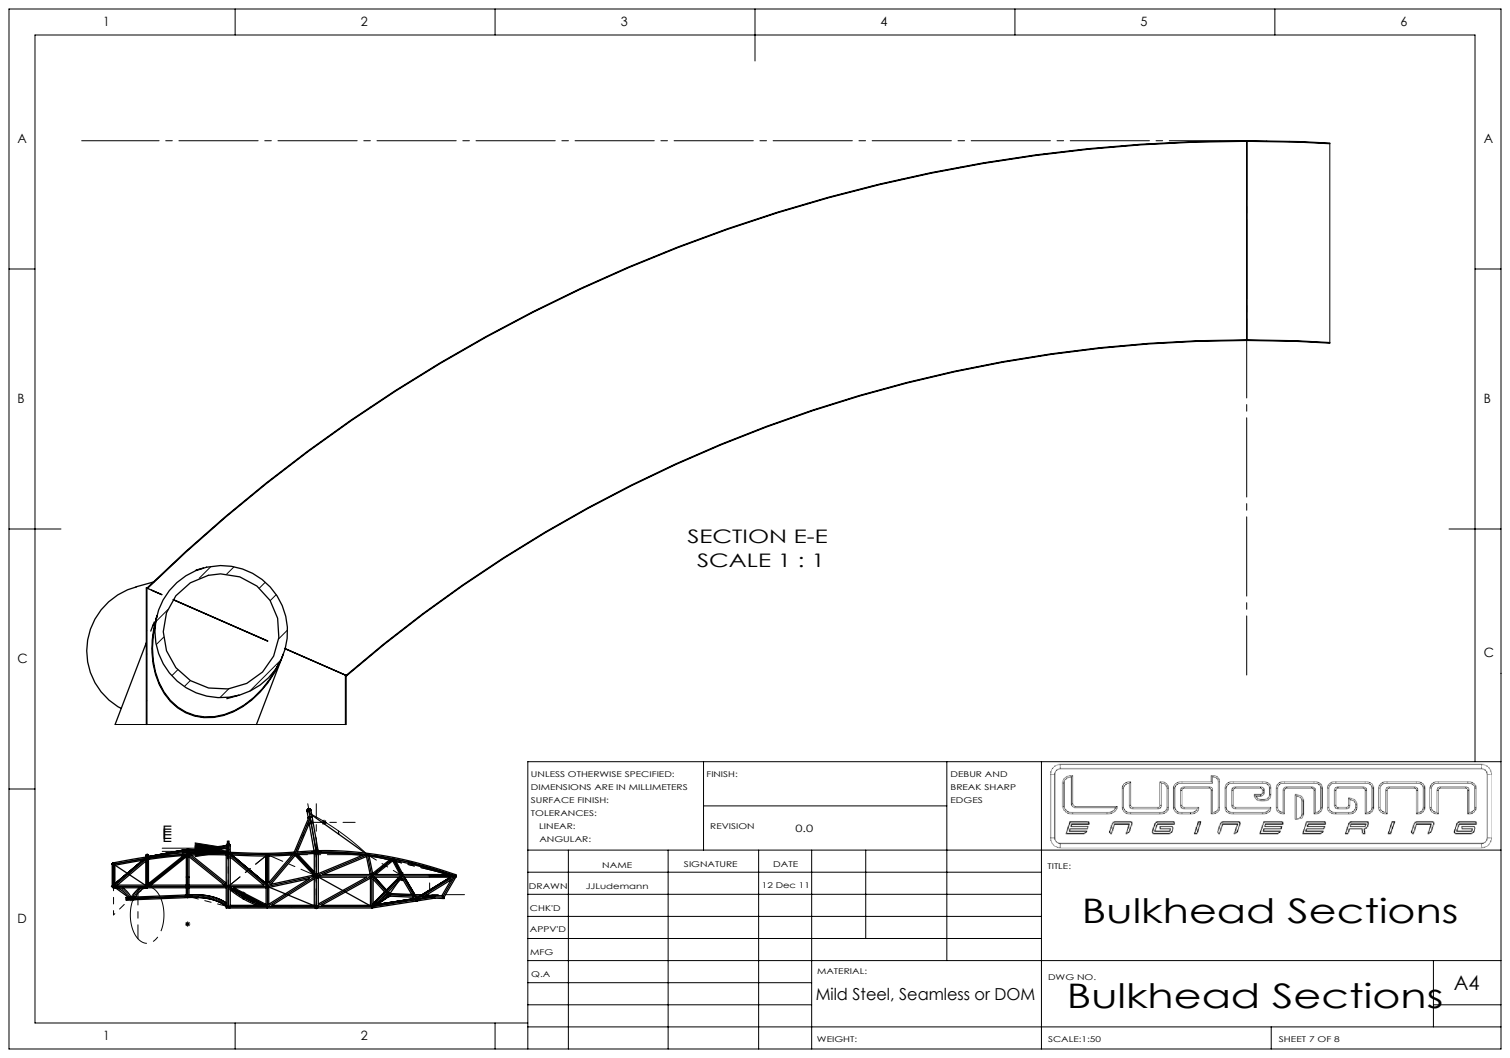
[picture p163: page 7]
SECTION E-E SCALE 1 : 1; FINISH:; DEBUR AND; BREAK SHARP

UNLESS OTHERWISE SPECIFIED:
DIMENSIONS ARE IN MILLIMETERS
SURFACE FINISH:
TOLERANCES:
LINEAR:
ANGULAR:

NAME | SIGNATURE | DATE | | | | TITLE: Bulkhead Sections

DRAWN | JJLudemann | | 12 Dec 11

CHK'D

APPV'D

MFG
Q.A | | | | MATERIAL: | DWG NO. Bulkhead Sections | A4

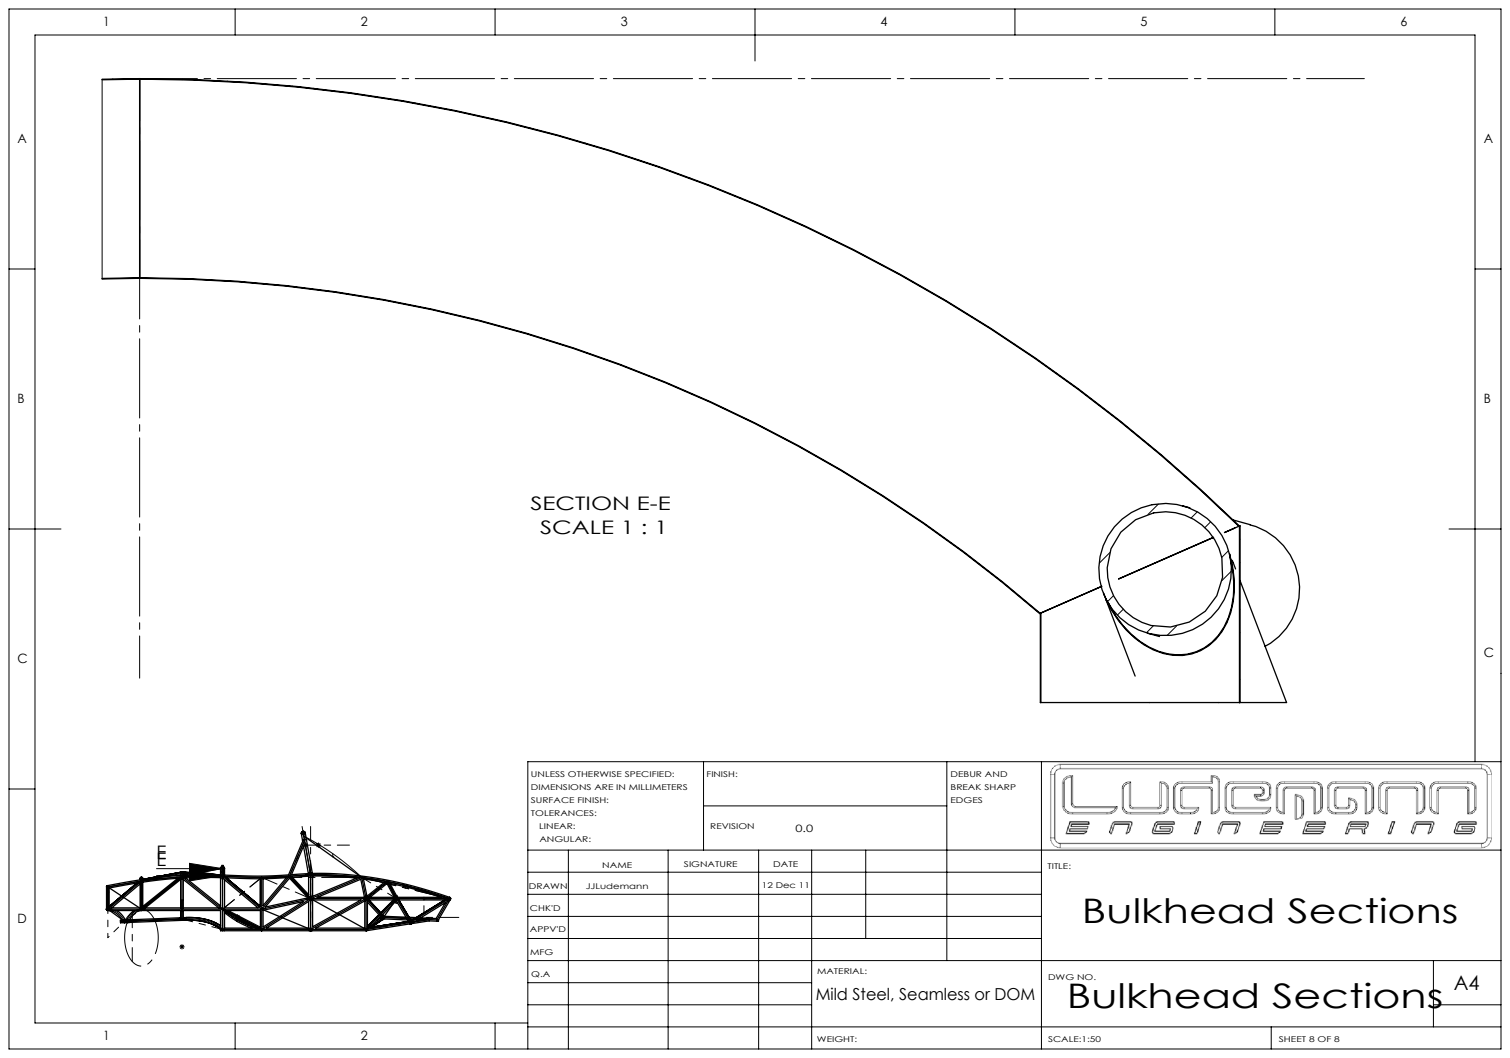
[picture p164: page 8]
SECTION E-E SCALE 1 : 1; FINISH:; DEBUR AND; BREAK SHARP

UNLESS OTHERWISE SPECIFIED:
DIMENSIONS ARE IN MILLIMETERS
SURFACE FINISH:
TOLERANCES:
LINEAR:
ANGULAR:

NAME | SIGNATURE | DATE | | | | TITLE: Bulkhead Sections

DRAWN | JJLudemann | | 12 Dec 11

CHK'D

APPV'D

MFG
Q.A | | | | MATERIAL: | DWG NO. Bulkhead Sections | A4
