LudemannEngineering/Formula-1000-Race-Car/Solidworks/Chassis/Tubes/PDFs/C-D.PDF

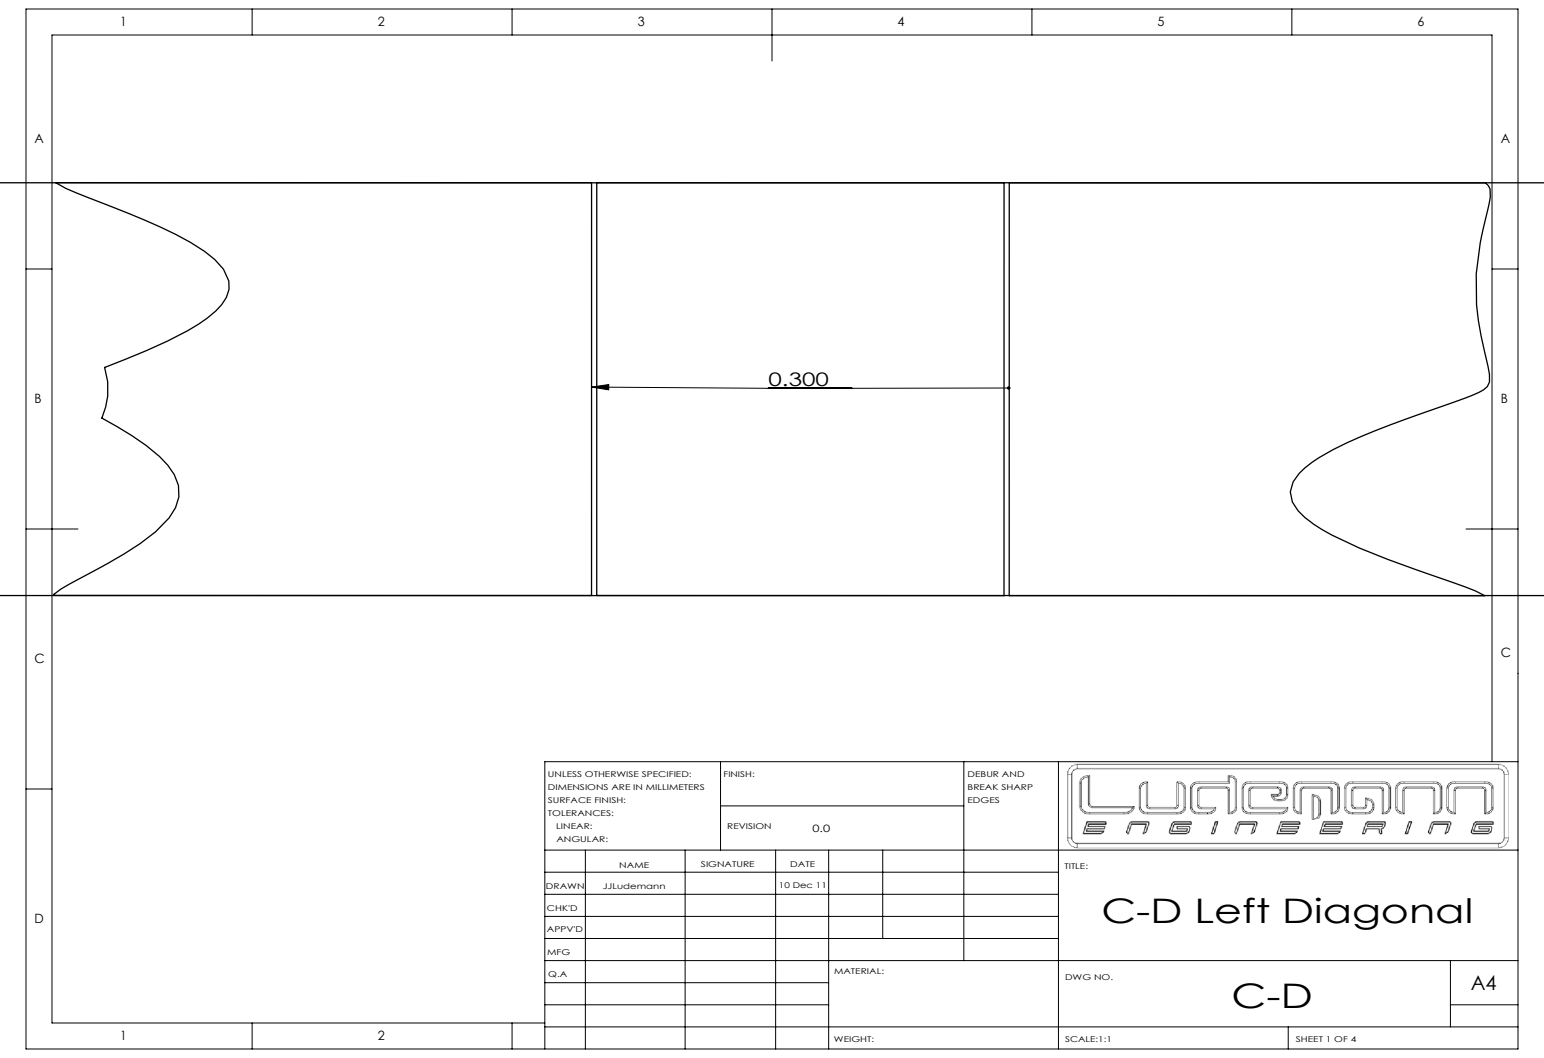
[picture p165: page 1]
FINISH:; DEBUR AND; BREAK SHARP; SCALE:1:1; SHEET 1 OF 4

UNLESS OTHERWISE SPECIFIED:
DIMENSIONS ARE IN MILLIMETERS
SURFACE FINISH:
TOLERANCES:
LINEAR:
ANGULAR:

NAME | SIGNATURE | DATE | | | | TITLE: C-D Left Diagonal

DRAWN | JJLudemann | | 10 Dec 11

CHK'D

APPV'D

MFG
Q.A | | | | MATERIAL: | DWG NO. C-D | A4

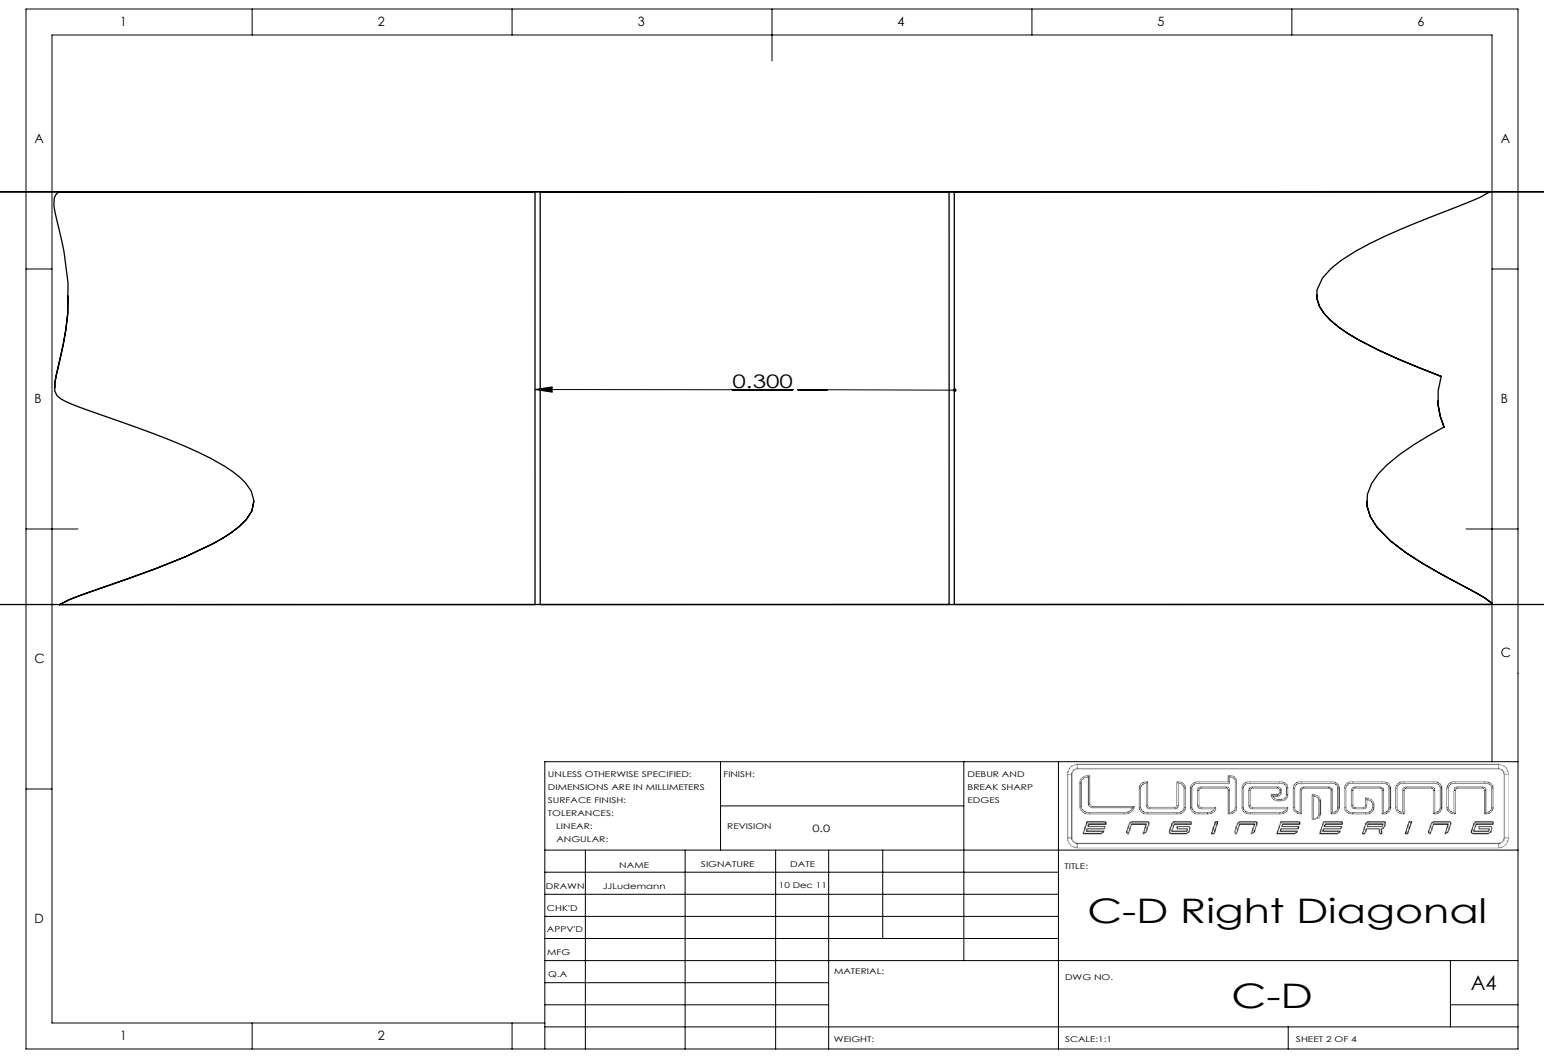
[picture p166: page 2]
FINISH:; DEBUR AND; BREAK SHARP

UNLESS OTHERWISE SPECIFIED:
DIMENSIONS ARE IN MILLIMETERS
SURFACE FINISH:
TOLERANCES:
LINEAR:
ANGULAR:

NAME | SIGNATURE | DATE | | | | TITLE: C-D Right Diagonal

DRAWN | JJLudemann | | 10 Dec 11

CHK'D

APPV'D

MFG
Q.A | | | | MATERIAL: | DWG NO. C-D | A4

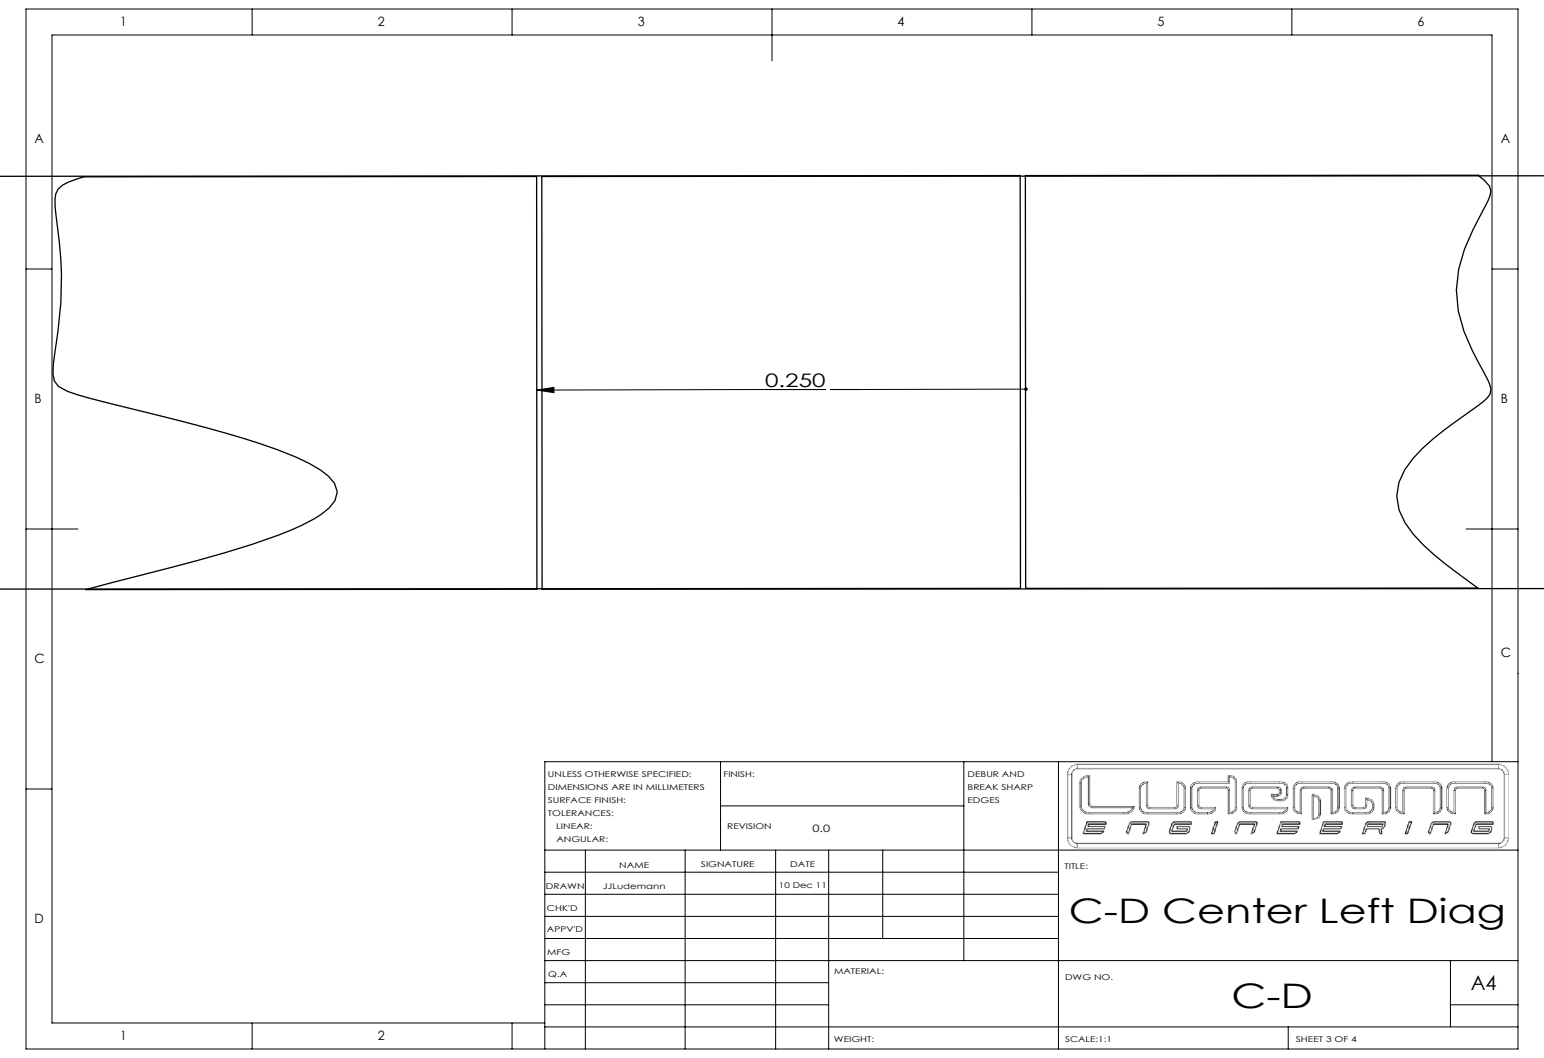
[picture p167: page 3]
FINISH:; DEBUR AND; BREAK SHARP

UNLESS OTHERWISE SPECIFIED:
DIMENSIONS ARE IN MILLIMETERS
SURFACE FINISH:
TOLERANCES:
LINEAR:
ANGULAR:

NAME | SIGNATURE | DATE | | | | TITLE: C-D Center Left Diag

DRAWN | JJLudemann | | 10 Dec 11

CHK'D

APPV'D

MFG
Q.A | | | | MATERIAL: | DWG NO. C-D | A4

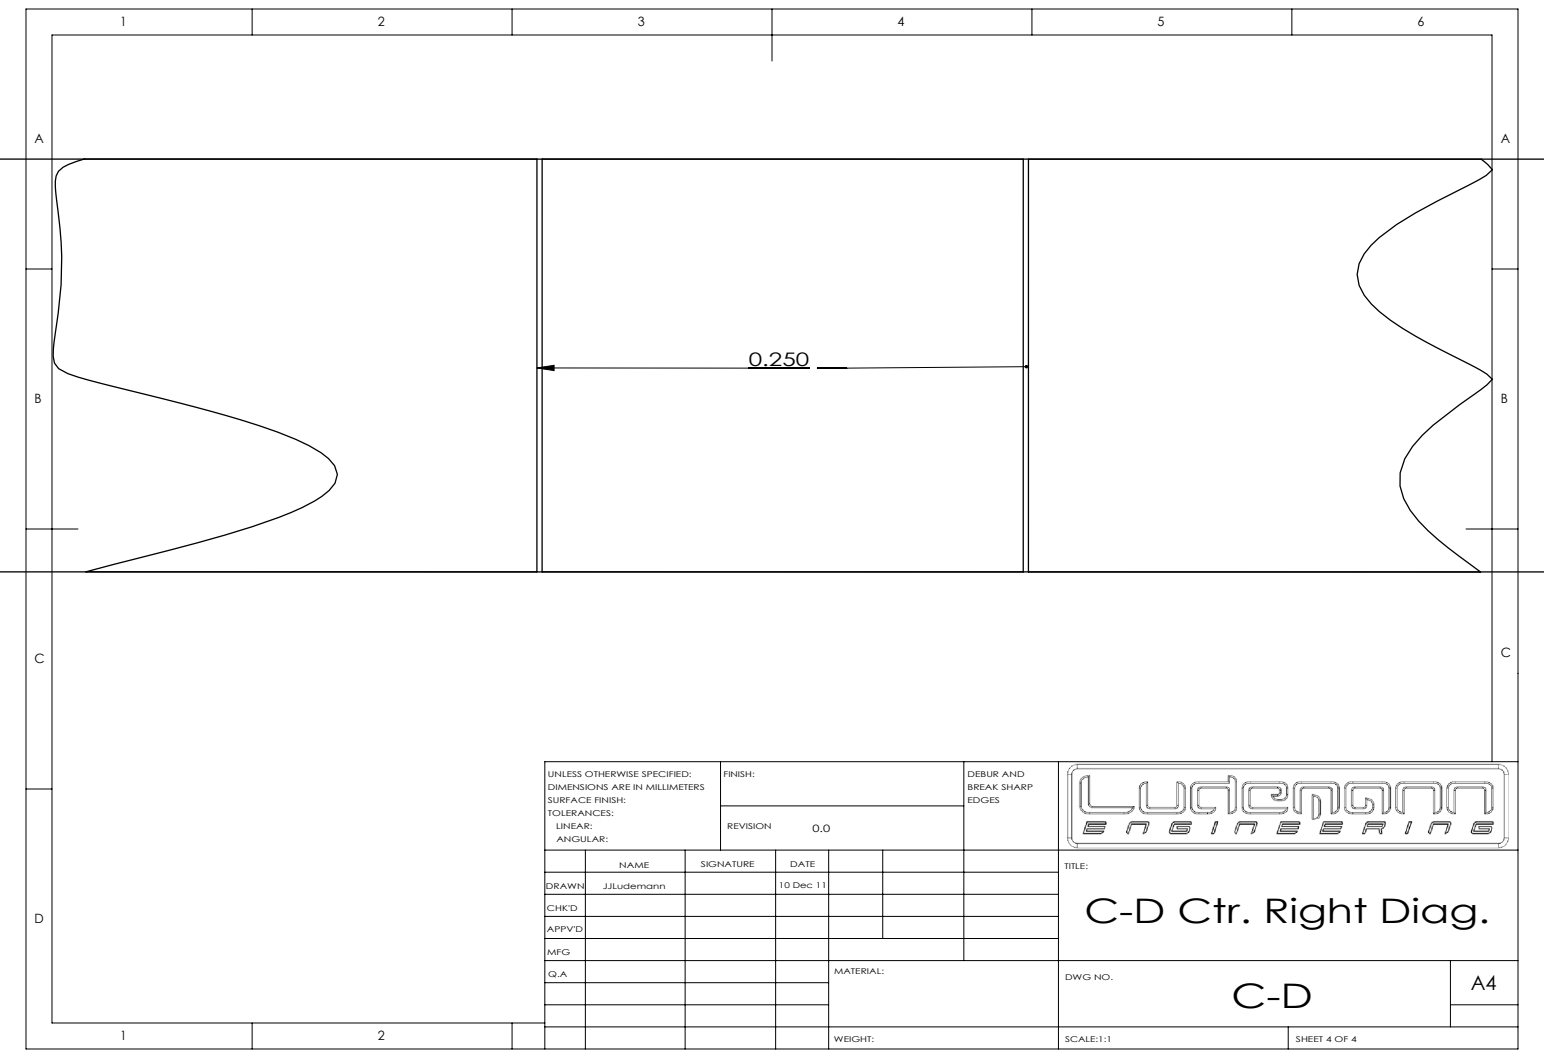
[picture p168: page 4]
FINISH:; DEBUR AND; BREAK SHARP

UNLESS OTHERWISE SPECIFIED:
DIMENSIONS ARE IN MILLIMETERS
SURFACE FINISH:
TOLERANCES:
LINEAR:
ANGULAR:

NAME | SIGNATURE | DATE | | | | TITLE: C-D Ctr. Right Diag.

DRAWN | JJLudemann | | 10 Dec 11

CHK'D

APPV'D

MFG
Q.A | | | | MATERIAL: | DWG NO. C-D | A4
