LudemannEngineering/Formula-1000-Race-Car/Solidworks/Chassis/Tubes/PDFs/C.PDF

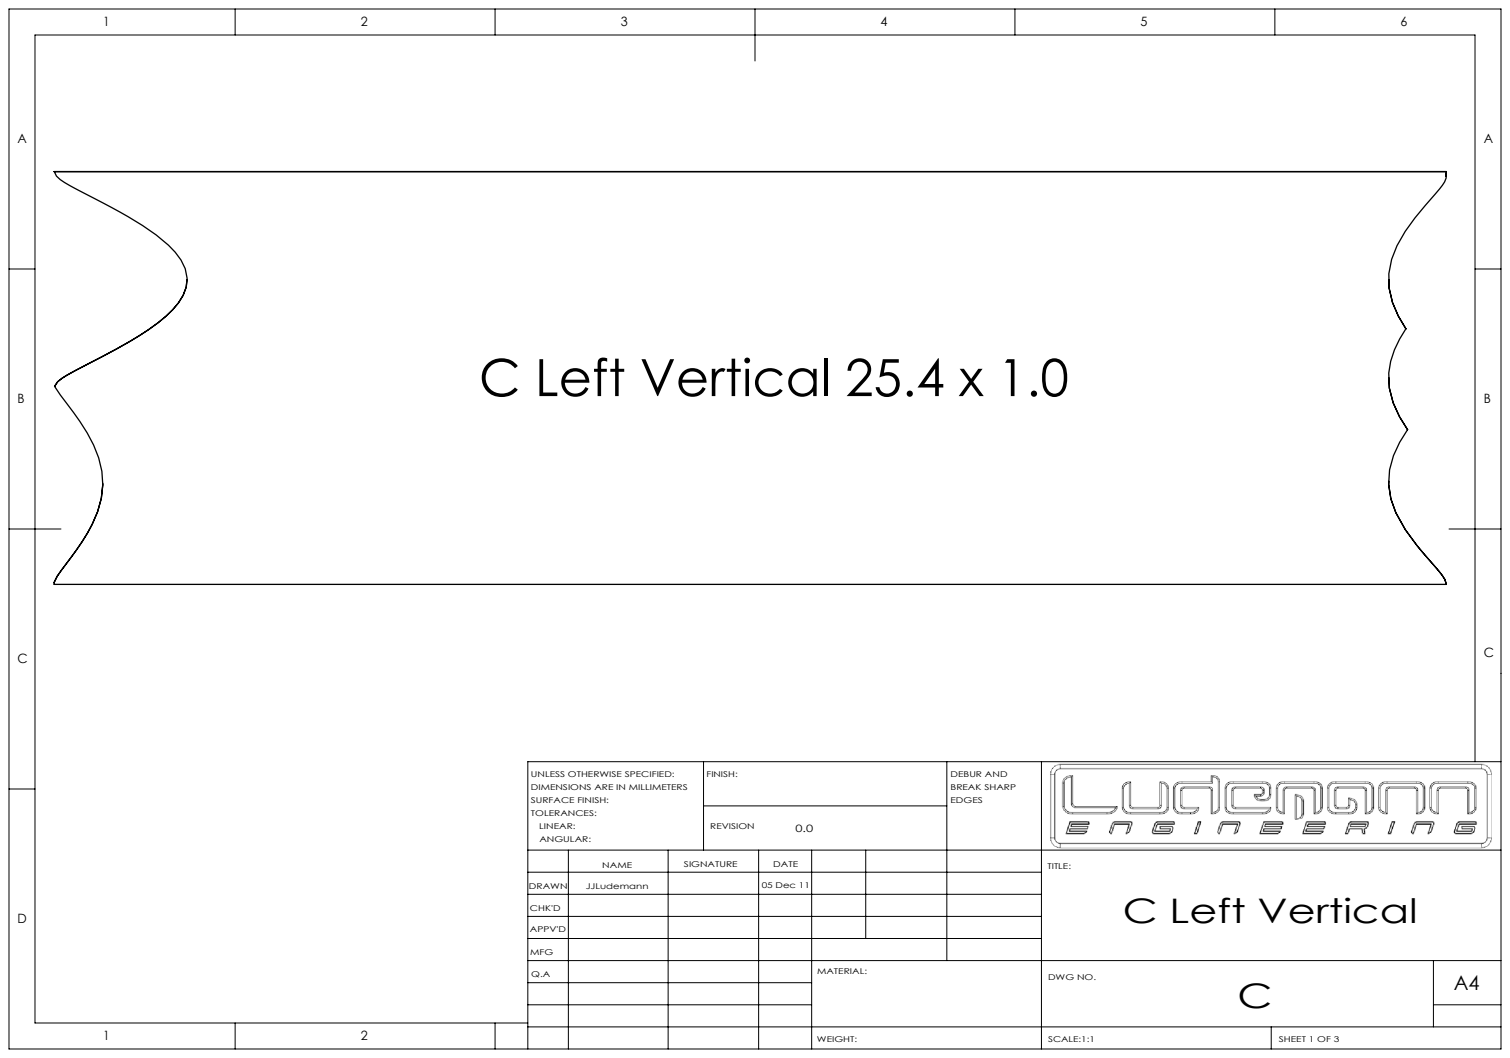
[picture p169: page 1]
C Left Vertical 25.4 x 1.0; FINISH:; DEBUR AND; BREAK SHARP; SCALE:1:1; SHEET 1 OF 3

UNLESS OTHERWISE SPECIFIED:
DIMENSIONS ARE IN MILLIMETERS
SURFACE FINISH:
TOLERANCES:
LINEAR:
ANGULAR:

NAME | SIGNATURE | DATE | | | | TITLE: C Left Vertical

DRAWN | JJLudemann | | 05 Dec 11

CHK'D

APPV'D

MFG
Q.A | | | | MATERIAL: | DWG NO. C | A4

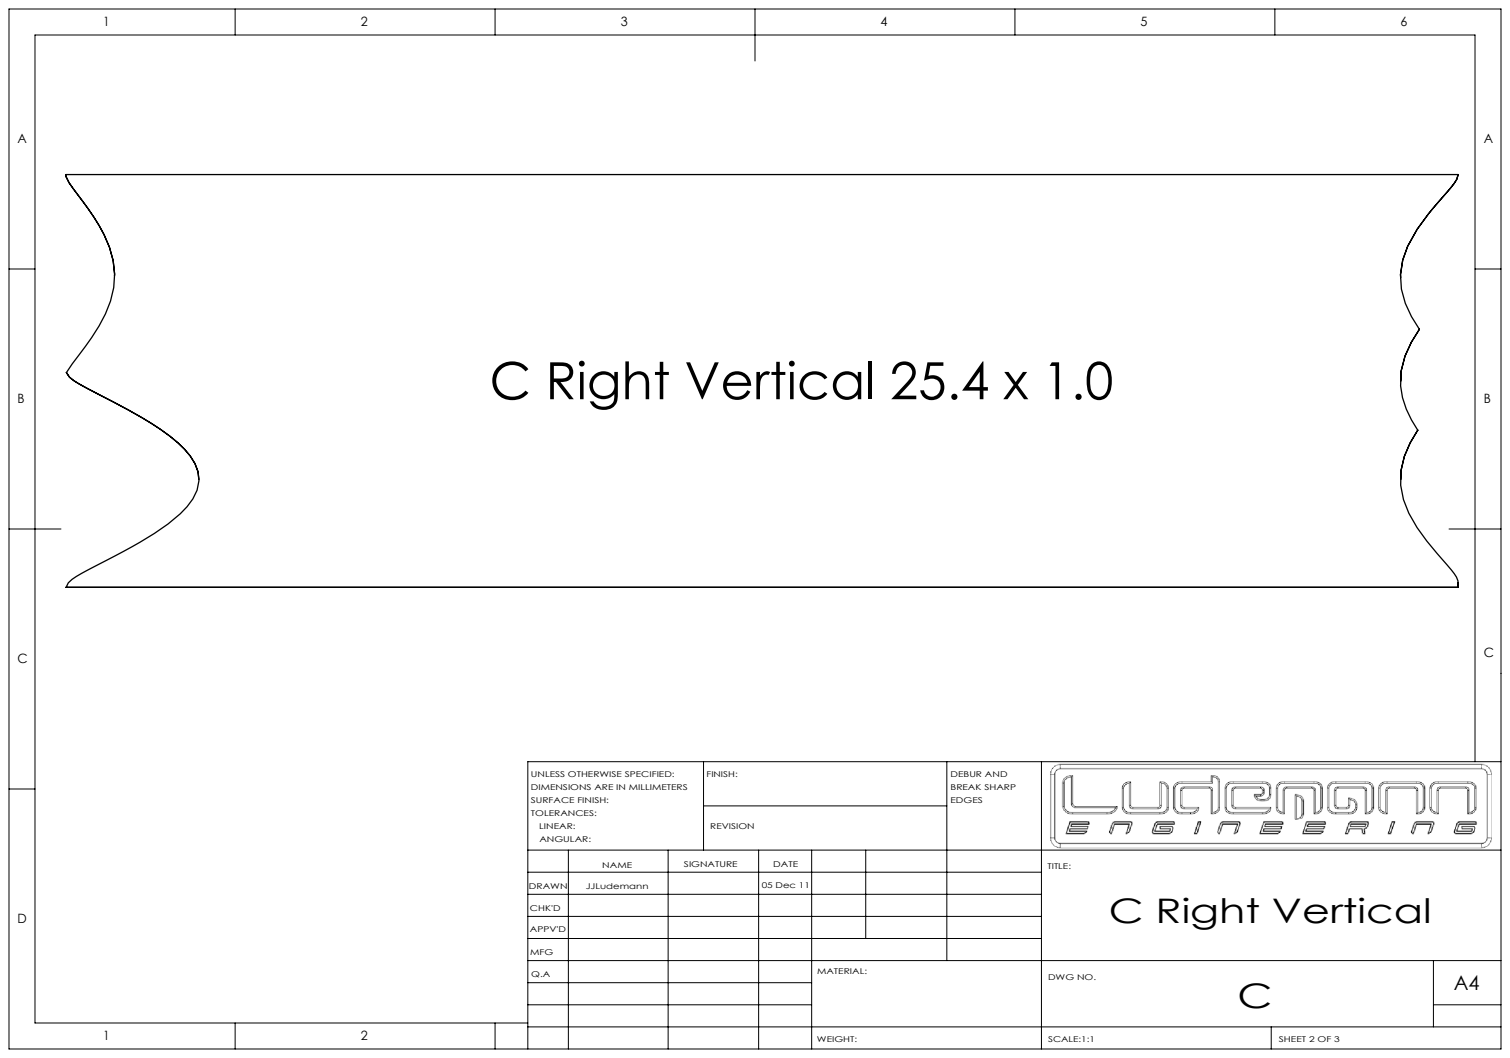
[picture p170: page 2]
C Right Vertical 25.4 x 1.0; FINISH:; DEBUR AND; BREAK SHARP

UNLESS OTHERWISE SPECIFIED:
DIMENSIONS ARE IN MILLIMETERS
SURFACE FINISH:
TOLERANCES:
LINEAR:
ANGULAR:

NAME | SIGNATURE | DATE | | | | TITLE: C Right Vertical

DRAWN | JJLudemann | | 05 Dec 11

CHK'D

APPV'D

MFG
Q.A | | | | MATERIAL: | DWG NO. C | A4

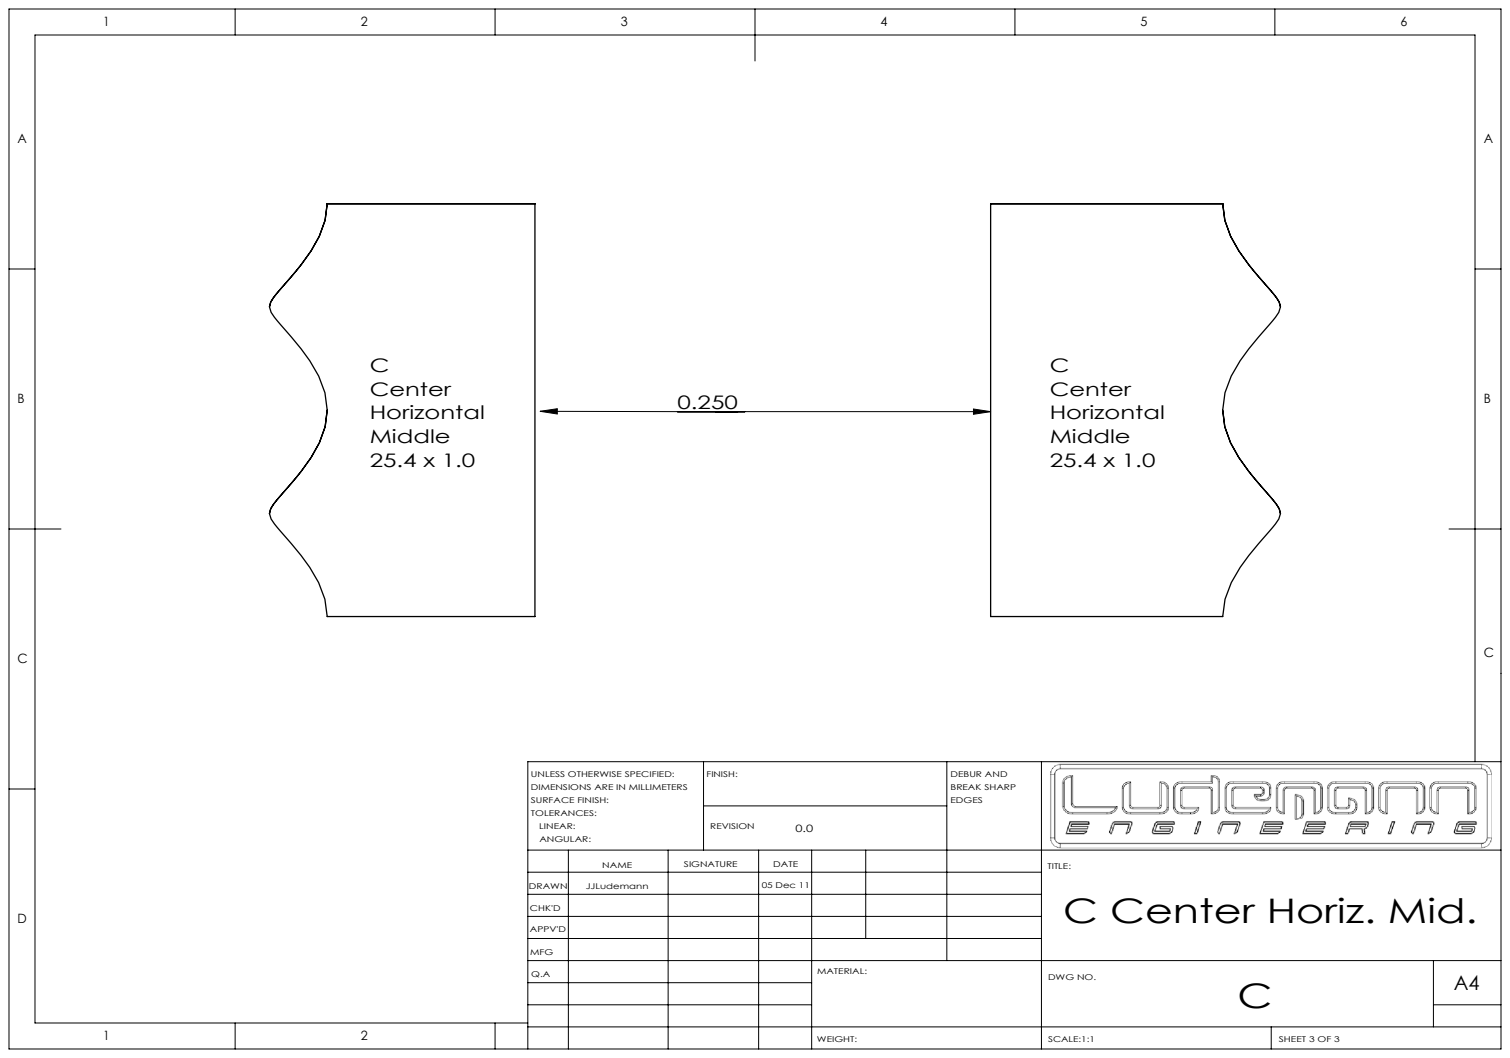
[picture p171: page 3]
FINISH:; DEBUR AND; BREAK SHARP

UNLESS OTHERWISE SPECIFIED:
DIMENSIONS ARE IN MILLIMETERS
SURFACE FINISH:
TOLERANCES:
LINEAR:
ANGULAR:

NAME | SIGNATURE | DATE | | | | TITLE: C Center Horiz. Mid.

DRAWN | JJLudemann | | 05 Dec 11

CHK'D

APPV'D

MFG
Q.A | | | | MATERIAL: | DWG NO. C | A4
