LudemannEngineering/Formula-1000-Race-Car/Solidworks/Chassis/Tubes/PDFs/DriversSeatBottomDiags.PDF

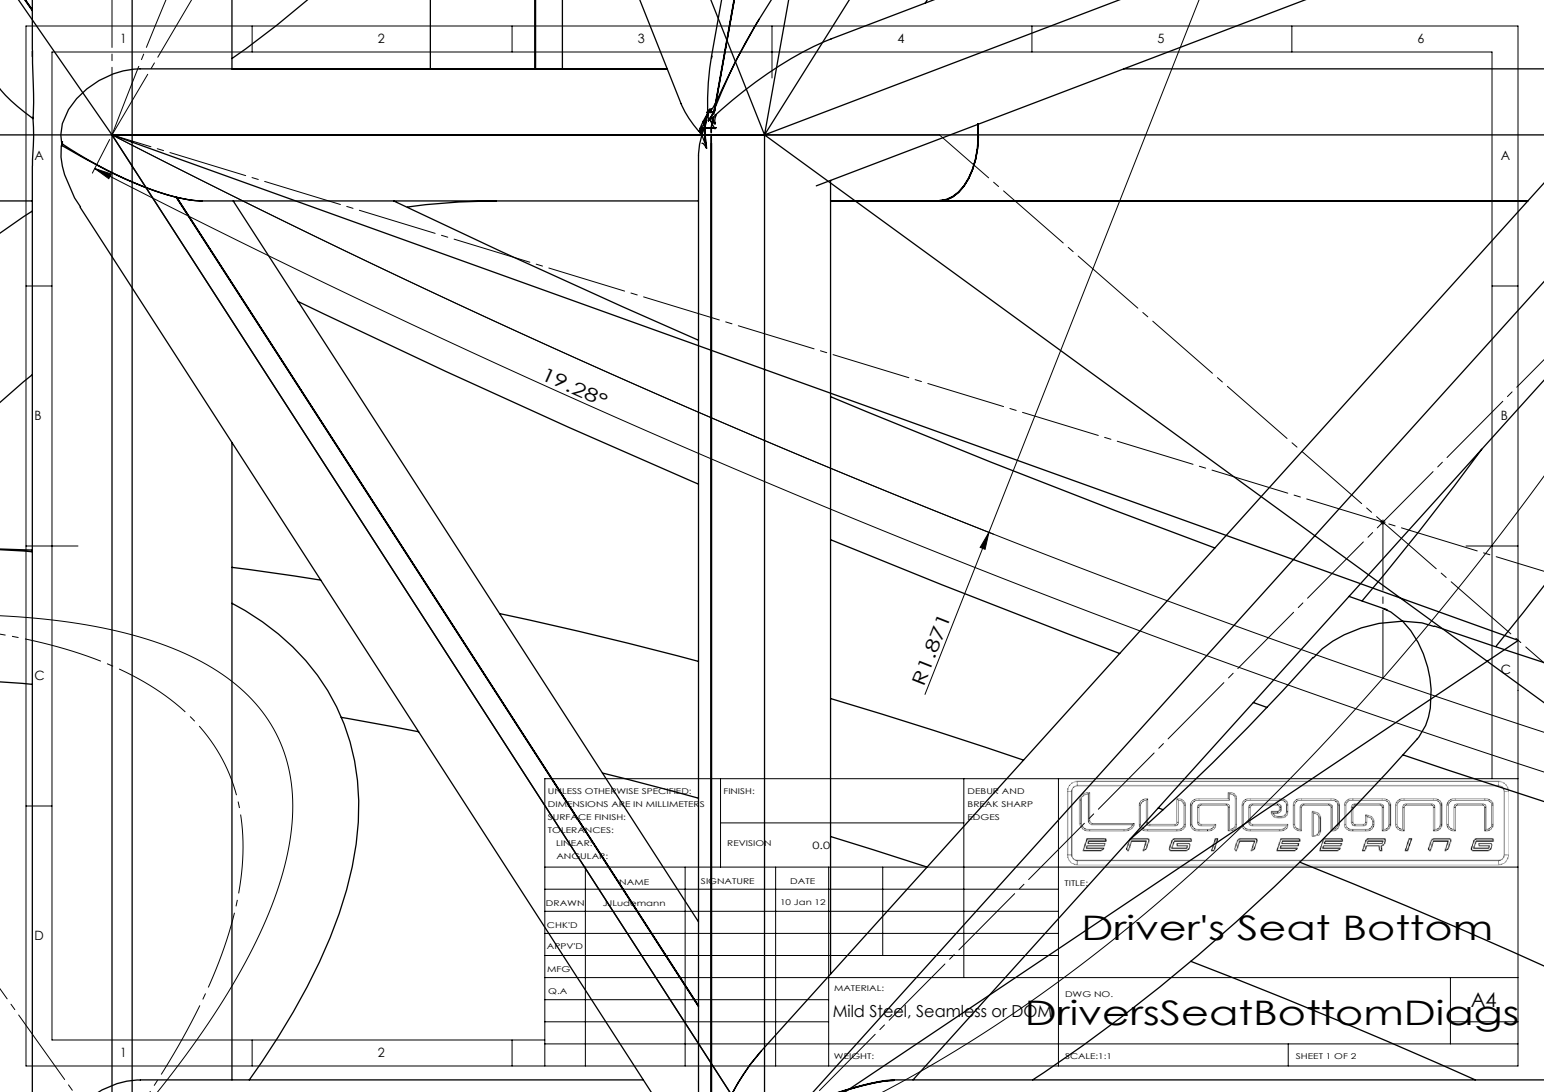
[picture p172: page 1]
FINISH:; DEBUR AND; BREAK SHARP; SCALE:1:1; SHEET 1 OF 2

UNLESS OTHERWISE SPECIFIED:
DIMENSIONS ARE IN MILLIMETERS
SURFACE FINISH:
TOLERANCES:
LINEAR:
ANGULAR:

NAME | SIGNATURE | DATE | | | | TITLE: Driver's Seat Bottom

DRAWN | JJLudemann | | 10 Jan 12

CHK'D

APPV'D

MFG
Q.A | | | | MATERIAL: DriversSeatBottomDiags Mild Steel, Seamless or DOM | DWG NO. | A4

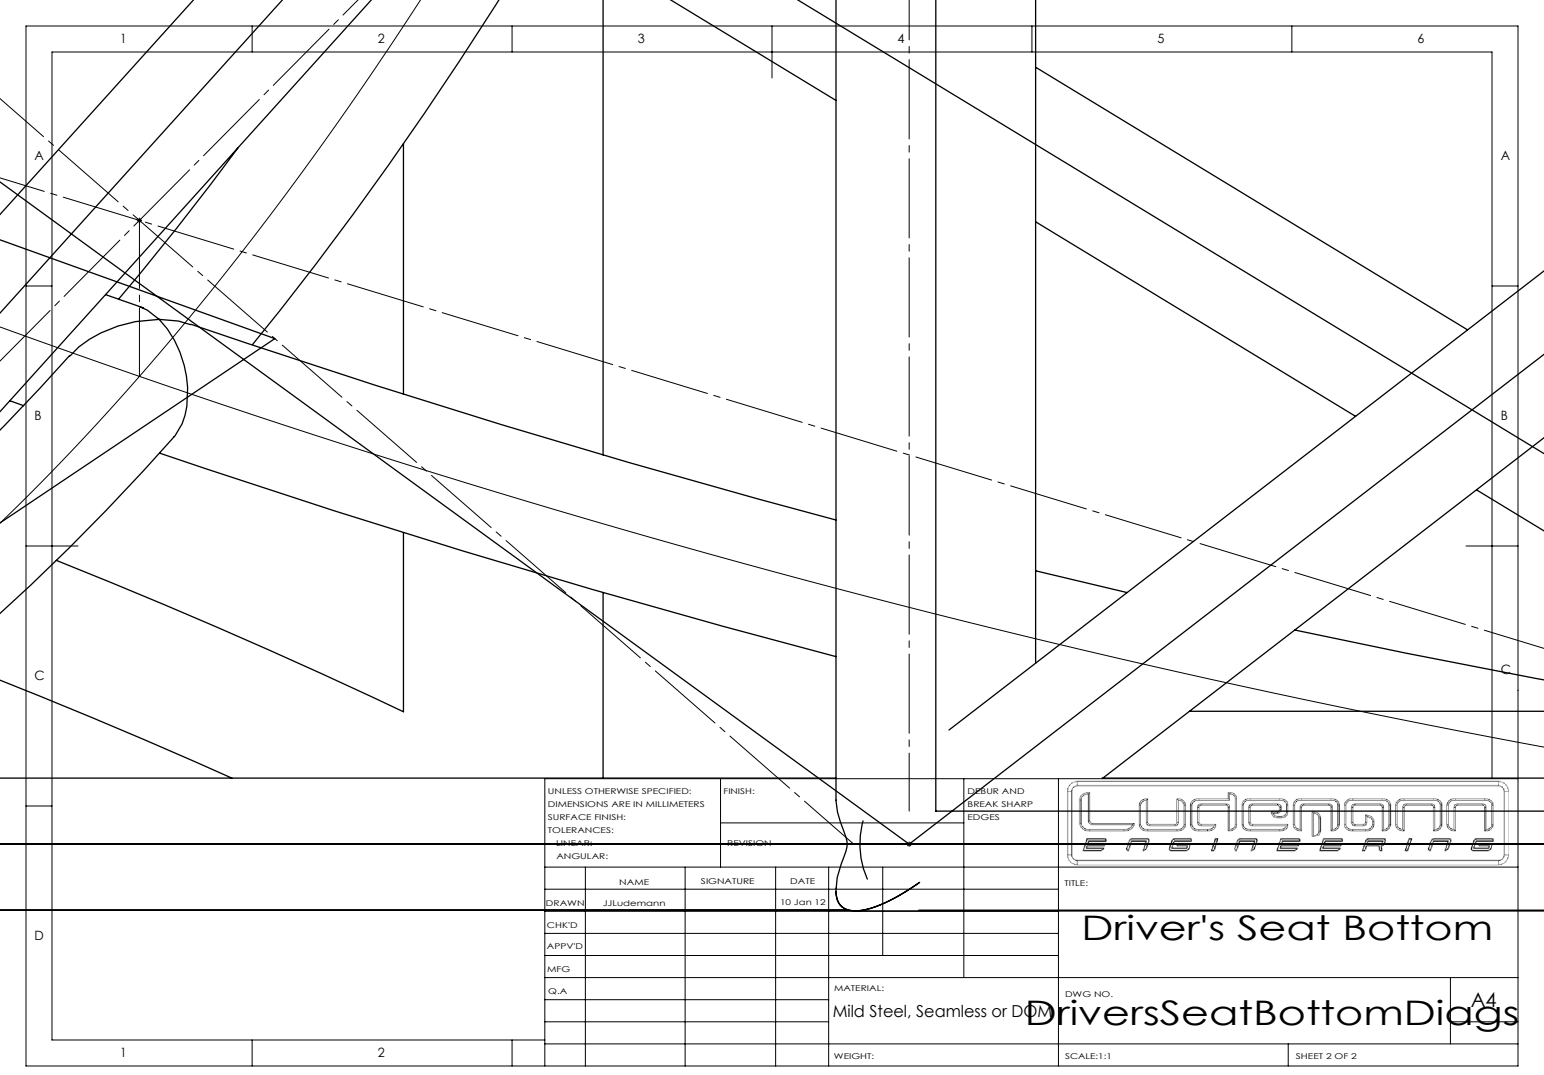
[picture p173: page 2]
FINISH:; DEBUR AND; SCALE:1:1; SHEET 2 OF 2

UNLESS OTHERWISE SPECIFIED: DIMENSIONS ARE IN MILLIMETERS SURFACE FINISH: TOLERANCES: LINEAR: ANGULAR: | | BREAK SHARP EDGES

NAME | SIGNATURE | DATE | | | | TITLE: Driver's Seat Bottom

DRAWN | JJLudemann | | 10 Jan 12

CHK'D

APPV'D

MFG
Q.A | | | | MATERIAL: DriversSeatBottomDiags Mild Steel, Seamless or DOM | DWG NO. | A4
