LudemannEngineering/Formula-1000-Race-Car/Solidworks/Chassis/Tubes/PDFs/E-FLeftDiagLower.PDF

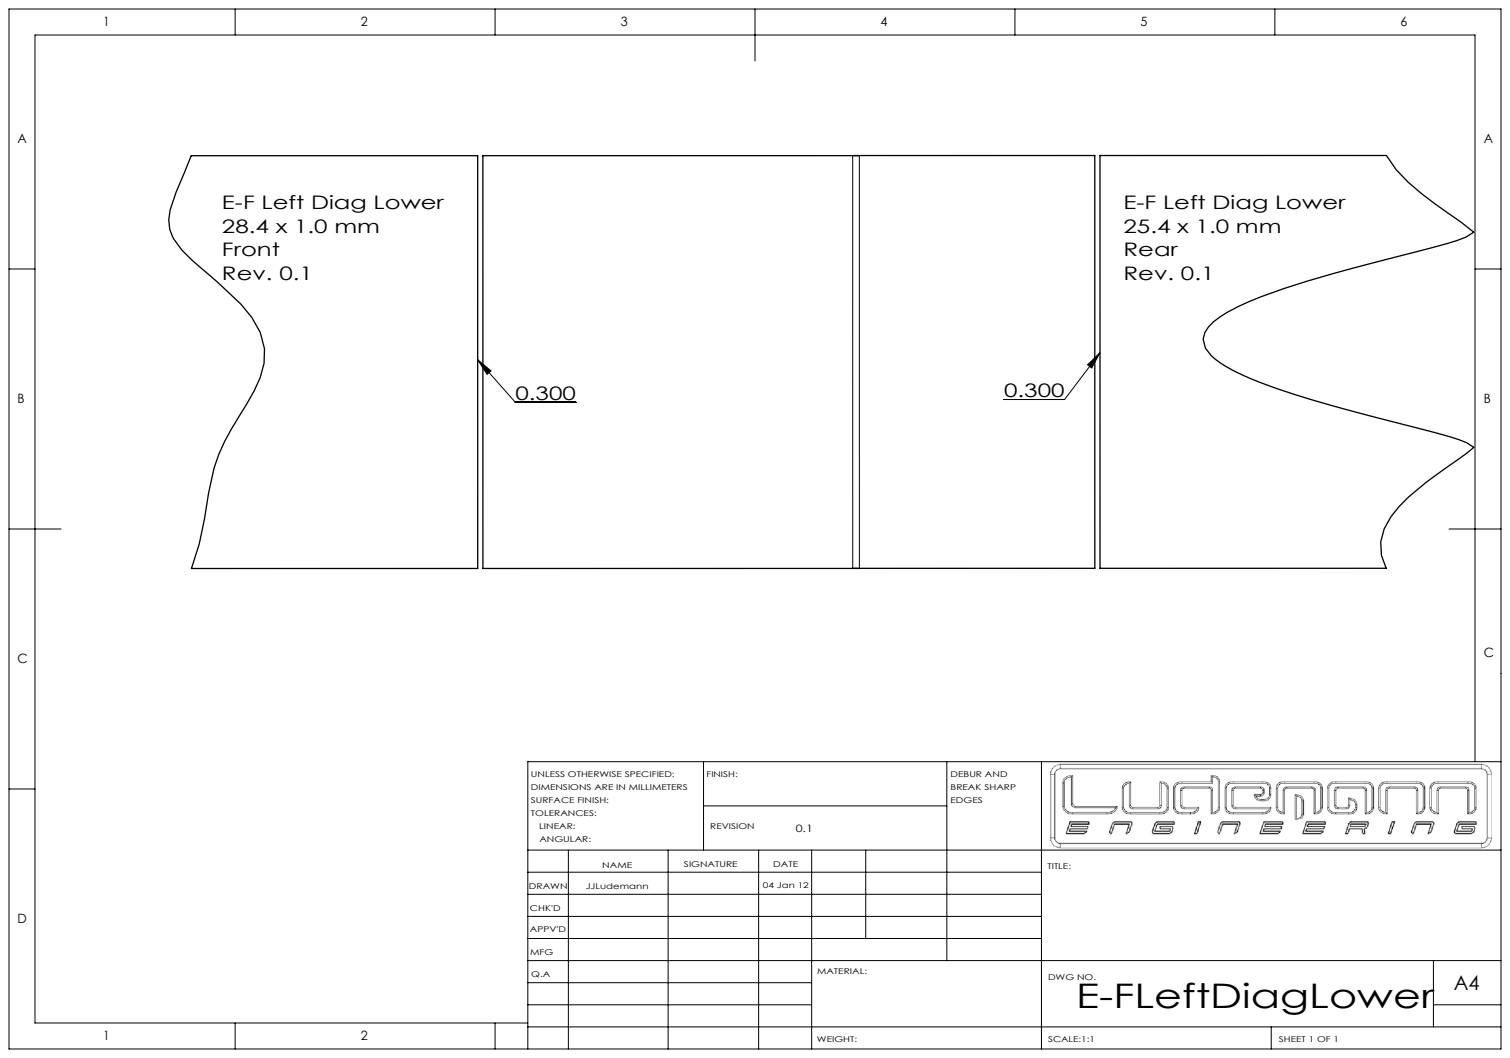
[picture p174: page 1]
FINISH:; DEBUR AND; BREAK SHARP; SCALE:1:1; SHEET 1 OF 1

E-F Left Diag Lower
Front
Rev. 0.1

Rear

UNLESS OTHERWISE SPECIFIED:
DIMENSIONS ARE IN MILLIMETERS
SURFACE FINISH:
TOLERANCES:
LINEAR:
ANGULAR:

NAME | SIGNATURE | DATE | | | | TITLE:

DRAWN | JJLudemann | | 04 Jan 12

CHK'D

APPV'D

MFG
Q.A | | | | MATERIAL: | DWG NO. E-FLeftDiagLower | A4
