LudemannEngineering/Formula-1000-Race-Car/Solidworks/Chassis/Tubes/PDFs/E-FLeftDiagUpper.PDF

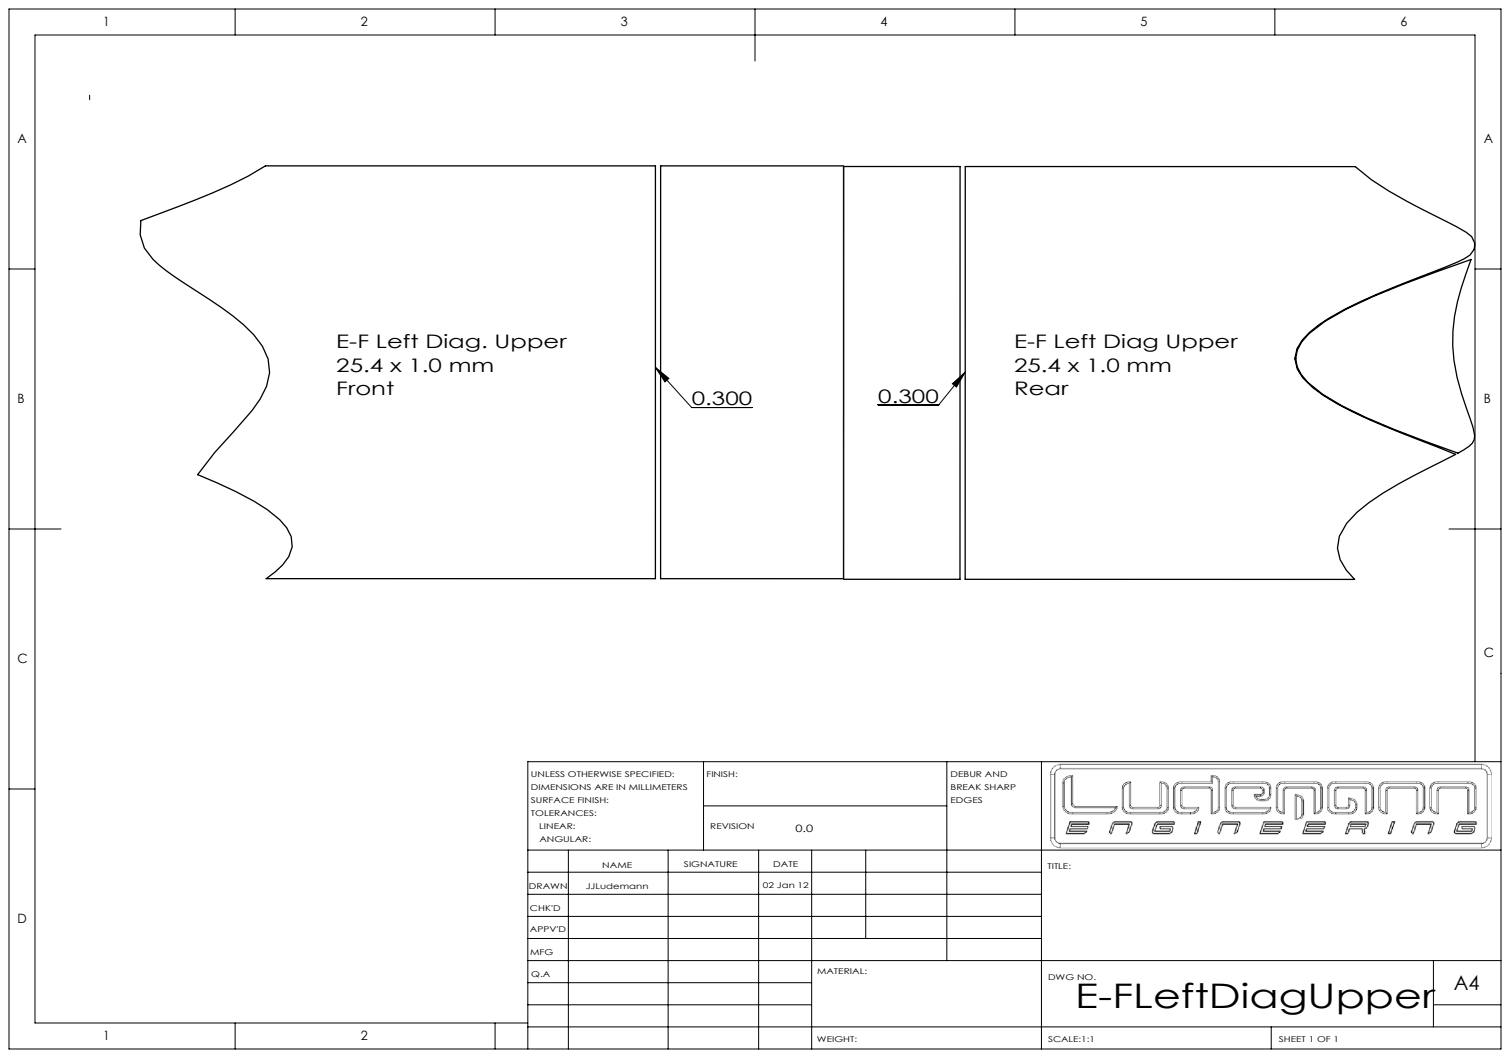
[picture p175: page 1]
Rear B; FINISH:; DEBUR AND; BREAK SHARP; SCALE:1:1; SHEET 1 OF 1

E-F Left Diag. Upper

E-F Left Diag Upper

UNLESS OTHERWISE SPECIFIED:
DIMENSIONS ARE IN MILLIMETERS
SURFACE FINISH:
TOLERANCES:
LINEAR:
ANGULAR:

NAME | SIGNATURE | DATE | | | | TITLE:

DRAWN | JJLudemann | | 02 Jan 12

CHK'D

APPV'D

MFG
Q.A | | | | MATERIAL: | DWG NO. E-FLeftDiagUpper | A4
