LudemannEngineering/Formula-1000-Race-Car/Solidworks/Chassis/Tubes/PDFs/E-FLeftHorizMid.PDF

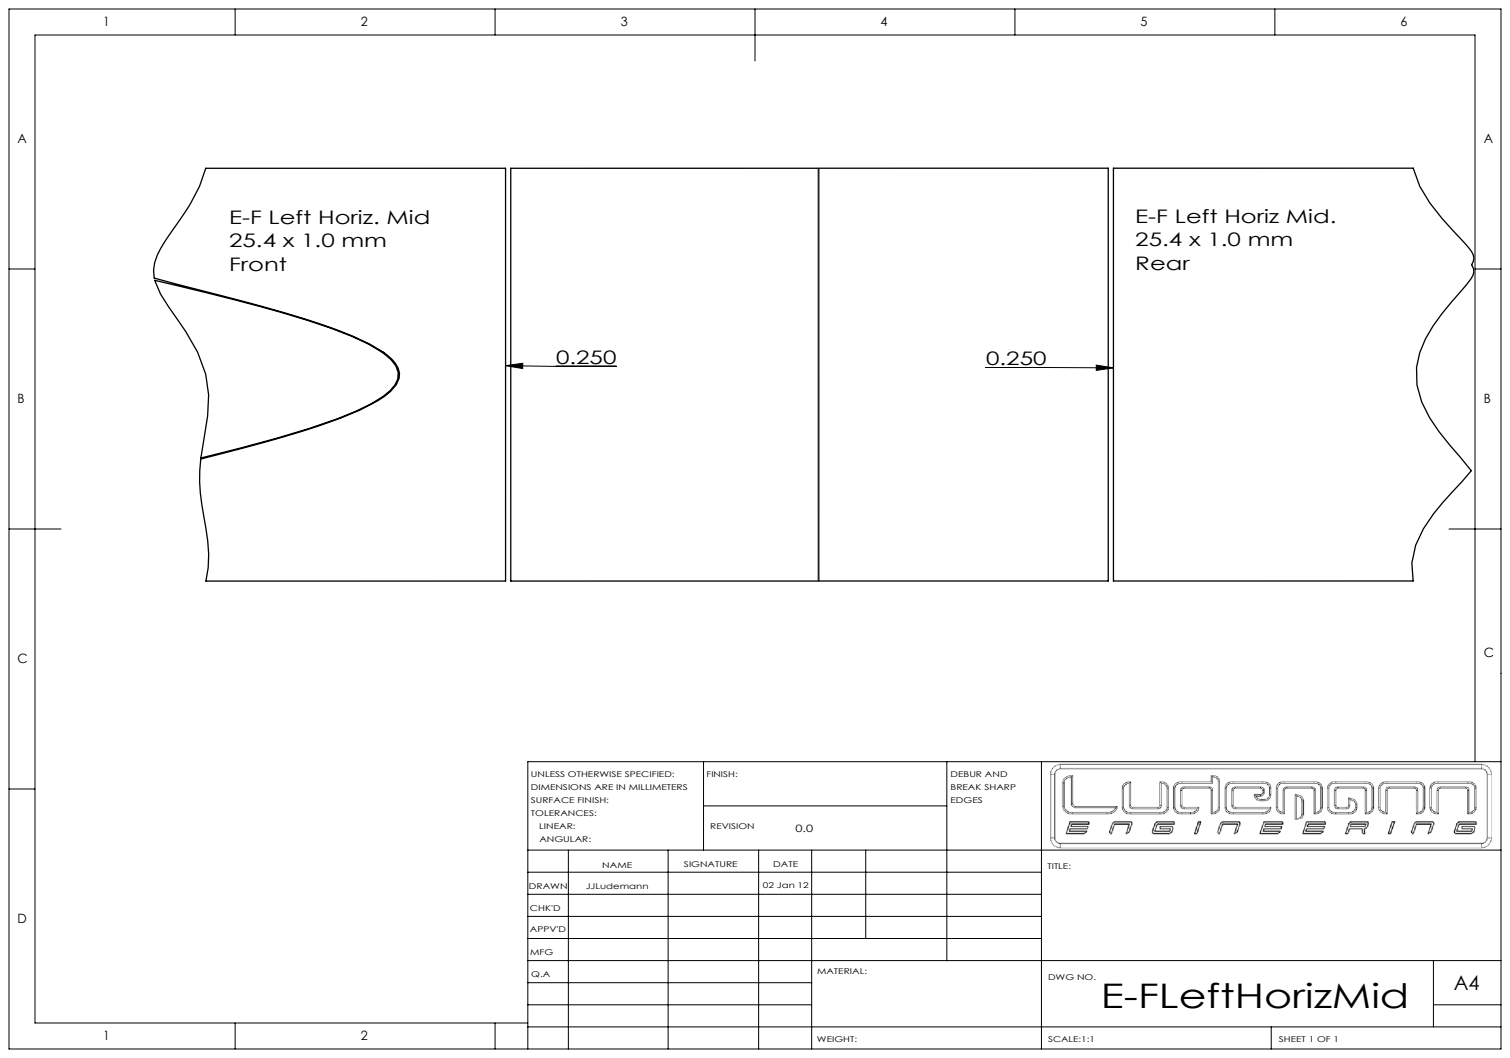
[picture p176: page 1]
FINISH:; DEBUR AND; BREAK SHARP; SCALE:1:1; SHEET 1 OF 1

E-F Left Horiz. Mid
Front

E-F Left Horiz Mid.
Rear

UNLESS OTHERWISE SPECIFIED:
DIMENSIONS ARE IN MILLIMETERS
SURFACE FINISH:
TOLERANCES:
LINEAR:
ANGULAR:

NAME | SIGNATURE | DATE | | | | TITLE:

DRAWN | JJLudemann | | 02 Jan 12

CHK'D

APPV'D

MFG
Q.A | | | | MATERIAL: | DWG NO. E-FLeftHorizMid | A4
