LudemannEngineering/Formula-1000-Race-Car/Solidworks/Chassis/Tubes/PDFs/E-FRightDiagUpper.PDF

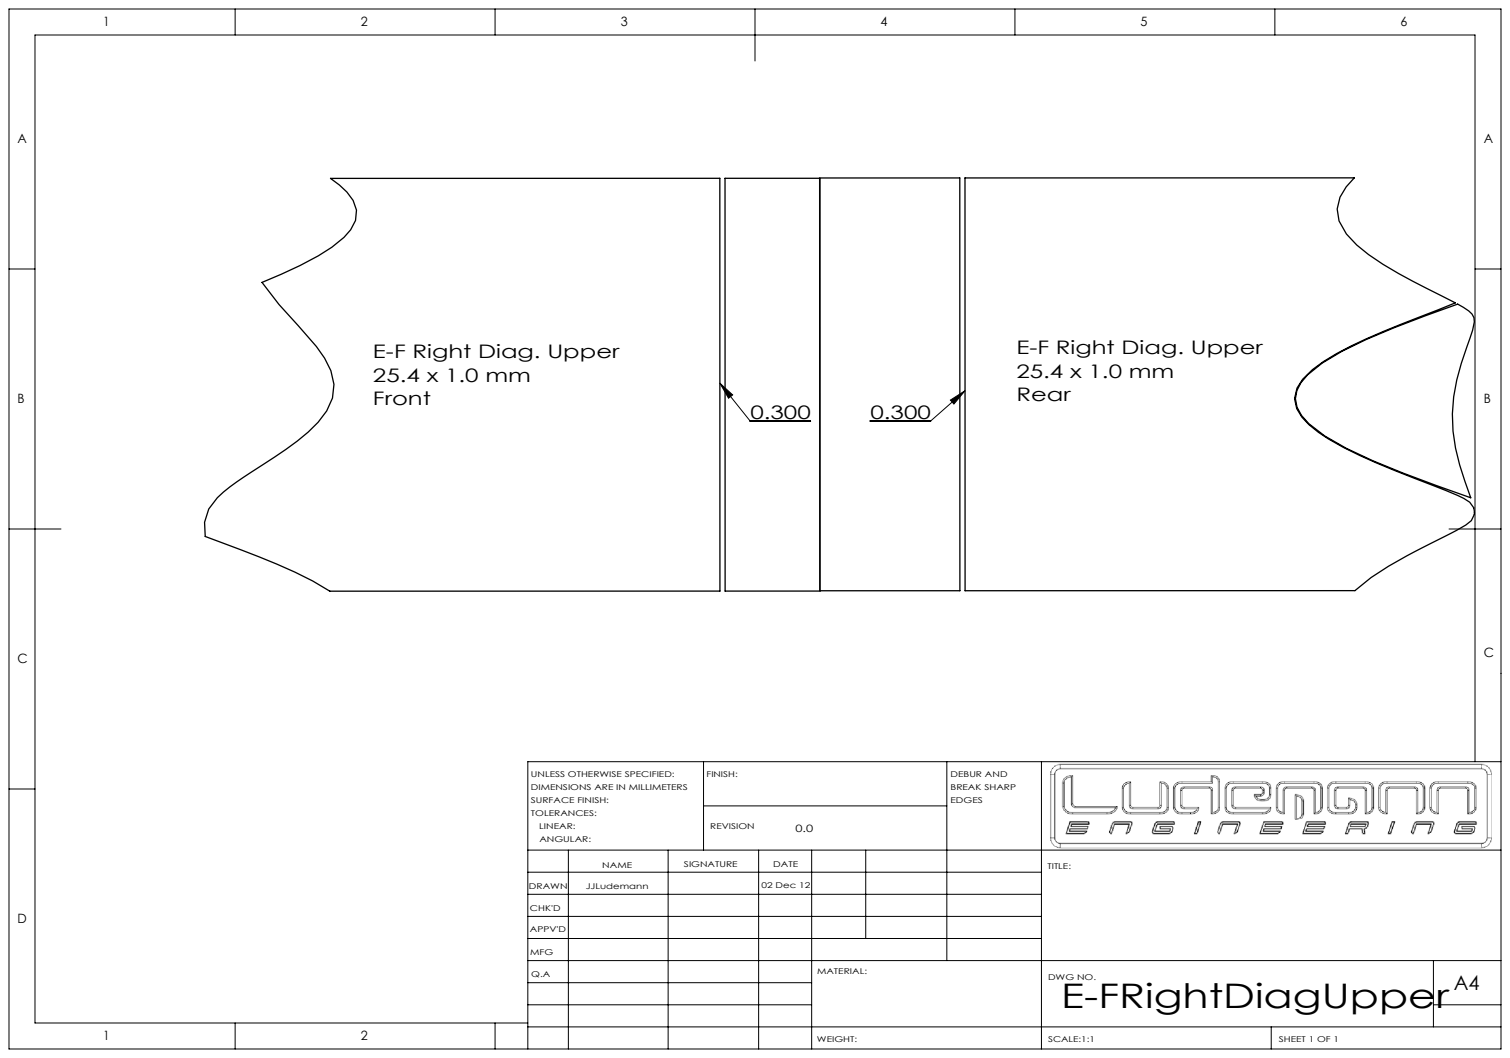
[picture p177: page 1]
FINISH:; DEBUR AND; BREAK SHARP; SCALE:1:1; SHEET 1 OF 1

E-F Right Diag. Upper

UNLESS OTHERWISE SPECIFIED:
DIMENSIONS ARE IN MILLIMETERS
SURFACE FINISH:
TOLERANCES:
LINEAR:
ANGULAR:

NAME | SIGNATURE | DATE | | | | TITLE:

DRAWN | JJLudemann | | 02 Dec 12

CHK'D

APPV'D

MFG
Q.A | | | | MATERIAL: | DWG NO. E-FRightDiagUpper | A4
