LudemannEngineering/Formula-1000-Race-Car/Solidworks/Chassis/Tubes/PDFs/E-FRightHorizBottom.PDF

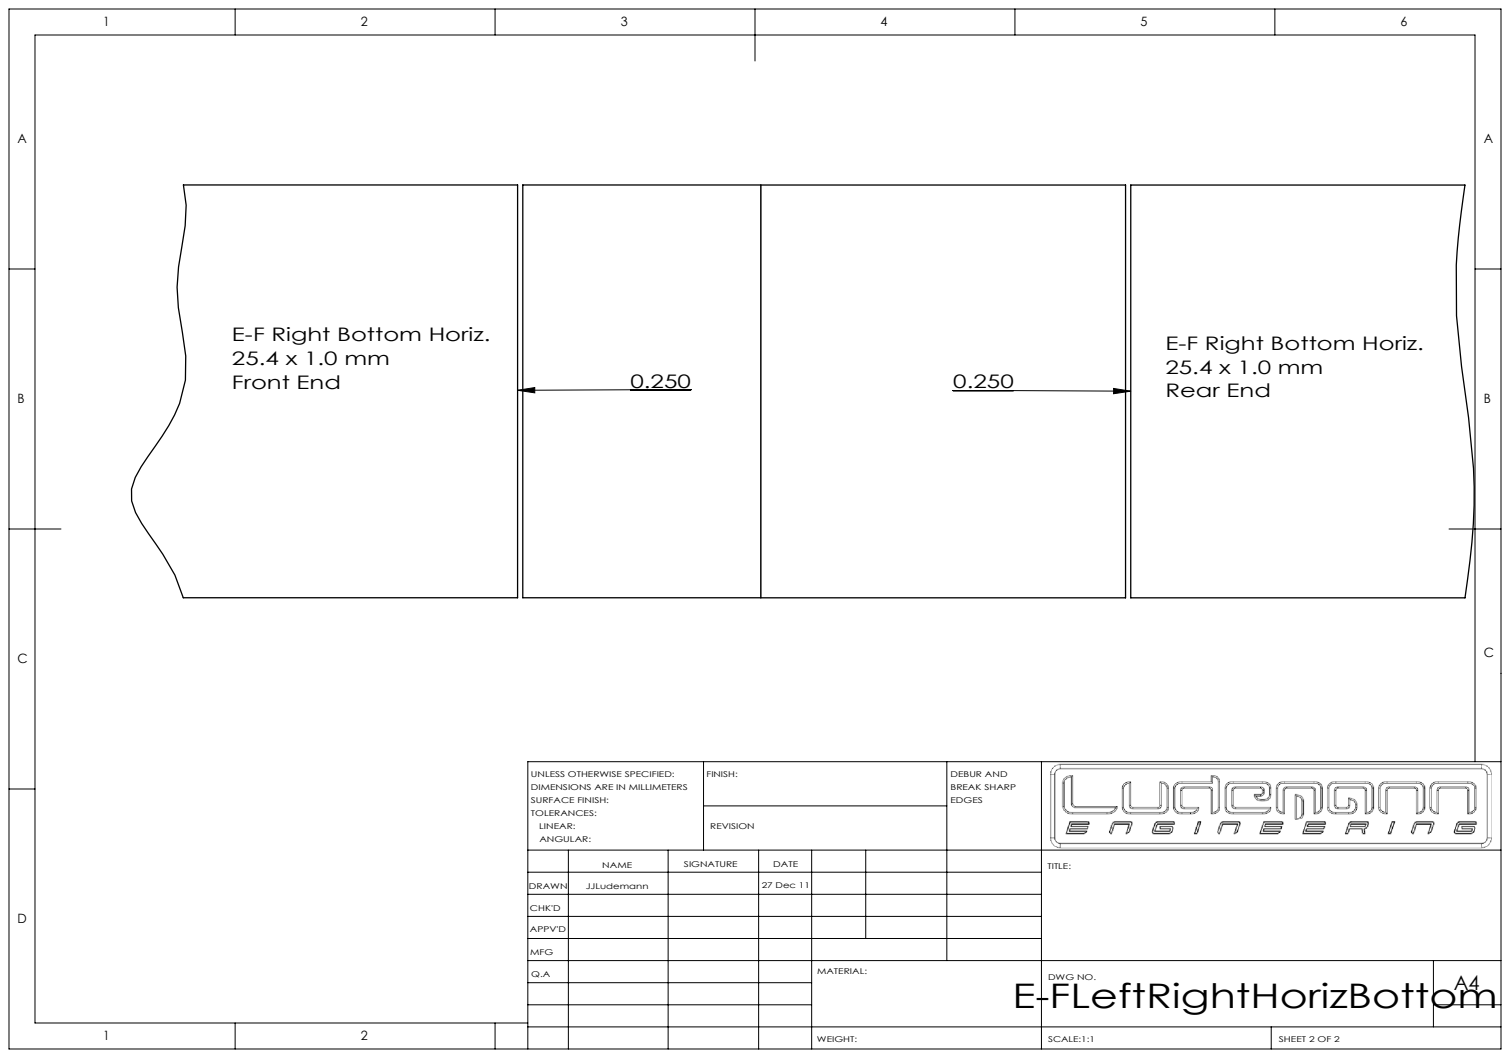
[picture p178: page 1]
Front End; Rear End; FINISH:; DEBUR AND; BREAK SHARP; SCALE:1:1; SHEET 2 OF 2

E-F Right Bottom Horiz.

UNLESS OTHERWISE SPECIFIED:
DIMENSIONS ARE IN MILLIMETERS
SURFACE FINISH:
TOLERANCES:
LINEAR:
ANGULAR:

NAME | SIGNATURE | DATE | | | | TITLE:

DRAWN | JJLudemann | | 27 Dec 11

CHK'D

APPV'D

MFG
Q.A | | | | MATERIAL: E-FLeftRightHorizBottom | DWG NO. | A4
