LudemannEngineering/Formula-1000-Race-Car/Solidworks/Chassis/Tubes/PDFs/F-GCenterDiagBottomLF-RR.PDF

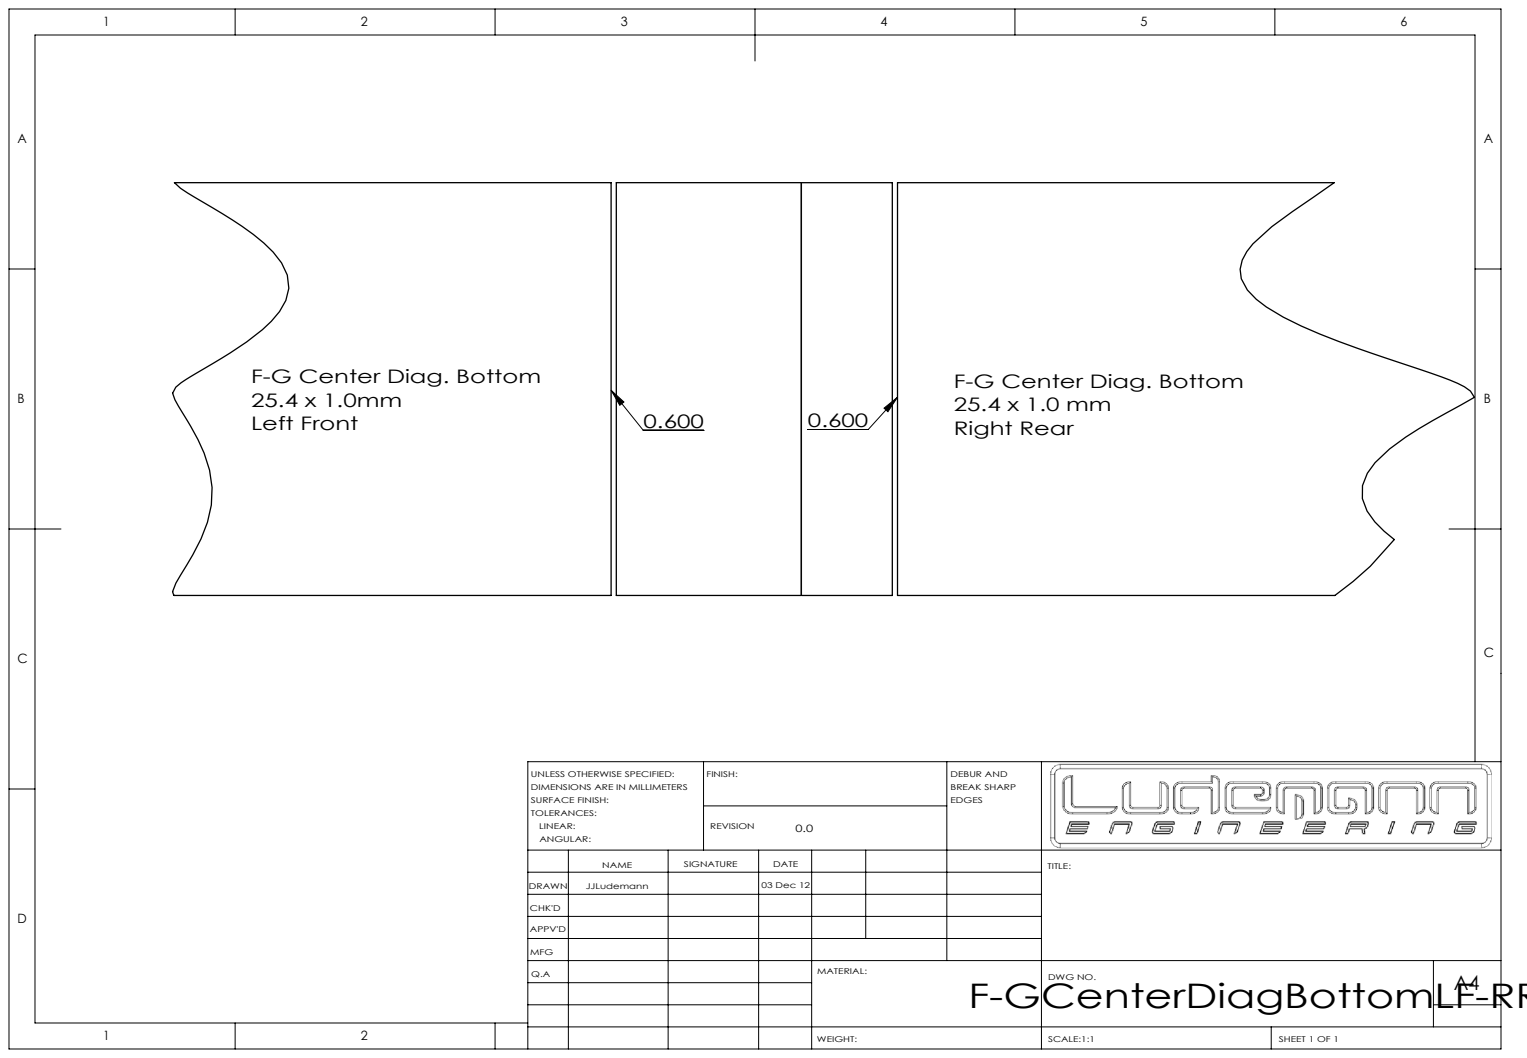
[picture p179: page 1]
Left Front; FINISH:; DEBUR AND; BREAK SHARP; SCALE:1:1; SHEET 1 OF 1

F-G Center Diag. Bottom

Right Rear

UNLESS OTHERWISE SPECIFIED:
DIMENSIONS ARE IN MILLIMETERS
SURFACE FINISH:
TOLERANCES:
LINEAR:
ANGULAR:

NAME | SIGNATURE | DATE | | | | TITLE:

DRAWN | JJLudemann | | 03 Dec 12

CHK'D

APPV'D

MFG
Q.A | | | | MATERIAL: | DWG NO. | A4
