LudemannEngineering/Formula-1000-Race-Car/Solidworks/Chassis/Tubes/PDFs/F-GCenterDiagBottomRF-LR_Front.PDF

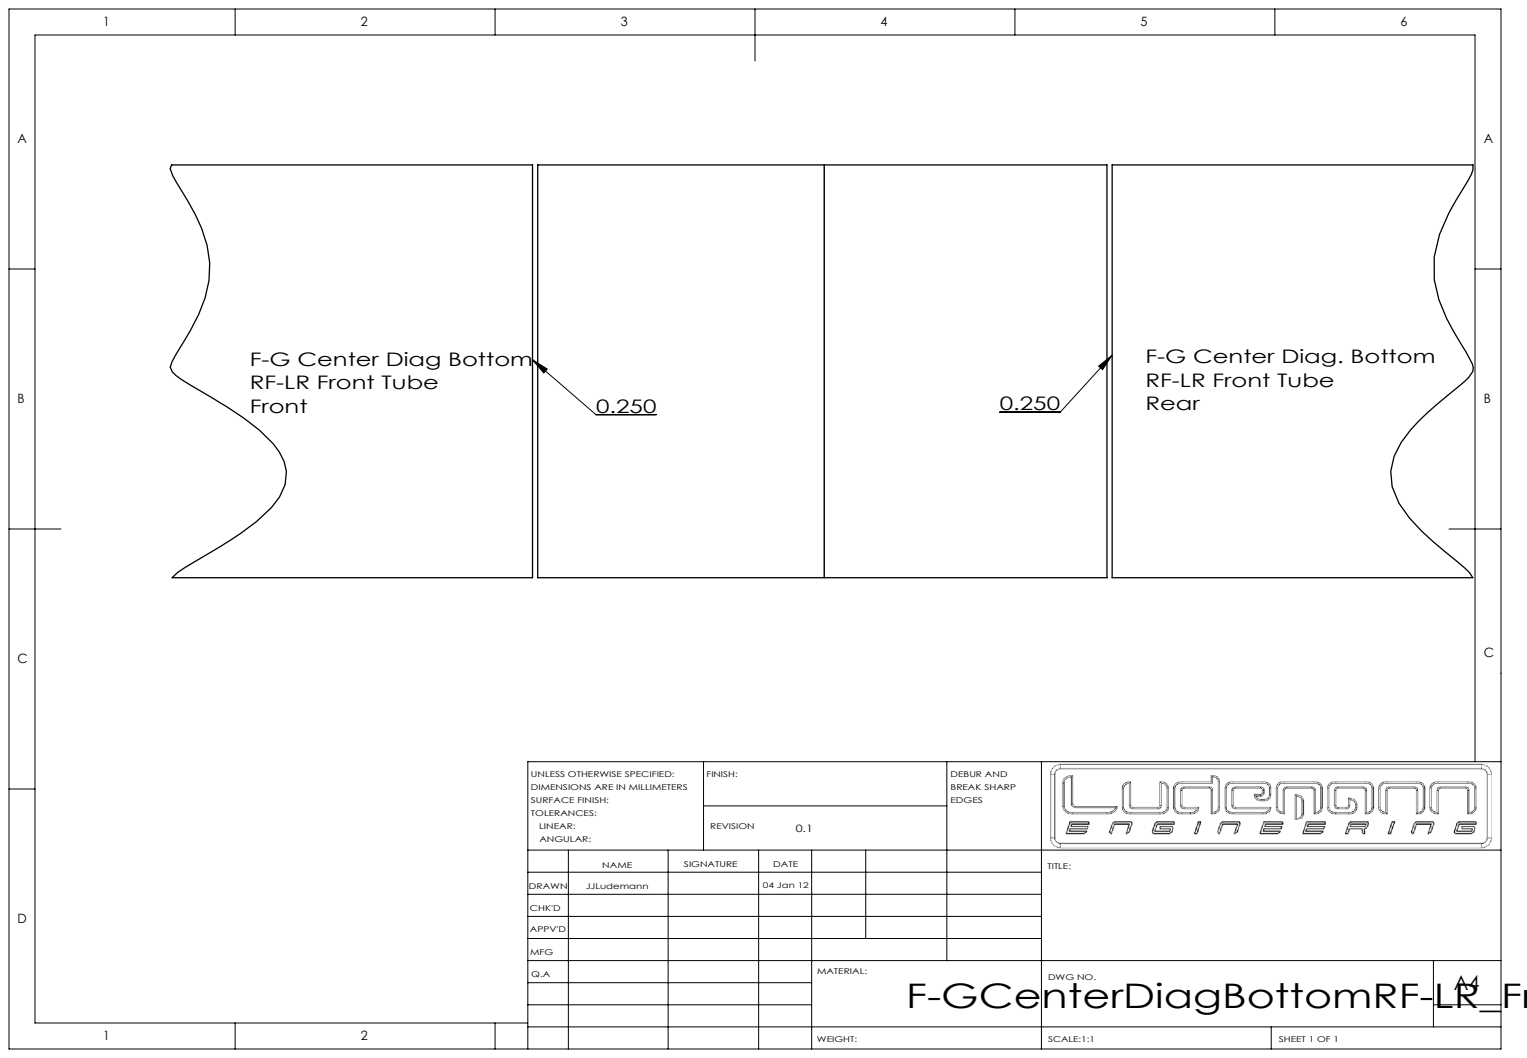
[picture p180: page 1]
Rear B; FINISH:; DEBUR AND; BREAK SHARP; SCALE:1:1; SHEET 1 OF 1

F-G Center Diag Bottom
RF-LR Front Tube

F-G Center Diag. Bottom

UNLESS OTHERWISE SPECIFIED:
DIMENSIONS ARE IN MILLIMETERS
SURFACE FINISH:
TOLERANCES:
LINEAR:
ANGULAR:

NAME | SIGNATURE | DATE | | | | TITLE:

DRAWN | JJLudemann | | 04 Jan 12

CHK'D

APPV'D

MFG
Q.A | | | | MATERIAL: | DWG NO. | A4
