LudemannEngineering/Formula-1000-Race-Car/Solidworks/Chassis/Tubes/PDFs/F-GCenterDiagBottomRF-LR_Rear.PDF

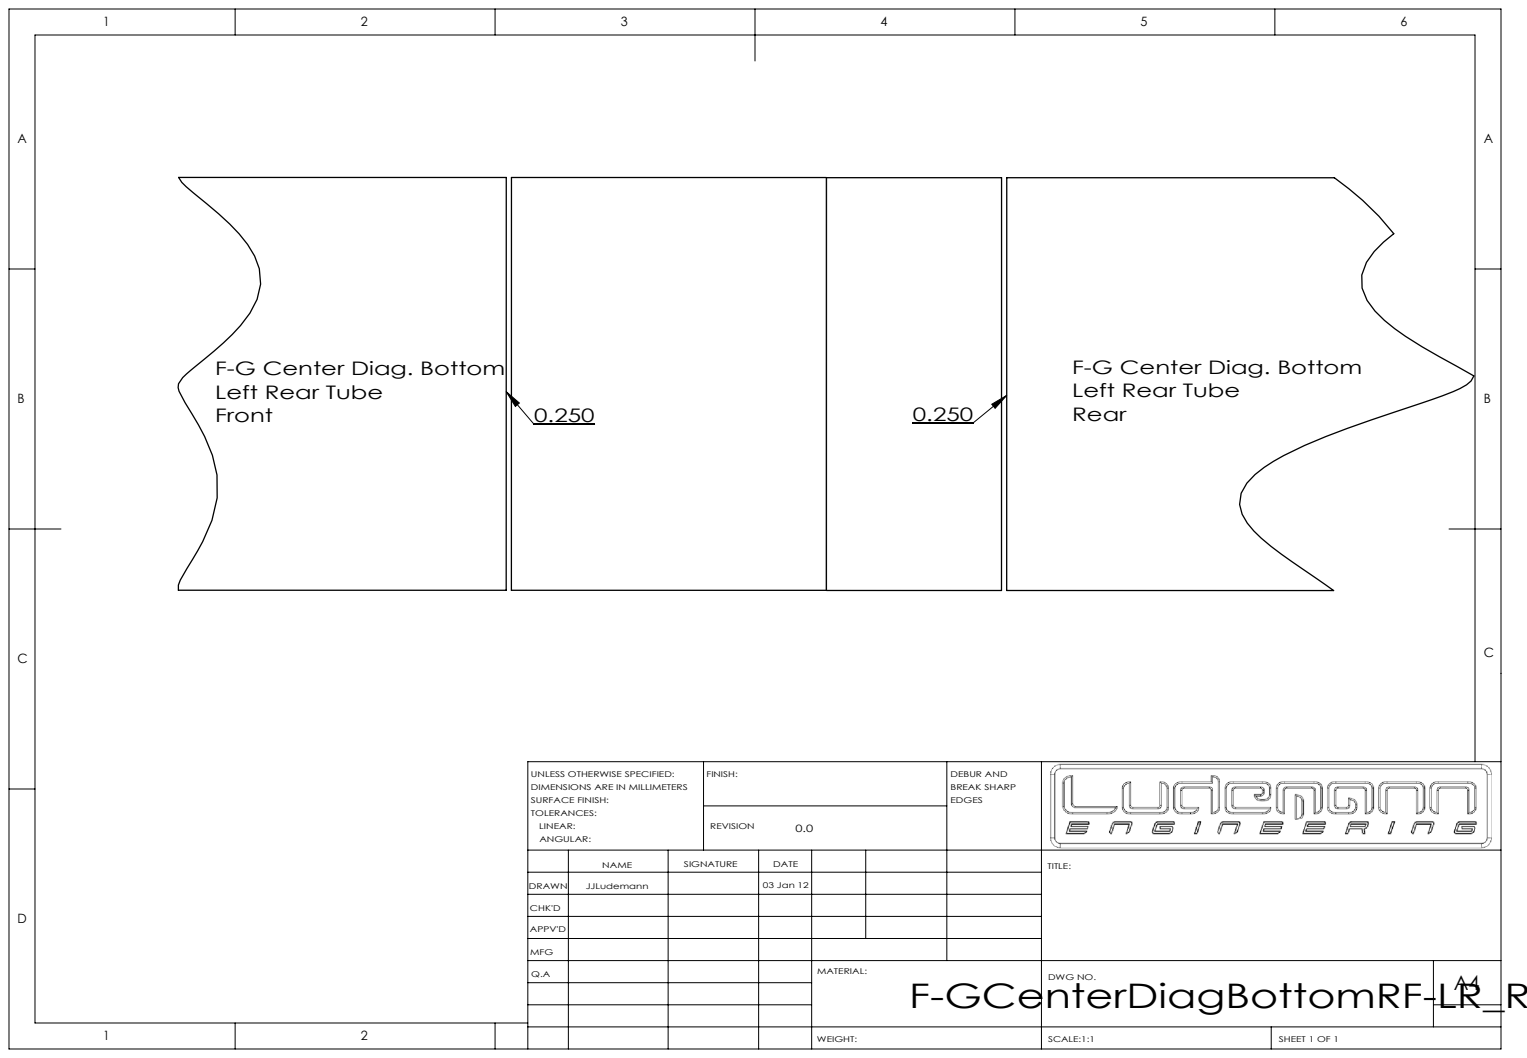
[picture p181: page 1]
FINISH:; DEBUR AND; BREAK SHARP; SCALE:1:1; SHEET 1 OF 1

F-G Center Diag. Bottom
Left Rear Tube

Rear

UNLESS OTHERWISE SPECIFIED:
DIMENSIONS ARE IN MILLIMETERS
SURFACE FINISH:
TOLERANCES:
LINEAR:
ANGULAR:

NAME | SIGNATURE | DATE | | | | TITLE:

DRAWN | JJLudemann | | 03 Jan 12

CHK'D

APPV'D

MFG
Q.A | | | | MATERIAL: | DWG NO. | A4
