LudemannEngineering/Formula-1000-Race-Car/Solidworks/Chassis/Tubes/PDFs/F-GLeftDiagUpperFront.PDF

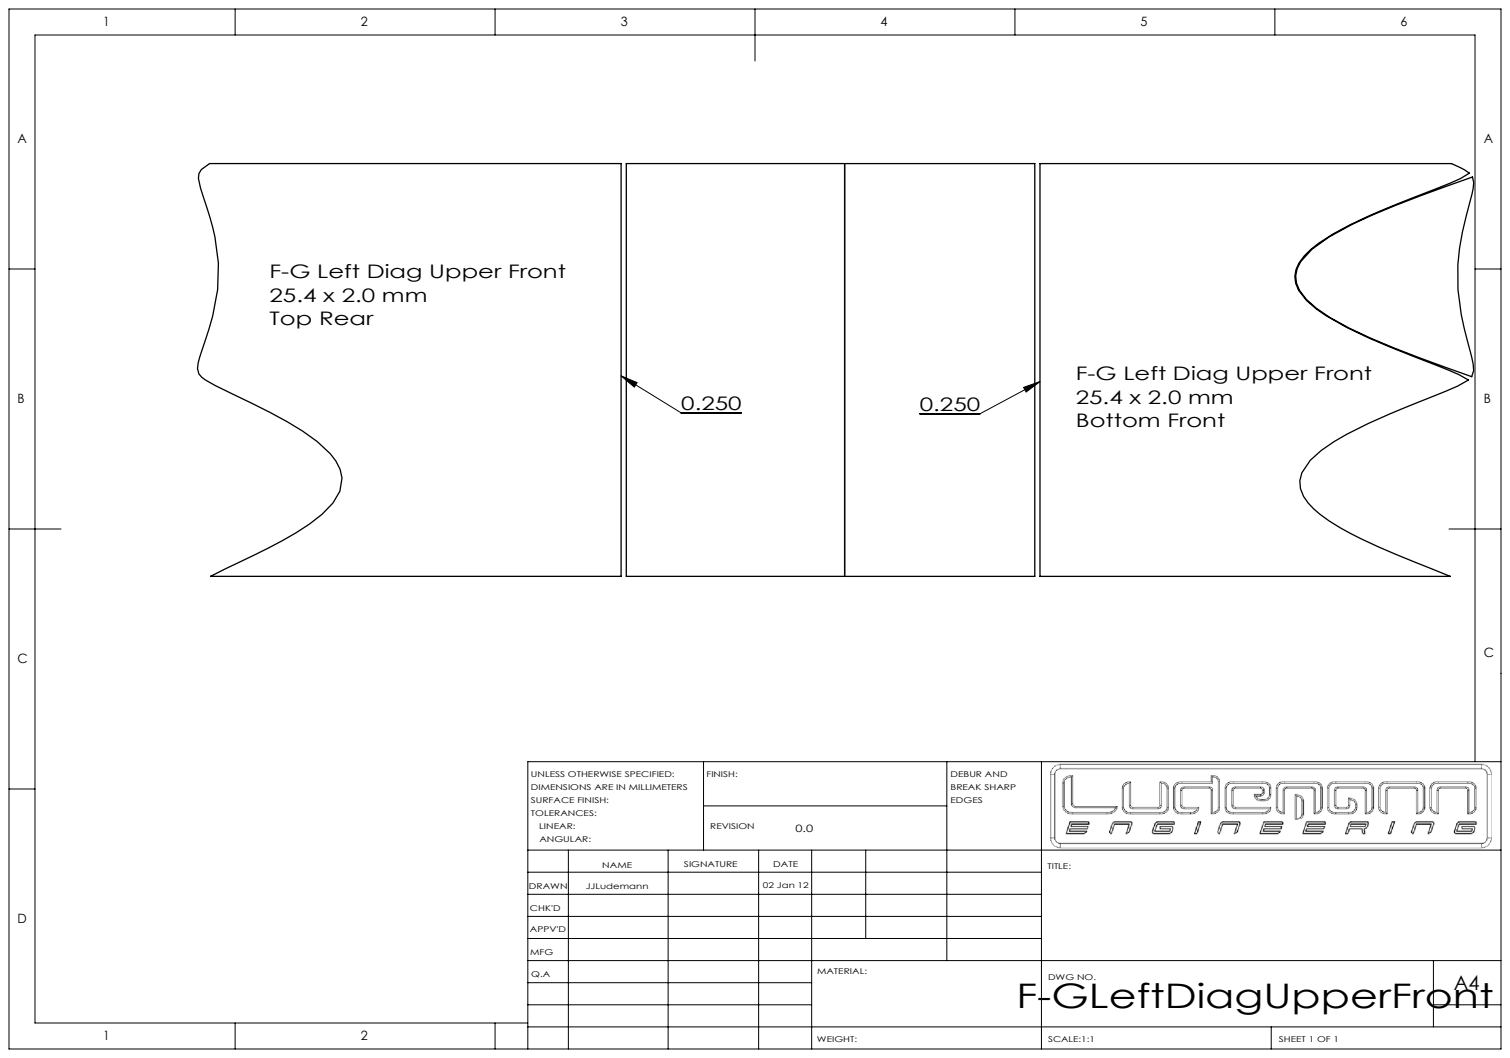
[picture p183: page 1]
FINISH:; DEBUR AND; BREAK SHARP; SCALE:1:1; SHEET 1 OF 1

F-G Left Diag Upper Front
Top Rear

Bottom Front

UNLESS OTHERWISE SPECIFIED:
DIMENSIONS ARE IN MILLIMETERS
SURFACE FINISH:
TOLERANCES:
LINEAR:
ANGULAR:

NAME | SIGNATURE | DATE | | | | TITLE:

DRAWN | JJLudemann | | 02 Jan 12

CHK'D

APPV'D

MFG
Q.A | | | | MATERIAL: F-GLeftDiagUpperFront | DWG NO. | A4
