LudemannEngineering/Formula-1000-Race-Car/Solidworks/Chassis/Tubes/PDFs/F-GLeftDiagUpperRear.PDF

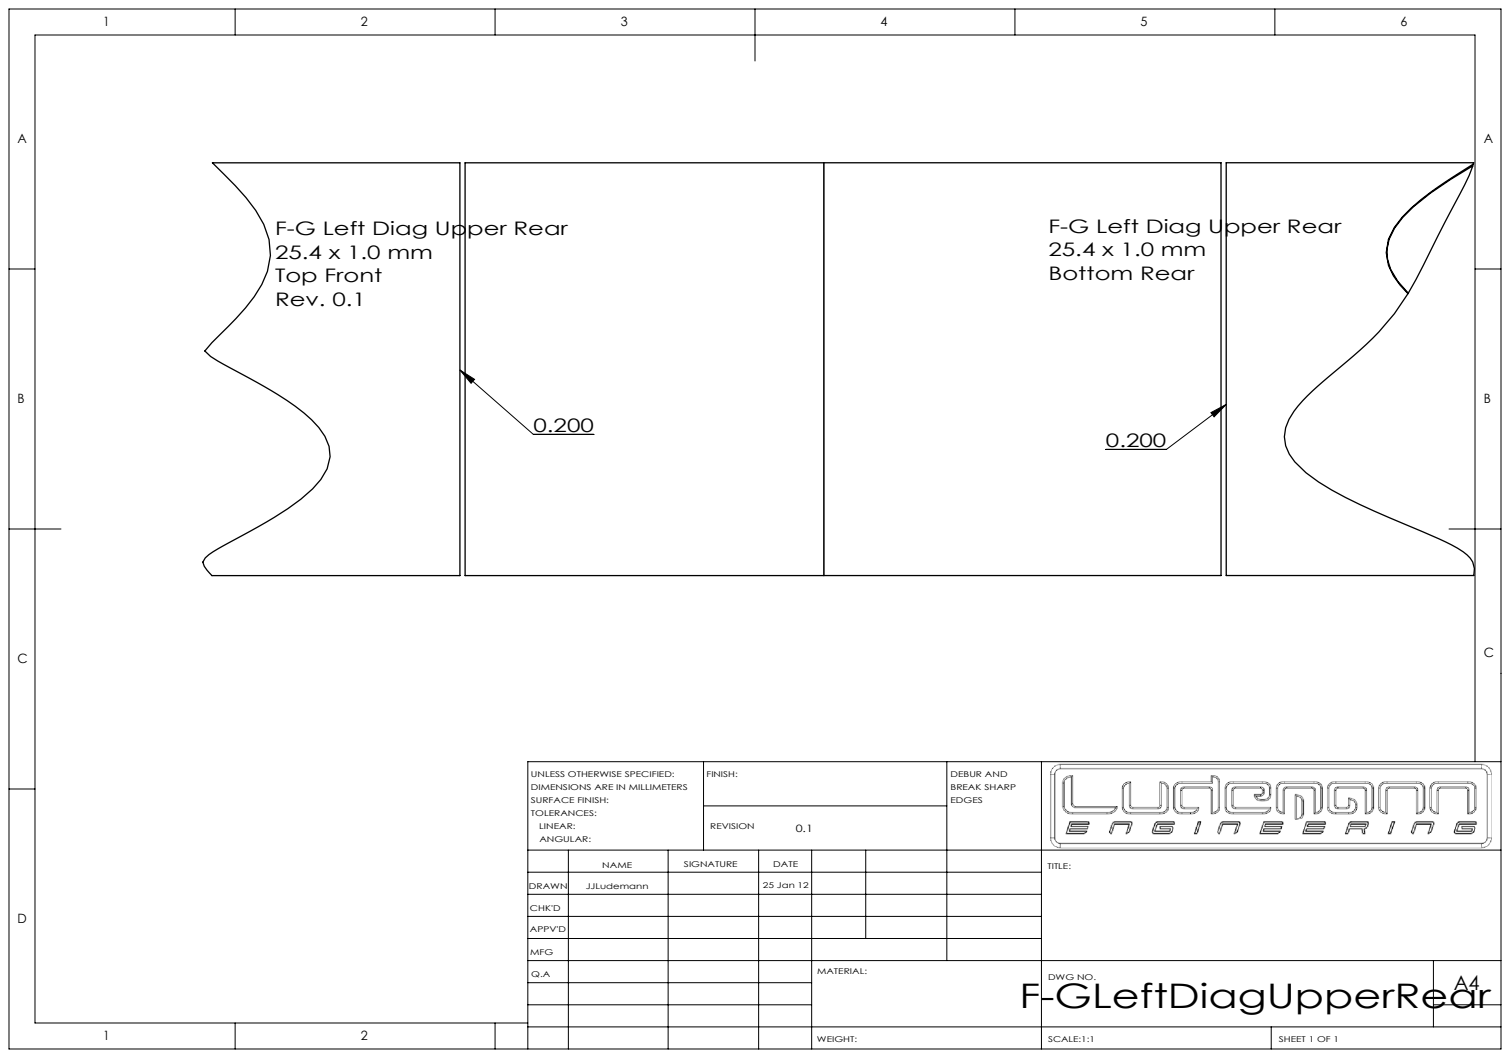
[picture p184: page 1]
FINISH:; DEBUR AND; BREAK SHARP; SCALE:1:1; SHEET 1 OF 1

F-G Left Diag Upper Rear
Top Front
Rev. 0.1

Bottom Rear

UNLESS OTHERWISE SPECIFIED:
DIMENSIONS ARE IN MILLIMETERS
SURFACE FINISH:
TOLERANCES:
LINEAR:
ANGULAR:

NAME | SIGNATURE | DATE | | | | TITLE:

DRAWN | JJLudemann | | 25 Jan 12

CHK'D

APPV'D

MFG
Q.A | | | | MATERIAL: F-GLeftDiagUpperRear | DWG NO. | A4
