LudemannEngineering/Formula-1000-Race-Car/Solidworks/Chassis/Tubes/PDFs/F-GRightHorizBottom.PDF

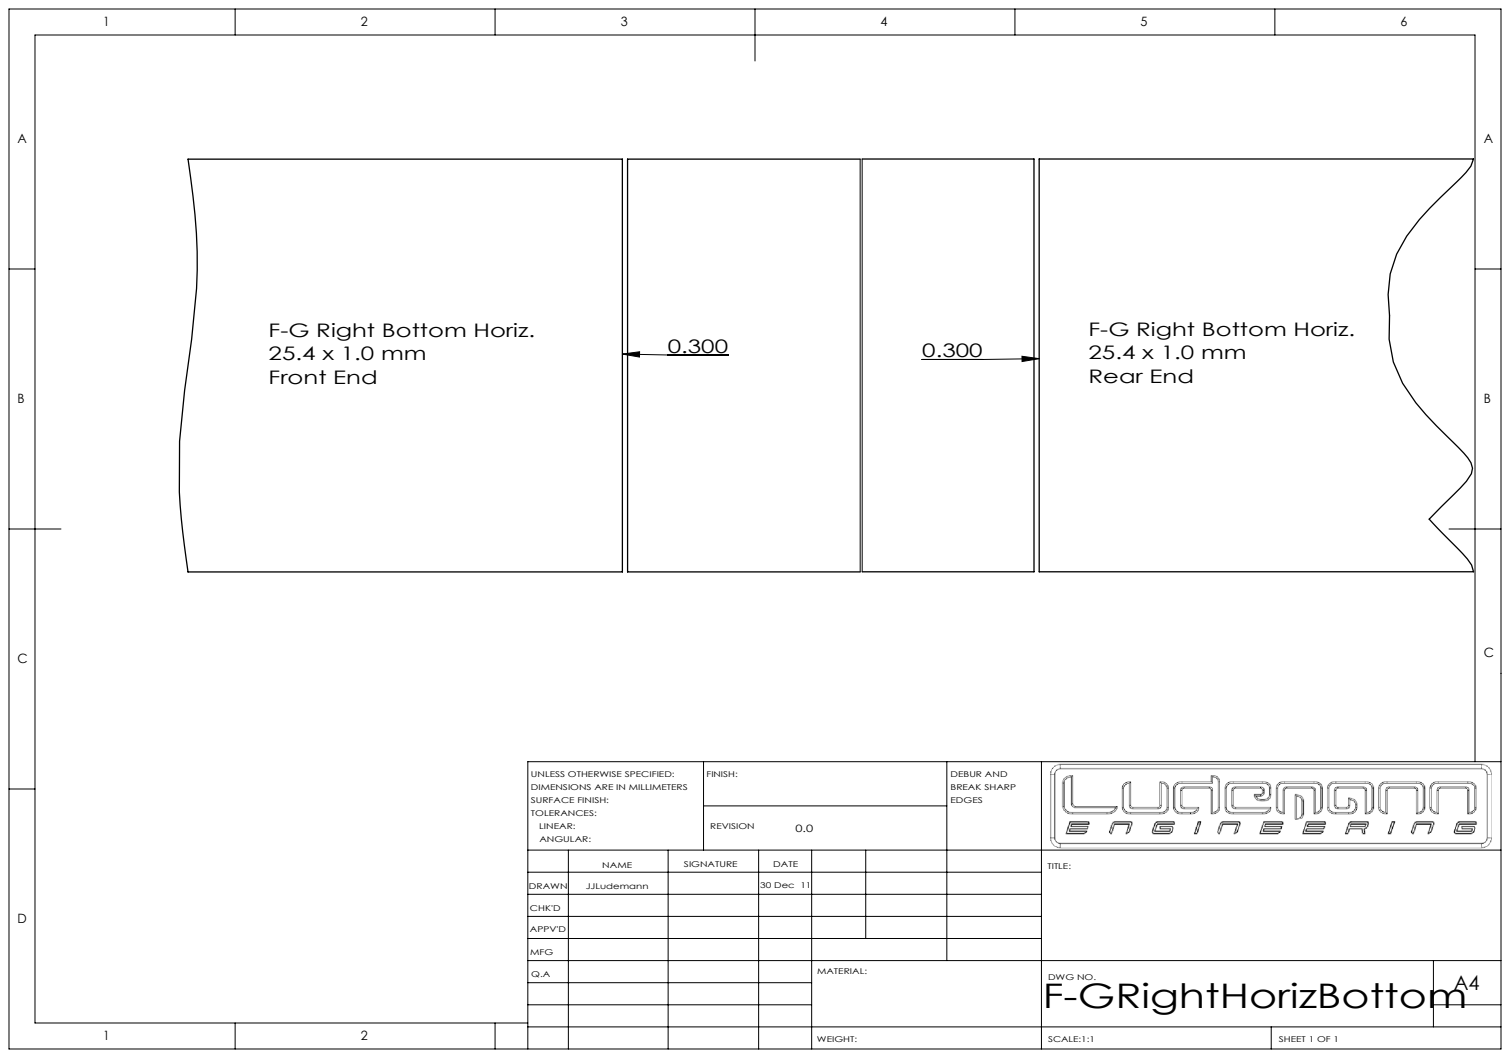
[picture p186: page 1]
FINISH:; DEBUR AND; BREAK SHARP; SCALE:1:1; SHEET 1 OF 1

0.300 F-G Right Bottom Horiz.
Front End

F-G Right Bottom Horiz.
Rear End

UNLESS OTHERWISE SPECIFIED:
DIMENSIONS ARE IN MILLIMETERS
SURFACE FINISH:
TOLERANCES:
LINEAR:
ANGULAR:

NAME | SIGNATURE | DATE | | | | TITLE:

DRAWN | JJLudemann | | 30 Dec 11

CHK'D

APPV'D

MFG
Q.A | | | | MATERIAL: | F-GRightHorizBottom DWG NO. | A4
