LudemannEngineering/Formula-1000-Race-Car/Solidworks/Chassis/Tubes/PDFs/F-GRollHoopBraces.PDF

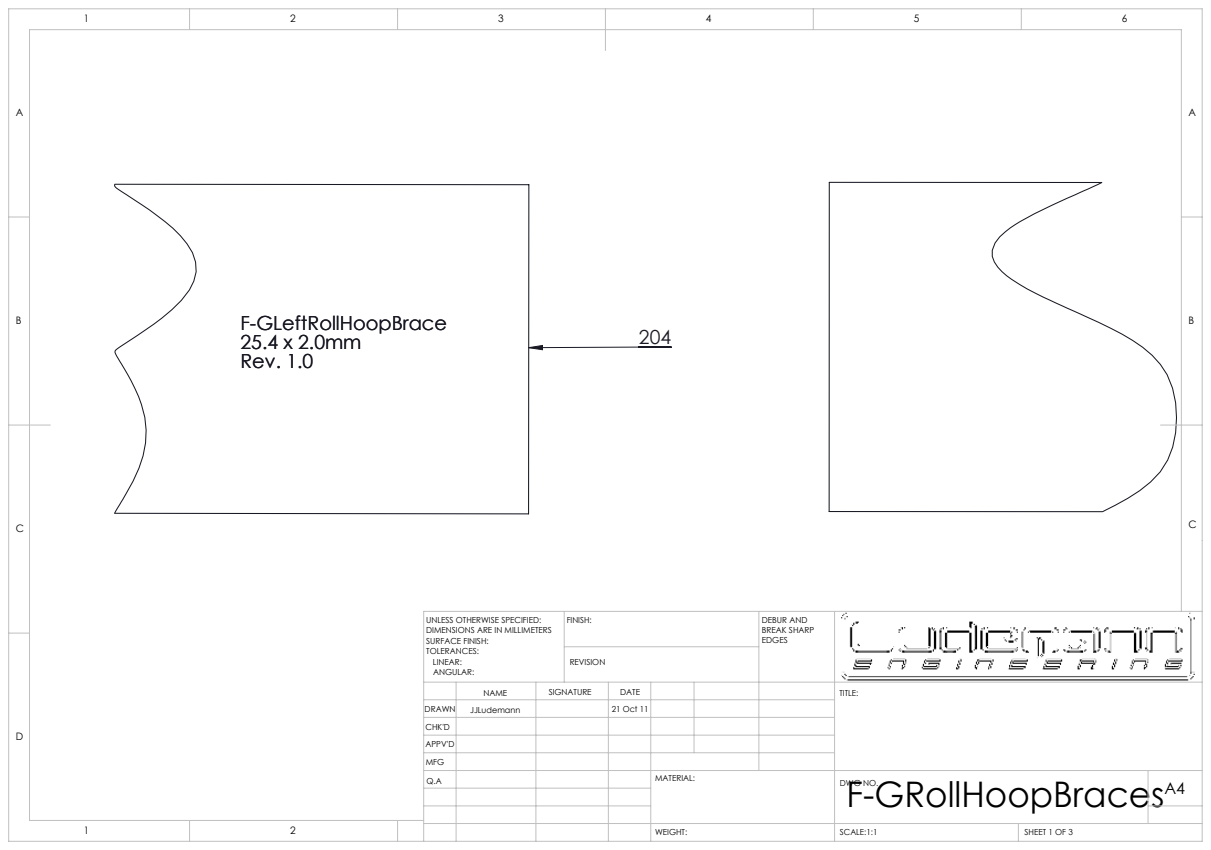
[picture p187: page 1]
204 F-GLeftRollHoopBrace 25.4 x 2.0mm Rev. 1.0; FINISH:; DEBUR AND; BREAK SHARP; SCALE:1:1; SHEET 1 OF 3

UNLESS OTHERWISE SPECIFIED:
DIMENSIONS ARE IN MILLIMETERS
SURFACE FINISH:
TOLERANCES:
LINEAR:
ANGULAR:

NAME | SIGNATURE | DATE | | | | TITLE:

DRAWN | JJLudemann | | 21 Oct 11
CHK'D
APPV'D
MFG
Q.A | | | | MATERIAL: | F-GRollHoopBraces DWG NO. | A4

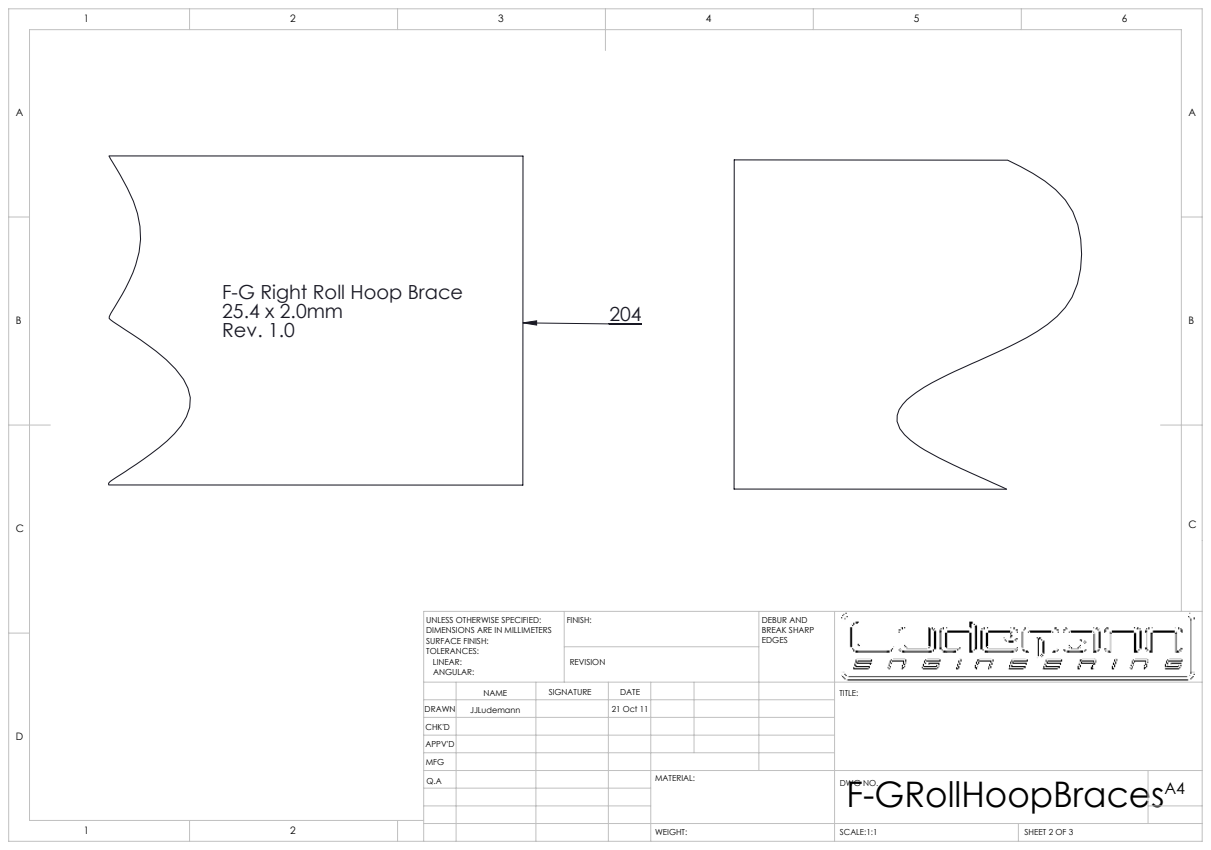
[picture p188: page 2]
Rev. 1.0 B; FINISH:; DEBUR AND; BREAK SHARP

F-G Right Roll Hoop Brace

UNLESS OTHERWISE SPECIFIED:
DIMENSIONS ARE IN MILLIMETERS
SURFACE FINISH:
TOLERANCES:
LINEAR:
ANGULAR:

NAME | SIGNATURE | DATE | | | | TITLE:

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

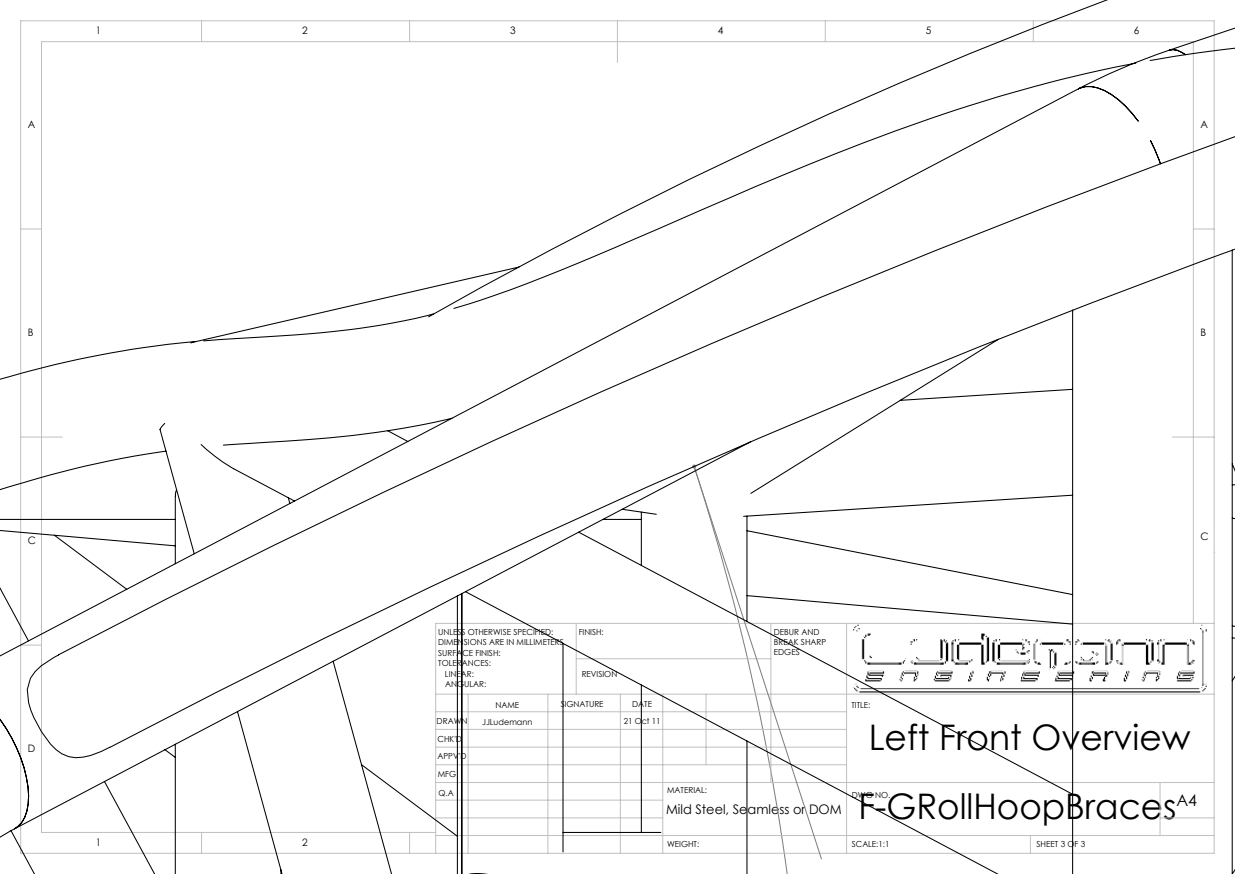
[picture p189: page 3]
FINISH:; DEBUR AND; BREAK SHARP

UNLESS OTHERWISE SPECIFIED:
DIMENSIONS ARE IN MILLIMETERS
SURFACE FINISH:
TOLERANCES:
LINEAR:
ANGULAR:

NAME | SIGNATURE | DATE | | | | TITLE: Left Front Overview

DRAWN | JJLudemann | | 21 Oct 11
CHK'D
APPV'D
MFG
Q.A | | | | MATERIAL: Mild Steel, Seamless or DOM | F-GRollHoopBraces DWG NO. | A4
