LudemannEngineering/Formula-1000-Race-Car/Solidworks/Chassis/Tubes/PDFs/FLeftVerticalLower.PDF

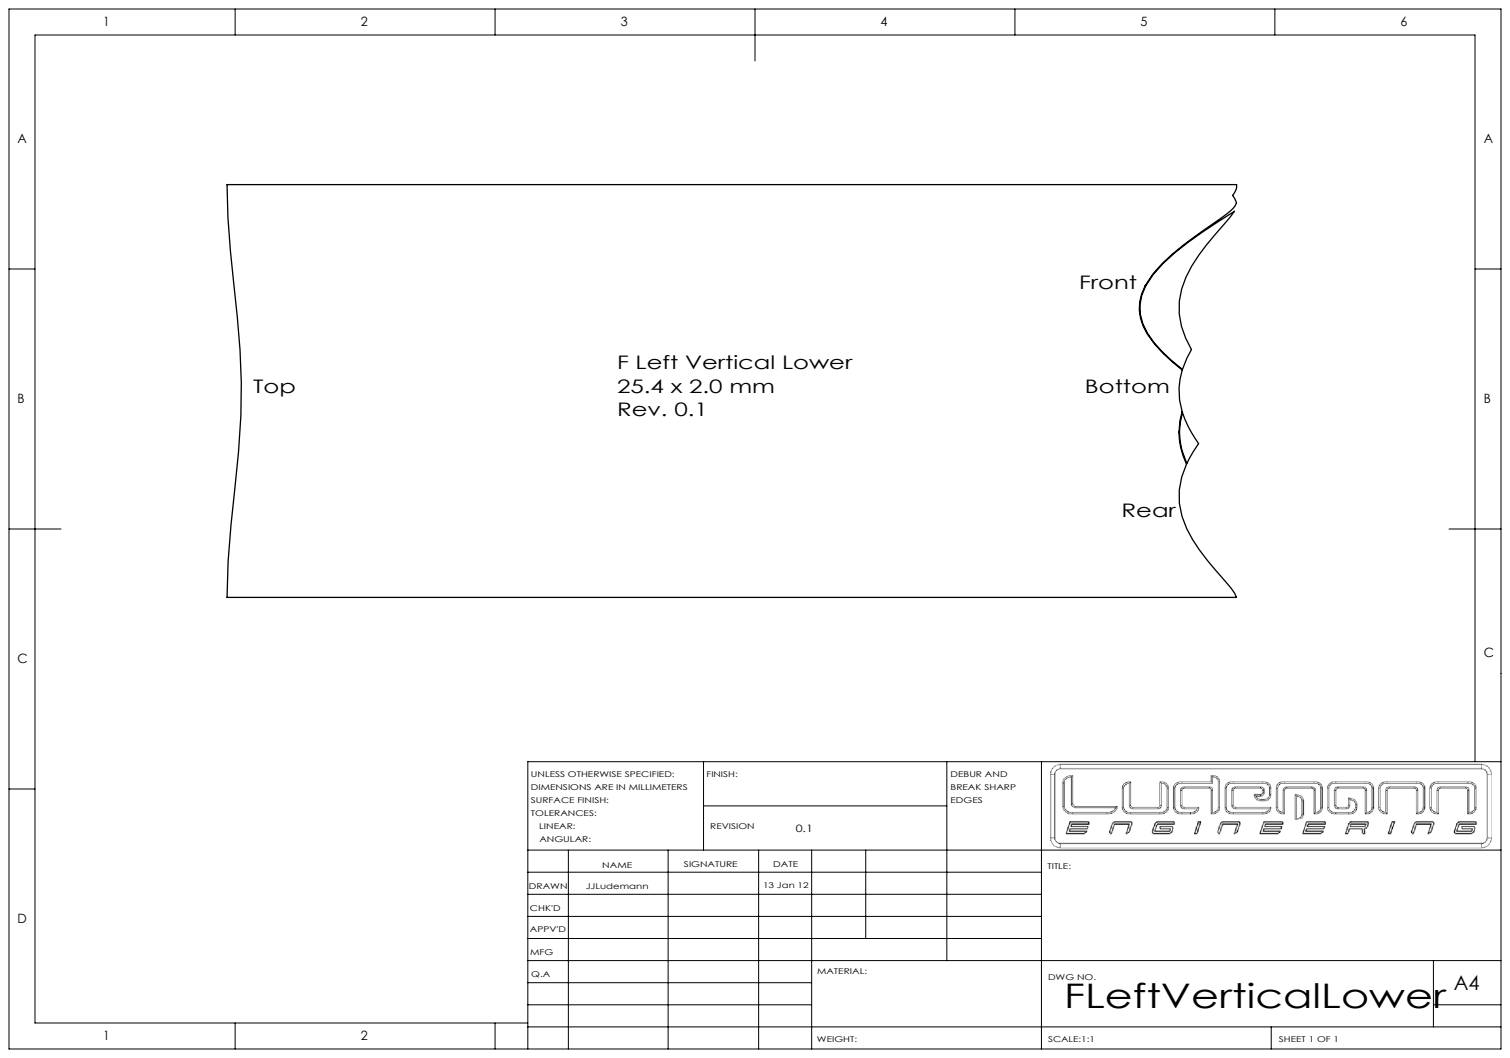
[picture p190: page 1]
FINISH:; DEBUR AND; BREAK SHARP; SCALE:1:1; SHEET 1 OF 1

F Left Vertical Lower
Rev. 0.1

UNLESS OTHERWISE SPECIFIED:
DIMENSIONS ARE IN MILLIMETERS
SURFACE FINISH:
TOLERANCES:
LINEAR:
ANGULAR:

NAME | SIGNATURE | DATE | | | | TITLE:

DRAWN | JJLudemann | | 13 Jan 12

CHK'D

APPV'D

MFG
Q.A | | | | MATERIAL: | DWG NO. FLeftVerticalLower | A4
