LudemannEngineering/Formula-1000-Race-Car/Solidworks/Chassis/Tubes/PDFs/G-HLeftDiagLower.PDF

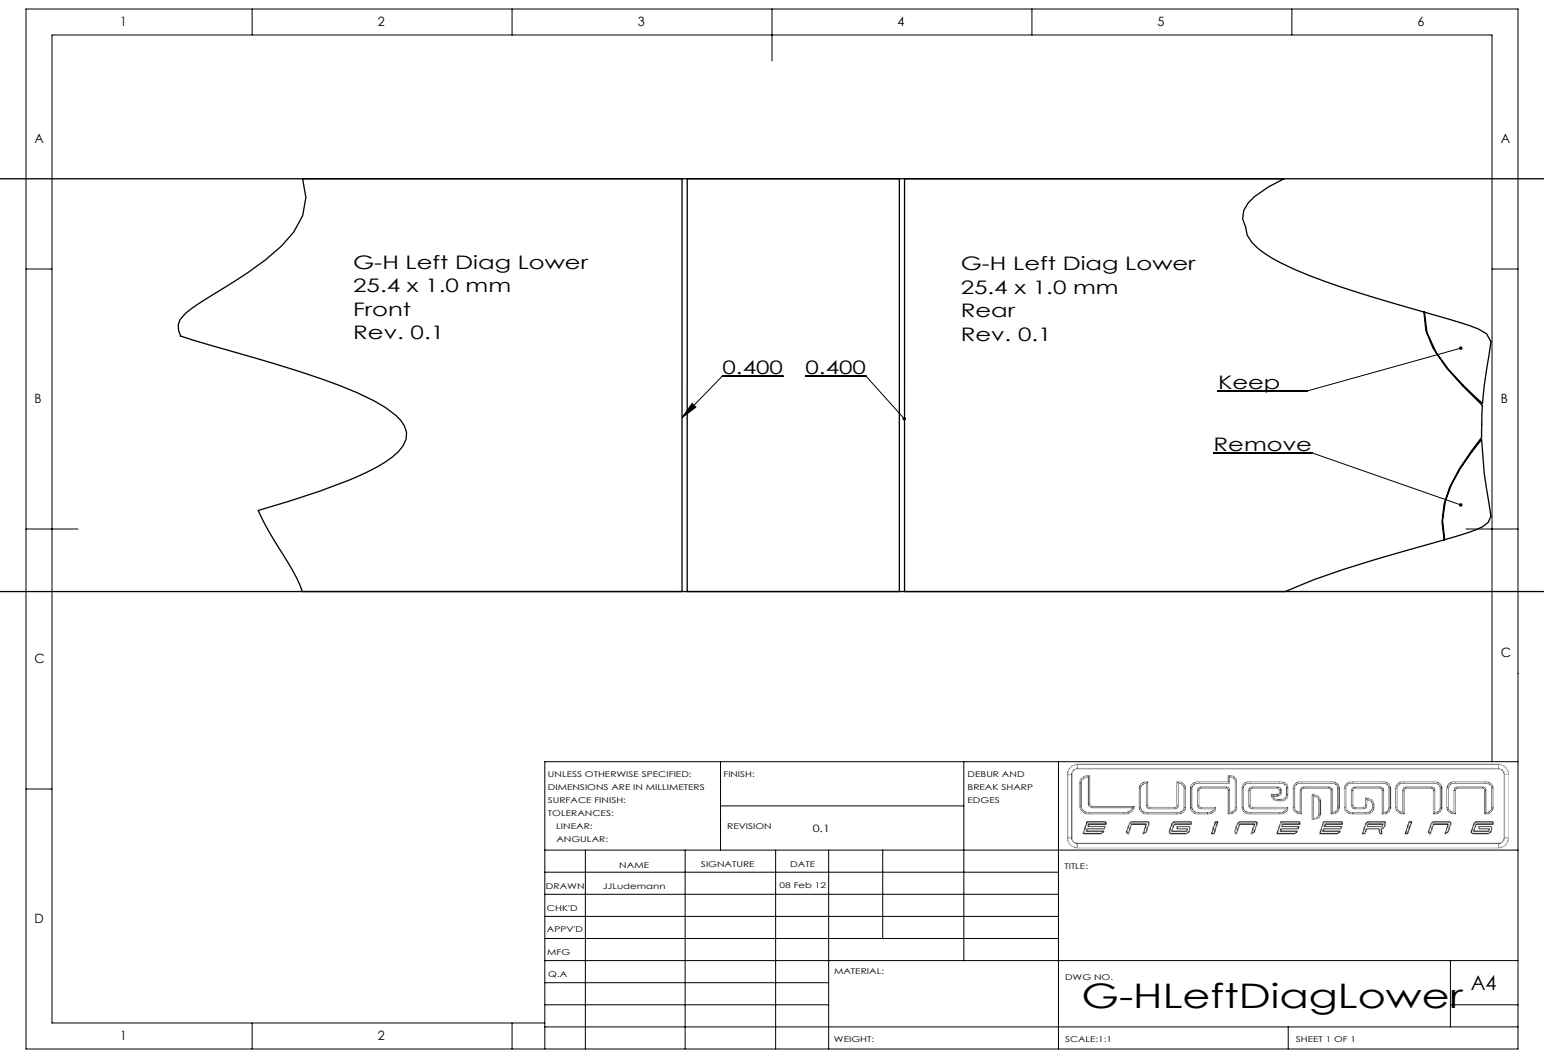
[picture p192: page 1]
FINISH:; DEBUR AND; BREAK SHARP; SCALE:1:1; SHEET 1 OF 1

G-H Left Diag Lower
Front
Rev. 0.1

Rear

UNLESS OTHERWISE SPECIFIED:
DIMENSIONS ARE IN MILLIMETERS
SURFACE FINISH:
TOLERANCES:
LINEAR:
ANGULAR:

NAME | SIGNATURE | DATE | | | | TITLE:

DRAWN | JJLudemann | | 08 Feb 12

CHK'D

APPV'D

MFG
Q.A | | | | MATERIAL: | DWG NO. G-HLeftDiagLower | A4
