LudemannEngineering/Formula-1000-Race-Car/Solidworks/Chassis/Tubes/PDFs/G-HLeftDiagUpper.PDF

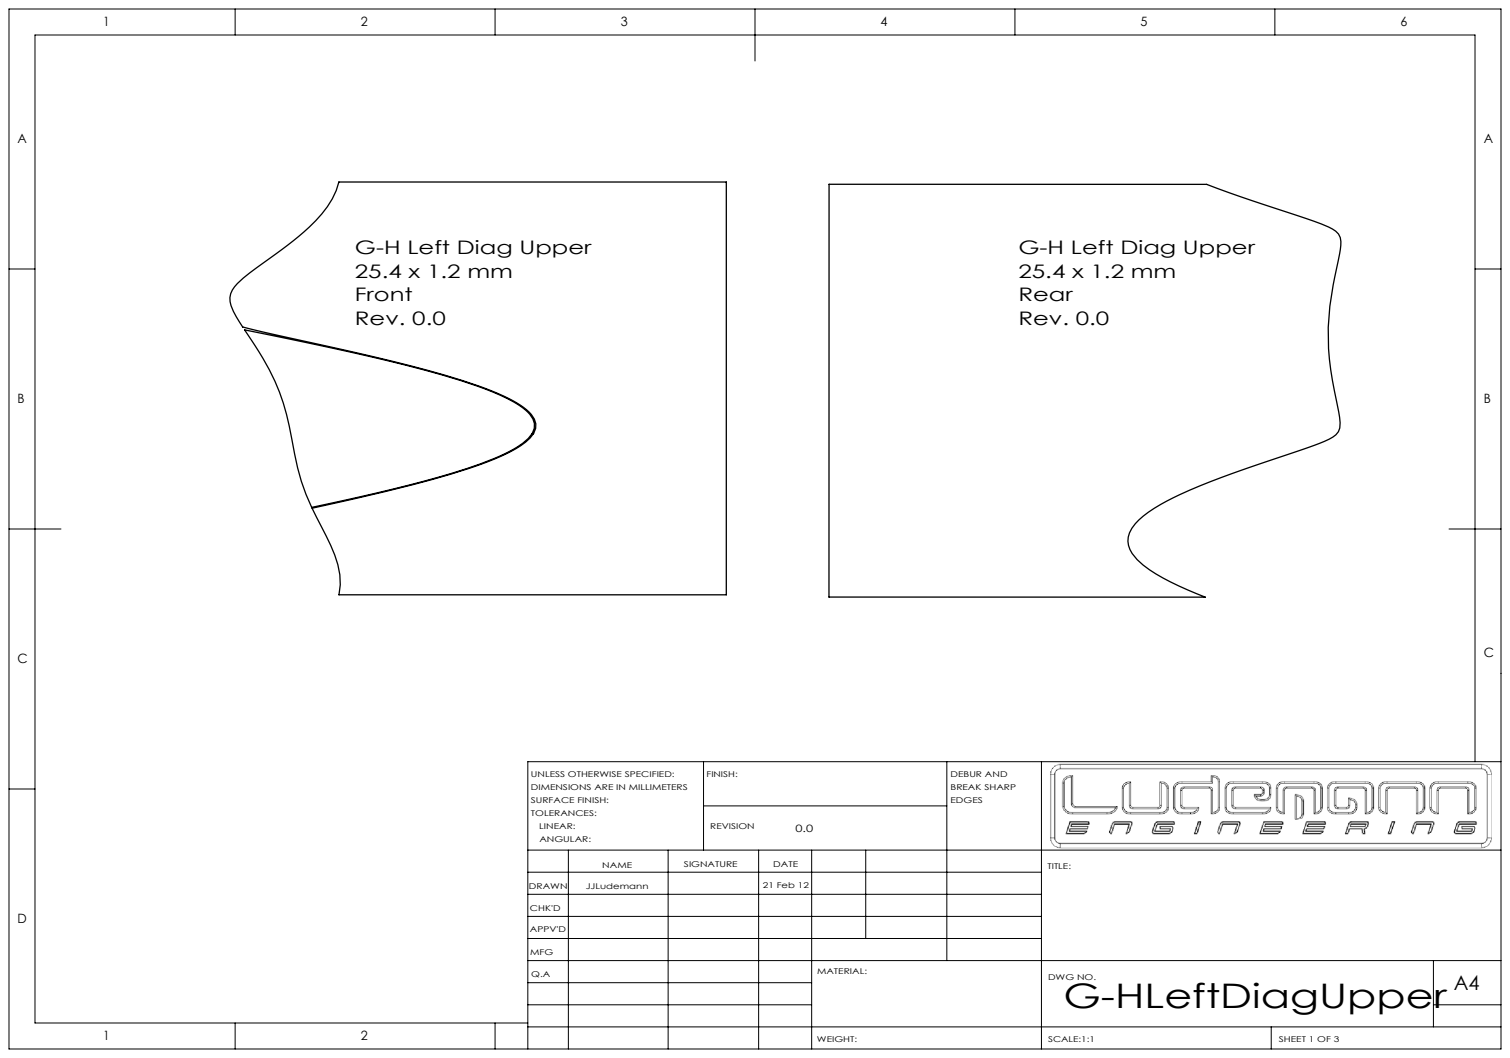
[picture p193: page 1]
FINISH:; DEBUR AND; BREAK SHARP; SCALE:1:1; SHEET 1 OF 3

G-H Left Diag Upper
Front
Rev. 0.0

Rear

UNLESS OTHERWISE SPECIFIED:
DIMENSIONS ARE IN MILLIMETERS
SURFACE FINISH:
TOLERANCES:
LINEAR:
ANGULAR:

NAME | SIGNATURE | DATE | | | | TITLE:

DRAWN | JJLudemann | | 21 Feb 12

CHK'D

APPV'D

MFG
Q.A | | | | MATERIAL: | DWG NO. G-HLeftDiagUpper | A4

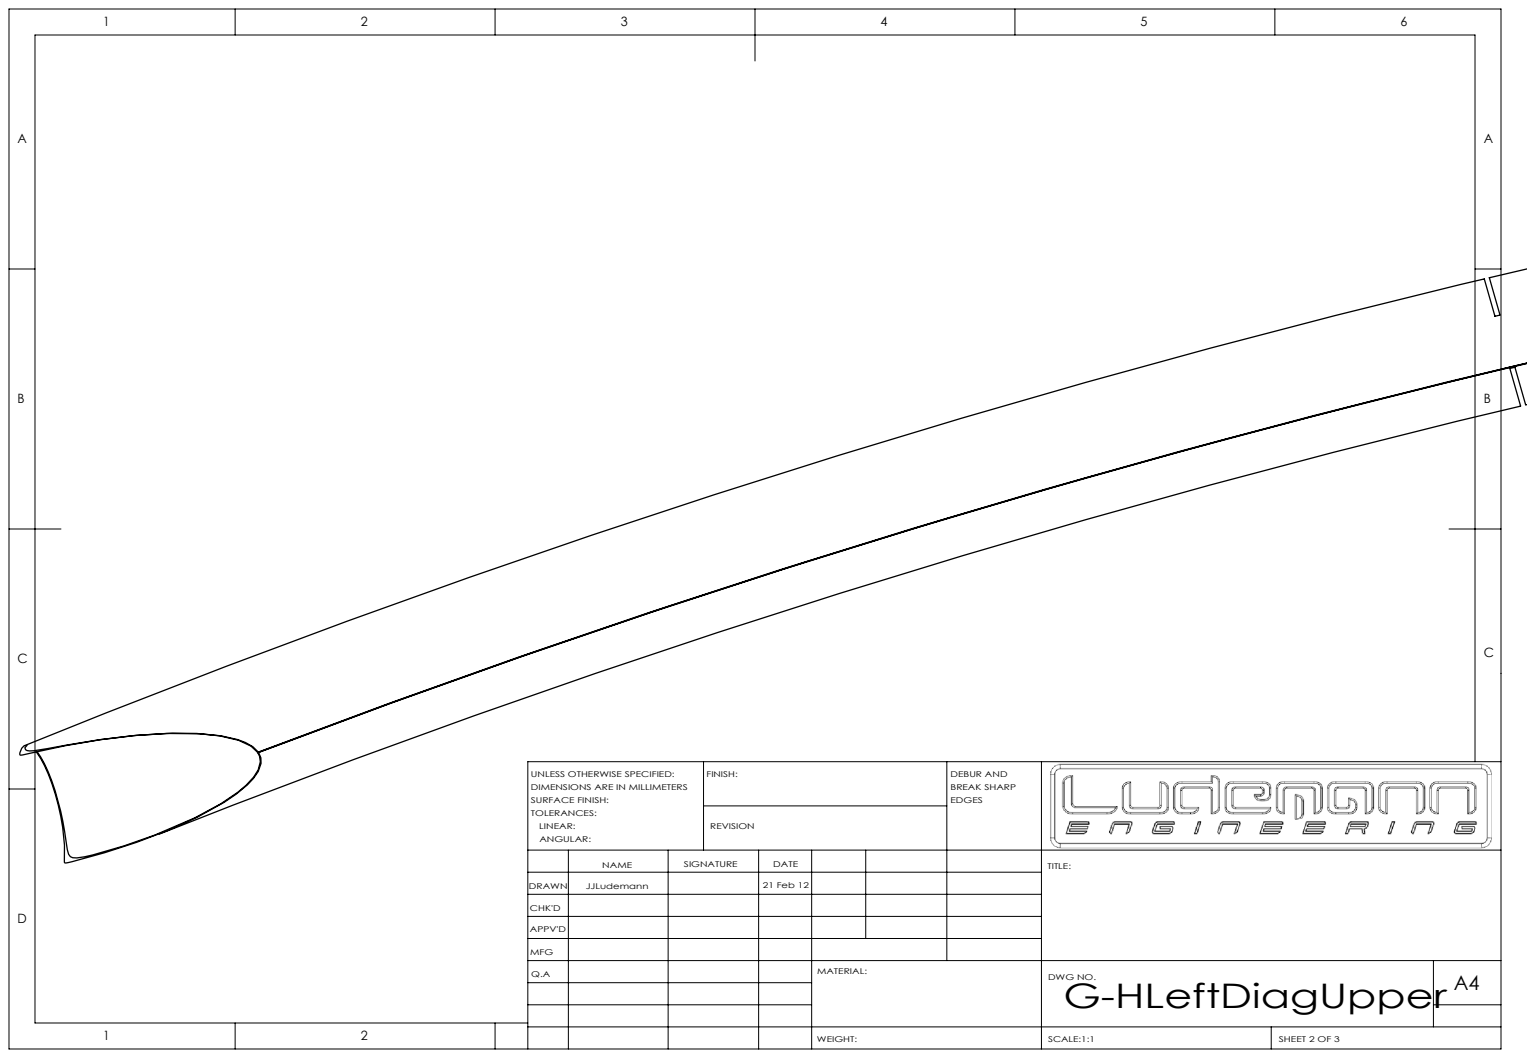
[picture p194: page 2]
FINISH:; DEBUR AND; BREAK SHARP

UNLESS OTHERWISE SPECIFIED:
DIMENSIONS ARE IN MILLIMETERS
SURFACE FINISH:
TOLERANCES:
LINEAR:
ANGULAR:

NAME | SIGNATURE | DATE | | | | TITLE:

DRAWN | JJLudemann | | 21 Feb 12

CHK'D

APPV'D

MFG
Q.A | | | | MATERIAL: | DWG NO. G-HLeftDiagUpper | A4

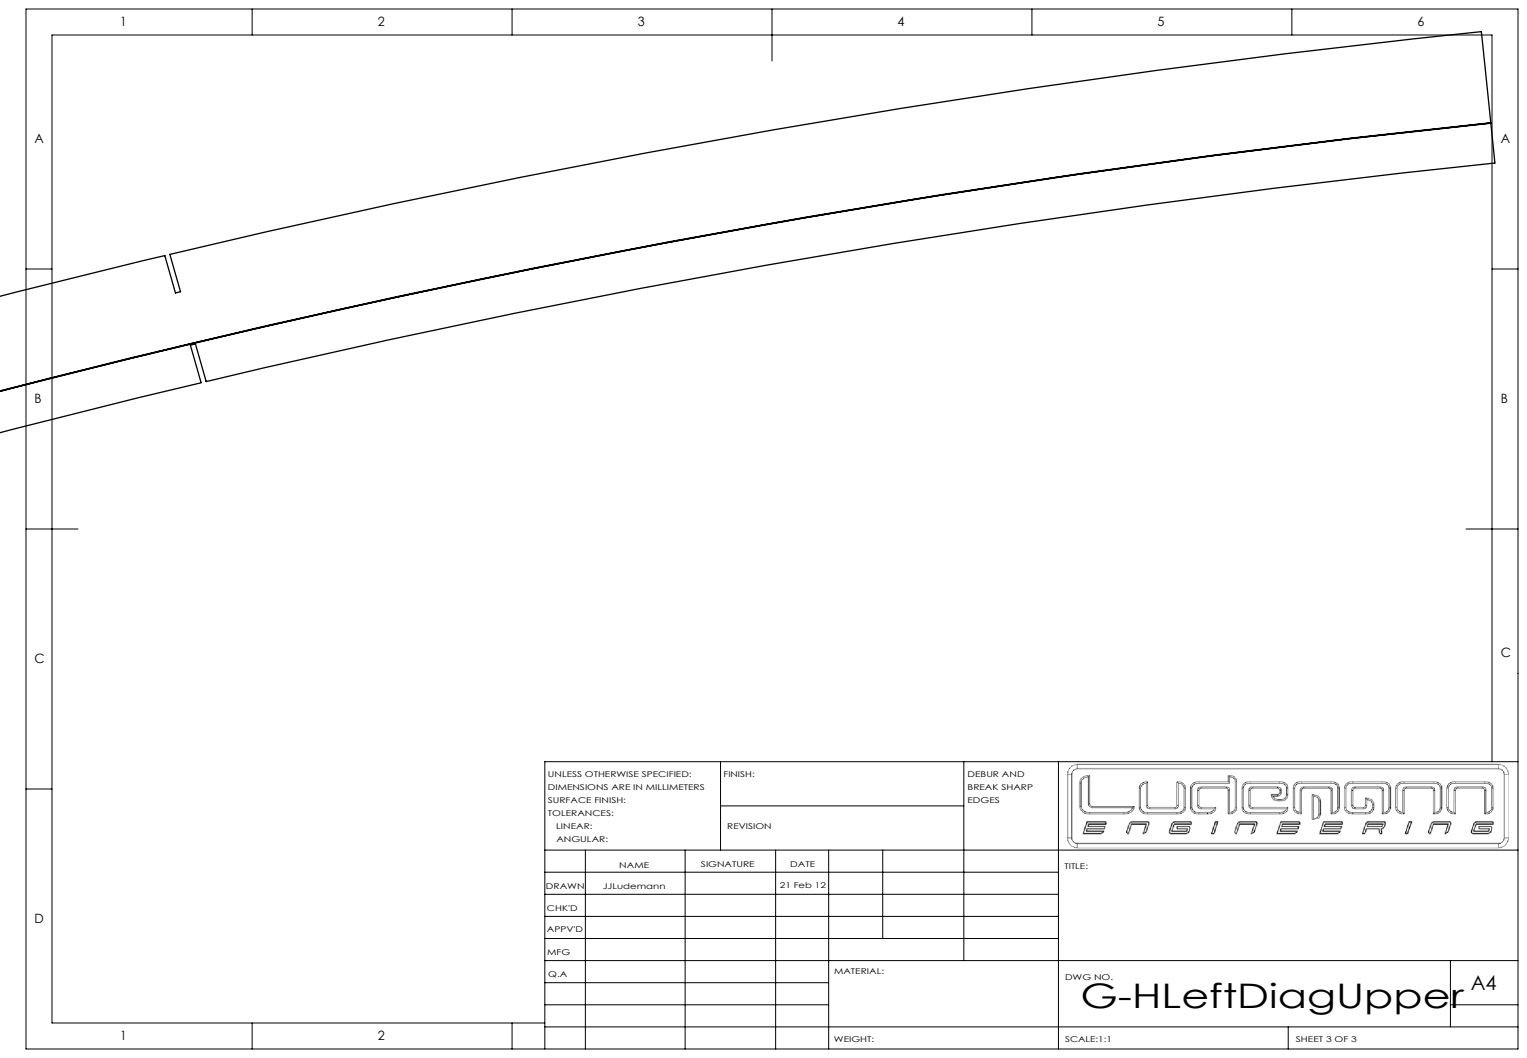
[picture p195: page 3]
FINISH:; DEBUR AND; BREAK SHARP

UNLESS OTHERWISE SPECIFIED:
DIMENSIONS ARE IN MILLIMETERS
SURFACE FINISH:
TOLERANCES:
LINEAR:
ANGULAR:

NAME | SIGNATURE | DATE | | | | TITLE:

DRAWN | JJLudemann | | 21 Feb 12

CHK'D

APPV'D

MFG
Q.A | | | | MATERIAL: | DWG NO. G-HLeftDiagUpper | A4
