LudemannEngineering/Formula-1000-Race-Car/Solidworks/Chassis/Tubes/PDFs/G-HLeftHorizBottom.PDF

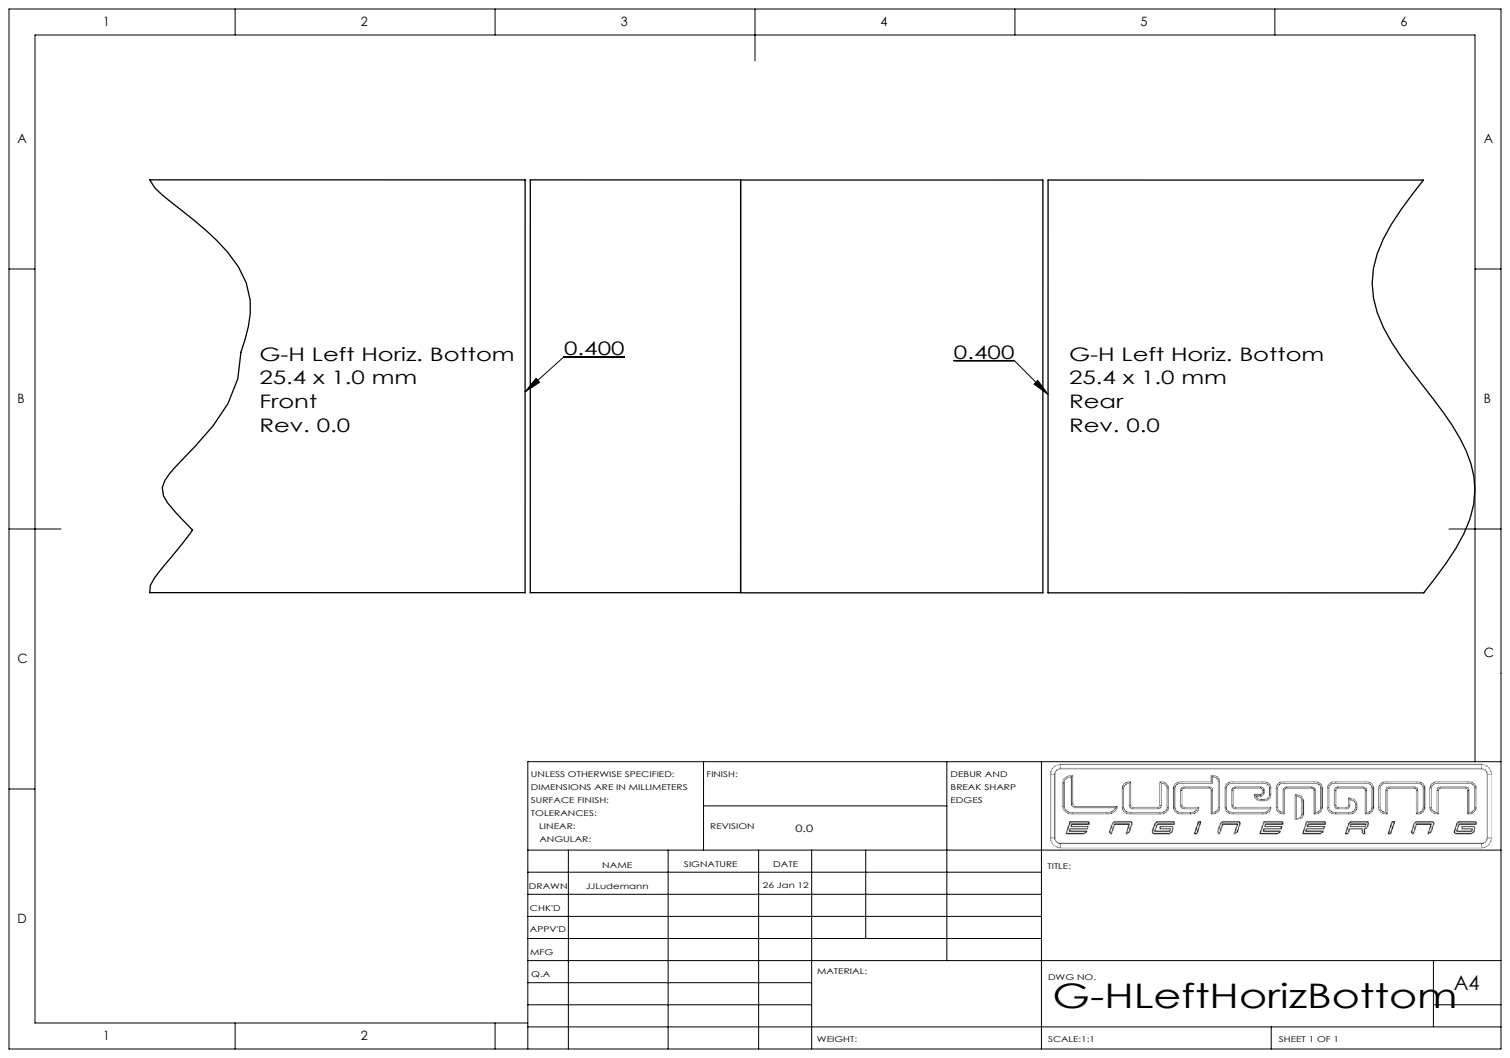
[picture p196: page 1]
G-H Left Horiz. Bottom; Rev. 0.0; FINISH:; DEBUR AND; BREAK SHARP; SCALE:1:1; SHEET 1 OF 1

G-H Left Horiz. Bottom
Rear
Rev. 0.0

UNLESS OTHERWISE SPECIFIED:
DIMENSIONS ARE IN MILLIMETERS
SURFACE FINISH:
TOLERANCES:
LINEAR:
ANGULAR:

NAME | SIGNATURE | DATE | | | | TITLE:

DRAWN | JJLudemann | | 26 Jan 12

CHK'D

APPV'D

MFG
Q.A | | | | MATERIAL: | DWG NO. G-HLeftHorizBottom | A4
