LudemannEngineering/Formula-1000-Race-Car/Solidworks/Chassis/Tubes/PDFs/G-HLeftHorizMid.PDF

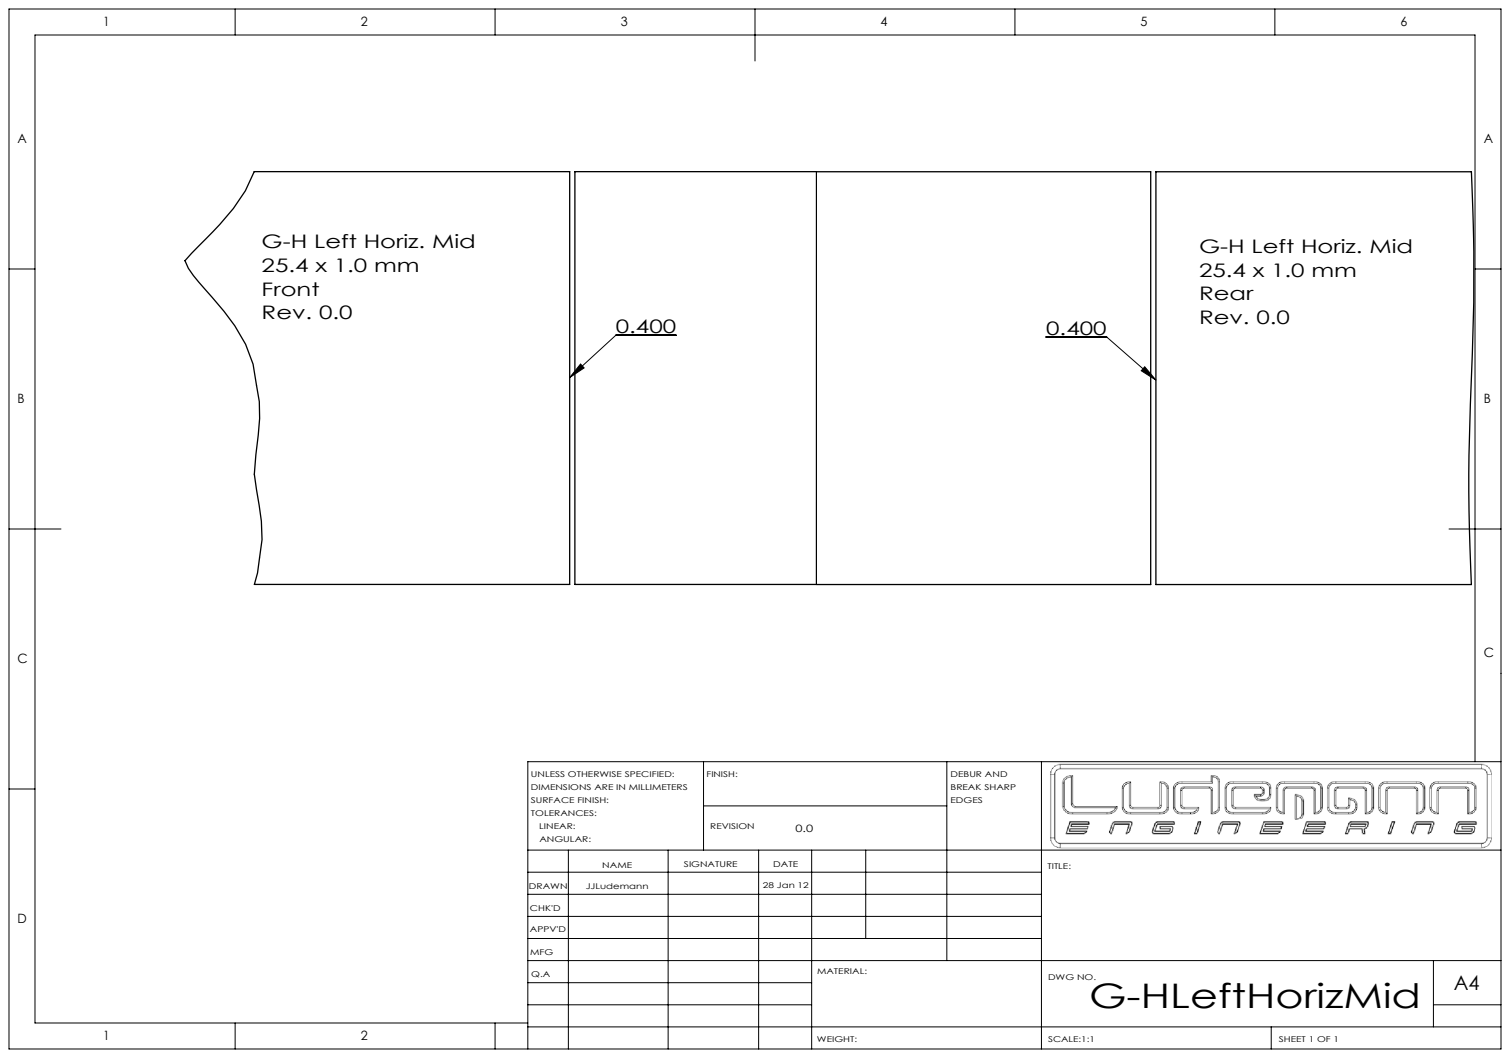
[picture p197: page 1]
Rev. 0.0; Rev. 0.0 0.400; FINISH:; DEBUR AND; BREAK SHARP; SCALE:1:1; SHEET 1 OF 1

G-H Left Horiz. Mid
Front

Rear

UNLESS OTHERWISE SPECIFIED:
DIMENSIONS ARE IN MILLIMETERS
SURFACE FINISH:
TOLERANCES:
LINEAR:
ANGULAR:

NAME | SIGNATURE | DATE | | | | TITLE:

DRAWN | JJLudemann | | 28 Jan 12

CHK'D

APPV'D

MFG
Q.A | | | | MATERIAL: | DWG NO. G-HLeftHorizMid | A4
