LudemannEngineering/Formula-1000-Race-Car/Solidworks/Chassis/Tubes/PDFs/G-HRightDiagLower.PDF

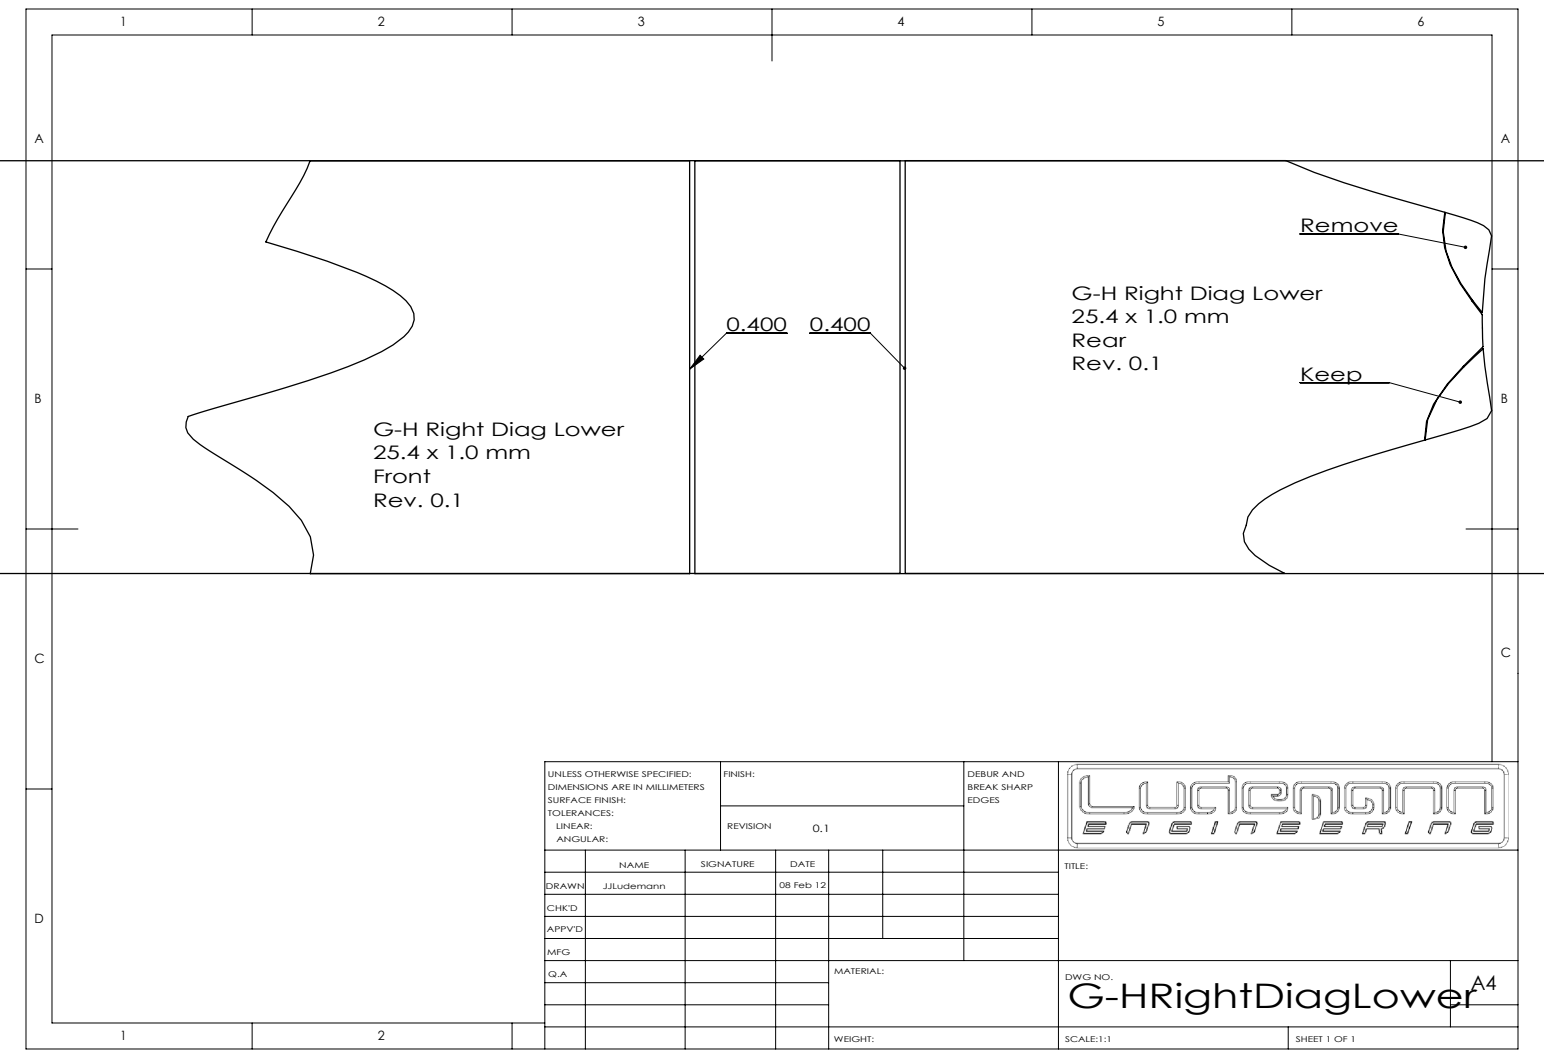
[picture p198: page 1]
FINISH:; DEBUR AND; BREAK SHARP; SCALE:1:1; SHEET 1 OF 1

G-H Right Diag Lower
Rear
Rev. 0.1

Front

UNLESS OTHERWISE SPECIFIED:
DIMENSIONS ARE IN MILLIMETERS
SURFACE FINISH:
TOLERANCES:
LINEAR:
ANGULAR:

NAME | SIGNATURE | DATE | | | | TITLE:

DRAWN | JJLudemann | | 08 Feb 12

CHK'D

APPV'D

MFG
Q.A | | | | MATERIAL: | DWG NO. G-HRightDiagLower | A4
