LudemannEngineering/Formula-1000-Race-Car/Solidworks/Chassis/Tubes/PDFs/G-LLeftTopRail.PDF

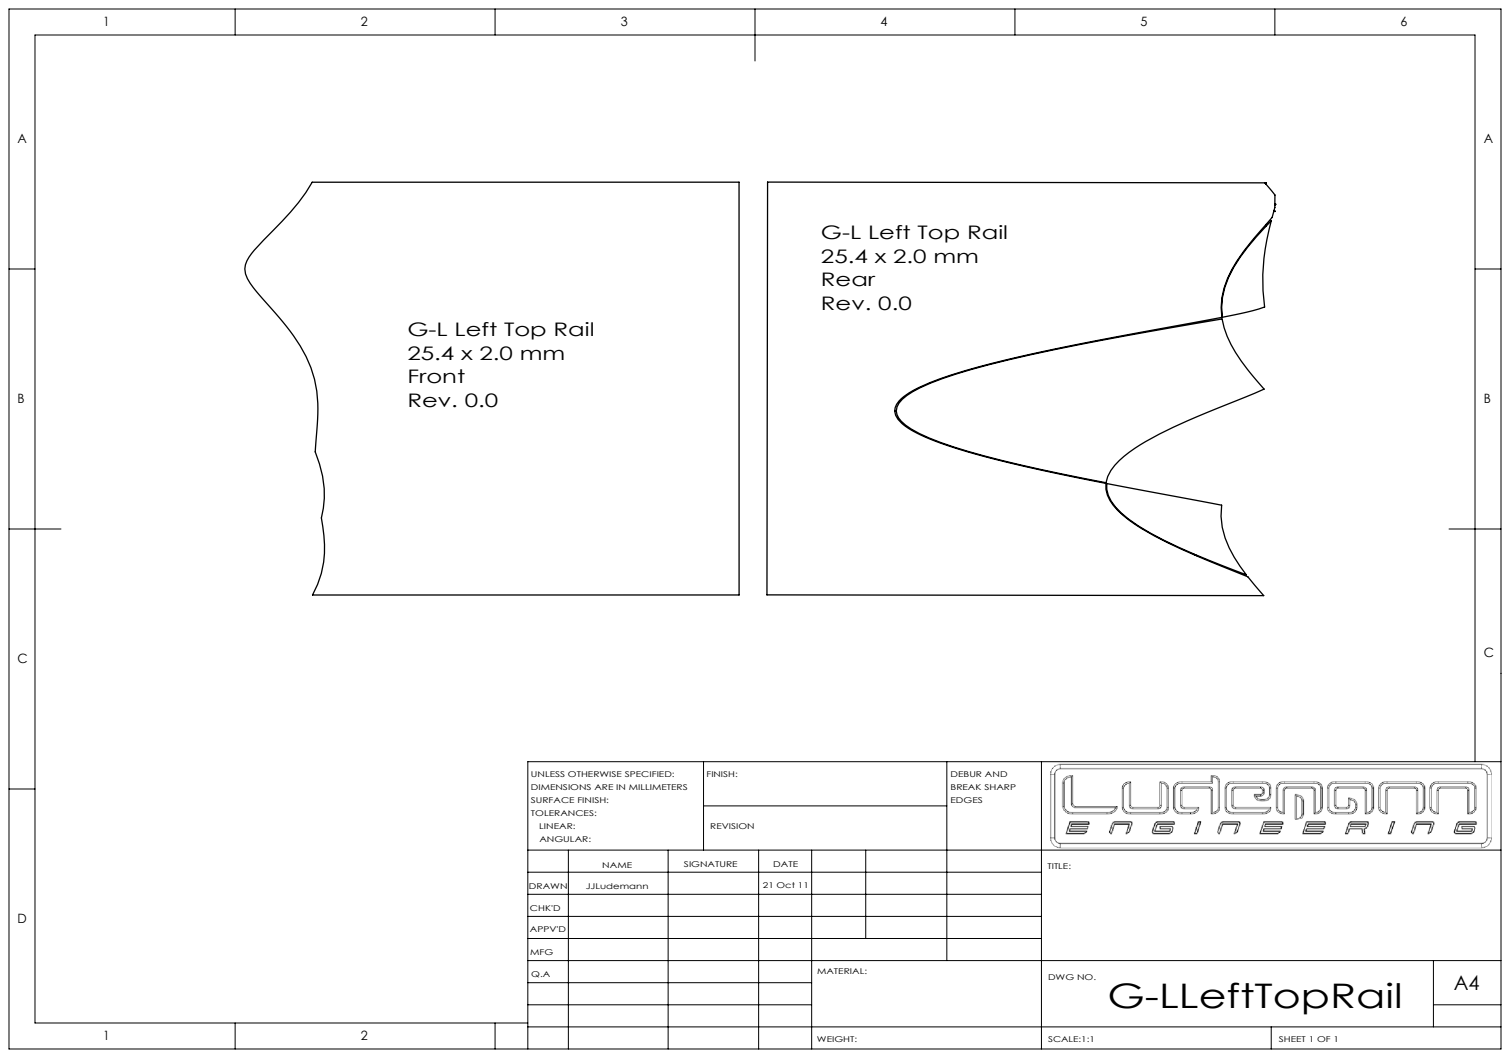
[picture p200: page 1]
FINISH:; DEBUR AND; BREAK SHARP; SCALE:1:1; SHEET 1 OF 1

G-L Left Top Rail
Rear
Rev. 0.0

Front

UNLESS OTHERWISE SPECIFIED:
DIMENSIONS ARE IN MILLIMETERS
SURFACE FINISH:
TOLERANCES:
LINEAR:
ANGULAR:

NAME | SIGNATURE | DATE | | | | TITLE:

DRAWN | JJLudemann | | 21 Oct 11

CHK'D

APPV'D

MFG
Q.A | | | | MATERIAL: | DWG NO. G-LLeftTopRail | A4
