LudemannEngineering/Formula-1000-Race-Car/Solidworks/Chassis/Tubes/PDFs/GCenterHorizBottom.PDF

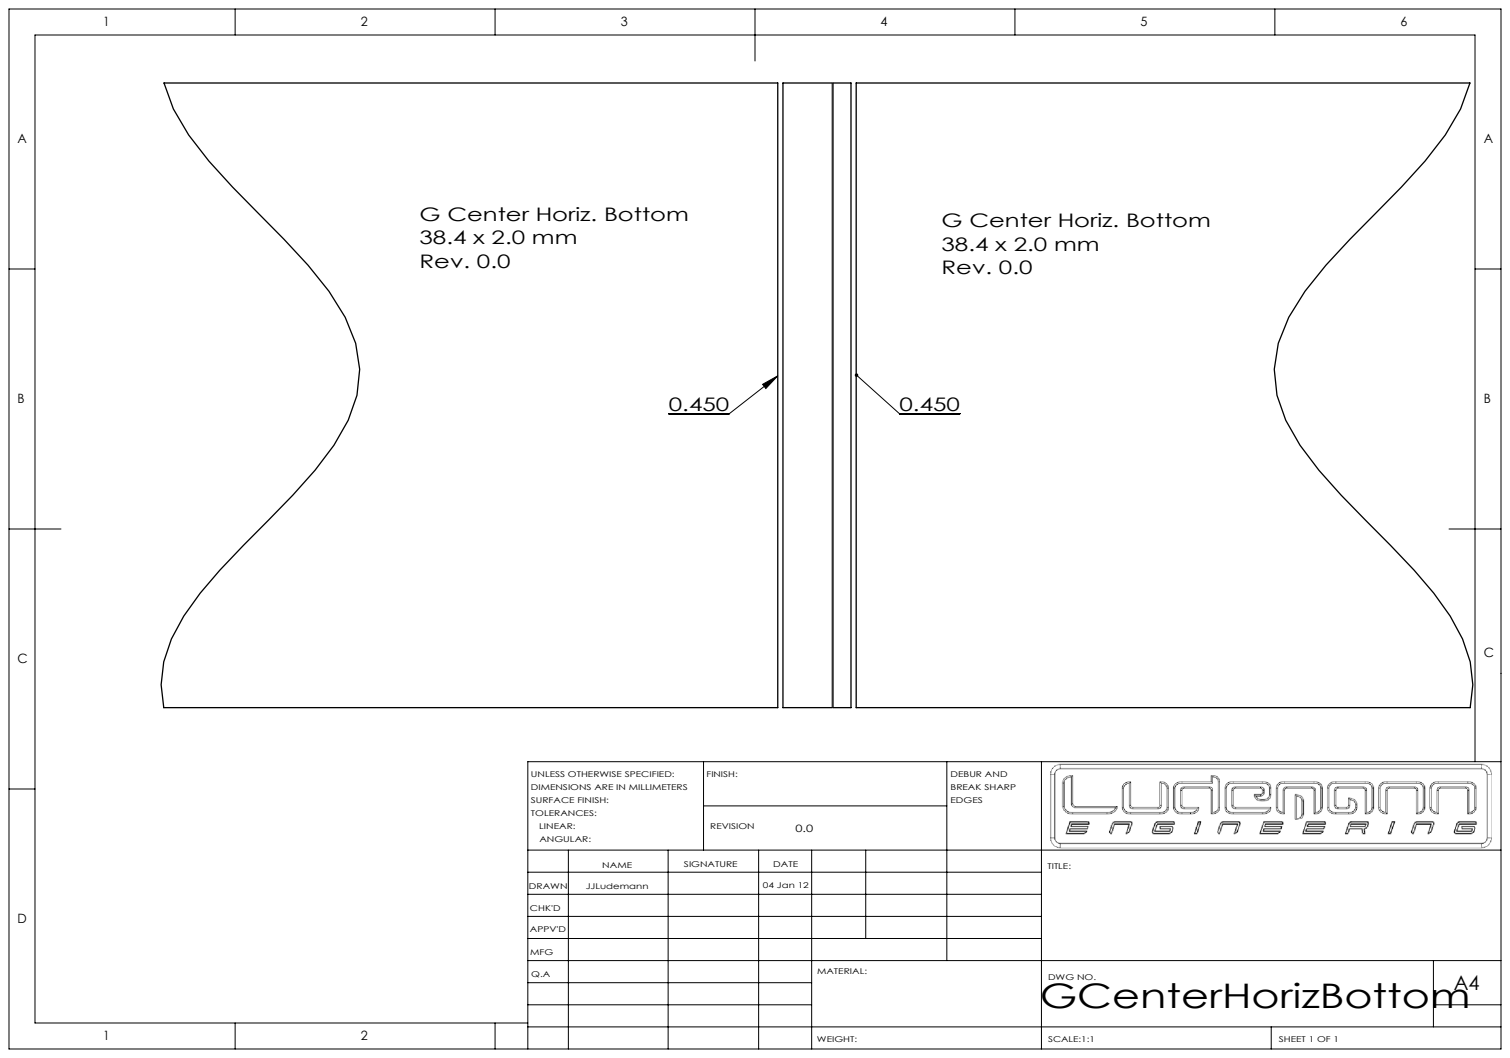
[picture p201: page 1]
FINISH:; DEBUR AND; BREAK SHARP; SCALE:1:1; SHEET 1 OF 1

G Center Horiz. Bottom
Rev. 0.0

UNLESS OTHERWISE SPECIFIED:
DIMENSIONS ARE IN MILLIMETERS
SURFACE FINISH:
TOLERANCES:
LINEAR:
ANGULAR:

NAME | SIGNATURE | DATE | | | | TITLE:

DRAWN | JJLudemann | | 04 Jan 12

CHK'D

APPV'D

MFG
Q.A | | | | MATERIAL: | GCenterHorizBottom DWG NO. | A4
