LudemannEngineering/Formula-1000-Race-Car/Solidworks/Chassis/Tubes/PDFs/GCenterVert.PDF

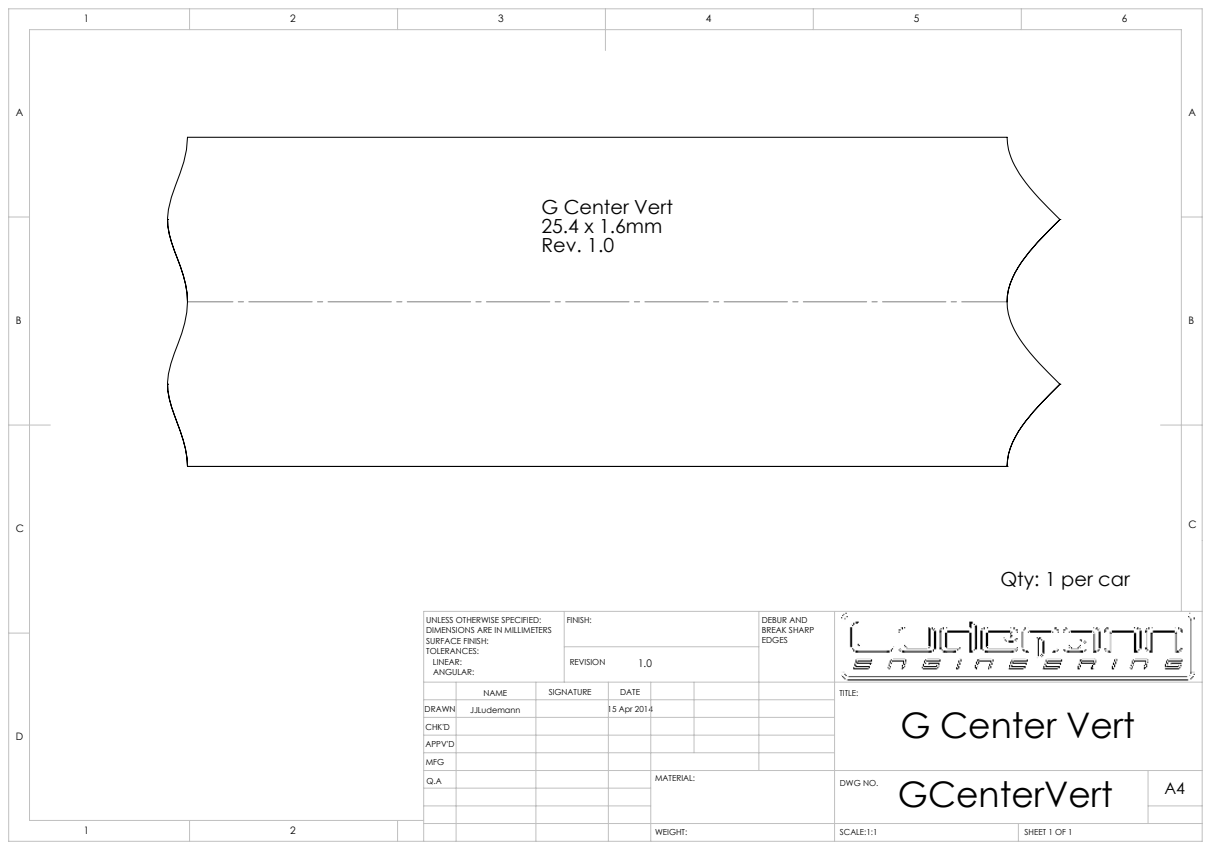
[picture p202: page 1]
G Center Vert 25.4 x 1.6mm Rev. 1.0; FINISH:; DEBUR AND; BREAK SHARP; SCALE:1:1; SHEET 1 OF 1

Qty: 1 per car

UNLESS OTHERWISE SPECIFIED:
DIMENSIONS ARE IN MILLIMETERS
SURFACE FINISH:
TOLERANCES:
LINEAR:
ANGULAR:

NAME | SIGNATURE | DATE | | | | TITLE: G Center Vert

DRAWN | JJLudemann | | 15 Apr 2014
CHK'D
APPV'D
MFG
Q.A | | | | MATERIAL: | GCenterVert DWG NO. | A4
