LudemannEngineering/Formula-1000-Race-Car/Solidworks/Chassis/Tubes/PDFs/GDiagLower.PDF

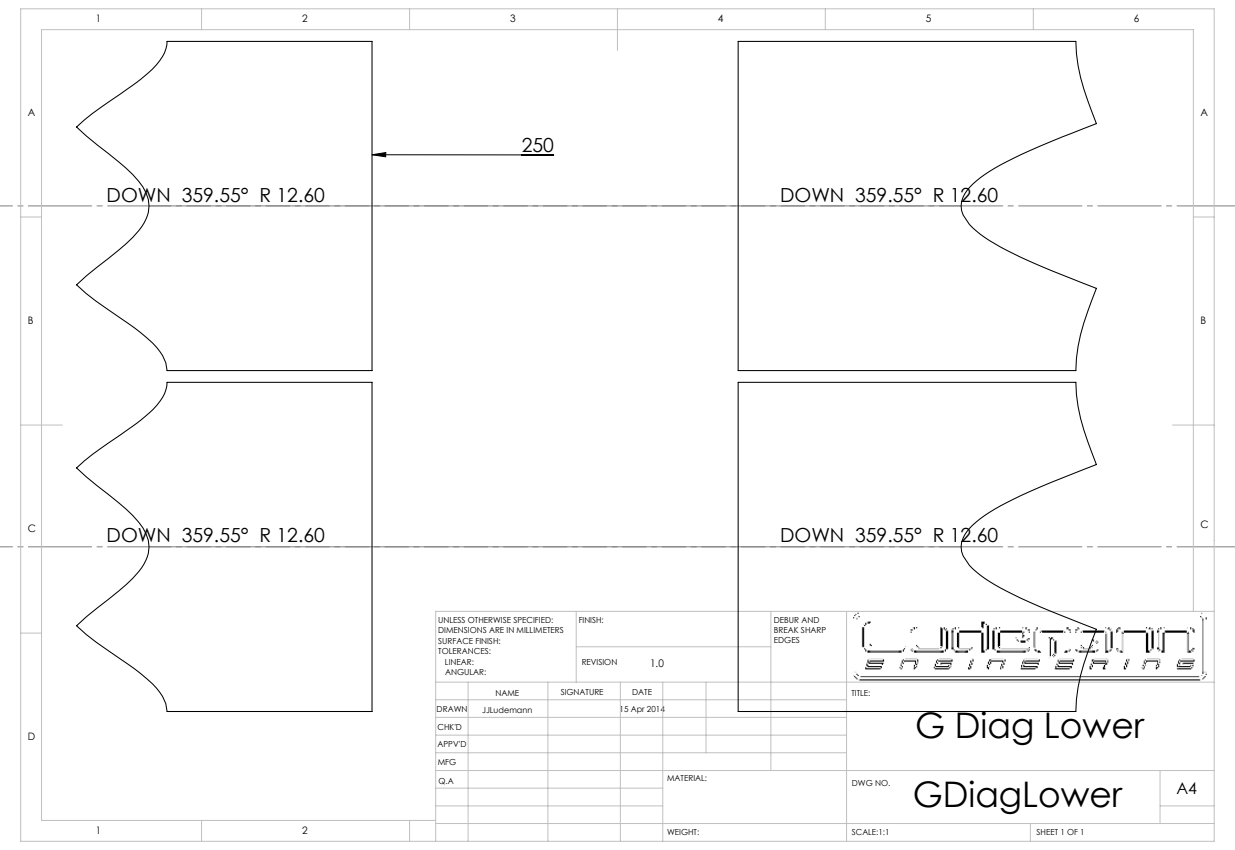
[picture p203: page 1]
DOWN 359.55° R 12.60; FINISH:; DEBUR AND; BREAK SHARP; SCALE:1:1; SHEET 1 OF 1

UNLESS OTHERWISE SPECIFIED:
DIMENSIONS ARE IN MILLIMETERS
SURFACE FINISH:
TOLERANCES:
LINEAR:
ANGULAR:

NAME | SIGNATURE | DATE | | | | TITLE: G Diag Lower

DRAWN | JJLudemann | | 15 Apr 2014
CHK'D
APPV'D
MFG
Q.A | | | | MATERIAL: | GDiagLower DWG NO. | A4
