LudemannEngineering/Formula-1000-Race-Car/Solidworks/Chassis/Tubes/PDFs/H-ILeftDiagLower.PDF

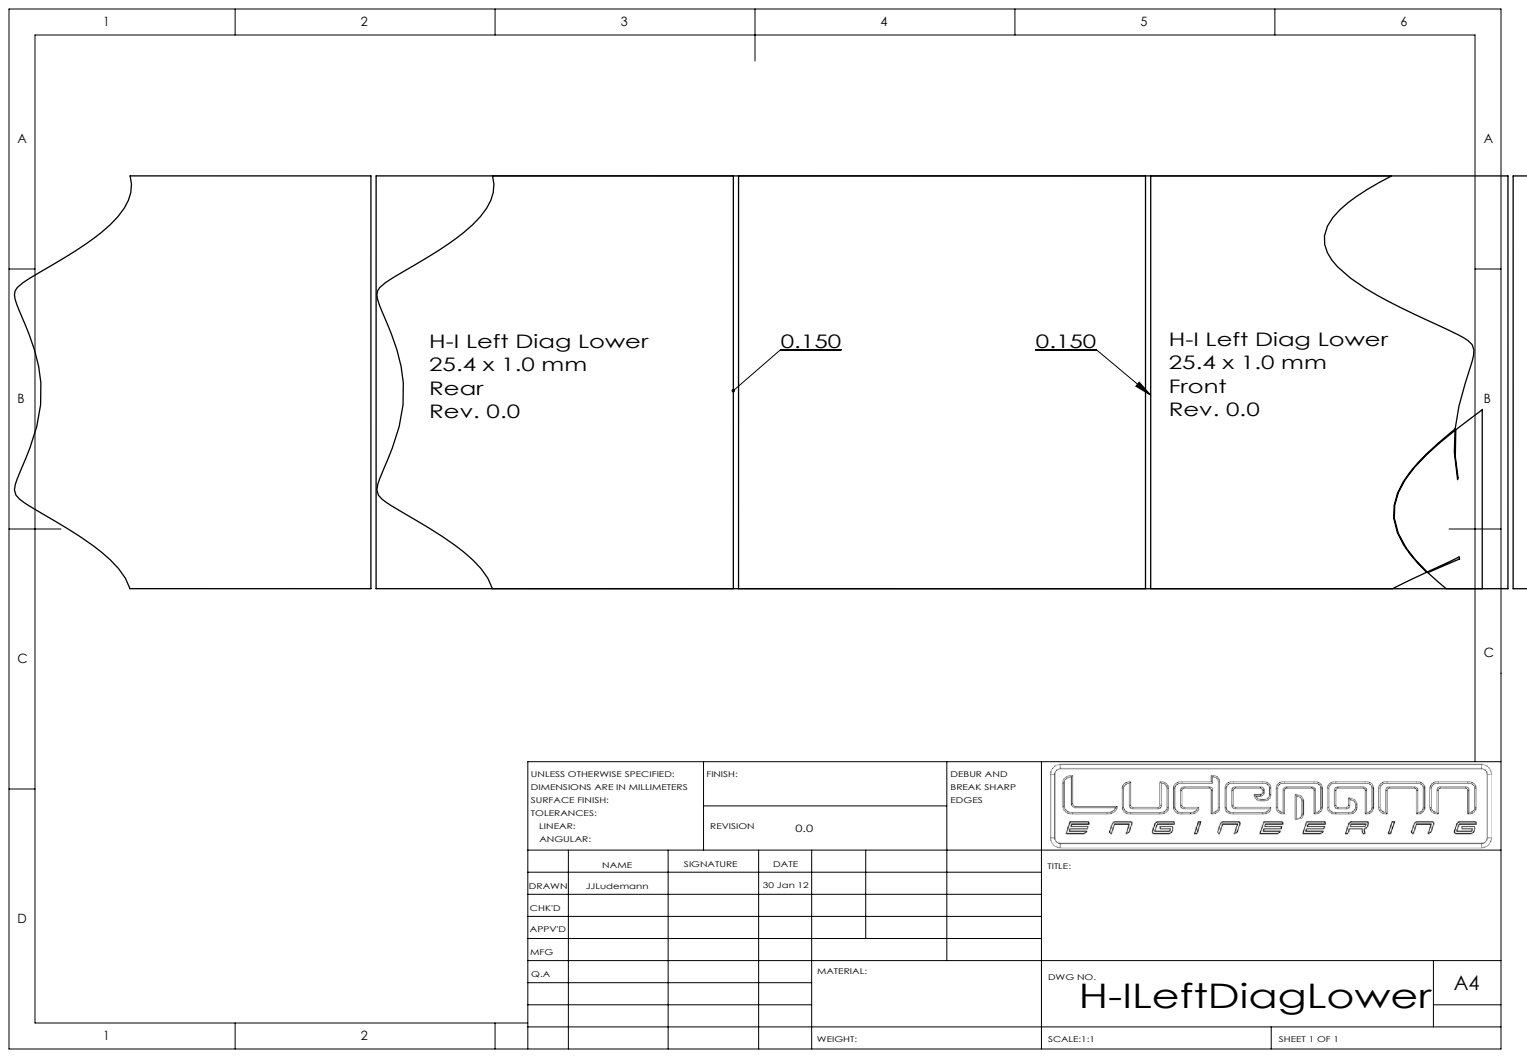
[picture p204: page 1]
H-I Left Diag Lower; Rev. 0.0; Rev. 0.0 B; FINISH:; DEBUR AND; BREAK SHARP; SCALE:1:1; SHEET 1 OF 1

H-I Left Diag Lower
Front

UNLESS OTHERWISE SPECIFIED:
DIMENSIONS ARE IN MILLIMETERS
SURFACE FINISH:
TOLERANCES:
LINEAR:
ANGULAR:

NAME | SIGNATURE | DATE | | | | TITLE:

DRAWN | JJLudemann | | 30 Jan 12

CHK'D

APPV'D

MFG
Q.A | | | | MATERIAL: | DWG NO. H-ILeftDiagLower | A4
