LudemannEngineering/Formula-1000-Race-Car/Solidworks/Chassis/Tubes/PDFs/H-IRightDiagLower.PDF

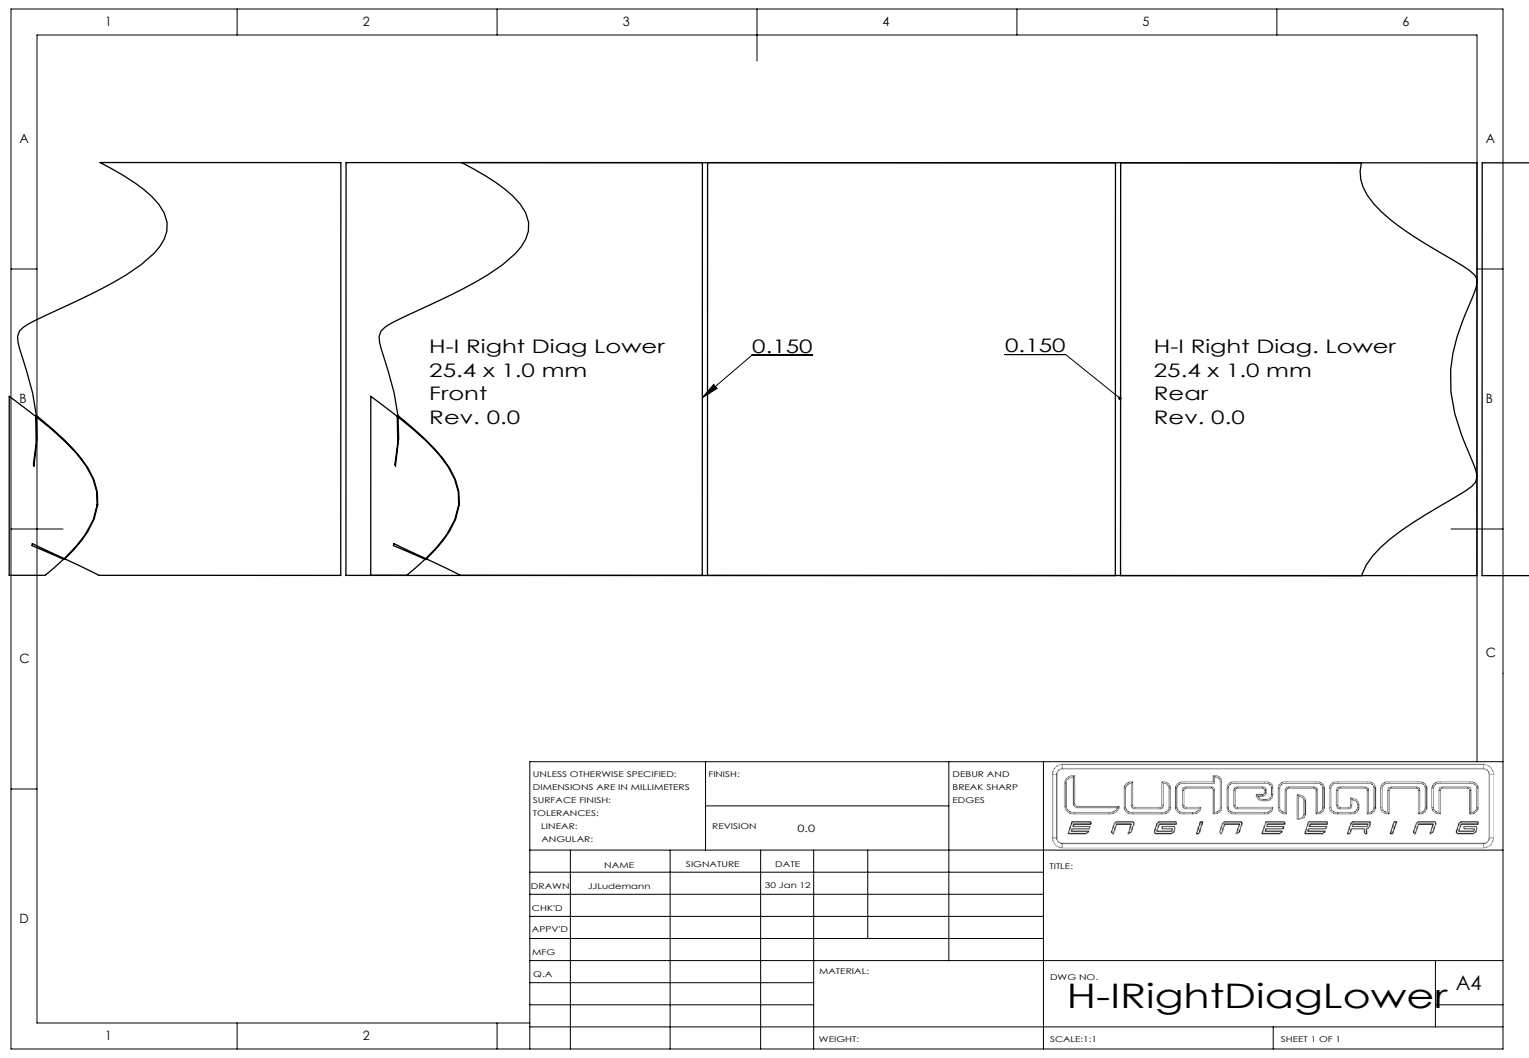
[picture p205: page 1]
H-I Right Diag. Lower; Rev. 0.0; FINISH:; DEBUR AND; BREAK SHARP; SCALE:1:1; SHEET 1 OF 1

H-I Right Diag Lower
Front
Rev. 0.0

UNLESS OTHERWISE SPECIFIED:
DIMENSIONS ARE IN MILLIMETERS
SURFACE FINISH:
TOLERANCES:
LINEAR:
ANGULAR:

NAME | SIGNATURE | DATE | | | | TITLE:

DRAWN | JJLudemann | | 30 Jan 12

CHK'D

APPV'D

MFG
Q.A | | | | MATERIAL: | DWG NO. H-IRightDiagLower | A4
