LudemannEngineering/Formula-1000-Race-Car/Solidworks/Chassis/Tubes/PDFs/H-JLeftBottom.PDF

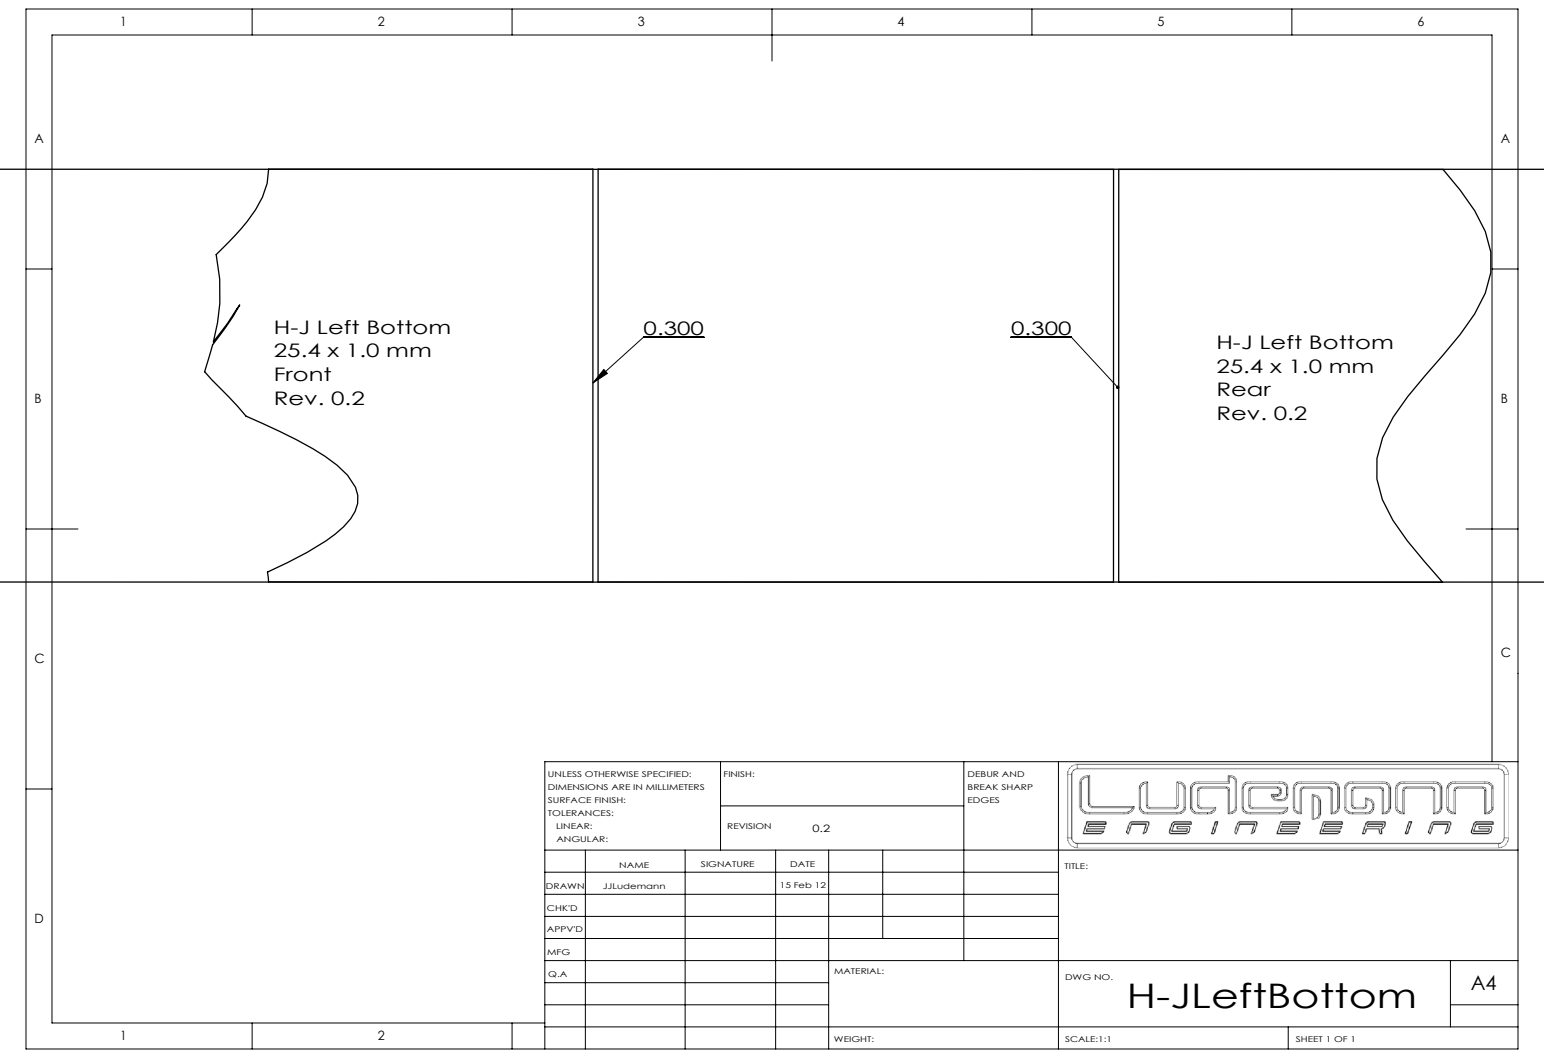
[picture p206: page 1]
H-J Left Bottom; Rev. 0.2; H-J Left Bottom 25.4 x 1.0 mm; FINISH:; DEBUR AND; BREAK SHARP; SCALE:1:1; SHEET 1 OF 1

UNLESS OTHERWISE SPECIFIED:
DIMENSIONS ARE IN MILLIMETERS
SURFACE FINISH:
TOLERANCES:
LINEAR:
ANGULAR:

NAME | SIGNATURE | DATE | | | | TITLE:

DRAWN | JJLudemann | | 15 Feb 12

CHK'D

APPV'D

MFG
Q.A | | | | MATERIAL: | DWG NO. H-JLeftBottom | A4
