LudemannEngineering/Formula-1000-Race-Car/Solidworks/Chassis/Tubes/PDFs/H-JLeftDiagInner.PDF

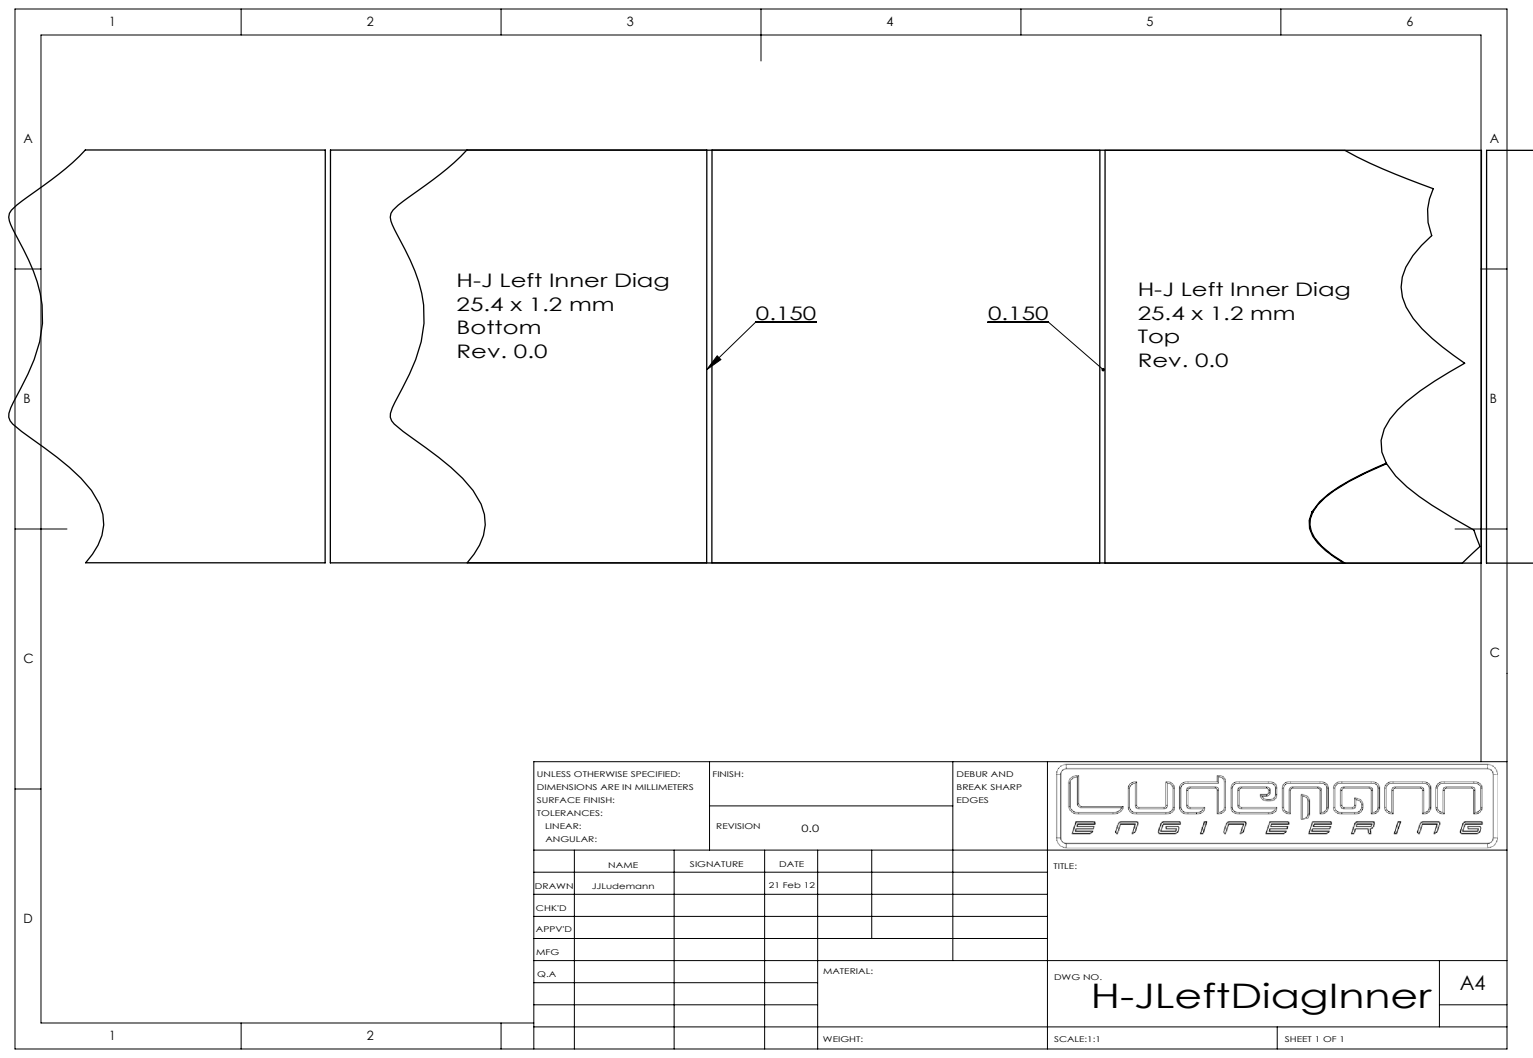
[picture p207: page 1]
FINISH:; DEBUR AND; BREAK SHARP; SCALE:1:1; SHEET 1 OF 1

H-J Left Inner Diag
Bottom
Rev. 0.0

Top

UNLESS OTHERWISE SPECIFIED:
DIMENSIONS ARE IN MILLIMETERS
SURFACE FINISH:
TOLERANCES:
LINEAR:
ANGULAR:

NAME | SIGNATURE | DATE | | | | TITLE:

DRAWN | JJLudemann | | 21 Feb 12

CHK'D

APPV'D

MFG
Q.A | | | | MATERIAL: | DWG NO. H-JLeftDiagInner | A4
