LudemannEngineering/Formula-1000-Race-Car/Solidworks/Chassis/Tubes/PDFs/H-JRightDiagInner.PDF

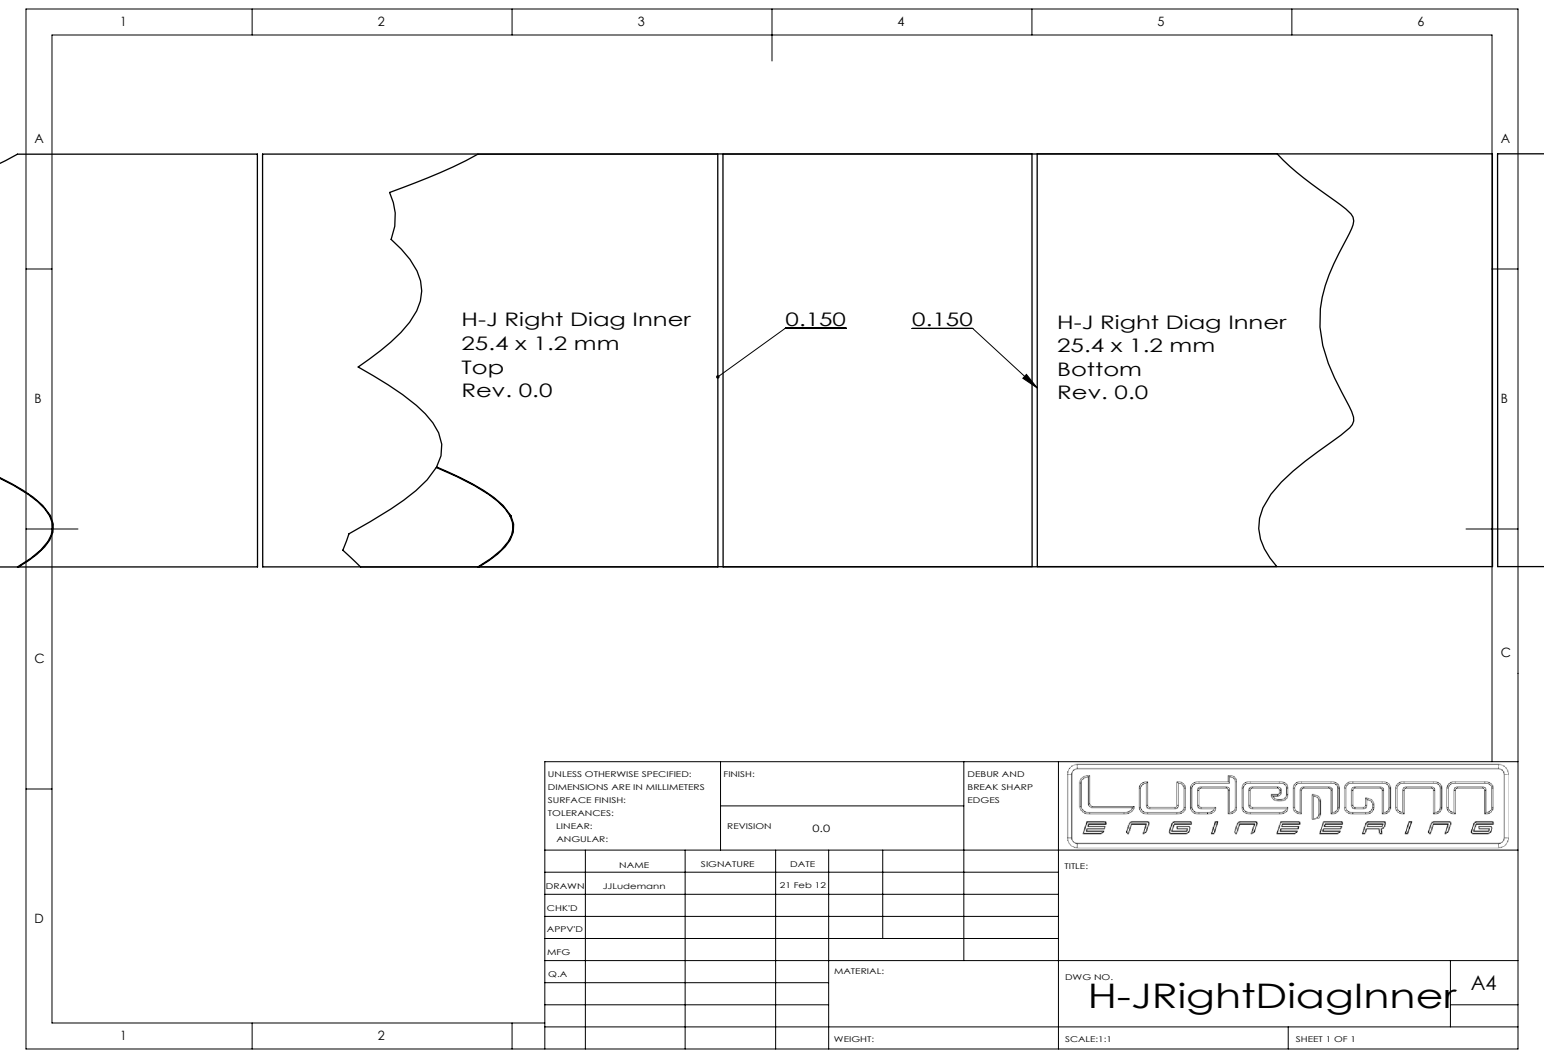
[picture p208: page 1]
H-J Right Diag Inner; Rev. 0.0; FINISH:; DEBUR AND; BREAK SHARP; SCALE:1:1; SHEET 1 OF 1

H-J Right Diag Inner
Top
Rev. 0.0

UNLESS OTHERWISE SPECIFIED:
DIMENSIONS ARE IN MILLIMETERS
SURFACE FINISH:
TOLERANCES:
LINEAR:
ANGULAR:

NAME | SIGNATURE | DATE | | | | TITLE:

DRAWN | JJLudemann | | 21 Feb 12

CHK'D

APPV'D

MFG
Q.A | | | | MATERIAL: | DWG NO. H-JRightDiagInner | A4
