LudemannEngineering/Formula-1000-Race-Car/Solidworks/Chassis/Tubes/PDFs/HCenterHorizBottom.PDF

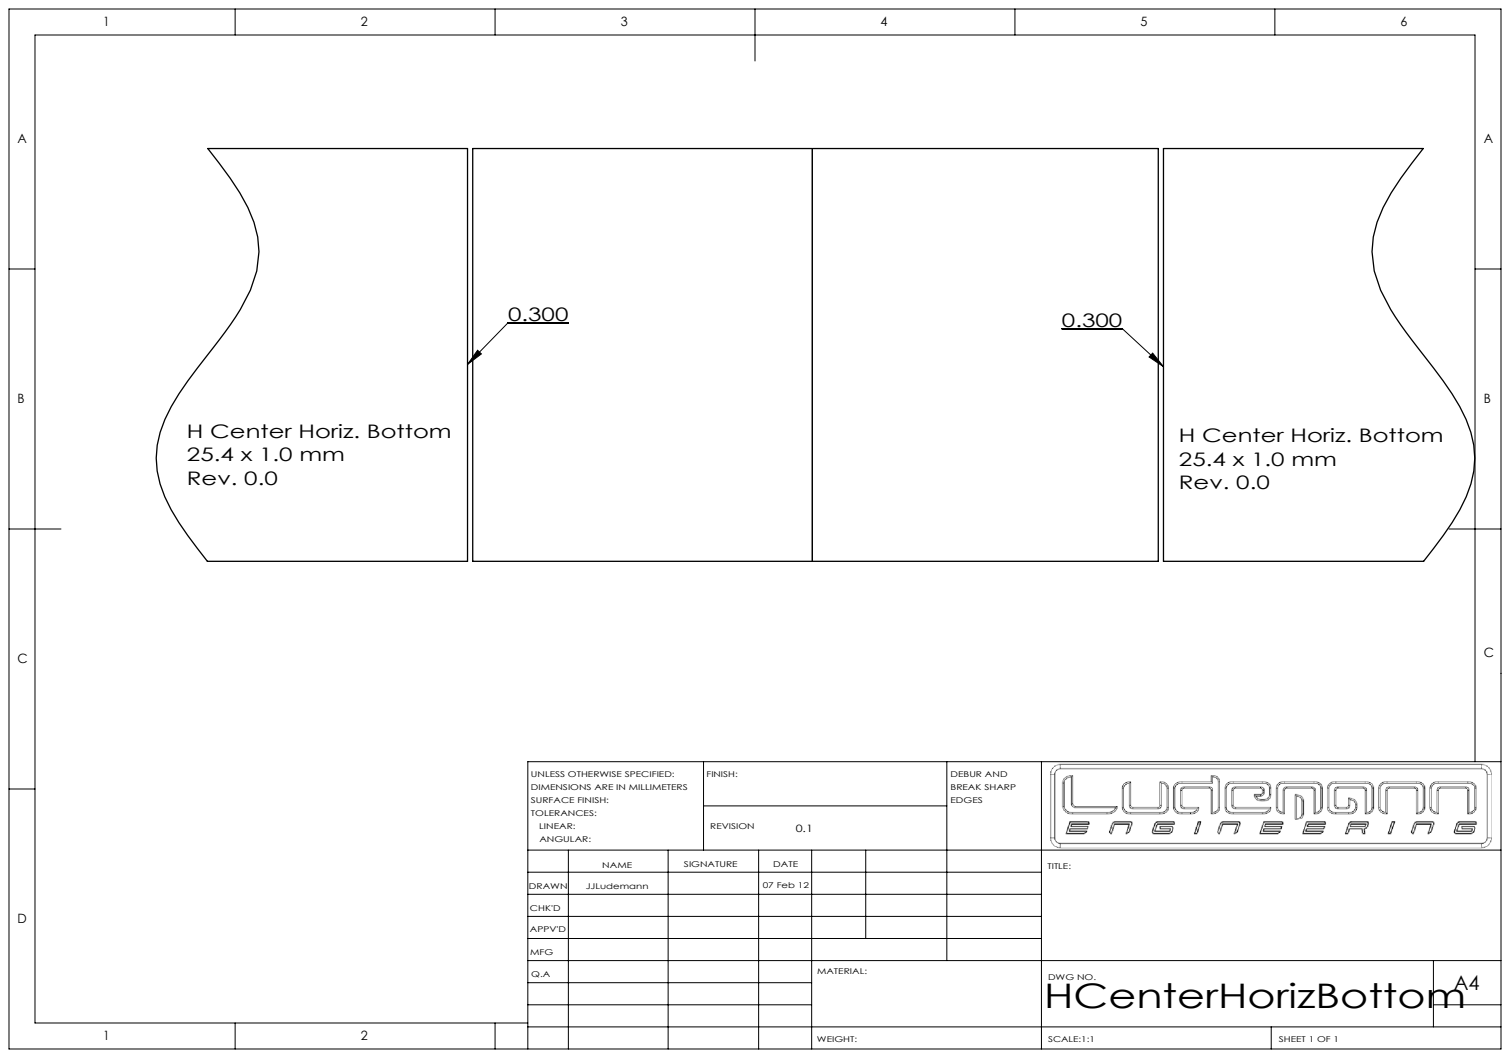
[picture p210: page 1]
FINISH:; DEBUR AND; BREAK SHARP; SCALE:1:1; SHEET 1 OF 1

H Center Horiz. Bottom
Rev. 0.0

UNLESS OTHERWISE SPECIFIED:
DIMENSIONS ARE IN MILLIMETERS
SURFACE FINISH:
TOLERANCES:
LINEAR:
ANGULAR:

NAME | SIGNATURE | DATE | | | | TITLE:

DRAWN | JJLudemann | | 07 Feb 12

CHK'D

APPV'D

MFG
Q.A | | | | MATERIAL: | HCenterHorizBottom DWG NO. | A4
