LudemannEngineering/Formula-1000-Race-Car/Solidworks/Chassis/Tubes/PDFs/HLeftVertLower.PDF

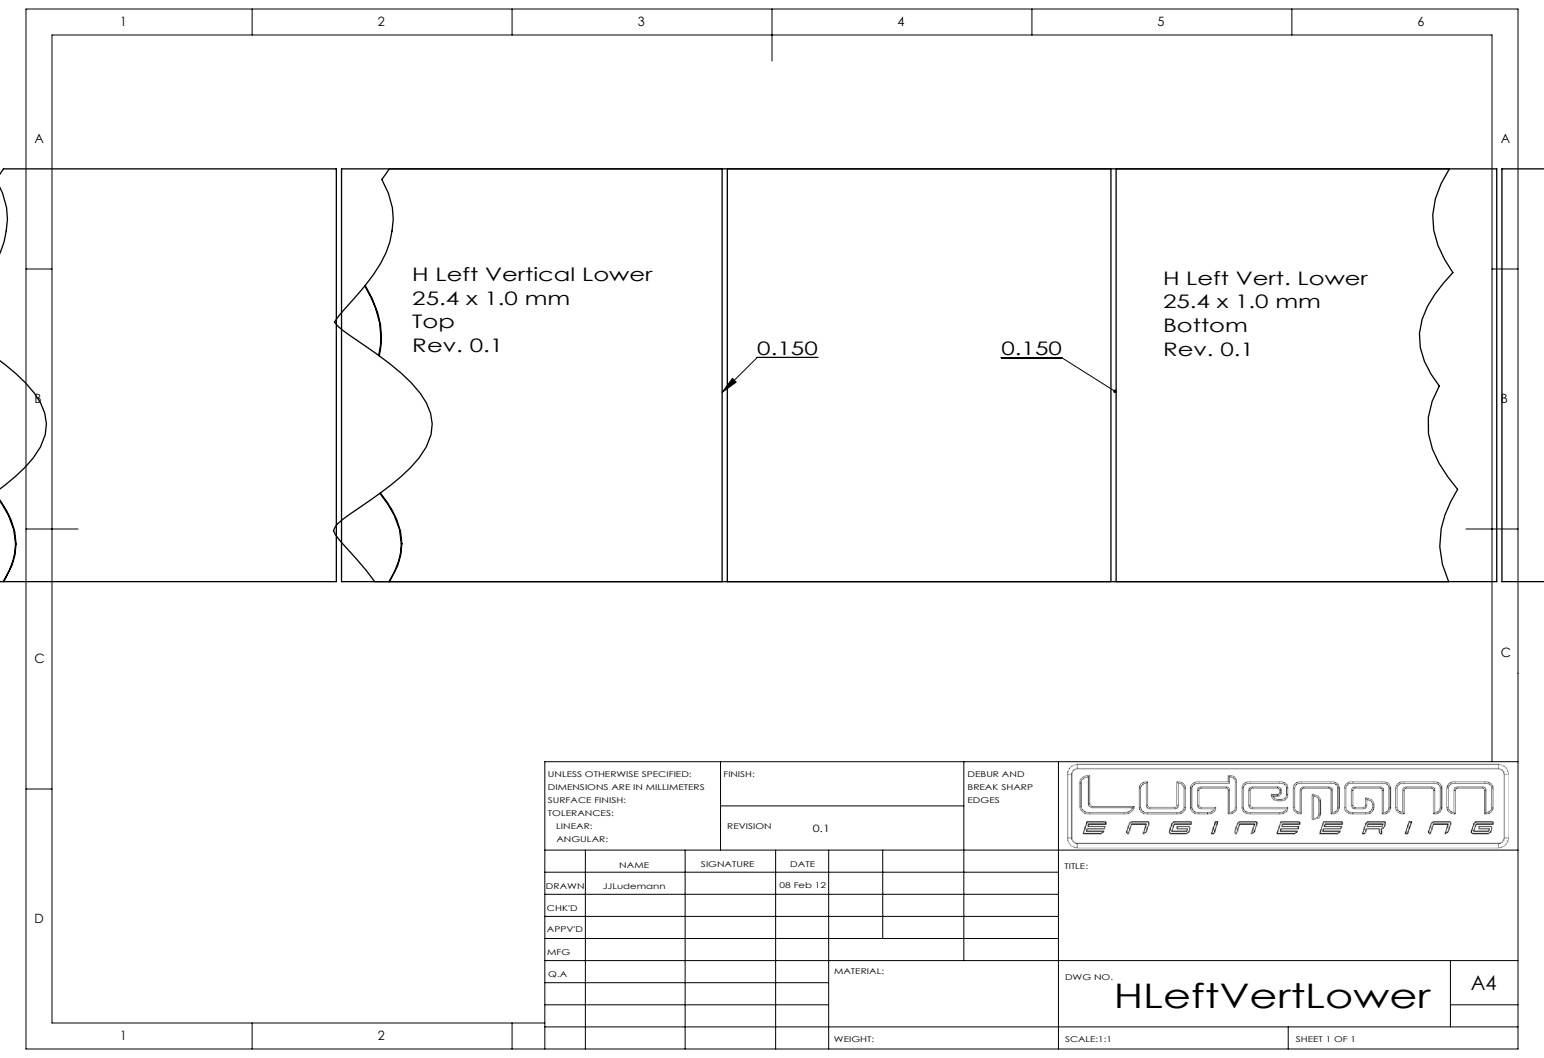
[picture p211: page 1]
FINISH:; DEBUR AND; BREAK SHARP; SCALE:1:1; SHEET 1 OF 1

H Left Vertical Lower
Top
Rev. 0.1

H Left Vert. Lower
Bottom

UNLESS OTHERWISE SPECIFIED:
DIMENSIONS ARE IN MILLIMETERS
SURFACE FINISH:
TOLERANCES:
LINEAR:
ANGULAR:

NAME | SIGNATURE | DATE | | | | TITLE:

DRAWN | JJLudemann | | 08 Feb 12

CHK'D

APPV'D

MFG
Q.A | | | | MATERIAL: | DWG NO. HLeftVertLower | A4
