LudemannEngineering/Formula-1000-Race-Car/Solidworks/Chassis/Tubes/PDFs/I-KCenterHorizBottom.PDF

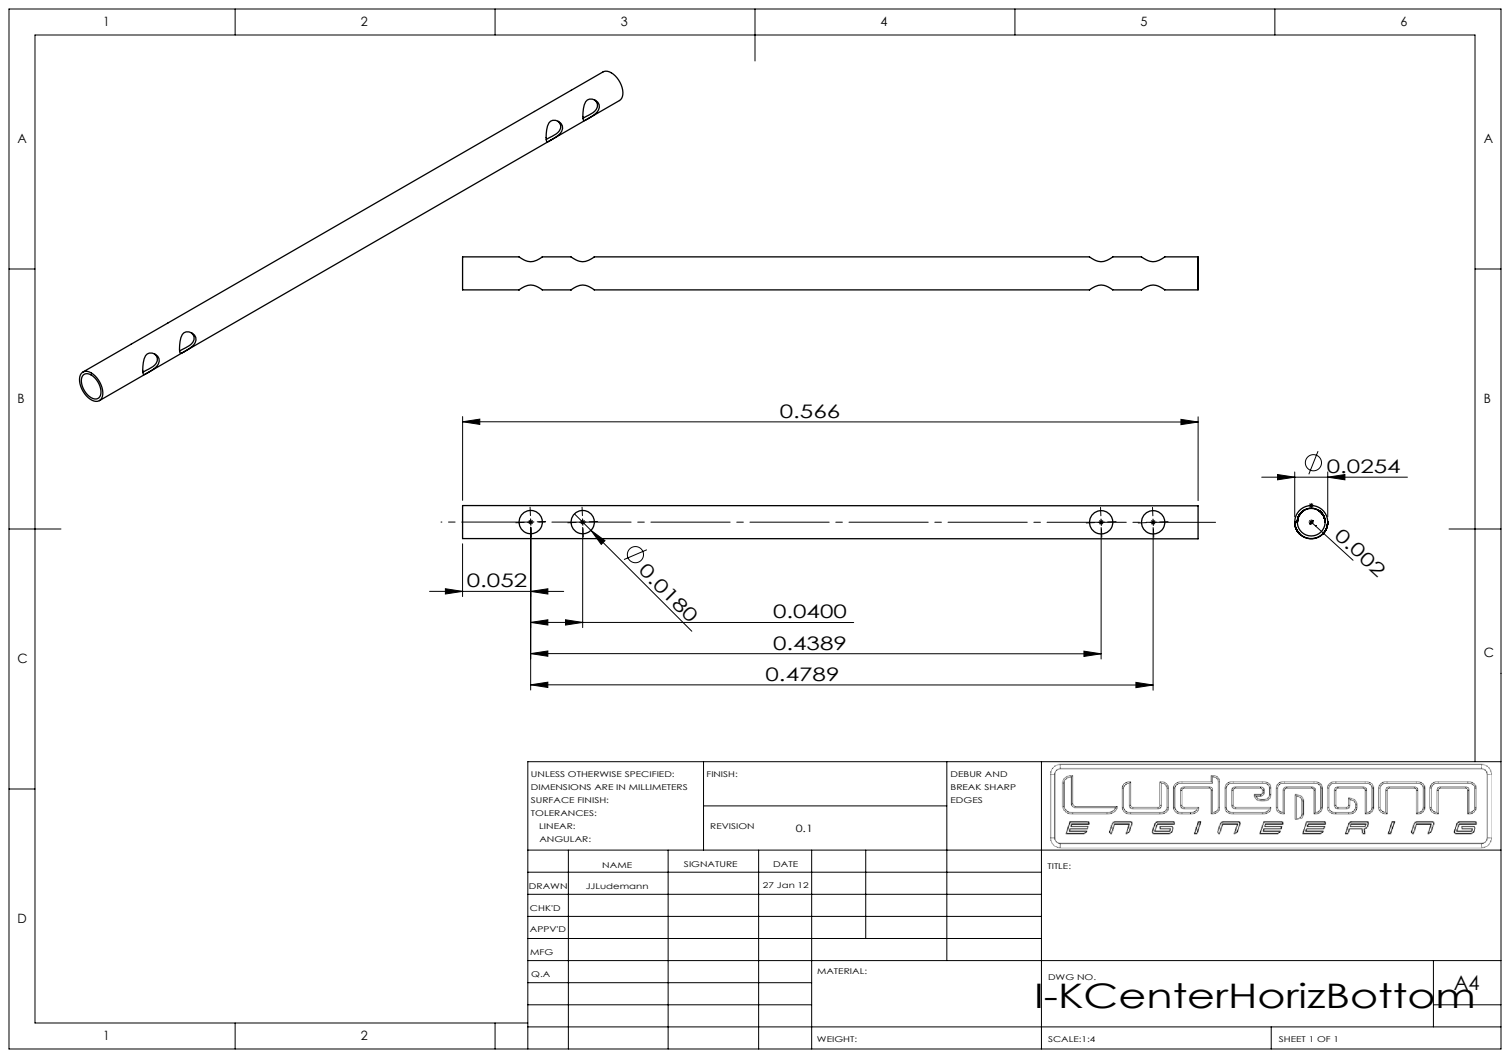
[picture p213: page 1]
FINISH:; DEBUR AND; BREAK SHARP; SCALE:1:4; SHEET 1 OF 1

UNLESS OTHERWISE SPECIFIED:
DIMENSIONS ARE IN MILLIMETERS
SURFACE FINISH:
TOLERANCES:
LINEAR:
ANGULAR:

NAME | SIGNATURE | DATE | | | | TITLE:

DRAWN | JJLudemann | | 27 Jan 12

CHK'D

APPV'D

MFG
Q.A | | | | MATERIAL: I-KCenterHorizBottom | DWG NO. | A4
