LudemannEngineering/Formula-1000-Race-Car/(commit log)

2019-01-21 Added PDF drawing files
    [01-501-0003.SLDDRW, ChassisJig.SLDDRW, ChassisJig.xlsx, JigsTopRail.SLDDRW, MainJig.SLDDRW, Rulers.SLDPRT]
2019-01-21 Added PDF, SLDDRW, SLDPRT files for frame tubes only
    [A-CDiag.SLDDRW, A-CLDiag.SLDPRT, A-CRDiag.SLDPRT, ACH1.SLDDRW, ACH1.SLDPRT, ACH2.SLDDRW, ACH2.SLDPRT, ALV.SLDDRW]
2019-01-21 Initial README, Part # Sys, Top-level PDF
    [[PartNumberSystem].xlsx]
2019-01-21 Initial SLDPRT, SLDASM, SLDDRW files
    Complete design in Solidworks format
    [01-100-0001.SLDDRW, 01-100-0006.SLDDRW, 01-101-0002.SLDDRW, 01-101-0003.SLDDRW, 01-101-0004.SLDDRW, 01-101-0005.SLDDRW, 01-101-0006.SLDDRW, 01-101-0007.SLDDRW]
2019-01-22 Cleaned up Chassis4WheelsD.SLDASM
    [01-520-0001.1.sldprt, 01-520-0001.9.sldprt, BiasAdjusterClevis.SLDPRT, BiasAdjusterClevisBlock.SLDPRT, BiasAdjusterPin.SLDPRT, BiasAdjusterShaft.SLDPRT, BracketPedalMountBushing.SLDPRT, BrakeBalanceBar.SLDASM]
2019-01-26 Covert to STEP format, clean up Solidworks assys.
    [01-520-0001.1.sldprt, 01-520-0001.2.sldprt, 01-520-0001.3.sldprt, 01-520-0001.4.sldprt, 01-520-0001.5.sldprt, 01-520-0001.6.sldprt, 01-520-0001.7.sldprt, 01-520-0001.8.sldprt]
